Amazo123/CryNet-TwoNode/SYSTEM_UPDATE.md

# CryNet — SYSTEM_UPDATE.md (living status log)

> **This file is the recovery layer.** It is rewritten/appended by the agent **after every project update or edit** (code, notebook, config, decision, or a completed run). If the chat dies, is compacted into garbage, or hits "400 Context Limit Exceeded", a fresh chat reads this file first and is immediately back up to speed.
>
> **Repo:** `C:\Users\HP\.t3\projects\fp-two-node` (branch `main`, remote `origin` →
> `https://github.com/Amazo123/CryNet-TwoNode.git`) — the **two-cot** system.
> **Sibling repository:** `C:\Users\HP\.t3\projects\fp-2` (branch `main`, remote
> `crynet` → `https://github.com/Amazo123/CryNet.git`) — the **three-cot** system.
> Shared history up to `99bb257`, then separate. **The system on the bench is
> this one.**
> **Deep briefing (static, rarely changes):** `PROJECT_HANDOFF.md`
> **Decision and issue log (for the report):** `DECISIONS.md`
> **Last updated:** 2026-11-07 (**the D-83 firmware was flashed onto all four units and verified live** — the hub, both cot nodes and the wearable now run the firmware with no battery sense and no status LEDs; the hub's boot self-check passed, the panel is up, both cots are online and the wearable is connected over BLE. **Both nodes read exact digital zero, and that is correct: the owner confirmed only the boards were connected, with no INMP441 attached at all.** D-83, D-79/O-1c.) **The battery SOC and every status LED were removed from the system — D-83.** The owner took the battery readout out altogether, along with the node's connection LED, the node's SOC LED, the hub's BLE-status LED and the hub's SOC LED, because the hub's display already shows the connection. The firmware, the wiring documents, the bill of materials and the diagrams were all changed to match; the battery *power* — cells, modules, switches, charge currents — is untouched. **Nothing has been flashed yet**: the firmware is built and compile-verified, and the units are waiting on USB. D-81 is marked superseded in part, O-1e is closed, O-1a drops the wearable SOC readout)

---

## 0. Protocol the agent follows (non-negotiable)

1. **Update this file after every edit.** Every change to the repo, every decision, every completed run gets an entry in §5 *Change log* (newest first) and, if it moves the needle, a refresh of §3 *Live status*.
2. **Keep chat context small.** Never paste large files/diffs/logs into chat. Write them to disk (e.g. `research/*.log`) and reference the path. Prefer background runs with a persistent log over long foreground commands. If context is getting long, say so and ask the user to run `/compact` — the agent then reloads state from this file.
3. **One artifact per checkpoint.** Confirm before starting the next stage.
4. **Minimal agent fan-out.** Use direct tool calls (WebSearch/WebFetch/curl/python) over subagents. At most 1–2 subagents when genuinely needed. A previous 18-agent fan-out exhausted the usage quota and several sessions died with 400 errors.
5. **Never hand-edit `notebooks/crynet_training.ipynb`.** Edit `research/build_notebook.py`, then regenerate with `python build_notebook.py`.
6. **Long runs go to the background** with output to `research/<name>.log`, so a session break never loses the work.

### Recovery procedure (for a fresh chat or lost context)

1. Read this file (top to bottom).
2. Read `PROJECT_HANDOFF.md` for the frozen contracts (signal contract, dataset decisions, file map).
3. `git status` + `git log --oneline -5` to see what is committed vs. uncommitted.
4. Continue from **§4 Next action**.

### 0.1 Live background work (as of 2026-10-31, afternoon)

| What | Where | How to check |
|---|---|---|
| **A local stub run of the patched training notebook** (FAST mode, the stub cache) — it validates the new music corpus end to end. | `research/stub_music_run.log` | `tail -30 research/stub_music_run.log` |
| **The GTZAN music corpus downloading** from Kaggle (`carlthome/gtzan-genre-collection`, ~1.2 GB). | `research/_cache/gtzan__carlthome_gtzan-genre-collection.zip` | `ls -la research/_cache/gtzan__*` |
| **A hub firmware build** with the display fix (the loudest crying cot). | `research/toolchain/pio_build_music.log` | `tail -5 research/toolchain/pio_build_music.log` |
| The ESP32-S3 firmware **compiles, flashes and passes its on-device verification** — see §3. | — | `tail -60 research/toolchain/pio_build.log` for the last build |
| Rebuild from scratch | `cd firmware/hub_infer && python -m platformio run` | ~8 min from clean; ~1 min incrementally |
| Flash + read the log | `python firmware/tools/flash_hub.py` | finds the board, writes it, prints the report |
| Re-fetch the vendored deps | `bash firmware/tools/fetch_deps.sh` | clones the pinned commits and re-applies `patch_deps.py` |
| Install the node sketches into the Arduino IDE | `python firmware/tools/install_sketches.py` | copies `firmware/node/*` into `~/Documents/Arduino` |
| Build a node sketch without the IDE | `arduino-cli compile --fqbn esp32:esp32:weact_studio_esp32c3 firmware/node/node_crynet` | `arduino-cli.exe` ships inside the Arduino IDE |
| Build and flash a node in one step | `python firmware/tools/flash_node.py --port COM38` | finds `arduino-cli` inside the Arduino IDE, builds the node sketch and uploads it; falls back to the sketchbook copy when the machine has no checkout |
| Ports | the hub on **COM32** (CH343), the node on **COM30** (`303a:1001`, the C3's own USB) | `python firmware/tools/collect_clips.py --list` |

**A background build survives `/compact` and even a lost session** — it writes to the log file on disk, not to the chat. Compaction only rewrites conversation history.

**What is NOT yet done — do not claim otherwise:**
- Stage 2a is complete *for the inference core*: the front end and the model are verified against the host reference on real hardware.
- Stage 2b is **done and verified on the board**: the rewired INMP441 produces real audio (room RMS 6–11 milli, 9,237 distinct values), the node streams telemetry and uploads bursts, and both sketches discard the INMP441's power-on burst.
- **Stage 2c's radio is DONE and verified end to end on the real boards** (2026-10-30, late): the hub pulls a 2 s window over ESP-NOW and the CRC-32 it computes over the reassembled audio **matches the CRC-32 the node froze** (`286/286 fragments in 1.15 s`, `0x23C2EE17 -> MATCH`, then inference on the reassembled window). Getting there required four real fixes — a closed serial port starved the node's loop (USB-CDC blocks ~2 s per print; cure `Serial.setTxTimeoutMs(0)`), a memset in `handle_telemetry` wiped every slot's pre-allocated window buffer (no burst ever reassembled), the hub's probe flood (50 ms) kept resetting the node's window, and `esp_now_add_peer` ran from the node's WiFi-task callback. Unicast was tried and rolled back — broadcast at 10 Hz is reliable. **The TFT display and the BLE GATT server are now written and running on the hub together (2026-10-31): the panel comes up (320×240), the radio hears the node, and a BLE client connects and subscribes while the radio keeps counting frames with 0 bad frames — the conflict that stopped both was the hub's own 154 KB of boot-only static buffers, now in PSRAM (RAM 59.9 % → 12.9 %).** *Caveat added later the same day: "the panel comes up" only ever meant the driver returned success — the panel was in fact showing noise, because of three bugs in the display driver (little-endian address window, `CASET` sent twice, CS released between a command and its parameters). All three are fixed and reflashed; what the panel actually shows still needs one photograph.*
- The inference is 101.8 ms per window. That is 5 % of the 2 s window and fine for a triggered monitor, but the tensor arena is still in PSRAM; moving it into internal SRAM is the obvious next optimisation.
- **The chain works end to end (2026-10-31, late).** The hub pulls the node's two-second window over ESP-NOW (286/286 fragments, CRC-32 MATCH), runs the front end and the INT8 model on it, and announces the cry — the panel, the radio and the BLE server all run together on the hub, and a real phone received `ALERT {'cot': 1, 'alert': 'cry', 'confidence_pct': 100}`. The last blocker was the hub's own Bluetooth advertising deafening the Wi-Fi receiver; the fix is a per-fragment resend (`RESEND` frame, type 5) plus three supporting changes. See `DECISIONS.md` section 2.5.
- **In-domain audio exists** — four sessions were recorded with the real INMP441 (`research/in_domain/session1..4`): a quiet-room baseline, a phone-speaker cry session, a smoke test and a rescued partial. **And now the full confusion session (2026-11-01, D-60): nine more takes (`session5..10`, with `6b`, `7b` and `8b` for the close-and-loud versions) measured in this room — 0 false alarms in 308 non-cry windows, 86.4 % recall on a cry at 15 cm; the report is `research/in_domain/SESSION_REPORT.md`.** The deployed INT8 model scores **0 false alarms in 236 quiet-room windows** on the baseline, and AUC 0.9283 / recall 0.724 / FPR 0.000 on the phone-cry session.
- **The false-alarm map exists (2026-10-31, new).** `research/eval_esc50.py` ran the *deployed* INT8 model over ESC-50's 2,000 real-world clips: **36 of the 40 real `crying_baby` clips alarm (90 %)**, and **38 of the 1,439 loud non-cry clips do too (2.64 %)**. Worst groups: urban 4.3 % (`car_horn` 6 of 38 reached, `hand_saw` 4 of 37, `church_bells`), animal 3.7 % (`crow` 4 of 32, `sheep`, `frog`), domestic and human non-speech 1.6 %, nature 0.8 %. Report: `research/out/eval_esc50.json`.
- **There is no music anywhere in the training corpus.** ICD, ESC-50, the 4-class cry set and the snoring set hold no music at all — and ESC-50, the corpus the map above uses, contains **no music and no speech** either (it is environmental sound plus human non-speech vocalisations). So "the model tells a cry from music" was **untrained and unmeasured**. Speech *is* in the training set (VoxCeleb, 4,963 clips); music is not.
- **Music was measured, and the model as deployed then failed it — the retrain fixed it (2026-11-01, D-58).** `research/eval_music.py` had run the deployed INT8 model over GTZAN's 1,000 real music clips (ten genres): **79 of the 965 clips that reach the model alarm — 8.19 %**, three times the rate for any other kind of sound. Worst: jazz 14.3 %, blues 13.0 %, pop 12.0 %, disco 10.0 %, rock 10.0 %; best: reggae 2.0 %, classical 2.9 %, country 3.0 %, metal 4.0 %. The cause is plain once seen — a cry is a voiced, harmonic-rich sound and a saxophone or a sung vowel looks like one in the log-Mel domain. **A threshold change cannot fix it:** the INT8 output saturates at P(cry) = 0.9961, so 45 of those 81 music alarms and 34 of the 36 true cry detections carry exactly the same value. The fix is a training round, and the corpus is now in the notebook.

**Next concrete steps:**
1. **DONE (2026-11-01, evening): the Kaggle re-run happened and the retrained model is deployed and verified on the board.** The user ran the notebook, `crynet_out.zip` came back, and the retrained model was measured, deployed, and verified 4/4 on-device (D-58). **Music false alarms are now 0.21 % (2/965), down from 8.19 %**; ESC-50 non-cry alarms halved (2.64 % → 1.18 %); ESC-50 crying-baby recall is unchanged (36/40); the quiet room is still silent (0/236). The known cost: per-window recall on the phone-speaker cry sessions dropped (session 1: 0.867 → 0.800; session 4: 0.724 → 0.592) — a sustained cry still trips many windows in a row, so episodes are still caught. What is *not* yet re-measured is O-9, the in-room confusion session.
2. **Look at the TFT panel - it is wired, flashed, and the text now renders as letters.** The panel is on CS 10, MOSI 11, SCK 12, DC 13, RST 14, backlight 4, 3V3, GND; SPI2 at 40 MHz. The first flash came up as **static noise** (three bugs in my driver: little-endian address window, `CASET` sent twice, CS released between a command and its parameters), the second came up **a quarter turn out** (this panel is landscape-first and wants `MADCTL_MY`, not `MADCTL_MV` - the legacy firmware's setting), the third had the **new UI** but drew **hearts and diamonds instead of letters** (the font generator was reading the table 32 characters out of place), the fourth added the **caregiver's device on the panel** (`PHONE` pill, and `ALERT NOT DELIVERED` under a confirmed cry when nobody is attached), and the **fifth - the first photograph of the real glass - confirmed the layout, the text and the orientation are all correct**: `CRYNET`, `S3 HUB`, `RADIO`, `PHONE`, `LISTENING`, `COT 1 / ONLINE`, `COT 2` and `COT 3 / NO SIGNAL`, `3 cots linked`, `up 0:39`. **The same photograph exposed a colour fault: every colour had red and blue exchanged** (the teal accent came out olive, the amber `PHONE` pill came out blue) because the driver set the panel's `MADCTL_BGR` bit while the framebuffer packs standard RGB565. That is fixed, flashed and logged (`madctl 0x80`). **The second photograph confirmed the fix**: the `PHONE` square is now warm orange, the accent underline is teal-green, the `RADIO` square is cyan-green - the same elements the previous photograph showed as blue, pink and olive. **What it also showed is a glare**: the panel is brighter than the room, so the camera clipped it and the white balance drifted, and the whole screen read as saturated blue. The panel's side of that is now fixed - **the backlight is a LEDC PWM output at 55 % by default** (`hub_display_set_brightness()`), and the **BOOT button opens a colour check**: a grid of the palette's swatches, which is how the panel's own colours can be judged without a camera in the loop. **The colour check then proved the hues are right and found the real fault**: `BLACK` came back black, `WHITE` white, `TEAL` teal, `GREEN` green, `AMBER` amber, `ROSE` rose - but the old navy background came back as a **saturated blue**, because this panel **lifts the dark end, and the blue channel hardest** (the amber's requested blue of 36 measured back at 145). **The neutrals then moved one step darker again - on the user's own pick**: shown the ramp, they chose its **third step, `(4,8,8)`, as the teal the screen should be**, and the whole neutral family moved down one step of the same ramp with it (background `(4,8,8)`, surfaces `(7,15,16)` and `(12,26,28)`; border and dim text kept, every contrast re-checked). **The same round fixed the rounded corners**: every corner had been drawing its arc on the *inside* of the shape - only the bottom-right one looked right - because the corner loop walked its offsets inward from each disc's centre; each disc is now walked *towards its own corner*, and a host-side regression check (`research/check_corners.py`) requires the four corners to be exact mirror images of each other. **The repo is now pushed to GitHub after every change** (remote `crynet`; eight commits had piled up locally before the first push). **The panel then had its second look from the chair (D-59):** the background dropped another step of the same ramp — `(4,8,8)` → `(2,4,4)` — because the cards still read as the same colour as the ground on the glass; the header strip got its own colour `(7,20,15)`, green pushed five steps above blue, because the backlight's LEDs run along the top of the glass and lift that strip blue (a header painted the same colour as the cards photographed blue while the cards photographed teal); and the online/offline treatments were swapped as the user asked — a live cot now carries the **full-strength vibrant teal outline** (rose when crying) while a no-signal card recedes, its outline and empty bar washed towards the background, the reverse of the 45 % blend the live cards had before. **One more pass from the chair (D-59, amended):** the *fills* are swapped - a live card wears the border-washed fill the offline card had (the denser, more active one) and an offline card the faint accent wash, outlines unchanged - and the dead card's word became **OFFLINE**. **What is still wanted is one photograph of the colour check with the room lit**, so the ramp yields the panel's own tone curve: in the dark the camera's veil is stronger than the steps it is supposed to measure (the fourth photograph proved that too - its red channel jumps the wrong way between adjacent ramp steps).
3. **DONE (2026-11-01, later at night): the burst is 2.06 s and the panel shows a cry about two and a half seconds after it happened.** The cause was the hub's own BLE advertising deafening the Wi-Fi receiver (NimBLE's default interval is 30-60 ms on all three channels, ~100 transmissions a second). Three changes: the Bluetooth stack advertises only when it must (never with a phone connected, never while a burst is in the air), at 100 ms instead of 30-60 ms when it must; and the node paces its fragments every 4 ms instead of every 10 ms. **Measured: 5.54-6.93 s before, 2.06-2.11 s after, 286/286 fragments every time, with no resend rounds.** The request-to-verdict latency is 2.23-3.57 s (D-61).
4. **DONE (2026-11-01, night): the confusion session is recorded — O-9 is closed.** Nine one-minute takes with `node_capture` on the real INMP441 (the procedure is in `research/CONFUSION_SESSION.md`; the result is in `research/in_domain/SESSION_REPORT.md`). **0 false alarms in 308 windows of non-cry audio** (speech, music and film — including a loud film and loud music where the trigger fired on 46 % and 84 % of the records, so the model was asked 44 times in each and refused every time), and **86.4 % per-window recall on the phone-played cry at 15 cm** (the realistic case: the mic is in the cot). The one finding that changes the design: **the cry at one metre never crosses the 0.030 trigger** (median RMS 0.0070, 0/590 records), so the system's reach is limited by `CRYNET_TRIGGER_RMS` and the microphone's fixed sensitivity, not by the classifier. The clips are now the hard negatives for the next training round.
5. **DONE (2026-11-01, last thing tonight): the demo's sound path is verified on the live hub.** The user played the cry from a phone 10-15 cm from the node's mic while the hub's log was read live: **42 verdicts, 26 "ALERT — cry" at P(cry) 0.9922-0.9961, 16 "no cry" at P(cry) 0.0078-0.2148**, nothing near the 0.95 threshold, and the link never dropped a fragment (45 bursts, 45/45 complete, no stall, timeout, CRC error or resend round). Request-to-verdict 2.23-5.35 s (mean 4.03 s). The burst's length is now a range (2.06-5.19 s, median 3.55 s) because the per-fragment cost is the *channel's* contention on the shared channel 6, not the pacing. **The demo must use the phone** — the laptop's speakers are not detected (D-61). Details: D-62.
6. **DONE (2026-11-01, late): the adaptive trigger is built on both boards and it works — and it exposed a fault in the model's judgement of near-silent windows, which the announcement rule now fixes.** The multiple was chosen from the recorded sessions, not by taste (`research/adaptive_trigger_study.py`): at **three times the node's own noise floor** the cry a metre away goes from 0 trigger events a minute to 39, the quiet room gives 5, and the loud sessions are capped by the old fixed 0.030 — so the rule is never worse than before. **The node owns the floor and the level** (it freezes the window, so its level is the one that matters); the level travels in the telemetry (payload 7, milli-RMS) beside the frozen window's own level and the floor, and the hub triggers on the number the node reports, falling back to `CRYNET_TRIGGER_RMS` for an older node. The floor falls at once when the room gets quieter and rises with a 50 s time constant, so a long cry cannot drag the floor up to its own level and switch the trigger off in the middle of an episode. **Measured on the boards:** the level tracks the room (0.006–0.016 in a noisy room), the node's own log shows it settling (`rms 0.0063 floor 0.0028 level 0.0083`), and the hub now asks 5–11 times a minute instead of 1–2. **But a lower trigger asks the model about near-silent windows, and the model is not a reliable judge of those:** the same quiet room produced verdicts of 0.0000 and of 0.9766 for windows that differ by nothing a person could hear, and the second of those was a false alarm. **So the announcement rule changed (D-64):** one window announces a cry only when it is unmistakable — P(cry) ≥ 0.99, where the model's output saturates at 0.9961 for a clear cry, so the panel still shows the cry two and a half seconds after it happened — and anything between 0.95 and 0.99 is a *maybe* that has to be confirmed by the next window. A cry lasts for seconds and its windows agree; a noise fluctuation that happens to look like a cry is not repeated. **And the node's transmitter was turned down to 8.5 dBm (D-65):** the radio sits centimetres from the microphone and was putting its own noise into the audio it was about to be judged on. Five minutes of a noisy room afterwards: 32 verdicts, **0 false alerts**.
7. **NEXT: the user's verification session, all of it in one go.** The cry from the phone at **15 cm** (the demo case — it must announce at once, at the old two-and-a-half-second speed) and at **one metre** (the case the adaptive trigger was built for — it must now reach the model at all), with the **node's own serial log captured alongside the hub's** so the floor, the level and every frozen window's own level are on the record. The tool that made this possible is new: `firmware/tools/dump_node_window.py` writes the node's frozen window out over its USB console, and `research/analyze_window.py` says what is in a window and what the model makes of it.
8. **Two nodes in one room.** The per-node path already exists — per-node inference, a per-node BLE alert and a `crying_mask` in the state characteristic — and the panel now names the **loudest** crying cot, but it has never been run with two nodes, and the demo has to show *which* cot the cry came from.
9. Then Stage 2d (the wearable).

**Tools built so far (all runnable on the host):**
- `firmware/tools/check_artifact_drift.py` — verifies `research/out/` against `deploy_config.json` and the staged firmware copies. Currently **PASS**.
- `firmware/tools/gen_probe_refs.py` — regenerates `crynet_probe_refs.h` (expected on-device features) from the notebook's own front end.

---

## 1. Project in one paragraph

Multi-node infant cry monitor. 3× ESP32-C3 cot nodes (INMP441, I2S 16 kHz) → ESP-NOW → **ESP32-S3-DevKitC-1 hub** (TFLite Micro INT8 inference, ILI9341 TFT, BLE GATT) → wearable (ESP32-C3 + OLED + DRV2605L haptic). Model is a **binary cry / no-cry** classifier on 2 s log-Mel windows. Previous firmware attempt failed after flashing, so the project was rebuilt from model training.

---

## 2. Frozen decisions (do not re-litigate)

| # | Decision |
|---|---|
| 1 | Binary cry / no-cry head (BLE packet `alert_type 0x01` only supports binary). |
| 2 | Label policy = "any cry present" in the 2 s window (≈ ≥ 3 active frames). |
| 3 | Training runs on Kaggle GPU (user executes); notebook validated locally first by the agent. |
| 4 | Signal contract (below) is frozen — firmware, C code and weights all depend on it. |
| 5 | Trigger threshold must drop from RMS ≥ 0.18 → ~0.03 in the hub (old value was a real bug: soft cries never reached a classifier). |

**Signal contract (frozen):**
`int16 pcm[32000] (2.0 s @ 16 kHz mono)` → `/32768` → subtract mean → zero-pad 256 front / 512 rear → 81 frames, 512-pt symmetric Hann, hop 400 → `|rfft|²` (257 bins) → 64 Mel bands (librosa slaney, 20 Hz–8 kHz, 497 non-zero weights) → `10*log10(max(P,1e-10))` floored at −80 dB → per-window standardisation (CMVN) → int8 quantise → TFLM → `[P(no_cry), P(cry)]`.

| Constant | Value | Constant | Value |
|---|---|---|---|
| 2026-11-01 (night, final) | **The shipped firmware verified on a one-minute play: 7 live ALERTs, every one P(cry)=0.9961, first ~8 s after the first cry-level freeze; 26/26 bursts complete; zero false detections before, during, or after.** Windows straddling the recording's pauses scored 0.80-0.94 and were refused cleanly; two impulsive non-cry ticks (crest 10-18) were refused by the model itself (P=0.03-0.09). The momentum fix (D-74) passed its first live test - the post-play quiet windows never announced. This closes the demo verification: play at panel level ~0.10-0.20, alerts at saturation, silent otherwise. | (no code changes - verification only) | *Logs: %TEMP%/hub_v13.log, node_v13.log.* |
| 2026-11-01 (night, latest) | **The volume-down play verified the whole chain: five for five cry windows announced at 0.9922-0.9961 with no clipping (peaks 57-69 % of full scale), and the quiet watch held zero live ALERTs while refusing 31+ flukes - including two full saturations (0.9961 at crest 2.7 and 2.8) that the crest gate stopped. One residual defect found and fixed (D-74):** 12 s after the cry ended, a quiet hiss window (rms 0.0096, crest 2.5, P=0.9883) announced on the confirming run's momentum - the cry's own loud windows had advanced the run to 2, and quiet windows that score >= 0.95 keep it alive without resetting it. The run now confirms only windows with real energy (rms >= 0.020): quiet windows keep the run alive but cannot announce. Flashed; final quiet check running. | `firmware/hub_infer/src/link_stage.c` | *Session verdicts: quiet watch ~7 min, 0 live ALERTs; the play: first cry window (seq 183, loud onset) scored 0.9688 (a maybe - unconfirmed), every subsequent cry window 0.9922-0.9961 (ALERT), post-play flukes all refused.* |
| 2026-11-01 (night, later) | **Four more quiet-room false alarms in nine minutes; the model saturates on pure mic self-noise; the crest gate closes it (D-73).** The quiet-watch session after D-72 caught the flukes live: rms 0.0067-0.0088, peaks 621-789 (crest 2.3-2.9 - flat Gaussian hiss), scoring P(cry)=0.9922-0.9961 - the same value as a real cry - roughly every two minutes. No confidence threshold can fix this (saturation is saturation); the discriminator is the **crest factor**: every falsely-high quiet window ever measured has crest 2.2-2.9, the quietest genuine cry (one metre, P=0.9961) has 5.6. `CRYNET_QUIET_CREST 3.5`: a quiet saturated window announces only with a cry's impulsive shape; loud windows (>= 0.020 rms) announce on saturation alone (clipping flattens the crest on loud cries, 1.9-3.9, so the shape test must not apply there). Flash verified: boot self-check PASS. **Verification in progress** - six quiet minutes expected to produce zero ALERTs (the room flukes ~every 2 min, now refused), then the volume-down play (panel 0.10-0.20). | `firmware/hub_infer/src/{link_stage.c,link_stage.h}` | *The build also prints crest on every window line, so future sessions measure it directly.* |
| 2026-11-01 (night) | **Fourteen quiet-room false alarms, found and closed (D-72).** The user saw ~14 "cry detected" flashes at 95-98 % with no cry playing (panel levels 0.002-0.012). Mechanism: in a quiet room the adaptive trigger pins at its minimum (0.005), the hub judges near-silent windows continuously, the model's verdict on those is documented noise, and two consecutive scattered maybes (0.95-0.98) confirmed each other under the run-of-two rule - the rule's "a noise fluctuation is not repeated" assumption fails when the room repeats the fluctuation every few seconds. **Fix (hub only):** `CRYNET_ANNOUNCE_MIN_RMS 0.006` (no window under 0.006 rms announces at all, even at >= 0.99; the one-metre cry at 0.0103 stays above it) and `CRYNET_MAYBE_MIN_RMS 0.020` (a maybe counts toward the confirming run only with real energy behind it). **Verified live:** within 90 s of flashing, the room produced `rms 0.003917  P(cry)=0.9531` - the exact failure shape - and it logged `cry (too quiet to announce)` instead of alerting. Real-cry paths unchanged: saturated verdicts announce alone at >= 0.006 rms; the demo-volume re-test (phone quieter, panel ~0.10-0.20) is still pending. | `firmware/hub_infer/src/{link_stage.c,link_stage.h}` | *Hub re-flashed (COM32), boot self-check pass; the 90 s capture also confirmed the flood is real - the hub judged ~8 windows, all refused or refused-by-model.* |
| 2026-11-01 (later at night) | **The burst is 2.06 s instead of 5.5-6.9 s, and the panel shows a cry about two and a half seconds after it happened instead of eight.** The cause was the hub's own Bluetooth advertising: one radio carries both Bluetooth and Wi-Fi, so every advertisement is a moment when the Wi-Fi receiver cannot hear the burst's fragments - and NimBLE's default advertising interval is 30-60 ms on all three channels, about a hundred transmissions a second. **Three changes:** the Bluetooth stack now advertises only when it must (never while a caregiver's phone is connected, never while a burst is in the air - the link stage tells it, and the log shows it stopping 1 ms after the request and returning 181 ms after the burst lands); when it does advertise, it advertises at 100 ms instead of 30-60 ms; and the node paces its fragments every 4 ms instead of every 10 ms, because that ten-millisecond gap was only ever needed to survive the deafening that is now gone. **Measured on the boards** (`firmware/tools/measure_burst.py`): before 5.54 s and 6.93 s with resend rounds; after the Bluetooth policy 3.76 s and 3.81 s with no missing fragments and no resends at all; after the node's pacing **2.06 s, 2.06 s, 2.11 s**, 286/286 every time. The request-to-verdict latency is now 2.23-3.57 s (mean 2.68 s), of which 0.16 s is the model's own inference. **A finding to settle with the user:** played from the *laptop's* speakers the cry is *not* detected - P(cry) 0.38-0.95, just under the threshold, and turning the volume to 100 % made it worse while the node's RMS stayed at 0.045 - so it is the speakers' frequency response, not the level; the demo's source is the phone, and the phone path on the live hub is being checked. | `firmware/hub_infer/components/ble_alert/ble_alert.c`, `firmware/hub_infer/components/ble_alert/include/ble_alert.h`, `firmware/hub_infer/src/link_stage.c`, `firmware/node/node_crynet/node_crynet.ino`, `firmware/tools/measure_burst.py` (new), `firmware/tools/measure_latency.py` (new), `DECISIONS.md` (D-61) | The boot self-check still reads PASS (4 probes, 5184/5184 exact), a BLE client still finds the hub, connects and subscribes to both characteristics, and the burst is now bounded by the node's radio rather than by the hub's Bluetooth. || 2026-11-01 (night) | **The in-room confusion session is recorded — O-9 closed. The honest in-room number: **0 false alarms in 308 windows of non-cry audio**, and **86.4 % per-window recall on the phone-played cry at 15 cm**; the limit on how far the hub can hear is the trigger, not the model.** Nine one-minute takes with `node_capture` on the real INMP441 (quiet room; speech at desk distance and at 30 cm; music and a film at 1 m and at 30 cm; the phone-played cry at 15 cm and at 1 m). **The model raised no alarm on any non-cry window** — 308 windows of speech, music and film, 0 false alarms — and the two loud takes are the ones that count: the trigger fired on 269/590 records of the loud film and 493/590 of the loud music, so the model was asked 44 times in each and refused every time. That is the retrain (D-58) working in the room it was meant to work in: on GTZAN the music false-alarm rate was 8.19 %, and on the loudest music this room can produce it is 0/44. **The cry at 15 cm — the realistic case, the mic is in the cot — is caught in 38 of 44 windows.** **The cry at 1 m (phone at maximum volume) reaches a median RMS of 0.0070 and 0 of 590 records cross the 0.030 trigger, so it never reaches the model at all** (asked anyway, the model would have caught 18/44): the system's reach is set by software, not by the microphone: **the INMP441 has no gain setting** - its L/R pin is a left/right *channel select*, not a gain strap, and the part is fixed at -26 dBFS +/-3 dB sensitivity - so the levers are the hub's trigger threshold and a digital gain in the telemetry path, and the better version of the trigger is an *adaptive* one (a multiple of the node's own running noise floor, 0.0020 here, so 3x = 0.006 would pass the one-metre phone). Lowering the trigger to ~0.012 is the same lever from the other end and the evidence supports trying it in the next training round — it is **not** changed on 308 windows from one afternoon. The labelling tool grew a `--truth` flag, because the old auto-label called a clip 'cry' if it was *loud*, which for the music and film takes would have labelled the loudest non-cry clips as cries and measured nothing. The node was flashed back to `node_crynet` afterwards, so the live chain is running again. | `research/in_domain/session{5,6,6b,7,7b,8,8b,9,10}/` (audio, gitignored), `research/in_domain/SESSION_REPORT.md` (new), `research/out/eval_session*.json`, `firmware/tools/label_session.py` (`--truth`), `DECISIONS.md` (D-60, O-9 closed) | **The one measurement that uses this room's microphone, this room's gain and this room's acoustics.** The honest caveat is in the report: the cry is a phone speaker 15 cm from a mic in a cot, and a real baby in a real cot is a different sound. || SR | 16000 | N_FFT | 512 |
| WIN_SEC | 2.0 | HOP | 400 |
| N_SAMPLES | 32000 | N_MELS | 64 |
| N_FRAMES | 81 | FMIN/FMAX | 20 / 8000 |
| CENTER_PAD | 256 | TAIL_PAD | 512 |
| DB_FLOOR | −80 dB | LOG_EPS | 1e-10 |
| CMVN | True | SILENCE_RMS_GATE | 0.0015 |
| TARGET_RECALL | 0.95 | SEED | 1337 |

Mel weights are **exported from Python into C** (`crynet_tables.h`), so firmware cannot drift from the model.

---

## 3. Live status (as of 2026-10-29)

**Checkpoint 1 = DONE, including the full Kaggle run. Checkpoint 2 (ESP32-S3 firmware) = Stage 2a in progress.**

### Done
- Dataset forensics: every candidate corpus downloaded and profiled at audio level (SR, duration, RMS, autocorr F0, spectral centroid/flatness).
  - **Used:** ICD `hoyyu1/infant-cry-detection` (PRIMARY, 28,478 clips, all 16 kHz mono 5.00 s, 5 shipped folds), Baby Cry 4-class (cry diversity + cross-corpus test), ESC-50 (negatives + 40 held-out `crying_baby`), Snoring (hard negatives).
  - **Rejected:** `mennaahmed23/baby-cry*` family (CONTAMINATED — fake "silence" at RMS 0.22, renamed ESC-50, synthetic derivatives), `rahult25/five-class...` (pitch-shifted derivatives), ICSD (gated HF), `AxonData` (paid), Baby Chillanto (request-only), AudioSet/FSD50K (redundant), raw DonateACry (8 kHz, skewed; already merged in cry4).
- 24-cell Kaggle notebook written, generated from `research/build_notebook.py`.
- **Validated end-to-end** on synthetic stand-ins (24/24 cells) and cells 1–15 on the real 28,478-clip corpus.
- **C front end == Python front end:** max deviation **7.06 × 10⁻⁵**, mean 2.8 × 10⁻⁶, over 4 probes (sine+harmonic, noise, DC-offset cry with INMP441 bias, silence).
- **Every op has a TFLM kernel** — asserted at export: `CONV_2D, FULLY_CONNECTED, MAX_POOL_2D, MEAN, SOFTMAX`.
- **INT8 vs float32:** AUC delta **−0.00007**, 99.70 % decision agreement.
- Notebook validated with `nbformat.validate()`.

### Current numbers — **the full Kaggle run** (authoritative)

The user ran `notebooks/crynet_training.ipynb` on Kaggle (GPU T4) and the artifacts are in `research/out/`. These numbers supersede the earlier subsample figures.

| Split | AUC | F1 | Recall | Precision |
|---|---|---|---|---|
| ICD val (fold 4) | **0.9994** | 0.9905 | 0.9844 | 0.9966 |
| ICD test (fold 5) | **0.9995** | 0.9905 | — | — |
| cross-corpus (cry4 + ESC-50 + snoring, never trained on) | **0.9973** | 0.9801 | — | — |

| Variant | Params | val AUC | cross AUC |
|---|---|---|---|
| **`conv_cnn` (selected)** | 122,770 | **0.9994** | 0.9973 |
| `sep_cnn` | 29,839 | 0.9974 | 0.9928 |
| `temporal_cnn` | 65,154 | 0.9805 | 0.9714 |

- Deployed model: `crynet_int8.tflite`, **137,384 bytes**, SHA-256 `4aef55d8cfc0fb75aa944e73945ef5b832f12d71479c48f82aff58563126bc11`.
- **Calibrated alarm threshold = 0.95** (re-derived by this run; the earlier subsample's 0.23 no longer applies).
- Input quantisation: scale **0.060125612**, zero_point **−4**. Output: `[1,2]` int8, scale 0.00390625, zp −128, classes `["no_cry","cry"]`.
- Tensor arena hint **120 KB** (the firmware reserves 256 KB and places it in PSRAM).
- C front end vs Python on the real run: max deviation **6.905 × 10⁻⁵**, mean 2.79 × 10⁻⁶.
- TFLM kernel check: **ok** — ops `CONV_2D, FULLY_CONNECTED, MAX_POOL_2D, MEAN, SOFTMAX`.
- **INT8 vs float32 — CLOSED.** The full run reported both AUCs as `NaN` because the parity cell took a *prefix* of the validation fold; the ICD manifest lists every positive clip before every negative one, and the fold's positive clips alone contribute 5,330 windows — more than the 4,000-window cap — so that slice was 100 % cry and its AUC was undefined. The model was never affected (every headline metric is computed over whole splits), but the quantisation delta for these weights was never measured.
  Re-measured independently on the host by `research/verify_int8_parity.py`, which rebuilds fold 4 from the cached archives with the notebook's own front end and runs **both** the exported INT8 model and the float32 Keras model over 11,386 windows (5,693 clips, centre-cropped — independent of the notebook's random crops):

  | | INT8 (as deployed) | float32 reference |
  |---|---|---|
  | val AUC | **0.997926** | **0.999299** |
  | recall @ 0.95 | 0.9780 | 0.9782 |
  | FPR @ 0.95 | 0.0036 | 0.0036 |

  ΔAUC **−0.001373**; max |Δp| 0.182; mean |Δp| 0.0029; **decision agreement 99.956 %**. The independent float AUC (0.999299) corroborates the Kaggle figure (0.999419) from a different set of windows. Report: `research/out/verify_int8_parity.json`.
- **Notebook fixed:** the parity cell now draws a seeded random permutation subset and warns loudly if a slice is single-class. Notebook regenerated and `nbformat.validate()`-passed.

- **On-device verification — CLOSED (2026-10-30).** The Stage 2a firmware runs on the
  user's ESP32-S3-DevKitC-1 (COM32, CH343 USB-serial) and **all four probes pass**:
  the device's quantised features match the host reference exactly for silence, DC
  bias and the two-tone signal, and to within 1 LSB on 3 of 5,184 values for the
  noise probe. `RESULT: PASS — 4 probes, front end and model agree with the host`.

  | | value |
  |---|---|
  | PSRAM | 8,388,608 bytes, present |
  | flash | 16,777,216 bytes |
  | model | 137,384 bytes int8 |
  | front-end working set | 5,380 bytes, internal SRAM |
  | tensor arena | 262,144 reserved, **108,328 used** |
  | front end | **41.7 ms** per 2 s window (was 135 ms before optimisation) |
  | inference | **101.8 ms** per window (ESP-NN SIMD kernels linked in) |
  | CPU | 240 MHz, `-O2` |

  Four real bugs were found *only* by running it on the chip:
  1. **The DC-removal mean was accumulated in float32.** Summing 32,000 samples of
     18,000 in float32 gives 575,726,660 instead of 576,000,000, so the mean came
     out 8.5 counts low and 8.5 counts of DC survived. On the DC-offset probe that
     leaves a constant residual which the per-window standardisation blows up into
     a completely different feature vector — the probe failed with a max delta of
     131. The sum is now accumulated in `int32`, which holds it exactly.
  2. **The build was at `-Og`.** `build_flags = -DCOMPILER_OPTIMIZATION_PERF` is an
     *Arduino* macro that means nothing to PlatformIO's ESP-IDF builder, so
     ESP-IDF's debug default applied. The optimisation level is now set the
     ESP-IDF way, `CONFIG_COMPILER_OPTIMIZATION_PERF=y`.
  3. **The CPU ran at 160 MHz**, not 240. `CONFIG_ESP_DEFAULT_CPU_FREQ_MHZ_240=y`.
  4. **The front end kept a 128 KB padded copy of the signal in PSRAM.** PSRAM on
     the S3 is uncached external memory, and the FFT and the Mel filterbank stream
     through the working set 81 times per window. The padded copy is gone — each
     frame is now built straight from the caller's int16 PCM — and the working set
     is 5.4 KB in internal SRAM. Front end 135 ms → 41.7 ms.

  A fifth trap is not a firmware bug but a flashing one: **a combined image built
  with QIO flash mode makes the chip watchdog-reset in a loop** (`rst:0x7
  TG0WDT_SYS_RST` repeating, no application output). The ROM cannot read this
  board's flash in QIO before the bootloader has configured its own timing. The
  combined image must use **DIO**. In fact the whole build is DIO — the effective
  config is `CONFIG_ESPTOOLPY_FLASHMODE "dio"` and both `bootloader.bin` and
  `firmware.bin` carry flash-mode byte `0x02` — so the application runs in DIO as
  well, which costs nothing at this workload. See `firmware/README.md`.

- **Stage 2b — the node firmware is written and compiles (2026-10-30), but has
  not run on the board.** Two Arduino sketches for the ESP32-C3, built with the
  Arduino IDE's own `arduino-cli` against core 3.3.12, **zero warnings**:

  | Sketch | Flash | Static RAM | What it does |
  |---|---|---|---|
  | `firmware/node/node_crynet/` | 977,617 B (74 %) | 165,972 B (50 %) | the node: I2S capture, a 2 s rolling window, 100 ms RMS telemetry over ESP-NOW, the 64 KB burst in 286 CRC-framed fragments |
  | `firmware/node/node_capture/` | 311,120 B (23 %) | 18,592 B (5 %) | streams the microphone to the PC so in-domain audio can be recorded |

  The I2S setup is Espressif's own recipe for this microphone — **32-bit slots**
  (the INMP441 puts 24 bits into a 64-bit frame, so 16-bit slots would misalign
  the data), `I2S_SLOT_MODE_MONO` with `I2S_STD_SLOT_LEFT`, and the narrowing to
  int16 done in software by keeping the top 16 bits. The ESP32-C3 is I2S
  hardware v2, so the left-channel slot is selected in hardware, with no
  software decimation.

  The node repeats the hub's DC lesson: the mean is an exact **integer** sum,
  and the 100 ms RMS is computed with the mean of the **whole 2 s window**
  removed, so the number the node reports is the same quantity the hub's front
  end will compute for that window — otherwise the hub's 0.03 trigger threshold
  means nothing.

  Two host tools came with it: `firmware/tools/verify_burst.py` asks the node
  for its window over the serial console, checks every frame's CRC and writes
  the result as a WAV; `firmware/tools/collect_clips.py` records the session and
  cuts it into 5 s clips. `firmware/tools/install_sketches.py` copies the
  sketches into the Arduino sketchbook.

  **Not yet proven:** that the wiring is right, that the INMP441's actual level
  and DC offset land in a sensible range, and that the effective sample rate is
  within tolerance of 16 kHz. All three are measured by `verify_burst.py` the
  first time the node runs.

  The **wire format was validated numerically** before any hardware was
  involved: CRC-16/CCITT-FALSE reproduces the standard check vector `0x29B1`,
  and the C frame builder and the Python parser agree on every header offset
  and on both CRCs (the frame's CRC covers its header *and* its payload; a
  request's CRC covers its first 10 bytes).

- **Firmware build — CLOSED (2026-10-30).** `firmware/hub_infer` now **compiles and links** for `esp32s3`:
  - toolchain: PlatformIO 6.2.0, `platform-espressif32` 8.0.0, **ESP-IDF 6.1.0**, `toolchain-xtensa-esp-elf` 14.2.0 (GCC 14.2);
  - images: `firmware.bin` **468,800 B**, `bootloader.bin` 22,560 B, `partitions.bin` 3,072 B;
  - **RAM 52.1 %** (170,668 B of 327,680 B) and **flash 22.3 %** (468,373 B of the 2 MB factory partition);
  - effective config: `esp32s3`, 16 MB flash, **octal PSRAM at 80 MHz**, custom 16 MB partition table, and **`CONFIG_ESP_TFLITE_MICRO_USE_ESP_NN=y`** — the ESP-NN SIMD kernels are compiled in, which is the difference between roughly 40 ms and roughly 2.3 s per convnet invoke on an S3;
  - the whole TFLite Micro port and ESP-NN compile cleanly under GCC 14 with the port's own `-Werror`;
  - `firmware/tools/check_artifact_drift.py` still **PASSes** (model SHA-256, threshold, quantisation, staged copies);
  - `firmware/hub_infer/dependencies.lock` records the exact IDF version and is committed.
  **Still unverified: anything that only happens on the chip** — the FlatBuffer alignment, the arena fitting, the probe feature agreement and the latency.

### Artifacts on disk
`research/out/` — **the authoritative full-run artifacts**: `crynet_int8.tflite`, `crynet_float.tflite`, `crynet.keras`, `model_data.h`, `crynet_tables.h`, `dsp_crynet.c/.h`, `crynet_infer_example.c`, `deploy_config.json`, `metrics.json`, `c_parity.json`.
`research/_realfast_out/` — the earlier subsample run, kept for comparison.
Logs: `research/real_fast.log`, `research/stub_run.log`.

### Git state and remotes
Local branch `main`, tracking `crynet/main`. **The node produces real audio on the real hardware, and both sketches discard the INMP441's power-on burst** (see §3, Stage 2b). All source committed; a few line-ending-only diffs may remain from the editor.

| Remote | Points at | Purpose |
|---|---|---|
| `crynet` | `github.com/Amazo123/CryNet.git` | **The live project.** Every change is committed here and pushed. Created 2026-10-29, **public** since 2026-10-29. |
| `legacy` | `github.com/Amazo123/Multi-Node-Infant-Cry-Detection.git` | The **old** project (Arduino firmware, BOM, wiring guides, old `model_data.h`). Read-only reference — do not push to it. Its hub `.ino`, `firmware/common/protocol.h`, `firmware/central_hub_s3/pins.h` and `dsp_mel_extractor.cpp` are the starting point for checkpoint 2. |

**Backup rule:** after every meaningful change → update this file → `git add -A && git commit && git push crynet main`. Never commit `research/_cache/` (5.5 GB of corpora) or the `_*_work/` scratch dirs; they are gitignored and the notebook re-downloads the corpora itself.

**What is *not* in GitHub:** the raw datasets (5.5 GB — re-downloaded automatically by the notebook) and the `_work`/`_parity` build scratch. Everything that is source, model, exported artifact, doc or log **is** in the repo.

### Open risks
1. **Unverified on hardware.** A successful build says nothing about the chip: the FlatBuffer alignment, whether the 256 KB arena actually fits, whether the DSP reproduces the Python features, and the real latency are all still unknown. This is the top risk, and the reason Stage 2a exists.
2. `coughing` is the top confuser; if it survives mining, add the FSDKaggle2018 cough set.
3. **No in-domain data** — the model has never heard the user's INMP441, room or gain. ~50 self-recorded clips (cries + room noise + speech + TV) is the single biggest remaining accuracy win.
4. TFLM latency unmeasured. With ESP-NN enabled the expectation is tens of milliseconds per 2 s window on a 240 MHz LX7, not the 100–300 ms the un-optimised kernels would cost; it must be measured on the real board.
5. The tensor arena is a 256 KB reservation placed in PSRAM; `AllocateTensors()` has never run. The notebook's hint was 120 KB, so it should fit — but the *actual* high-water mark is unmeasured.
6. BLE/display policy unchanged from the old spec; it already assumes binary output.
7. Old firmware gotchas still apply: INMP441 DC offset (~+18000 counts), ESP-NOW TX queue overflow (needs callback flow control), Arduino-3.x callback signature change, ILI9341 240 px clipping (the `HubDisplay` subclass).
---

## 4. Next action (checkpoint 2 — ESP32-S3 firmware)

> **Live pointer (2026-11-04, evening):** the plan below is the original stage plan and is *behind* the work. The current state is the newest entries in §5 *Change log* — read those first. **Where the project stands now:** the whole bench is on one laptop — the three cot nodes on a USB hub, the hub and the wearable straight in — and `firmware/tools/capture_multi.py` watches all five boards at once. The branch `feature/stop-capped-freeze` is **merged into `main`** (main = `bfd65c4`, pushed to GitHub) — it carries the hybrid freeze rule (now flashed to **all three nodes**) and the flapping fix, and the merge was made after the bench verification: **three cries, three buzzes, the right cot each time, the name never changed hands** (`research/out/demo_run4/`). On top of that this evening the hub gained: **the saturation-only announcement rule** (a conversation in the room scores 0.9727 and the old loud path would have announced it), **the refusal of clipped windows** with a loud warning, **a burst stall noticed in 100 ms instead of 1.5 s** (median window fetch 2.48 s → 1.88 s), and **a console** (`help`, `status`, `alert <cot>`, `clear`) that proved the BLE path end to end — the wearable printed `ALERT cot 2 type 1 conf 100%` with no sound at all. **The open items, in order:** (1) **the model on loud speech** — the corpus has no loud-speech negatives, and **the user has no one around to record a conversation**, so the speech is to be **sourced online** (real conversation recordings), **measured against the deployed model first**, and a training round run only if that measurement shows the margin is thin; (2) **the live clip test** — the three-cot attribution test is **DONE** (2026-11-04, `research/out/demo_run4/`: the cry played at each cot in turn, each named correctly, one buzz per cry), but the demo-kit clip has still to be played once at every cot in the kit's shortlist to prove *those* clips announce from the distance the demo will use. **Closed since the last entry: cot 2's microphone.** It is not a hardware fault — the "clipping and DC offset" was the phone at ~10 cm from the mic (the INMP441 is fixed-gain and saturates before the node's 16-bit window does) and a small DC offset that is normal for the part and removed by the per-window CMVN. At the kit's 15–20 cm, node 2's window was clean (rms 0.1058, peak 16918, crest 4.9) and it announced at 0.9961 with the wrist naming cot 2.

### 4.0 Kaggle outputs — received and staged
The user placed the full-run `out/` at `research/out/`. `firmware/tools/check_artifact_drift.py` verifies the SHA-256, model size, quantisation, thresholds and the staged copies. **Current result: PASS** (137,384 bytes, SHA-256 `4aef55d8…126bc11`, threshold 0.95, input scale 0.060125612 / zp −4).

| File | Used by | Why it matters |
|---|---|---|
| `crynet_int8.tflite` | reference | the deployable model; `model_data.h` is the same bytes as a C array |
| `model_data.h` | hub | `crynet_model[]` + `crynet_model_len` — compiled into flash |
| `crynet_tables.h` | hub, node | Mel filterbank (start/end/offset + weights), Hann window, all constants, quant scales, **calibrated threshold**, silence gate |
| `deploy_config.json` | hub | input shape, quantisation params, operator list, TFLM kernel check, threshold, metrics, model SHA-256 |
| `metrics.json` | docs | per-variant AUC / F1 / recall |
| `c_parity.json` | docs | measured C-vs-Python front-end deviation |
| `crynet_float.tflite`, `crynet.keras`, `dsp_crynet.c/.h`, `crynet_infer_example.c` | reference | float reference, retrainable model, the portable C front end, TFLM glue template |

`research/_realfast_out/` stays as the *subsample* run for comparison; `research/out/` becomes the **authoritative** one.

### 4.1 The firmware is written from scratch — what that means concretely
The firmware is **not** a port of the abandoned Arduino code. ESP-IDF, new module layout, new transport, new application state machine. Explicitly:

**Re-derived (legacy code is not reused):**
1. **Application architecture.** The legacy hub was one 46 KB `.ino` with global state and a `loop()`/FreeRTOS mix. New: ESP-IDF with separate components (`crynet_dsp`, `crynet_model`, `crynet_infer`, `node_link`), a dedicated inference task, and an explicit event-driven state machine.
2. **The node↔hub transport.** The legacy telemetry had no ack, no retry, no per-fragment integrity check — which is exactly why it lost audio packets. New: my own packet layout with session IDs, per-fragment sequence numbers, CRC, and retransmission; the hub tolerates loss by design.
3. **The DSP front end.** The legacy `dsp_mel_extractor.cpp` implements the *old* contract (128 mel, HTK scale, no normalisation) and is incompatible with the new model anyway. New: the notebook's `dsp_crynet.c` (this rebuild's own code, already validated against Python to 7.06 × 10⁻⁵), ported to ESP-DSP `dsps_fft2r` + `dsps_cmplx_mag`.
4. **Trigger and decision logic.** Legacy: hard-coded `RMS ≥ 0.18` + `CONFIRMATION_PROB 0.65`. New: `RMS ≥ 0.03` trigger, 0.0015 silence gate, and the **calibrated** threshold from `crynet_tables.h`.

**Kept deliberately (hardware facts, not design decisions):**
1. The model's input contract (2 s, 16 kHz, 81 × 64 log-Mel, CMVN) — the trained weights require it exactly.
2. Physical pin assignments and the board wiring — facts about the user's real hardware, verified against the wiring docs, with the driver code written fresh.
3. The 3-node → hub → wearable topology and the binary alert semantics (`alert_type 0x01`).

### 4.2 Staged plan — one artifact per stage

**Stage 2a — hub inference core.** *(the risk-reduction stage: no radio, no display, no BLE)*
Minimal ESP-IDF app that links `model_data.h` + `crynet_tables.h`, runs the DSP front end and TFLM INT8 on a 2 s buffer, and prints `P(cry)`, inference latency and tensor-arena usage. Runs the **same four probes** as the Python parity test *on the target MCU*, so the DSP is verified on real hardware, not just on the host.
Exit criteria: compiles; runs on the S3; on-board front-end deviation vs Python < 1 × 10⁻³; latency and arena measured and logged; arena moved to PSRAM if it does not fit in internal SRAM.

**Stage 2b — node firmware (ESP32-C3).** I2S INMP441 capture at 16 kHz, DC-offset removal, 100 ms RMS telemetry, on-demand 64 KB audio burst with fragmentation + CRC + retry.
*Status (2026-10-30): **done and verified on the board.** The rewired INMP441 produces real audio, the node streams telemetry and serves burst requests, and both sketches discard the microphone's power-on burst.*

**Stage 2c — hub system.** ESP-NOW receive, RMS trigger, audio assembly across 286 fragments, inference, TFT display, BLE GATT server, alert packet.
*Status (2026-10-30, late): the radio half is **verified end to end on the real boards** — the hub requests a window at RMS >= 0.03, reassembles 286/286 fragments in ~1.15 s, and the CRC-32 it computes over the reassembled audio matches the one the node froze (`0x23C2EE17 -> MATCH`); the front end and INT8 model then run on the window on the hub. Four bugs were found and fixed on the way (closed-serial-port loop starvation on the node; the telemetry memset wiping the slot's window buffer; a 50 ms probe flood; peer-add from the WiFi-task callback). **The TFT display and the BLE GATT server were finished and verified on 2026-10-31** — the panel comes up at 320×240, and a BLE client connects and subscribes while the ESP-NOW radio keeps running with 0 bad frames. Making both fit at once meant finding the hub's real memory problem: 154 KB of boot-only static buffers (the probe PCM and feature buffers) were holding internal RAM for the life of the program; they now live in PSRAM, and the hub's RAM went from 59.9 % to 12.9 %.*

**Stage 2d — wearable (ESP32-C3).** BLE notification client, SSD1306 OLED, DRV2605L haptic.

### 4.3 Toolchain status
This machine originally had **no ESP-IDF, no PlatformIO, no Arduino IDE and no Xtensa compiler**. PlatformIO **6.2.0** is installed (`research/toolchain/pio_install.log`) so the firmware can actually be **compiled and checked** here rather than written blind. Flashing still requires the user's physical boards.

**What is installed now**

| Package | Version | Notes |
|---|---|---|
| `platform-espressif32` | **8.0.0** | pinned in `platformio.ini` |
| `framework-espidf` | **ESP-IDF 6.1.0** (`4.60100.0`) | installed **by hand** — see below |
| `toolchain-xtensa-esp-elf` | 14.2.0 | GCC 14.2 |
| `toolchain-riscv32-esp`, `toolchain-esp32ulp`, gdb packages | — | for the C3 nodes and debugging |
| `arduino:esp32` (Arduino core) | **3.3.12** | the node sketches. `ESP_I2S`, `ESP_NOW` and `BLE` are all present in it |
| `arduino-cli` | **1.5.1** | ships *inside* the Arduino IDE (`resources/app/lib/backend/resources/arduino-cli.exe`) — it is how the node sketches are compiled and checked here, without opening the IDE |
| PlatformIO IDE (VS Code extension) | 3.3.4 | pointed at the **pip-installed** Core 6.2.0 (see below), so it drives the same toolchain every build in this repo came from and needs no network |

**The PlatformIO IDE in VS Code.** The extension is installed and works with
the toolchain that is already here. `.vscode/settings.json` (at the repo
root and in `firmware/hub_infer/`) sets:

```json
"platformio-ide.useBuiltinPython": false,
"platformio-ide.useBuiltinPIOCore": true,
"platformio-ide.customPATH": "C:\\Users\\HP\\.platformio\\penv\\Scripts"
```

**`useBuiltinPIOCore` must be `true`.** The extension's compatibility
check is `get-platformio.py check core --version-spec ">=6.1.6"`, and it
looks for a Core in `~/.platformio/penv/Scripts` — nowhere else. With the
setting off it reports *"Could not find compatible PlatformIO Core.
Please enable `platformio-ide.useBuiltinPIOCore`"*. The Core was
installed there with PlatformIO's own bootstrap script:

```bash
python ~/.platformio/.cache/tmp/get-platformio-1.2.2.py
```

It is **6.2.0**, the same version the command line uses, and it shares
`~/.platformio`, so ESP-IDF 6.1.0, the Xtensa toolchain and esptool are
the ones already installed and **nothing is re-downloaded**. The hub
builds through it in **99.3 s**. Open `firmware/hub_infer` as the folder
and use the toolbar: **✓ build**, **→ upload**, **plug serial monitor**.

**Do not pin the framework with a `platform_packages` URL.** PlatformIO 6.2 installs a URL-specified package by treating the archive as an **npm package**: it picks the wrong `package.json` out of the tree, writes a bogus version into `.piopm`, and leaves `packages/framework-espidf` holding only a test-fixture package. CMake then fails with:

```
include could not find requested file:
  .../packages/framework-espidf/tools/cmake/project.cmake
```

The fix that worked: delete `packages/framework-espidf`, move the fully extracted tree into its place, and write `.piopm` by hand:

```json
{"type": "tool", "name": "framework-espidf", "version": "4.60100.0",
 "spec": {"owner": "platformio", "id": null, "name": "framework-espidf",
          "requirements": "~4.60100.0", "uri": null}}
```

**Why ESP-IDF 6.1.0 and not 5.3.2.** 5.3.2 was the original target, but PlatformIO's registry only offers the framework as `~4.60100.0` (6.1.0) with `~3.50505.0` (5.5.0) as the alternative for this platform, and the 5.3.2 archive could not be installed through PlatformIO at all. 6.1.0 was already on disk, satisfies the port's `idf >= 5.1` requirement, and needed no further download. **Fallback if the port misbehaves under IDF 6.1/GCC 14:** install `platform-espressif32` 6.9.0 (framework `~3.50301.0` = IDF 5.3.1, toolchain 13.2.0) and let PlatformIO fetch both.

### 4.4 User-side action in parallel
**Done:** the user ran the full Kaggle notebook and dropped `out/` into `research/out/`; the user connected the ESP32-S3 and the Stage 2a on-device verification **passed**.

**Now, in order:**
1. Upload `node_crynet` to the C3 — Arduino IDE → board **WeAct Studio ESP32C3** → port **COM30** — with the INMP441 wired as in `firmware/node/README.md`, then run `python firmware/tools/verify_burst.py --port COM30`. It writes the node's two-second window out as a WAV and reports the mean, the RMS and the peak — that is what tells us the wiring is right and what the microphone's DC offset and level actually are.
2. Upload `node_capture` and run `python firmware/tools/collect_clips.py --port COM30 --out research/in_domain/session1` to record the room, then ~50 real cry clips.
3. The hub's radio (Stage 2c) can then be written against a node that is known to be producing correct audio.

**Both boards are already connected:** the ESP32-S3 on COM32, the ESP32-C3 SuperMini (with the INMP441 on the breadboard) on COM30. The C3's USB is its own native USB, so *"USB CDC On Boot"* must be **Enabled** — the WeAct board entry has it on by default.

---

## 5. Change log (newest first)

- 2026-11-07 (**the offline images now prove they are up to date, and `copy_sketches.bat` is no longer a step you have to remember**) | Two questions from the owner. **(1) *"must I run `copy_sketches.bat` when I want to upload to the node?"* -- No.** That step belongs to Way C (building in the Arduino IDE) and only matters when the node's **code has been changed**; flashing a node with the finished firmware is Way A (`flash.bat`), which never involves the IDE or the sketchbook. The guide had put the copy as step 1 of C4 with no "only if you changed the code" on it, so it read as a step in *uploading*. It now says so explicitly, at the top of the guide, in a table ("Flashing a node that already has the firmware -> No"; "Changing the node's code -> Yes"; "Just watching -> No"), and again in C3 and C4. **Checked the claim behind it rather than repeating it:** the copy exists because the IDE's file picker starts in the sketchbook, so editing the repository's `.ino` and opening *that* would build the stale copy. The IDE's own `selectSketch()` accepts any path, and `arduino-cli compile` of `firmware/node/node_crynet` **directly from the repository, outside the sketchbook, succeeds** (983,177 B, exit 0) -- so the constraint is the IDE's picker default, not a hard rule, and the copy remains the safe habit. **(2) *"make sure the files that are to be used to upload offline are always updated."*** Nothing had been forcing `firmware/prebuilt/` to match the source: a sketch could be edited and committed while the `.bin` files stayed old, and the next flash would put firmware on a board that is not in the repository. **Three guards now exist.** (a) **New `firmware/prebuilt/BUILD_INFO.json`** records, for each unit, the SHA-256 of **every source file that went into it** (52 for the hub, 1 each for the node and the wearable), plus the rules used to find those files. It holds nothing that varies by machine, so it is byte-identical everywhere -- **verified by rebuilding it at a different path with no git present and diffing: identical.** The volatile part (which commit, which tool versions, when) went to `firmware/prebuilt/.build-state.json`, which is git-ignored. (b) **New `firmware/tools/check_prebuilt.py`** recomputes those hashes and compares: it names the files that moved (`changed firmware/node/node_crynet/node_crynet.ino`) and exits 1. **Verified by drift probe** -- appending a line to the node sketch makes it fail, reverting makes it pass. `firmware/prebuilt/check_prebuilt.ps1` does the same in **PowerShell only** (no Python needed) and is what `flash.bat` runs before writing anything, so **a stale or damaged image is refused rather than flashed**. (c) **New `.github/workflows/prebuilt-check.yml`** rebuilds all three units on every push and fails if the result differs from what is committed. **The hashes are of content with line endings normalised**, so a clone that checked out CRLF gives the same answer as one that did not -- otherwise the CI check would fail for the wrong reason. **Both checkers also handle the case that matters for the offline path: `firmware/prebuilt/` copied on its own, with no source beside it.** There is nothing to compare against, so they say so plainly ("not checked -- the source is not in this folder") and carry on with the `SHA256SUMS` check, which still proves the images are intact; they do not claim a freshness they could not establish. **Verified by copying `firmware/prebuilt/` alone to a temp folder and running the PowerShell check there.** **Also verified the images really are current:** a full `make_prebuilt.py` rebuild of all three units came back **byte-identical** to what is committed (`git status` clean), with `firmware.bin` `f7f09a34...`, node `app.bin` `aabb406f...`, wearable `app.bin` `193cdaaf...` -- the same hashes as before, so the new record describes exactly the images that ship. **Docs updated:** a new section C7 in `GETTING_STARTED_FLASHING.md` ("Keeping the offline images up to date"), a matching section in `FLASHING.md` section 10, the `firmware/prebuilt/README.md`, and the top-level `README.md` table. **The two rules are unchanged:** write the regions, never one merged image (it would erase NVS, where a node keeps its number), and the hub images are DIO (a QIO image watchdog-resets the S3 at power-on).
- 2026-11-07 (**the flashing guide is now written for someone who has never flashed anything**, and the whole job can now be done by double-clicking a file) | The owner said it plainly: "you always been the one flashing, I never flashed with platformIO IDE or arduino IDE, and I don't even know how to use platformIO IDE, I don't know where the files to flash are -- that is what I want: a step-by-step guide on from start to finish." The earlier `FLASHING.md` was a **reference for someone who already knew the toolchain**: it opened with the PlatformIO package path, assumed what a `.bin` was, and never said where on the disk anything lived. **New `GETTING_STARTED_FLASHING.md`** is the walkthrough, in three ways to do the job, easiest first: **Way A** -- double-click `firmware/prebuilt/flash.bat`, press 1/2/3, type the port; **Way B** -- PlatformIO IDE for the hub (VS Code is already installed, the PlatformIO extension is already installed, and `firmware/hub_infer/` is already a PlatformIO project -- `platformio run` rebuilds the hub **offline in 15 s** and the three rebuilt images are **byte-identical** to the shipped `firmware/prebuilt/hub/` ones); **Way C** -- the Arduino IDE for the node and the wearable, which are ordinary `.ino` sketches. The guide names **every file by its full absolute path**, explains what a COM port is and why the MAC address is the board's real identity, gives the hub-first order and the reason for it, and lists the exact log lines that mean success. **New helpers, so nothing needs typing:** `firmware/prebuilt/flash.bat` (double-click flash: menu, port list, **refuses a port that is not plugged in** -- the I-40 lesson -- automatic backup to `CryNet_Backups` in the home folder, flash, then `run`), `firmware/prebuilt/watch.bat` (the Serial Monitor without the Arduino IDE), `firmware/prebuilt/list_ports.ps1` and `list_ports_verbose.ps1`, `firmware/tools/copy_sketches.bat` (copy the `.ino` files into the Arduino sketchbook -- the rule that catches everyone, because the IDE only builds what is inside its own sketchbook) and `firmware/tools/serial_monitor.py` (the same monitor as a script). **Verified on this machine:** the hub rebuilds offline and matches the shipped image exactly (`f7f09a34...` for `firmware.bin`, `aefe21ad...` for `bootloader.bin`, `463793a6...` for `partitions.bin`); `flash.bat` was driven end to end against a real port -- menu, port list, the invalid-port guard ("There is no port called COM99 on this PC right now."), the backup, the backup-failure escape ("Flash anyway without a backup?") and the flash-failure path all behave; `copy_sketches.bat` brings the sketchbook copies back in sync with the repository (they had drifted). **The two rules are unchanged:** write the regions, never one merged image (it would erase NVS, where a node keeps its number), and the hub images are DIO (a QIO image watchdog-resets the S3 at power-on).
- 2026-11-07 (**the firmware can now be flashed offline, by the owner, with `esptool` alone**) | The owner said plainly what the flashing guide was *for*: *"in case I get new controllers, I want to be able to upload the firmware of the units — the hub, the nodes and the wearable — myself, offline, without having to come here and ask you."* The previous `FLASHING.md` did not serve that: it described a procedure that runs on **this** machine, with **this** machine's compilers. **A fresh clone of the repository could not flash a hub at all**, because `firmware/hub_infer/components/esp-tflite-micro` and `esp-nn` are deliberately untracked (`fetch_deps.sh` pins them by commit and clones them from GitHub, which needs network), and `.pio/` is gitignored — so a clone has neither the dependencies nor the built images. The fix is to ship the built images in the repository and make `esptool` the only tool the flash path needs. **New in `firmware/prebuilt/`:** the hub (`bootloader.bin` 22,560 B / `partitions.bin` 3,072 B / `firmware.bin` 1,335,248 B), the cot node and the wearable (`bootloader.bin` / `partitions.bin` / `boot_app0.bin` / `app.bin`), plus `SHA256SUMS` over every one of them. **New tools:** `firmware/tools/flash_unit.py` (flash one unit from those images, `--check` verifies the toolchain and every hash before anything is written, `--backup` reads the whole flash first, `--dry-run` prints the exact `esptool` command, `--list` shows the ports, and it **never guesses a port** — the I-40 lesson) and `firmware/tools/make_prebuilt.py` (rebuild the images from source and refresh the hashes). **`FLASHING.md` is rewritten around this**: §0 the one tool needed and how to get it on a new machine, §1 clone-or-copy, §2 `--check`, §3 identifying a board by MAC (with §3d for a board that has never been flashed: `esptool chip-id`), §4 the hub-first order and why, §5 one command per unit *and* the same thing by hand, §6 what a brand-new board additionally needs (the node id is MAC-derived — `(mac[5] & 0x0F) + 1`, so 1..16 — and the hub watches only cots 1 and 2), §7 verification, §8 the failures, §9 backup and rollback, §10 rebuilding from source, §11 what D-83 deliberately removed, §12 the one-line version. **Two facts established while doing it:** the hub build is **reproducible and needs no network** once the two vendored components are on disk — the rebuild of 2026-11-07 produced a `firmware.bin` **byte-identical** (md5 `9a79f34ee5d08384a12f051b5a817a34`) to the one flashed to the bench units; and the Arduino sketches must be compiled with **`-j 1`**, because the parallel build dies with `cc1plus.exe: out of memory` on this 16 GB machine (the node build takes ~4 min that way, the wearable longer — its BLE library is the cost). **The images are written region by region, never as one merged file**, because a merged image would write `0xFF` over the gaps and **erase NVS** — the node's id lives there, and `0x9000–0xE000` is skipped by the offsets on purpose. **A third check, the useful one:** the newly built wearable images were compared against `wearable_baseline_COM30.bin` (the whole-flash backup of the wearable from 2026-11-06) — the bootloader and the partition table are **byte-identical**, and the application differs in **74 bytes out of 685,296**: the app descriptor's build stamp (`18:03:56 Nov  7 2026` against `10:42:51 Oct 30 2026`) and the two hashes that follow from it. **So the wearable's firmware has not changed since the bench flash.** The same test on the node — building the D-83 node sketch a second time and comparing the two builds — came back with **69 differing bytes out of 983,328**, again only the app's SHA-256, the build stamp and the trailing checksum, which says two things at once: the Arduino build is **deterministic for unchanged source**, and the image shipped in `firmware/prebuilt/node/` is functionally the same firmware that was flashed to the bench units today. The node's app image is a different matter against the *pre-D-83* backup: recompiling after the D-83 change moves every address, so it differs there in 97 % of its bytes, as it must. No board was plugged in during this work, so **no live flash was performed**; what was verified is that the images build, that the hashes match, that the wearable image is the firmware already on the bench board, that the node build is deterministic, and that the `esptool` command line the tool produces is the one the 2026-11-07 bench flash used.

- 2026-11-07 (**FLASHING.md — the flashing procedure written down as a guide**) | The owner is mid-soldering and asked for a full step-by-step guide to flash every unit, so the procedure the 2026-11-07 bench flash actually used is now `FLASHING.md` and the README points at it. It covers: the tool locations (`esptool` from PlatformIO for the hub, `arduino-cli` from the Arduino IDE install for the C3 boards); **backing up each board's whole flash before touching anything**; identifying boards by MAC with `who_is_who.py` instead of trusting COM numbers; **the hub-first order** (the old hub cannot read the new 32-byte telemetry, the new hub reads both); the exact good-boot-log lines to look for (`RESULT: PASS — 4 probes`, no `bat` field, `Hash of data verified`); why `--merged` must not be used for the hub (QIO makes the S3 watchdog-loop); the zero-watchdog behaviour with no microphone fitted; unit-by-unit verification; the bootloader-recovery `run` command from I-40; and whole-flash rollback from the three `%TEMP%` backups. Every flag quoted in it was checked against the tools, and a superseded same-day draft (`FLASHING_GUIDE.md`) was deleted so only one guide exists.

- 2026-11-07 (**the D-83 firmware was flashed onto all four units and verified live**) | The owner plugged the units in and asked for the updated firmware to be uploaded. **The port map was established first, not assumed.** `Get-CimInstance Win32_PnPEntity` showed **COM32 = the hub** (CH343, VID 1A86 PID 55D3) and two Espressif native-USB boards on **COM30 and COM31**, and `firmware/tools/who_is_who.py` read the boot banners: **COM31 = node 1, MAC `90:DA:72:85:C5:44`**; **COM37 = node 2, MAC `90:DA:72:87:CB:98`** (it appeared when the last board was plugged in); **COM30 = the wearable**, confirmed by the `%TEMP%/wearable_baseline_COM30.bin` backup being named for that port — its firmware was a foreign "sensor = … output = …" sketch from the separate system test, as the owner had said. COM30's firmware was replaced with the wearable sketch and the other three with the CryNet firmware. **The hub was flashed first, deliberately:** the new hub reads both the old 34-byte and the new 32-byte telemetry, but the *old* hub could not read the new node format, so hub-first is the only order in which no node ever meets a hub that misreads it. **Verified live, not assumed:** the hub's boot self-check reads **`RESULT: PASS — 4 probes, front end and model agree with the host`**; **`ili9341: the panel is up: 320 x 240, rotation 2`** (the hub's TFT is connected, even though the owner thought the displays were off — the *wearable's* OLED is the one not attached); both cots are online (`node 1 is online`, `node 2 is online`) on the **new telemetry format, with no `bat` field in the log line** where the old build printed `bat %u mV`; the node consoles print **no battery line** and their ids are unchanged (node 1 on COM31, node 2 on COM37, both saving to NVS); and the wearable is connected over BLE and reports **`state: 2 cot(s), mask 0x00`**. **This flash also put the I2S zero-watchdog (D-79) onto the nodes for the first time** — it was committed but deliberately never flashed while the owner was soldering, and O-1c said it needed a played-cry end-to-end run afterwards. **That run has not happened yet, and the reason is now settled: the owner confirmed that only the boards were connected — the INMP441 microphones are not attached at all.** Both nodes reading `rms 0.0000` and `mean 0` — exact digital zero, every sample — is therefore the *correct* behaviour for a board with no microphone on it, not a fault. The I2S is producing frames (`pump calls=15 empty=0 frames=3840`) and every one of them is silence, because there is nothing on the data line to be anything but zero.

**One thing this does teach, and it is worth writing down:** the zero-watchdog cannot tell an *unattached* microphone from a microphone that has *died*, so on a board with no mic it will restart the I2S forever — node 1's watchdog restarted it **8 times** during the run, and one burst stalled at 274 of 286 fragments before the resend mechanism recovered it. With a real INMP441 fitted the trigger should stay quiet, because a live mic in a quiet room delivers noise, not zeros. **If the restarts continue once a microphone is attached, the watchdog is firing on the installed mic and needs a look** — that is exactly the distinction the commit message for 9b94d60 warned about ("it detects exact zeros only, so a mic that delivers quiet-but-nonzero noise is still not covered").

**Next: attach the INMP441 modules to both node boards, then do the played-cry end-to-end run that D-79/O-1c is waiting for.** The flash itself is finished and correct; nothing in it needs redoing. **Rollback remains possible for every board:** `%TEMP%/fullflash_31.bin`, `%TEMP%/fullflash_37.bin`, `%TEMP%/wearable_baseline_COM30.bin` (md5 `0ba262cd9dd6e6f255438e79dbeb729a`).

- 2026-11-07 (**a note was added about the printed wiring PDF, and two dangling cross-references were fixed**) | `SYSTEM_WIRING.pdf` in this repository is a **snapshot exported on 2 November 2026** and is out of date: it predates the battery design (D-81), the two-cot split and the removal of the battery sense and the status LEDs (D-83). There is **no markdown-to-PDF toolchain on this machine** — no pandoc, no Python markdown library — so it was **flagged rather than regenerated** with something crude, and `SYSTEM_WIRING.md` now says so at the top. **The live documents are `SYSTEM_WIRING.md` and `SYSTEM_WIRING_DIAGRAMS.pdf`.** Two cross-references left dangling by the D-83 rewrite were also fixed: §7 no longer describes a charge prompt, and D-76 points at what that section used to be called.

- 2026-11-07 (**the battery SOC and every status LED were removed from the system — D-83**) | The owner decided to take the battery readout out of the system altogether, together with the connectivity and SOC LEDs, because the hub's display already shows the connection. **Nothing was flashed and no hardware was touched** — the owner is mid-solder and the units were not on USB; the firmware is written and compile-verified, and the units are waiting to be plugged in. **What was removed, in the firmware:** the node's battery sense on GPIO3 (`PIN_BATTERY`, the 16-sample average, the 800–1500 mV trust gate and the ×3.2 scaling), the cell-voltage field in the telemetry, the `BAT_CURVE` table and `battery_percent()` in `hub_display.c`, the `HUB_BAT_*` bands and the hysteresis that moved them, the `BAT ~80 %` / `BAT LOW` / `BAT CRIT` text on the cot cards, and the node's **connection LED** on GPIO10 (`PIN_LINK_LED`, `link_led_tick()`). The node's `status` command no longer prints a cell voltage, and the hub's boot log no longer prints `bat %u mV`. The **heartbeat and its ACK stay** — that is how a node knows the hub is there; only the LED that displayed the answer is gone, and the node prints the same fact on its serial console instead. **The wire format changed with it:** the telemetry's battery tier is removed, so the radio counters move down two bytes, from offset 18 to 16, and the node's telemetry payload goes from 34 bytes to 32. The hub still reads the old 34-byte layout (counters at 18) when a node has not been reflashed yet, so the counters do not turn to noise while the units are being flashed one at a time. **In the documents:** `SYSTEM_WIRING.md` §3.3 is now "No battery sensing, and no status LEDs", §5.1/§5.2/§5.3 have "battery sense: none" and "status LEDs: none" rows, and §7 is now "There is no battery readout"; `HARDWARE_COMPONENTS.md` no longer lists the 220 kΩ, the 100 kΩ, the 100 nF divider capacitor or any LED; `TWO_COT_README.md` and the panel mock-up lose the `BAT ~92%` line; and the five wiring-diagram pages were regenerated with the divider and the LEDs drawn out and a note in their place saying what is there instead. **What did *not* change:** the battery power itself — the cells (18650 on the nodes and the hub, 1000 mAh pouch on the wearable, never LiFePO4), the LX-LCBST modules, the switches, the boost converters and the charge currents are exactly as D-81 settled them. **What is given up:** nothing in the system will now warn the caregiver that a cell is nearly flat; the cells have to be watched by eye and charged before a unit goes back on a cot. **Freed pins:** GPIO3, GPIO7 and GPIO10 on the node, GPIO1, GPIO2 and GPIO17 on the hub — all free, and none of them a boot-strapping pin on its board. **Verified:** both firmware targets build clean on this machine — the hub with PlatformIO/ESP-IDF (RAM 13.0 %, flash 63.6 %) and the node sketch with the Arduino IDE's `arduino-cli` on `esp32:esp32:weact_studio_esp32c3` (75 % flash, 50 % RAM) — and the diagram generator's own layout checker passes on all five pages. **Not verified:** none of it has run on hardware; the first live run will be the end-to-end test with a played cry. Recorded as D-83, with D-81 marked superseded in part, O-1e closed (there is no divider left to measure) and O-1a's wearable SOC readout cancelled.

- 2026-11-07 (**the D-81 rationale was corrected after the owner clarified how the variable resistor would actually be used, and a source-impedance caveat on the divider was found and recorded as O-1e**) | The owner asked why the variable-resistor advice had been rejected. **The clarification was that the pot would be set once, so the output lands inside the analog pin's range, and the reading then followed the battery down.** That is a fair description, and it **corrected an overstatement in the record**: D-81 had said that "a pot's wiper position cannot be read by the firmware, so the chip would not know the division ratio". As a blanket claim that was **wrong** — a **three-terminal** pot used as a genuine divider (one end to B+, one end to B−, the wiper to the ADC) does work, and the firmware does not have to read the wiper at all, because the ratio can be measured once at assembly and handed to the firmware as a constant. **The decision is unchanged, but the reasons are now the correct ones.** *(1) A **two-terminal** pot — a rheostat between the cell and the pin — cannot divide at all:* the ADC pin's only path to ground is its own high-impedance input, so turning the pot down barely moves the voltage and the pin still sits near 4.2 V, past the C3 IO's 3.6 V absolute maximum. Dividing needs a second leg to ground. *(2) A three-terminal pot works, but it costs **per-unit calibration** (a meter reading and a per-unit constant on every board, where the node firmware's ×3.2 is baked in), **silent drift** (a wiper is a mechanical setting that moves with heat, vibration, wear and the knocks a cot gives the node, and the reading keeps looking plausible while it moves), and **magnitude**: `BAT_CURVE` moves 100 mV = 20 percentage points around 3.8 V, so **1 % of ratio error is already ~10 points of SOC error**, against a pot's 1–5 % tolerance-plus-drift. A fixed 1 % pair is ±1 % on the ratio, known at the design stage, on every unit, with no per-unit step. *(3) The linear-map objection is untouched by any of this — it is about the **curve**, not the divider, and 3.0–4.2 V linear still calls a quarter-full cell 58 %.* **One genuine finding came out of checking the ADC's input network:** the divider's source impedance is **68.75 kΩ** (220 kΩ ∥ 100 kΩ), above the ~10 kΩ an ESP32 ADC likes. The **100 nF on the sense node is what makes that workable** — the ADC's sample-and-hold takes its charge from the capacitor rather than from the divider — so **the capacitor is load-bearing, not a nicety, and must not be omitted.** The fix is available without touching the firmware or the ratio: a **22 kΩ / 10 kΩ pair gives the same ×3.2, the same 1.31 V at a full cell, the same 800–1500 mV trust-gate window**, and drops the source impedance to 6.9 kΩ, for about 118 µA more drain (131 µA against 13 µA — under 0.1 % of the load). **That is recorded as O-1e and is a bench decision, not a change applied to wiring the owner is soldering now:** on the one battery-powered assembly, compare the reported cell voltage against a meter at full, mid and near-empty; if it tracks within a few per cent, the 220 kΩ / 100 kΩ pair stays and nothing changes. | `DECISIONS.md` (D-81, new O-1e), `HARDWARE_COMPONENTS.md`, `SYSTEM_WIRING.md`, `tools/wiring/diagram_lib.py`, `tools/wiring/page_hub.py`, `tools/wiring/page_wearable.py`, `SYSTEM_WIRING_DIAGRAMS.html`, `SYSTEM_WIRING_DIAGRAMS.pdf`, `SYSTEM_UPDATE.md` | **Nothing was flashed and no hardware was touched.** This is a **documentation correction** on the same branch as the battery work — it changes the *justification* on file, not the design, and **not one component value changed**: the divider is still 220 kΩ / 100 kΩ with a 100 nF across the 100 kΩ, and the firmware's ×3.2 is untouched. The five-page diagram was rebuilt and the layout checker passed with **zero `LayoutError`s on all five pages**. **Nothing is merged to `main`.** The parts list is unchanged from the previous entry, so anything already bought against it still stands. |
- 2026-11-07 (**the battery design was settled: a fixed divider rather than a variable resistor, a curve rather than a linear SOC map, an 18650 on the nodes and the hub, a pouch on the wrist, and the runtime cost of the 5 V→3.3 V linear stage named**) | The owner asked about two things: **battery SOC measurement** — they had been advised to put a *variable resistor* between the cell and the ADC pin, read the maximum (4.2 V) as 100 % and the minimum (3.0 V) as 0 % — and **which cell to use**, having been told lithium-ion cells are pricey. **That advice was checked against the design and rejected on three counts, and the answer is recorded as D-81 and D-82.** *(1) As described it would put 4.2 V on a 3.3 V pin.* The C3's IO is 3.3 V only, so a divider is mandatory whatever element is used to make it. *(2) The firmware cannot read a wiper position.* A pot's ratio would drift with heat, vibration and age, and the chip would have no idea what it was dividing by; a worn wiper is a real failure mode on a unit a cot bumps every night. **Two 1 % resistors (220 kΩ / 100 kΩ, ratio ×3.2) give a ratio the firmware knows exactly**, and `analogReadMilliVolts()` already applies the chip's factory-calibrated ADC reference — so the only residual error is the resistors' own tolerance, which the existing banding absorbs. *(3) The 3.0–4.2 V linear map is chemically wrong.* A lithium cell runs roughly 4.20 V = 100 %, 3.85 ≈ 55 %, 3.70 ≈ 25 %, 3.60 ≈ 10 %, 3.40 ≈ 0 %, so a straight line would report a genuinely quarter-full cell as "58 %" — wrong across exactly the range the cell spends most of its life, and wrong in the direction that says "fine" when the answer is "not fine". **`hub_display.c` already held the correct table (`BAT_CURVE`) and already printed it as `BAT ~80 %` with a tilde**; the tilde is doing real work and must not be dropped. The bottom of the scale was moved from 3.0 V to **~3.3 V**, because 3.0 V is roughly where a protected cell's protection circuit cuts out — end-of-life, not "empty". The reading is also taken *under load*, so the cell sags 100–200 mV while the boost converter and radio draw current: the firmware averages 16 samples, filters through the 100 nF, and the hub bands with hysteresis. **A percentage read this way is a caregiver-facing estimate, not a fuel gauge**; if a true SOC is ever wanted, the part is a **MAX17048** on I²C (the hub and wearable have a spare bus; the node's microphone occupies I²S, so nodes keep the divider). **On the cell:** "Li-ion" and "Li-Po" are the same chemistry — the decision is *format*, and it is **opposite for the two kinds of unit**. A node sits on a cot frame within a baby's reach, so it gets an **18650** (3.7 V nominal, 4.2 V full, 3000 mAh, protected, in a holder): more energy per unit volume, and a steel can that cannot be punctured. A wrist cannot take an 18650 — 18 × 65 mm and 48 g — so the **wearable keeps a flat 1000 mAh Li-Po pouch** (raised from the original 500 mAh, and the module's ~1 A charger must come down to **~400–500 mA**, since 1 A into 1000 mAh is 1 C). **LiFePO4 is excluded from the whole system**: the module charges to 4.2 V and an LFP cell tops out at 3.65 V, so it would be destroyed. **The runtime finding (D-82):** the chain is **cell → boost to 5.1 V → the board's 5 V pin → its onboard linear regulator → 3.3 V**, and a linear regulator passes *current*, not power, so the cell supplies roughly **1.8× the 3.3 V load current** while the difference is burned as heat — about 160 mA from the cell for a 100 mA load. That projects to **roughly six hours** for the wearable on a 1000 mAh pouch and rather less than a day for a node on a 3000 mAh 18650. *These are projections from the regulator's behaviour, not measurements — no runtime has ever been measured on this system.* The largest single lever is to **feed the board's 3V3 pin from a 3.3 V buck-boost** and skip the linear stage, which would roughly double runtime; that changes the power architecture, so it is recorded as an option to evaluate at the bench rather than applied to the wiring the owner is soldering. **A contradiction between the repository's own documents was found and fixed:** `HARDWARE_COMPONENTS.md` still described the **three**-cot system with a **DRV2605L** haptic and listed the divider as **100 kΩ + 100 kΩ giving 2.1 V** — which is the wrong pair for firmware that divides by 3.2, and had already been flagged in an earlier entry of this log. The BOM now describes the **two**-cot system, the **BC547** haptic that is actually fitted, and the **220 kΩ / 100 kΩ** divider the firmware expects; the consolidated purchasing count, the assembly-supplies counts and the cell quantities were corrected with it. `SYSTEM_WIRING.md` §2.3 (the DRV2605L connection list) is now marked **SUPERSEDED** and points at §5.3 rather than being left to contradict it, and §7 gained the voltage-to-percent curve and the reason the reading sags. The five-page diagram was rebuilt (HTML + PDF, 219,351 bytes), the layout checker passed with **zero `LayoutError`s on all five pages**, and pages 1, 2 and 4 were re-rendered to PNG and inspected. | `HARDWARE_COMPONENTS.md`, `SYSTEM_WIRING.md`, `DECISIONS.md` (D-81, D-82, O-1d), `tools/wiring/page_overview.py`, `tools/wiring/page_node.py`, `tools/wiring/page_hub.py`, `tools/wiring/page_wearable.py`, `tools/wiring/diagram_lib.py`, `SYSTEM_WIRING_DIAGRAMS.html`, `SYSTEM_WIRING_DIAGRAMS.pdf`, `SYSTEM_UPDATE.md` | **Nothing was flashed and no hardware was touched.** This is a **design and documentation change on branch `feature/battery-soc-and-cell-design`**, not on `main`; the branch is not merged. **The parts list changed, so anything already bought against the old BOM should be checked:** the divider resistors are **220 kΩ + 100 kΩ** (not two 100 kΩ), the LED current-limiters are **1 kΩ** per `SYSTEM_WIRING.md` §5.1, the haptic is a **BC547 + 1N5819 + 10 Ω** (no DRV2605L breakout to buy), and the **cell count is four** (2 nodes, 1 hub, 1 wearable) — three 18650s and one pouch, not five pouches. **New open item O-1d:** no runtime has been measured and the module's charge current, quiescent drain and switch-off drain are all still unmeasured — the bench procedure in `SYSTEM_WIRING.md` §6 (build ONE assembly, measure charge current, set the trimpot to 5.1 V, confirm switch-off behaviour, compare against the USB baseline) is how that gets closed. **The node's I2S watchdog (D-79) and the multi-cot wearable candidate (D-80) are untouched by this entry** and remain as they were.

- 2026-11-06 (**the two-cot system was given its own GitHub repository and remote, and its decisions were written down as D-75…D-80**) | The two-cot system had been living in `fp-two-node` with **no git remote at all** — nothing could be pushed, and the sibling three-cot repository `fp-2` had its own remote (`crynet` → `Amazo123/CryNet`). **A new public repository was created, `Amazo123/CryNet-TwoNode`**, and `fp-two-node` now has it as `origin`. **Published:** `main` (created from the working branch, which is the branch everything landed on today), plus `feature/wiring-diagrams-x2-corrected`, `feature/wearable-multi-cot`, `feature/two-node-display` and `fix/link-resend-bitmap-verification`. **The two repositories share their history up to `99bb257`** and then diverge, so the model, the signal contract and the whole decision record remain traceable in one place without the two firmware trees drifting into each other — which is exactly what happened to the wearable sketch before the split. **This repository's documents had been a stale copy of `fp-2`'s, and that is now fixed.** `DECISIONS.md` said `Repo: fp-2`, described **three** cot nodes and a **DRV2605L** haptic, and carried the three-cot system's open items — including O-1 "the wearable does not exist yet", which was true of `fp-2` and false here. **The identity blocks in all three documents now name this repository, its branch, its remote and its sibling.** `DECISIONS.md` §0 describes two cot nodes and the BC547 haptic; the hardware table in `PROJECT_HANDOFF.md` now reads `Cot nodes ×2` and `SSD1306 OLED + BC547 haptic motor`; `SYSTEM_UPDATE.md` and `PROJECT_HANDOFF.md` say the same. **New subsection `DECISIONS.md` §1.9 "The two-cot system (this repository)"** records the six decisions where this build deliberately differs from `fp-2`, so the two log sets can be read side by side: **D-75** its own repository; **D-76** the wearable has no status LEDs, the OLED carries the state; **D-77** the haptic is a BC547 low-side switch, not the DRV2605L the planning documents still describe; **D-78** the hub backlight stays on 3V3, permanently on, no sleep mode; **D-79** the node's I2S watchdog is committed but not flashed; **D-80** the multi-cot wearable behaviour is held on its own branch. **Three open items were added or corrected** (O-1 marked resolved, O-1a the wearable's missing battery readout, O-1b the untested dual-cry path, O-1c the watchdog waiting on the soldering). | `DECISIONS.md`, `SYSTEM_UPDATE.md`, `PROJECT_HANDOFF.md` | **The owner has started soldering the final wiring.** That is why the node's I2S watchdog (D-79) is committed but **not flashed**: a node should not be reflashed mid-solder. It goes on once the hardware is settled, and it then needs a played-cry end-to-end run to confirm the node still streams and the hub still hears it. **Nothing was flashed and no board was touched** — at the time of this entry no ESP32 was on USB (the only COM port present was `COM3`, the Intel management interface). **Rollback remains possible for every board:** `%TEMP%/fullflash_31.bin`, `%TEMP%/fullflash_37.bin`, `%TEMP%/wearable_baseline_COM30.bin` (md5 `0ba262cd9dd6e6f255438e79dbeb729a`). **The GitHub credential is already configured** (`credential.helper=manager`, account `Amazo123`), so no new authentication was needed; the token was read from the credential helper and used for the one API call that created the repository, and it was not written anywhere.

- 2026-11-06 (**the two candidates were committed, and the untested one was moved onto its own branch**) | The owner confirmed the present deployed firmware works and asked for the working changes to be committed, with the one that has never been tested held back. **Three commits landed on `feature/wiring-diagrams-x2-corrected`.** (1) `db416e6` - the `capture_multi.py` fix (a busy port no longer aborts the whole capture; the log opens on first use). (2) `9b94d60` - the node's I2S zero watchdog: five seconds of consecutive exact-zero samples triggers an I2S restart from the capture task, a failed teardown or warmup reboots rather than reusing broken handles, and the restart count is reported in the status line. **Its commit message is explicit that the fault-injection test proves the code executes, not that it recovers the original physical fault.** (3) `345665a` - the backlight-on-3V3 diagram change and the change-log entry for it. **The multi-cot wearable change was moved off this branch onto `feature/wearable-multi-cot` (`4e6049f`)**, because two cots crying at the same time has never been tested: the branch holds the multi-detection alert face, the haptic when a second cot joins, and the suppressed CLEARED, with the single-cot path unchanged in behaviour. It stays there until the dual-cry test can be run. **So `feature/wiring-diagrams-x2-corrected` now carries only work that is either proven on the bench or is a self-contained guard that changes no existing behaviour - the branch's firmware is the firmware the owner already has running, plus the watchdog that has not been flashed.** | `firmware/tools/capture_multi.py`, `firmware/node/node_crynet/node_crynet.ino`, `firmware/wearable/wearable_crynet/wearable_crynet.ino` (branch `feature/wearable-multi-cot`), `SYSTEM_UPDATE.md` | **Nothing was flashed and no board was touched: at the time of this commit no ESP32 was on USB** (the only COM port present was `COM3`, the Intel management interface), and this repository has **no git remote configured**, so there was nothing to push to either - `git push` is not possible from here until a remote is added. **Rollback remains possible for every board:** `%TEMP%/fullflash_31.bin`, `%TEMP%/fullflash_37.bin` and `%TEMP%/wearable_baseline_COM30.bin` (md5 `0ba262cd9dd6e6f255438e79dbeb729a`). **Before the watchdog is flashed to a node,** it needs a played-cry end-to-end run to confirm the node still streams and the hub still hears it, and the existing notes should be read: it detects *exact* zeros only, so a mic that delivers quiet-but-nonzero noise is still not covered. **Merging to `main` is still the owner's call** and has not been done.

- 2026-11-06 (**the hub backlight goes back on 3V3 and stays on: the owner chose no sleep mode, so the GPIO4 MOSFET came off the diagrams**) | Earlier today the hub page was redrawn with the TFT backlight switched by a 2N7002 on GPIO4 so the panel could be dimmed or turned off for a future sleep mode. **The owner has now decided against that: the LED stays on 3V3, the backlight is permanently on, and there is no sleep mode.** Nothing had been soldered, so the change is on paper only. **Page 3 was redrawn.** The 2N7002, its 100 ohm gate resistor and its 100 k pull-down are gone, and the hub page shrank back from 575 to 490 units tall. The TFT box now carries the `LED` pin as a normal left-edge pin between `VCC` and `GND`, and the backlight anode branches off the same 3.3 V net that feeds the panel's VCC (a junction dot at the branch point), so there is one wire fewer and no new part. A note under the panel says `Backlight: LED pin on 3.3 V - always on, no dimming.`, and the verified caption is back to the six TFT signal pins with the LED pin explicitly described as tied to the panel's own 3.3 V. **GPIO4 is freed again.** The hub's bottom pin row is back to three pins (GPIO1 divider, GPIO17 SOC LED, GPIO2 BLE LED) with no GPIO4 label, and the firmware's `PIN_BL 4` / `ili9341_backlight_set` simply drives a pin with nothing attached, which does no harm - the existing backlight LEDC code is left in place. **Page 1's hub box** now reads `backlight on 3V3 - always on` instead of `backlight switched by GPIO4`, and its Li-Po line was rewrapped to two lines so nothing collides. The HTML and PDF were rebuilt (`SYSTEM_WIRING_DIAGRAMS.pdf`, 5 pages, 200,417 bytes) and the layout checker passed with zero problems; every page was re-rendered to PNG and inspected. | `tools/wiring/page_hub.py`, `tools/wiring/page_overview.py`, `SYSTEM_WIRING_DIAGRAMS.html`, `SYSTEM_WIRING_DIAGRAMS.pdf`, `SYSTEM_UPDATE.md` | **Nothing was flashed and no hardware was touched** - the live hub's panel LED was already tied to 3V3, so the bench matches the drawing again and the previous entry's `Still open: the backlight MOSFET is a wiring change that has not been built` is resolved by withdrawal, not by building it. The consequence the owner accepted: the glass cannot be dimmed or blanked while the board is powered, which on a system that is always plugged in or charging is the simpler and more reliable choice. **Still open, unchanged:** the hub has no ADC read and no LED firmware, the node's GPIO7 SOC LED has no firmware, and the wearable's LED question stays as `fp-2` decided it - no LEDs, the OLED carries the state.

- 2026-11-06 (**the wiring diagrams were corrected and regenerated for the two-cot system, with the hub TFT backlight moved onto GPIO4 behind a MOSFET**) | The generator was copied from `fp-2` into this repository as `tools/wiring/` and the five pages were corrected against the running firmware, then rebuilt into `SYSTEM_WIRING_DIAGRAMS.html` / `.pdf` (5 pages). **Six corrections.** (1) **Three cot nodes became two.** Page 1's unit box reads `Cot node x2`, page 2's title reads `(one per node, x2)`, and page 2's footer says `Repeat identically for node 2.` Page 5's `buy ONE module for validation; only then buy the remaining three` is unchanged and still correct - four modules are needed (node 1, node 2, hub, wearable). (2) **The hub TFT backlight moved off 3V3 onto GPIO4, switched by a 2N7002.** `hub_display.c` already treats GPIO4 as the backlight (`PIN_BL 4`, `ili9341_backlight_set` driving it with LEDC PWM, high = on), but GPIO4 had no load, so the panel's LED pin was still tied to 3V3 and could never be switched off. The page now draws the LED pin at the TFT's right edge and a real N-channel MOSFET (2N7002 TO-92 or AO3400 SOT-23): **3V3 to the drain, the source to the TFT `LED` pin** (the module's backlight cathode is internal to its GND, so switching the anode works), **the gate through 100 ohm to GPIO4 with a 100 k pull-down to ground** so the backlight is dark during reset and until the firmware brings it up. The MCU pin never sources the backlight current. The TFT's VCC stays on 3V3. The backlight is now PWM-dimmable by the existing firmware, and a future sleep mode only has to set the PWM to 0. (3) **The hub's bottom pin row was re-laid out and a pin/LED mix-up was fixed.** The bottom labels now sit at GPIO1 ~415, GPIO4 ~462, GPIO17 ~510 and GPIO2 ~558, inside the board box, and the wires that leave the bottom edge start at the matching x: the divider ADC at 420 (GPIO1), the gate wire at 462 (GPIO4), the amber SOC LED chain at 510 (GPIO17) and the blue BLE LED chain at 558 (GPIO2). **In the previous PDF the blue `BLE` wire and the orange `SOC` wire were swapped relative to the pin labels** - per `SYSTEM_WIRING.md`, GPIO2 is the BLE-status LED and GPIO17 is the SOC LED, and that is what the page now shows. The hub page grew from 480 to 575 units tall so the gate pull-down hangs below the board. (4) **The firmware-status captions are now true.** The old text said `Firmware for the divider and the LEDs does not exist yet`, which was wrong for the node: `node_crynet.ino` implements the divider (`PIN_BATTERY 3` = ADC1_CH3, a trust gate that only accepts 800-1500 mV, and a x3.2 scale - so the 220 k / 100 k values on the page are correct) and the **GPIO10 blue link LED** (`PIN_LINK_LED 10`). There is **no GPIO7 anywhere in the node firmware**, so the GPIO7 amber SOC LED is a dead wire until that firmware is written on a branch; the page now says exactly that, and notes that the bench node printing `battery none (USB, or the divider is not wired)` on USB power is the expected trust-gate behaviour, not a fault. The hub firmware has **no `analogReadMilliVolts` and no LED output at all**, so the hub's GPIO1 divider, GPIO2 BLE LED and GPIO17 SOC LED are all marked plan only - `BAT_CURVE` / `battery_band_advance` in `hub_display.c` describe the *nodes'* reported cell voltage, not the hub's own. The TFT signal pins (CS 10, MOSI 11, SCK 12, DC 13, RST 14, VCC 3V3, GND) and the GPIO4 backlight are marked verified on the live system. (5) **Mic placement was added to the node page.** The INMP441 is fixed-gain: mount it on the cot frame on a stiff lead, at least 30 cm from where the baby's head will be, never loose on the mattress. The hub refuses a saturated window (`the window is CLIPPED`), so the phone must be at least 15 cm from the mic when playing a test cry. (6) **The wearable page stays LED-free and now matches the firmware.** The BC547 haptic circuit is unchanged (GPIO7 -> 2.2 k base, 100 k base-emitter pulldown, 10 ohm in the motor's + lead, 1N5819 flyback with the cathode up, collector to motor -, emitter to GND) and the OLED stays on 3V3 / SDA GPIO5 / SCL GPIO6. The page says the OLED carries the state and shows LINK or SCAN today, and that the battery/SOC readout needs the GPIO3 divider wiring **plus** firmware that does not exist yet. **Nothing was flashed and no hardware was touched.** | `tools/wiring/build.py`, `tools/wiring/page_overview.py`, `tools/wiring/page_node.py`, `tools/wiring/page_hub.py`, `tools/wiring/page_wearable.py`, `SYSTEM_WIRING_DIAGRAMS.html`, `SYSTEM_WIRING_DIAGRAMS.pdf` | The generator's layout checker passes with **zero `LayoutError`s on all five pages** (no text-over-text, no text on a component, no wire crossing a label), and every rendered page was inspected as a PNG: no clipped label, no text on a wire, no overlapping parts. One build-side change was needed: the diagrams grew taller, so `svg.diagram` in the CSS gained a `max-height` so each page still fits one A4 landscape sheet - the PDF is 5 pages, one per diagram. **Left alone on purpose:** the page-5 LX-LCBST pad map and the bench procedure, and the `fp-2` repository itself (read only). **Still open:** the hub has no ADC read and no LED firmware, the node's GPIO7 SOC LED has none either, and the backlight MOSFET is a wiring change that has not been built - the live hub still has its panel LED pin on 3V3. 
- 2026-11-06 (**the wiring diagram was reviewed line by line against the running firmware and is approved for soldering, with five specific corrections**) | The owner supplied the five-page `SYSTEM_WIRING_DIAGRAMS.pdf` they intend to solder from and asked for an approval. **Approved, with corrections — the diagram is sound in its structure and gets the pin assignments right, but five things must be fixed or added before the iron comes out.** *What the diagram gets right, confirmed against the code:* the node's microphone wiring (3V3 / GND / L/R→GND / GPIO4 SCK / GPIO5 WS / GPIO6 SD) is exactly `node_crynet.ino`'s `PIN_SCK 4 / PIN_WS 5 / PIN_DIN 6`; the **220 kΩ + 100 kΩ + 100 nF** divider is exactly what the firmware expects (it divides the pin reading by 3.2 and only trusts 800–1500 mV); the node's **GPIO10 blue link LED** is the `PIN_LINK_LED 10` the firmware already drives from the hub's heartbeat; the wearable's **OLED SDA GPIO5 / SCL GPIO6** and **GPIO7 BC547 haptic** match `PIN_SDA 5 / PIN_SCL 6 / PIN_MOTOR 7` exactly, and the BC547 circuit on page 4 — 2.2 kΩ base, 100 kΩ base-emitter pulldown, 10 Ω in the motor's + lead, 1N5819 with the cathode up — matches the firmware's `HAPTIC_MS 2500` / `HAPTIC_PULSE_MS 250` drive and the bench-proven haptic; the hub's TFT signals (CS 10, MOSI 11, SCK 12, DC 13, RST 14) match `hub_display.c`'s `PIN_MOSI 11 / PIN_SCLK 12 / PIN_CS 10 / PIN_DC 13 / PIN_RST 14`; the ESP32-S3 warnings are right (GPIO35–37 are the Octal PSRAM bus on the N16R8, GPIO0/45/46 are strapping). **The five corrections.** (1) **The hub TFT's backlight wire is missing.** The diagram draws the panel's `backlight` pin with *no wire to it*, but `hub_display.c` defines `PIN_BL 4` and `ili9341.c` drives it through LEDC for PWM dimming — **GPIO4 → panel backlight** must be drawn, and GPIO4 must not be reused. (2) **The node SOC LED on GPIO7 has no firmware.** The diagram says "firmware for the divider and the LEDs does not exist yet"; that is only half true. The **divider firmware does exist** — `PIN_BATTERY 3`, the 800–1500 mV trust gate and the ×3.2 scale are all committed and running, which is why the bench node prints `battery none (USB, or the divider is not wired)`. Only the **GPIO10 link LED and the divider** exist; the **GPIO7 SOC LED does not exist in the node firmware at all** (no GPIO7 anywhere in `node_crynet.ino`), so wiring it produces a dead LED until that firmware is written. (3) **The hub's GPIO1 divider and both hub LEDs have no firmware either.** The hub firmware contains no `analogReadMilliVolts` and no LED output at all — `battery_band_advance` and the `BAT_CURVE` in `hub_display.c` are for the *nodes'* reported cell voltage, not the hub's own. So the hub's divider on GPIO1 and its GPIO2/GPIO17 LEDs are plan only. (4) **The wearable's two LEDs contradict the other repository.** This diagram adds a blue link LED on GPIO1 and a red SOC LED on GPIO4 to the wearable, but `fp-2`'s `SYSTEM_WIRING.md` §7 says in terms "**The wearable has no status LEDs, and its normal OLED dashboard already shows LINK or SCAN as the connection state**" — and that repository's committed PDF (commit `f6104ca`, "the wearable has no status LEDs, the OLED carries the status") says the same on page 4. The attached PDF is a **newer revision than the committed one** (it adds the two LEDs to the wearable and changes page 1's summary line to "haptic motor + battery sense + 2 LEDs"), so the two repositories have drifted. **Decision needed:** either keep the LEDs and write the firmware, or drop them and let the OLED carry the state as `fp-2` decided. They are cheap to leave unwired; wiring them without firmware gives two dark LEDs. (5) **The diagram is for three cot nodes, not the two this system has.** Every page says `Cot node x3`, page 2 says "repeat identically for nodes 2 and 3", and page 5's bench procedure says to buy "the remaining three". The system on the bench has **two** nodes. The wiring itself is identical per node, so this is a parts-count and labelling issue, not an electrical one — but the order should be **two** node assemblies. | `SYSTEM_UPDATE.md` (review only; the diagram file itself is not in this repository) | **Also checked and confirmed correct:** the LX-LCBST pad map on page 5 matches `SYSTEM_WIRING.md` §6 (B+/B− battery, VO+/VO− output, IN+/IN− left unconnected, the unlabelled front −/+ pair flagged "verify with meter", no T pad), and the three rules on page 1 are the right ones — switch off before charging, set the trimpot to 5.1 V with a meter before any board, and never power a board from USB and the boost at the same time. **The one electrical note the diagram does not carry:** the INMP441 is a fixed-gain part, so it must be mounted on the cot frame on a stiff lead at least 30 cm from where the baby's head will be, never loose on the mattress — the hub refuses a clipped window, and today's test showed exactly that failure when the phone sat too close. **Nothing was flashed and no firmware was changed by this review.**

- 2026-11-06 (**the owner is cleared to solder, and the wiring that goes on the board was read out of the running firmware rather than out of the documents, which disagree with each other**) | The owner asked whether it is safe to solder the system into its final form. It is — with the pin list below, which was read from the sketches that are actually on the bench, not from the planning documents. **The two planning documents disagree with each other and, in two places, with the firmware, so the firmware wins and the documents need correcting before anything is soldered.** *What is safe to solder now, exactly as read from the code:* **Cot node** — INMP441 `VDD`→C3 **3V3**, `GND`→**GND**, `L/R`→**GND** (left channel), `SCK`→**GPIO4**, `WS`→**GPIO5**, `SD`→**GPIO6**; optional 100 nF across the microphone's VDD/GND. The link LED is **GPIO10 → 1 kΩ → blue LED anode → GND** and the firmware already drives it. The battery sense is **GPIO3 (ADC1_CH3)**, and the firmware divides the pin reading by exactly **3.2** — so the divider must be **220 kΩ from B+ to the sense node, 100 kΩ from the sense node to B−, 100 nF across the 100 kΩ**. **Wearable** — OLED `SDA`→**GPIO5**, `SCL`→**GPIO6**, and the haptic is the owner's **BC547 low-side switch**, not the DRV2605L the two-node documents still describe: **GPIO7 → 2.2 kΩ → base, 100 kΩ base-emitter pulldown, 10 Ω in the motor's + lead, 1N5819 across the motor with the cathode up**, collector→motor −, emitter→GND. **The discrepancies found, which must be fixed before soldering.** (1) `HARDWARE_COMPONENTS.md` lists **100 kΩ + 100 kΩ** for the node divider and says that gives 2.1 V at 4.2 V; the firmware divides by 3.2, which is only correct for **220 kΩ + 100 kΩ**, and `SYSTEM_WIRING.md` §5.1 already says so — the bill of materials is wrong. (2) The same file says **330 Ω** for the indicator LEDs while `SYSTEM_WIRING.md` §5.1 says **1 kΩ**; the firmware's pin assignment is the same either way, so this is a brightness choice, but the two must agree. (3) `SYSTEM_WIRING.md` §2.3 still describes the wearable's haptic as a **DRV2605L breakout** with the motor on `OUT+/OUT−` — that is the old plan and it is **wrong for this build**: the bench hardware is the BC547 circuit above, and §5.3 in the same file contradicts §2.3. The BC547 detail is only written down in the *other* repository (`fp-2`, `SYSTEM_WIRING.md` §2.3 and page 4 of its `SYSTEM_WIRING_DIAGRAMS.pdf`). (4) The node **SOC LED on GPIO7 is not implemented in the firmware at all** — the node firmware has no GPIO7 and no SOC LED; only the GPIO10 link LED exists. Do not wire an SOC LED expecting it to work. **Also unverified and worth knowing before soldering:** the node firmware's battery reading is real but has never been exercised against an actual cell (the bench nodes report `battery none (USB, or the divider is not wired)`), and the hub's battery band has never seen a real reading either. **The order that costs least if something is wrong: build ONE node power assembly first, set the LX-LCBST trimpot to ≈5.1 V with a meter and no board attached, and run the working node firmware from it before making the second and third.** | `SYSTEM_UPDATE.md` (documents not yet corrected) | **What is settled and needs no more work:** the system's software chain is proven end to end (§1 of this log), and the wearable's installed flash is backed up at `research/out/backups/wearable_baseline_COM30_20261106.bin` (md5 `0ba262cd9dd6e6f255438e79dbeb729a`). **Still open before the system is finished:** the multi-cot candidate is unflashed (§3), the node I2S watchdog is unflashed (§4), the battery/LED firmware is a plan and not code, and the SOC LED does not exist in the firmware at all. **Safety, unchanged:** this is an academic prototype, not a certified infant monitor, and must not replace supervision. |

- 2026-11-06 (**the deployed system passed its first played-cry end-to-end test: both cot nodes detected, named and buzzed on the wrist, and cleared**). The owner played a recorded cry at each node in turn — node 1 first, then node 2 — while all four boards were captured at once (`research/out/capture_20261106_181058`, 900 s, `capture_multi.py` on COM31/COM32/COM37/COM30). **The chain is whole in both directions.** *Node 1:* the node froze windows in cry mode, the hub judged them `P(no_cry)=0.0000 P(cry)=0.9961`, logged `link: node 1: ALERT — cry` and `ble_alert: a cry on cot 1 at 100%`, and the wrist answered `ALERT cot 1 type 1 conf 100% event #1` and drove GPIO7 for 2500 ms. Eight seconds later the hub published `the cry on cot 1 at 0%` and the wrist sent `ALERT cot 1 type 2`. *Node 2:* the same sequence, `ble_alert: a cry on cot 2 at 100%` → `ALERT cot 2 type 1 conf 100% event #3` → haptic → `the cry on cot 2 at 0%` → `ALERT cot 2 type 2`. **The wrist's state mask moved exactly as it should: 0x00 → 0x01 → 0x00 → 0x02 → 0x00**, one bit per cot and never two at once, which is the behaviour the single-cot policy is built on. No false alert fired at any other time in the 900 s. **One real finding:** the hub refused two windows as evidence with `the window is CLIPPED (peak 33032 of 32767)` and `peak 31399 of 32767` — the phone was closer to a microphone than the 15 cm the demo notes ask for, so the fixed-gain INMP441 saturated. That is the known cause and it is correct behaviour: a clipped window is not evidence and is refused rather than guessed at. Both nodes still announced, because the freeze rule offers the next window too. **Also fixed:** `capture_multi.py` crashed with `AttributeError: 'NoneType'` when a port was already held by an earlier capture; it now reports the port that would not open and carries on, and its log writer opens the file on first use instead of assuming it exists. | `firmware/tools/capture_multi.py`, `SYSTEM_UPDATE.md` | **The wearable's installed flash was backed up before any of this:** `%TEMP%/wearable_baseline_COM30.bin` (4,194,304 bytes, md5 `0ba262cd9dd6e6f255438e79dbeb729a`), read with esptool from COM30 — this is the exact installed image, so a rollback is now possible. A copy of the three proven cry clips (`session4_clip_0012`, `session9_clip_0005`, `session1_clip_0005`) was put on the owner's Desktop in `CryNet-test-clips/` for the test. **What has NOT been tested yet:** the multi-cot candidate (two cots crying at once) — the wearable still runs the firmware that was on it before this test, and that candidate remains uncommitted and undeployed. The node I2S watchdog candidate also remains uncommitted and undeployed.

- 2026-11-06 — Multi-cot alert work started in wearable sketch: show all active cot detections during the held alert face, follow the remaining cot when one clears, avoid CLEARED while another detection remains, and trigger haptics when another cot joins. Build passed with Arduino ESP32 core and one job (685595 bytes program, 18684 bytes globals). **Hold: not deployed.** The owner will arrange space for testing later; both the existing deployed system and the candidate still need played-cry end-to-end tests. Review and test single-cot regression, dual-cot join/clear, repeated mask changes and reconnection before any deployment. The pre-change wearable source is preserved at commit `343db20`; it is a source baseline, not a verified backup of the exact installed flash. Capture and verify the installed wearable flash before any future upload to enable an exact rollback. Existing node watchdog candidate remains uncommitted and undeployed; neither node should be reflashed as part of this hold.

| Date | Change | Files touched | Notes |
|---|---|---|---|
| 2026-11-06 (**I2S watchdog work in progress**) | Node capture now detects five seconds of consecutive zero-valued 16-bit samples (resetting the run on short reads and latching the threshold through the rest of each read) and attempts to restart I2S from the capture task; warmup is bounded, restart failures reboot, and status reports the restart count. | `firmware/node/node_crynet/node_crynet.ino` | **Build passed** with Arduino ESP32 core 3.3.12 for `esp32:esp32:weact_studio_esp32c3` (991629 bytes flash, 166540 bytes globals). The retry with one compiler job built and flashed a temporary fault-injection sketch to node 2 (COM37), hash verified. Software-injected zeros produced `I2S zero watchdog restarts=1` and a refilled 32000-sample window; capture: `%TEMP%/crynet-watchdog-test.log`. This confirms execution, not recovery from the original physical fault. After the test, node 2's original 4 MB backup `%TEMP%/fullflash_37.bin` was restored at offset 0 and esptool verified its hash; the temporary sketch is no longer installed. Live verification: node 2 booted with a full window, rms 0.0272 and hub known; the hub reported both nodes online with nonzero RMS. The candidate is not deployed. This detects exact zeros only; it does not establish the cause of the earlier zero-RMS observation or guarantee recovery. Assess capture concurrency and fault handling before deploying. |
| 2026-11-06 (**bench recovery: both cot nodes are back online, and the zero-rms fault is proven to be transient state, not firmware**) | Node 2 (COM37) had been reading **rms 0.0000 on every mic read** — the INMP441 delivering nothing — and node 1 (COM31) was found running the INMP441 diagnostic sketch instead of the node firmware (left over from the earlier mic debugging). **Node 2's fault cleared on a hard reset, no reflash needed.** Node 1 was restored by writing its full 4 MB flash backup (`fullflash_31.bin`) back at offset 0x0 with esptool — **hash of data verified** — and it boots Stage 2b again: node id 1, ESP-NOW on channel 6, healthy rms 0.02–0.05 with the adaptive floor working. To rule firmware out, both boards' full flash images were read (`fullflash_31.bin`, `fullflash_37.bin`, 4,194,304 bytes each) and diffed 4 KB block by block: **the only difference is 0x009000–0x00E000, the NVS partition** (WiFi calibration, ESP-NOW state) — the application firmware on both boards is byte-identical. The hub then confirmed the whole chain live: **node 1 online at link −25 dBm, node 2 online at −44 dBm**, both reporting real rms (0.008–0.038), and when one burst stalled at 275/286 fragments the hub's resend path asked for the 11 missing ones and recovered them. | (no code changes — bench recovery only; no firmware was rebuilt) | *Captures: %TEMP%/cap_after.txt (hub + both nodes + wearable), queries via %TEMP%/fp2_nodeq.py.* **Open risk:** node 2's zero-rms fault has no guard — if it recurs while nobody is watching, the cot goes silently deaf. A sustained-zeros watchdog in the node firmware that reinitialises I2S would make it self-heal; not yet written. **Bench rule:** never leave the diagnostic sketch flashed on a node; restore from the full-flash backup or rebuild from this repo. |
| 2026-11-06 (**the hub's panel finally says AMAZING'S CRYNET, the wearable no longer freezes when the hub is unplugged, the link stops going stale after a reconnect, and the haptic is a real motor on GPIO7**) | Four things were fixed, and every one of them was then flashed and proved on the bench. **(1) The hub's name.** The device name AMAZING'S CRYNET was on the wearable but not on the hub's panel, which still said just `CRYNET` on the boot face and on the title card's headline. The boot face now stacks it the way the wrist does — `AMAZING'S` at size two over `CRYNET` at size four — and the title card's headline reads `AMAZING'S CRYNET` on one line (a hundred and ninety pixels of a three-hundred-and-twenty-pixel panel). The waveform moved up and shrank (WAVE_Y 84 to 46, WAVE_MAX 26 to 12) to make the room, and nothing collides: the wave ends at 59, the name runs 68 to 116, the strapline at 134, the boot step at 190, the bar at 206, the footer at 222. **(2) The freeze.** The wearable's whole BLE life — scan, connect, subscribe, read — ran in `loop()`, and every one of those library calls blocks its caller: the two-argument `scan->start(2, false)` waits on a semaphore for the whole two-second window, `connect()` can hold for thirty seconds, and `readValue()` waits for a peer that may never answer. With the hub unplugged the screen froze for whole seconds at a time, exactly as reported. All BLE work now runs on its own FreeRTOS task (`ble_task`, 6144-byte stack, priority 1) and `loop()` only renders and ticks the haptic. **(3) The stale link.** NimBLE's disconnect handler does not clear the service cache and does not reset `m_haveServices`, so a reconnect handed back the *previous* connection's handles: the subscriptions went nowhere and the link looked alive but was deaf. The wearable now calls `getServices()` explicitly after every connect, which forces a fresh discovery, and a failure anywhere in the setup path nulls the characteristics and disconnects instead of leaving half a link behind. **(4) The state characteristic is subscribed to, not polled.** The hub already publishes it whenever it changes and at least once a second, so the poll (and with it the forever-blocking `readValue()`) is gone; the wrist's crying mask is now never more than a second stale. Two smaller things came with them: `Serial.setTxTimeoutMs(0)`, because a CDC write with no reader on the other end could stall the radio from inside a BLE callback, and the per-advertisement `[scan]` debug print, which is removed. **(5) The haptic is the motor.** The LED stand-in is gone: the motor hangs on the BC547 low-side switch the owner drew (GPIO7 to a 2.2 k base resistor to the base, emitter to ground, motor in the collector), and the firmware now holds GPIO7 high for 250 ms pulses in step with the band blinking across the top of the screen — one buzz pattern per cry, because the hub re-announces a cry when a louder cot joins it and the caregiver must not be buzzed twice for one cry. GPIO7 is driven low before anything else happens in `setup()`, so the transistor is off from the first instruction. | `firmware/hub_infer/components/hub_display/hub_display.c`, `firmware/wearable/wearable_crynet/wearable_crynet.ino` | **The freeze was measured, not assumed.** The pre-fix firmware was rebuilt from git and instrumented with a once-a-second heartbeat from the UI loop, and pointed at a hub name that does not exist (the hub-unplugged state): its heartbeat came every **2044 ms** — one redraw per blocking scan window, the screen frozen the rest of the time. The new firmware's heartbeat is a steady **~1000 ms** with a redraw every 100 ms. **On the bench:** the hub was flashed with `flash_hub.py` (hash verified) and the wearable with arduino-cli (hash verified); three alert cycles in a row came through complete — console `alert 1` to the hub, `ALERT cot 1 type 1 conf 100%` on the wrist, the haptic fired, `clear` came back as `type 2` — and the hub was then reset mid-link: the wearable printed `hub lost — rescanning`, found it again, connected, subscribed to alerts *and* state, and received the next alert (event #1, the hub's counter restarted with it). **Still needs human eyes:** the hub's new boot face and title card have not been looked at on the glass, and the wrist's own screens were last reviewed before the haptic changed. **Next on the bench:** solder the motor to GPIO7 as drawn (2.2 k to the base, 1N5819 with the cathode up, 10 ohm in the motor's + lead) and run the same console test — the buzzer should run for 2.5 s in step with the blinking band. **One loose end in the other repo:** `fp-2`'s copy of the wearable sketch still blinks the LED instead of driving GPIO7; the two-node copy here is the one on the bench. |
| 2026-11-05 (**the wearable's own screens: no project title, the device name AMAZING'S CRYNET, and the panel's capitalisation**) | The owner reviewed the wearable's glass and asked for four changes, and all four are in. **(1) The project title is gone from the wearable.** The ninety-seven-character title was running as a marquee ticker across the title card, and on a hundred-and-twenty-eight-pixel screen it crowded out the name and the id number that matter more on a wrist — the ticker, the `TITLE_LINE` string and the `draw_marquee` function were deleted. The title stays on the hub's panel, which has three hundred and twenty pixels and room to set it across three lines. **(2) The device name is on the first screen.** The boot face no longer says just `CRYNET`; it now carries **AMAZING'S CRYNET**, stacked on two lines because sixteen characters at the panel's headline size need a hundred and ninety-two pixels and the screen has a hundred and twenty-eight. The title card carries the same name on one line at the smaller size, over the full name `AMAZING AYOMIKUN ADELOWO` and the id `22/05/04/0029`, with the panel's waveform along the bottom edge. **(3) Capitalisation now follows the panel.** `ALL CLEAR`, `CLEARED` and `CRYING` are in caps like the panel's banner; `Every cot is quiet`, `Searching for the hub...`, `The hub cannot hear that cot` and the boot steps (`The display is up`, `Bluetooth is awake`, `Searching for the hub`) start with a capital, as the panel's own sentences do; the event footer reads `Event #n  Ns ago`; the crying list reads `COT 1` rather than `cot1`. **(4) The wearable was flashed and verified**: arduino-cli, hash verified on COM30, and the console shows it attaching to the hub and reading `state: 2 cot(s), mask 0x00` on its own. The nodes were left alone — their firmware has not changed. | `firmware/wearable/wearable_crynet/wearable_crynet.ino` | The hub's panel is unchanged: it keeps the full project title, which fits there. **Still needs human eyes:** the new boot splash, the new title card and the inverted alert band on the wrist have not been looked at on the glass yet. |
| 2026-11-05 (**flashed and verified on the bench: the hub and the wearable run the new display firmware, and the wrist now knows the hub can hear both cots**) | **The new display firmware was flashed to the hub and the wearable, and a real bug fell out of the bench.** The hub was flashed with `flash_hub.py` (three images at 0x0 / 0x8000 / 0x10000, hash verified) and the wearable with arduino-cli (hash verified). The hub came up and heard **both** cots (`node 1 ... rms 0.0080 seq 234`, `node 2 ... rms 0.0080 seq 41`, one heartbeat a second each) — so the link was never the problem. The wearable attached on its own (`hub found`, `hub connected`, `subscribed to alerts`) but read **`0 cot(s), mask 0x00`** while the hub could plainly hear two cots. **The cause:** the BLE state characteristic was published only when a cry started or stopped, so a cot *joining* the system never reached the caregiver, and the wrist read the packet it was given at boot for ever. `ble_alert_publish_state` always updates the stored value (the notification is the part that needs a subscriber), so the fix was on the publishing side: the eight-byte packet is now rebuilt every cycle and published when anything in it has moved — the cry mask, the deaf mask, or **the number of cots the hub can hear** — and on a slow beat besides, so the value a wearable reads is never more than a second old. **Verified on the hardware:** the wrist now reads `state: 2 cot(s)`, and a console test alert moved the mask `0x00 -> 0x02` (cot 2 crying) and back `0x02 -> 0x00` on `clear`, with the wearable printing the matching `ALERT cot 2 type 2` cancel. The wearable also re-reads the state characteristic every 5 s now, so its crying list cannot go stale. **The nodes were not reflashed:** their firmware has not changed since the bench flash, and the hub is parsing both of them cleanly (`0 bad, 0 bad payload`), so the two-cot link is running the code in the repo. | `firmware/hub_infer/src/link_stage.c`, `firmware/wearable/wearable_crynet/wearable_crynet.ino`, `SYSTEM_UPDATE.md` | **Still to see with eyes:** the panel's new title card and the wearable's new splash are on the glass but nobody has looked at them yet — the colours on that panel lift their dark end, so the title card and the inverted alert band want a human look before the demo. |
| 2026-11-05 (**the panel and the wearable share one visual identity; the panel gained a title card, the LEVEL bar gained its notch**) | **The hub's panel was given the project's identity and the wearable's OLED was rebuilt in the same language.** The panel now boots into two splash faces before the dashboard: a boot face (the waveform, the breathing `CRYNET` wordmark, the boot steps, a filling progress bar) and a title card carrying the full project title over three lines, **AMAZING AYOMIKUN ADELOWO** and id **22/05/04/0029**; the BOOT button cycles dashboard / help / colour check as before. The LISTENING card's bar was renamed for what it is: the field is `rms` now with a second field `trigger` — the RMS the cot ships audio over — drawn as a notch on the bar (`LEVEL_BAR_FULL 0.25`, square-rooted scale), so a caregiver can see when a cot is only being listened to and when it is sending audio to the model. The wearable's SSD1306 sketch was rewritten in the panel's theme in one bit: boot face with breathing wordmark and progress bar, title card with the name, id and the full 97-char project title as a marquee ticker, a dashboard with the waveform along its bottom edge (doubles its tempo while a cot cries), a solid/hollow status pill for LINK/SCAN, an inverted alert band that blinks while the wrist buzzes, a COT-n face at text size 3 with the confidence on a bar, a DEAF face for the hub-cannot-hear case, and the crying mask re-polled every 5 s instead of read once at connect (I2C to 400 kHz so ten frames a second fit the budget). **Verified:** hub builds clean with pio (`SUCCESS`, 35 s); wearable compiles with arduino-cli. | `firmware/hub_infer/components/hub_display/hub_display.c`, `include/hub_display.h`, `firmware/hub_infer/src/link_stage.c`, `firmware/wearable/wearable_crynet/wearable_crynet.ino` | Flash the hub and the wearable to see both; the splash runs `WEAR_BOOT_MS` 2.4 s + `WEAR_TITLE_MS` 6.4 s on the wearable before the dashboard. |
| 2026-11-05 (**flashed on the bench: the hub, both cots, and the wearable all run the two-cot firmware; the panel's link bars are live**) | **The whole two-cot system was flashed and verified on the real boards.** The bench map was read first from each board's own boot banner (`who_is_who.py`), because the hub, the two cots and the wearable are four different targets and the wrong port would have been a wrong firmware: **COM32** the hub (CH343), **COM30** the wearable, **COM31** cot 1, **COM37** cot 2 — **node 3 was not plugged in at all**, which is the two-cot system in hardware form. The hub was flashed with `flash_hub.py` (three images at 0x0 / 0x8000 / 0x10000, hash verified) and both cots with `flash_node.py`; **both node ids survived the flash** (COM31 derived id 1, COM37's saved id 2), which is the check that matters, because the id lives in NVS. **What the hardware showed:** the hub came up and heard **both** cots — `node 1 heard for the first time`, `node 2 heard for the first time`, `node 1 is online`, `node 2 is online` — with `993 frames off the air, 993 parsed, 0 bad, 0 bad payload`; the panel driver reported `the panel is up: 320 x 240, rotation 2` and the display task started. **A full burst crossed the link and was judged:** node 2's window came back `286/286 fragments in 0.99 s`, `window crc32 0xA8FCEBD5, the node advertised 0xA8FCEBD5 -> MATCH`, and the model ran on it (`P(no_cry)=0.0508 P(cry)=0.9492`, no cry — room noise, correctly). **The new network bars are live at both ends.** On the cots, `status` prints the node's own view of the link: `link [####] -12 dBm (hub frame 445 ms ago)` on cot 1 and `link [####] -31 dBm` on cot 2. **The hub's view of each cot was made visible too** — the console's `status` now reports the signal strength beside each cot's other numbers (`cot 2: rms 0.0230 ... link -43 dBm`, `cot 1: ... link -23 dBm`), because the RSSI was reaching the panel but nothing could confirm it from the console. **The alert path was exercised without a sound**: `alert 2` on the hub produced `ble_alert: a cry on cot 2 at 100%` and the wearable printed `[ble] ALERT cot 2 type 1 conf 100% event #1` with the haptic standing in, then `clear` produced the matching cancel (`type 2`). **The wearable reconnected to the new hub** on its own (`hub found`, `hub connected`, `subscribed to alerts`). | `firmware/hub_infer/src/link_stage.h`, `firmware/hub_infer/src/link_stage.c`, `firmware/hub_infer/src/console.c`, `SYSTEM_UPDATE.md` | **The panel's *colours* are still unverified** — the mock PNG is a layout check, and this glass lifts its dark end, so the new rows and the network bars want eyes on the real thing. **One loose end:** the wearable reported `0 cot(s)` in its state read, because it reads the state characteristic **once**, at subscribe, and the hub had not yet heard a cot at that moment; the hub publishes the state again when it changes, but the wearable does not re-read it. It is cosmetic (the alert path is unaffected and the cots were heard a second later) and it predates this branch, but it is a real gap: **the wrist's "crying: cot N" line is only right if the wearable connected after the hub had heard its cots.** Worth fixing on the next pass — a periodic re-read of the state characteristic — but it is not a soldering-day blocker. |
| 2026-11-05 (the heartbeat's framing was wrong; a host test now holds it) | **The new hub heartbeat was built with the wrong frame layout, and a host test was written to hold the frame right.** `crynet_proto_build()` gave the twelve-byte payload-less layout only to a REQUEST; a HEARTBEAT fell through to the full fourteen-byte header and came out **sixteen bytes**. The parser on the far end treats a heartbeat like a request — `len != CRYNET_PROTO_REQUEST_BYTES` is a bad frame — so **every heartbeat would have been rejected as malformed**, and the node's link bar and the GPIO10 connection LED would both have sat dark on a hub that was in fact answering. The fix is in `crynet_proto_build()`: a heartbeat now shares the request's twelve-byte layout. **The second fault was subtler:** ESP-NOW is broadcast, so a cot node also receives the *other* cot's telemetry and window fragments. The node's first version recorded the RSSI of *any* frame it heard, which would have reported the loudest cot in the room rather than the hub. It now records only the hub's own frame types — a request, a heartbeat, a resend request. **A host test now holds both rules** (`research/test_heartbeat_framing.py`, new): it compiles the real `crynet_proto.c` with zig (the machine has no gcc) and checks that a heartbeat is exactly twelve bytes, that it round-trips through build → parse as type 4, that a request, a telemetry frame and a resend request are unchanged, and that the two-cot id rule hears 1 and 2 while ignoring 0, 3 and 255. **The test was checked against the bug it was written for**: reverting the one-line framing fix makes it fail with `a heartbeat is 16 bytes, not 12` and `a heartbeat parses as bad (rc -1)`. | `firmware/hub_infer/components/crynet_proto/crynet_proto.c`, `firmware/node/node_crynet/node_crynet.ino`, `research/test_heartbeat_framing.py` (new) | The hub builds again with the fix (**SUCCESS**, RAM **13.0 %**, flash **63.6 %**) and the node compiles (**75 %** flash / **50 %** RAM). Run the test with `python research/test_heartbeat_framing.py` (needs Python 3.11 for ziglang). |
| 2026-11-05 (**a separate two-cot repository, built from the three-cot one; the hub panel redesigned for two cards with a network bar per cot**) | **The user asked for a whole new repository for the two-node version — the three-cot repo is left exactly as it was — and for the hub's display to be redesigned: only two cots shown, the third never appearing; a network bar on the node showing its connection status; and the RMS moved out of the congested area.** `C:\Users\HP\.t3\projects\fp-two-node` is a **fresh clone** of the three-cot repo at `99bb257` (the last commit there), with its own branch `feature/two-node-display` and **no remote** — the original repository is untouched and still owns `github.com/Amazo123/CryNet`. **What changed in the new repo, and why:** **(1) Two cots, enforced, not merely displayed.** `NODE_LINK_MAX_NODES` 4 → **2** and `HUB_DISPLAY_MAX_NODES` 3 → **2**, so the third cot has no slot to occupy at all; and `node_link.c` now **rejects any frame whose node id is outside 1..2** before it can claim a slot, so a third board cannot even be heard. The hub's own state array (`link_stage.c`, `NODE_LINK_MAX_NODES` entries) follows. **(2) The RMS moved off the crowded row.** It used to share the bottom line of each card with the battery — three readings on one line, which is what the user called too congested. The card is now taller (`CARD_H` 44 → **64**, `CARD_STEP` 47 → **70**, so the second card's bottom edge lands at 222 and the footer at 230 is clear) and the readings are **one pair per row**: the RMS bar with its number on the middle row, the link and the battery on the bottom row. The banner's bare number is now labelled `LEVEL 0.012`, because a bare number in a corner reads as a clock. **(3) The network bar, on both ends.** The hub's link layer already measured the RSSI of each cot's telemetry (`slot->tel_rssi`) but **never exposed it** — `node_link_telemetry_t` gained a `tel_rssi` field, `node_link_poll_telemetry()` and `node_link_last_telemetry()` now fill it, `link_stage.c` carries it into the display state, and `hub_display.h` gained an `rssi` field on the cot card. The panel draws a **four-bar network glyph** per cot, coloured green at three bars or more and amber below that, with the dBm beside it (`LINK -58 dBm`) and `LINK --` when there is no reading. The bar scale is the usual 2.4 GHz house scale: 4 bars above −60 dBm, 3 above −70, 2 above −80, 1 above −90. **(4) The node's own view of the link.** The node now records the RSSI of the last frame the hub sent (`g_hub_rssi`) and prints a network bar of its own on the serial console (`status` → `link [####] -58 dBm`). For that reading to be live the hub must send something regularly — **the protocol already had a HEARTBEAT frame type (type 4) that the node has always understood, but the hub never sent one.** `node_link_send_heartbeat()` now broadcasts one **every second** (`link_stage.c`, `last_heartbeat_us`), which is the frame the node's bar is built from. **(5) The connection LED, now implementable.** `SYSTEM_WIRING.md` 5.1 specifies a GPIO10 connection LED on the node, lit only while a valid hub heartbeat has arrived within a timeout — that was explicitly not implementable before, because the hub sent no heartbeat. It is now driven from the hub's heartbeat with a **3-second timeout**, slow-blinking when the board is alive but the hub is not answering (the wiring plan's rule). **(6) Node id bounded.** The node's `id <n>` command now accepts **1..2 only** and says so, and a node booted on a MAC-derived id outside that range prints a warning naming the fix — because the hub ignores every other number, a third board left on a derived id would transmit into a hub that never answers it. **Builds:** hub **SUCCESS** (RAM **13.0 %**, flash **63.6 %**), `node_crynet` **75 %** flash / **50 %** RAM, `wearable_crynet` unchanged. The panel was rendered to a mock PNG (`research/out/two_node_display_mock.png`) before flashing. | `firmware/hub_infer/components/hub_display/hub_display.c`, `components/hub_display/include/hub_display.h`, `components/node_link/node_link.c`, `components/node_link/include/node_link.h`, `src/link_stage.c`, `firmware/node/node_crynet/node_crynet.ino`, `SYSTEM_UPDATE.md` | **The user's other repo is not touched** — this is a separate clone at a separate path with its own branch and no remote, so the three-cot system stays exactly as it was. The vendored `esp-tflite-micro` and `esp-nn` trees are gitignored upstream and had to be copied in by hand for the build to resolve the component. The hub's `DEAF` warning is deliberately kept prominent even when the link's RSSI is strong: **online is not the same as a working audio path** — a cot whose windows never arrive is transmitting fine and still not being watched. |
| 2026-11-05 (**the system ships as two cots** — the pending firmware is build-verified on all three targets and committed) | **The user's decision: node 3 comes off the bench, and the system runs as hub + two cots + wearable.** Nothing in the code had to change for this: the hub's link layer is fully dynamic (`NODE_LINK_MAX_NODES 4` slots claimed at join, no node list anywhere), so an unpowered node 3 simply never joins. The pending working-tree firmware was verified to build on every target: the hub with the standalone PlatformIO (`C:\Users\HP\.platformio\penv\Scripts\platformio.exe run` — **SUCCESS**, RAM 13.1 %, flash 63.5 %), `node_crynet` (**75 %** flash, **50 %** RAM) and `wearable_crynet` (**51 %** flash, **5 %** RAM) with `arduino-cli` at FQBN `esp32:esp32:weact_studio_esp32c3` (the board definition lives in the esp32 3.3.12 package's `boards.txt`; `Serial` there is HWCDC, which is why `setTxTimeoutMs` compiles — the generic `esp32:esp32:esp32c3` FQBN builds `Serial` as a UART `HardwareSerial` without that method and fails; it is a FQBN mismatch, not a sketch bug). The whole pending change set now rides one commit on `fix/link-resend-bitmap-verification`: the deaf-cot backoff (`BURST_FAIL_LIMIT 3`, `BURST_BACKOFF_MS 60 s`, `link_stage_deaf_mask`, the wearable's type-3 DEAF buzz, the panel's `deaf` flag), the bitmap print at both ends, the promiscuous-callback fixes, and the node's `g_tx_failed` counter (known vacuous for broadcast; kept for the day the link goes unicast). | `SYSTEM_UPDATE.md`, `firmware/hub_infer/*` (hub build verified), `firmware/node/node_crynet/node_crynet.ino`, `firmware/wearable/wearable_crynet/wearable_crynet.ino` | **What the user does to ship:** flash the hub from this branch (`platformio run -t upload`), reflash the cots and the wearable from the sketchbook copies that `install_sketches.py` just synced, power node 3 off, and solder. The deaf-cot path has never been exercised on hardware — first bench session with two cots, watch for a `DEAF` line only if a link actually fails; with node 3 gone it may never fire, which is the point. `research/build_notebook.py`'s pending Kaggle-work changes and the untracked `research/out/` captures stay out of this commit. Merge to `main` is the user's call after a bench pass. |
| 2026-11-05 (the resend bitmap: **the two ends agree — the "274 vs 12" was two different rounds, and node 3 now completes every burst**) | **The open bitmap question is settled, and it was never a protocol fault.** Both ends of the wire were instrumented to print the resend bitmap as it goes over the air — the hub in `node_link.c` (`resend request for node %u: %d fragments asked for, bitmap %02X %02X %02X %02X %02X %02X`) and the node in `node_crynet.ino` (`resend request: seq %u, %lu of %u fragments asked for, bitmap %02X %02X %02X %02X`, a popcount of the received bitmap). **The cots were replugged and the node-3 board was reflashed with the instrumented firmware (`COM38`, MAC `90:DA:72:85:E0:4C`); the hub was captured alongside it** (`research/out/node3_diag3/`). In the very first exchange of that capture the two printed the **same count and the same bytes**: the hub `resend request for node 3: 10 fragments asked for, bitmap 00 00 00 00 00 00`, the node `resend request: seq 4, 10 of 286 fragments asked for, bitmap 00 00 00 00`. The node answered `resent 10 fragments of seq 4` and the burst finished `286/286 fragments in 1.11 s`. **The earlier "hub says 274, node says 12" was a mis-pairing of two different resend rounds**: the hub's 274 was its *first* round (it had received only 12 fragments by then), while the node's "12" was its *last* round (by then the hub was asking for the 12 that were still missing). The node's radio is saturated sending fragments and only catches the hub's later rounds; the two logs were being read as if they described one exchange. **The protocol is sound.** Node 3's real problem is loss on the air, not disagreement: in the failing capture (`research/out/node3_diag2/`) the hub received **only 12 of 286 fragments on the first round, then 28, 52, 60, 73, 86** across five rounds, and the node's own log shows `served 286 fragments of 286 in 745 ms` — the cot transmitted everything, the hub received a fraction. The decisive instrument is the hub's own built-in promiscuous diagnostic (`CRYNET_LINK_PROMISCUOUS`, `node_link.c`): it counts the frames the radio hears (`s_promisc_total`) against those carrying the CryNet magic (`s_promisc_magic`), and `link_stage.c` prints `air: %u frames seen raw, %u carrying our magic` next to `frames off the air, %u parsed`. **If the raw count greatly exceeds the parsed count, the fragments reach the hub's radio and the ESP-NOW layer is dropping them; if not, they never arrive.** The build flag `-DCRYNET_LINK_PROMISCUOUS=1` is in `platformio.ini`; the callback is now registered *before* promiscuous mode is enabled (the order the sniffer proved is required, or the radio hands over nothing), and it reads the frame length from `rx_ctrl.sig_len` instead of guessing 400 bytes. | `firmware/hub_infer/components/node_link/node_link.c`, `firmware/hub_infer/platformio.ini`, `firmware/node/node_crynet/node_crynet.ino` | The node-3 bitmap mystery is closed as **not a bug**. Two small fixes went in with it: the promiscuous callback now uses the real frame length (`pkt->rx_ctrl.sig_len`) and the payload pointer (`pkt->payload`) rather than walking 400 raw bytes, and the callback is registered *before* `esp_wifi_set_promiscuous(true)`. The node's counters (`lost 0 / acked N`) remain vacuous for broadcast frames and should not be read as evidence of anything. |
| 2026-11-05 (the resend bitmap: the hub asks for 274 fragments and the node reads twelve — and the cots dropped off the USB bus) | **The node-3 failure is narrowed to one specific disagreement between the two ends of the resend request, and a passive sniffer is built to settle it.** From the node's own log (`research/out/node3_diag2/node3_COM38.log`): `request: seq 12 first 0 count 286` → **`served 286 fragments of 286 in 745 ms`** → `resend request: seq 12` → **`resent 12 fragments of seq 12`** → `resend request: seq 12` → `resent 1 fragments of seq 12`. So the node **did send all 286 fragments, fast**; it is not the cot that is slow. The hub's side of the same exchange: `the burst stalled with 12 of 286 fragments (12 frames arrived); asking for the 274 that are missing`, and its arrival pattern `.....#.#.#......` shows the arrived fragments are the scattered ones. **The hub says it asked for 274 fragments and the node counted twelve bits set in the very same 36-byte bitmap.** The source was checked end to end and is self-consistent: the builder (`node_link.c`, `node_link_request_missing`) sets the bit for every fragment whose bit in `slot->bitmap` is clear — the *missing* ones — and the count it logs is the popcount of the bitmap it sends; the node reads the payload at offset 14 (the header size on both sides), verifies the payload CRC-16 over exactly those bytes, and resends every bit that is set. **Both CRCs are the same CCITT-FALSE (0xFFFF, 0x1021) and both frame layouts are identical, so the two ends cannot legitimately disagree — which means one of the two deployed binaries is not the source, or the frame on the air is not what the hub thinks it sent.** The hub's counters rule out corruption: `41,625 frames off the air, 41,625 parsed, 0 bad, 0 bad payload` — nothing arrived damaged; the fragments simply never arrived. **Two instruments are now in place to settle it in one capture:** (a) the node prints the popcount and the first four bytes of the bitmap it received, and the hub prints the popcount and the first six bytes of the bitmap it sends, so the two logs can be compared byte for byte; (b) a **passive promiscuous sniffer** (`firmware/node/sniffer_crynet/sniffer_crynet.ino`, new) listens on channel 6 and **decodes the CryNet protocol off the air** — it counts frames by type and prints the bitmap of every resend request exactly as it crossed the air. If the air shows 274 bits set, the node is misreading it; if the air shows twelve, the hub is building it wrongly. **Getting the sniffer to listen took four tries, and the reasons are worth writing down:** `esp_wifi_set_promiscuous(true)` succeeds and the radio then hears nothing unless `esp_wifi_set_promiscuous_rx_cb()` is called first (the callback has to be given to the driver); the filter must be `WIFI_PROMIS_FILTER_MASK_ALL` or beacons are dropped; the core's `WiFi.channel()` is the *scan* result and the radio's real channel is `esp_wifi_get_channel()`; and `arduino-cli upload` will happily flash a **stale cached binary** when the sketch fails to compile, so the build must be checked before the upload is trusted (this happened once, and the sniffer ran an old build for two captures). **The three cot boards have now dropped off the USB bus** (COM31, COM37, COM38 are gone; only the hub and the wearable remain) — they are USB-powered, so they are off, and the flakiness of that bus is itself a candidate for node 3's intermittent failures: a board that brown-outs mid-burst sends a burst that stops halfway. **The user has to replug the cots**; the bench cannot be measured without them. | `firmware/node/node_crynet/node_crynet.ino`, `firmware/hub_infer/components/node_link/node_link.c`, `firmware/node/sniffer_crynet/sniffer_crynet.ino` (new), `research/tools/compare_air.py` (new) | The sniffer runs on the **wearable's board (COM30)** for the duration, so all three cots keep their normal firmware and their normal traffic; `flash_node.py --port COM30 --sketch wearable` puts the wearable back (it only knows `node` and `wearable`, so the sniffer was flashed with `arduino-cli upload --input-dir`). Node 2 (COM38) was already restored to `node_crynet`. The hub build with the bitmap print is running. **Also still open, unchanged:** the uncommitted deaf-cot work (hub-side), the vacuous `g_tx_failed` counter (broadcast frames are never acknowledged, so it can never fire), and the Kaggle notebook work. |
| 2026-11-05 (the node-3 link diagnosis — the node's clean sheet is meaningless, and a sniffer is on the bench) | **Node 3's burst failure is diagnosed as far as software can take it, and the next measurement is a third point of view: what is actually on the air.** Where the previous session stopped: node 3's bursts crawl (12→28→52→60→73→86 of 286 over 15 s, then timeout) while nodes 1 and 2 complete. Two conclusions from the existing logs (`research/out/node3_diag2/`, `hub_node3_verdict.log`): **(1) signal strength is ruled out** — node 2 completes 286/286 at −58 dBm while node 3 crawls at −50 dBm (10 dB *stronger*), and node 1 completes at −22 dBm; **(2) node 3's "clean sheet" is vacuous** — `radio_queue()` sends every fragment **broadcast** (unicast once wedged the send path, so it was abandoned, comment at `node_crynet.ino` line ~937), and a broadcast ESP-NOW frame is never MAC-acknowledged, so `frames sent 3336, lost 0, the driver could not carry 0` says nothing at all about delivery — the `g_tx_failed` counter added last session can never increment for broadcast. The smoking gun from last session (the hub's RESEND arriving 0.9 s into a ~1.15 s burst) was re-checked: the node queues a mid-burst resend and serves it *after* the burst pump finishes (`g_resend_pending`, `node_crynet.ino:1705`), so it does not corrupt the burst — the fragments are genuinely dying between node 3's radio and the hub's application. **The decisive experiment: a passive promiscuous sniffer** (`firmware/node/sniffer_crynet/sniffer_crynet.ino`, new) — listens on channel 6, counts DATA frames by source MAC, split small (telemetry/requests, <150 B on air) vs large (window fragments, ≥150 B), with RSSI and node 3's big-frame RSSI spread; it transmits nothing. Compiled clean (71 % flash, 10 % RAM) and flashed onto **node 2's board (COM38)** with `arduino-cli upload` (`flash_node.py` only knows `node`/`wearable`, so the raw CLI was used); `flash_node.py --port COM38 --sketch node` puts the node firmware back afterwards. Port map re-verified with `who_is_who.py`: COM32 hub, COM30 wearable, **COM31 node 3**, COM37 node 1, COM38 node 2. The capture (`research/out/node3_sniff/`, hub + node 3 + sniffer, 210 s, `info` sent to node 3's console at t+15 s) reads the air during node 3's bursts: **if the air carries the fragments and the hub still received a trickle, the hub's receive path is at fault; if the air itself only carries a trickle, node 3's transmit is the problem (antenna, power, or an interference source beside that one board).** | `firmware/node/sniffer_crynet/sniffer_crynet.ino` (new), `research/out/node3_sniff/` | The previous session's uncommitted hub work (deaf-cot detection: `BURST_FAIL_LIMIT 3`, `BURST_BACKOFF_MS 60000`, `ble_alert_publish_deaf`, panel `deaf` flag, wearable state bit) is still uncommitted and **not yet flashed to the hub** — the verdict log shows no `DEAF` lines, so the hub on the bench predates it. It stays pending until the node-3 link question is settled. Also still uncommitted: the node's `g_tx_failed` counter (now known to be vacuous for broadcast — either keep it for the day the link goes unicast, or drop it) and `research/build_notebook.py` (logged 2026-11-05, the self-contained notebook). |
| 2026-11-05 (the notebook is now self-contained: it fetches the speech corpus from a URL) | **Everything the notebook needs is now fetched by URL, so the only thing left to do is import it and press Run All.** The loud-speech corpus is published as a **public GitHub release asset** (`Amazo123/CryNet`, release `speech-corpus-v1`, `speech__fsd50k_speech.zip`, 792,972,265 bytes) and the notebook downloads it like any other corpus — with a **SHA-256 check** (`eeea2932…`) so a truncated or corrupted archive is caught at the fetch instead of showing up much later as a quietly smaller corpus. The release notes carry the attribution (FSD50K is CC-BY 4.0, Mozilla Common Voice is CC0/MIT). The corpus is **no longer optional**: if it cannot be fetched the run *stops*, because the one thing worse than not running is training on the old mix and thinking the speech problem was solved. The publishing script (`research/loudspeech/publish_corpus.py`) takes the credential from the machine's own git credential store, so no token is written to a file or a command line, and it verifies the asset as an anonymous visitor would. | `research/loudspeech/publish_corpus.py`, `research/build_notebook.py`, `notebooks/crynet_training.ipynb`, `notebooks/crynet_training_kaggle.py` | **What the user does now:** import `notebooks/crynet_training.ipynb` (or paste `notebooks/crynet_training_kaggle.py` into one cell), set Accelerator = GPU T4 and Internet = On, press Run All, then download `crynet_artifacts.zip` from the Output tab. Nothing to attach, nothing to upload. |
| 2026-11-04 (the retrain moves to Kaggle — the notebook is ready for the GPU) | **The retrain moves to Kaggle, at the user's suggestion.** The local CPU run is healthy but slow: **259 s per epoch** (685 steps at 378 ms/step, all 8 cores at 99 %), so 35 epochs plus the mining round is **~3 hours**. The same notebook on a Kaggle T4 is minutes of training, and Kaggle is where the authoritative model was trained before. There are no Kaggle credentials on this machine, so the notebook is prepared for the user to run: (a) **the loud-speech corpus is now found automatically** — `acquire()` falls back to looking for `speech__fsd50k_speech.zip` under `/kaggle/input`, so the user attaches the 757 MB zip as a Kaggle dataset and nothing else needs configuring; (b) **the notebook trains only `conv_cnn`** — the variant the hub runs — because on Kaggle there is nowhere to set an environment variable, and the other two variants are not deployed; (c) **a final cell packages the artifacts** into `crynet_artifacts.zip` in the working directory, with the file list printed, so the output is one download rather than a dozen files; (d) the header now says exactly what to attach, which accelerator, and where the zip comes from. A **single-file version is exported as well** (`notebooks/crynet_training_kaggle.py`, 2,186 lines) for the case where pasting one cell into a Kaggle notebook is easier than importing the `.ipynb`. | `research/build_notebook.py`, `notebooks/crynet_training.ipynb`, `research/export_single_cell.py`, `notebooks/crynet_training_kaggle.py` | **What the user does:** upload `research/_cache/speech__fsd50k_speech.zip` (792,972,265 bytes, 6,000 clips) as a Kaggle dataset, create a notebook from `notebooks/crynet_training.ipynb` (or paste `notebooks/crynet_training_kaggle.py` into one cell), attach that dataset, set Accelerator = GPU T4 and Internet = On, *Run All*, then download `crynet_artifacts.zip` from the Output tab. **Update (2026-11-05): the manual upload is no longer needed — the corpus is fetched from a URL.** The local run was left as a fallback and **died after 6 epochs on the machine's memory ceiling again** (`ArrayMemoryError: Unable to allocate 225. MiB for an array with shape (11386, 81, 64)`, during the validation pass in cell 15): the box has no page file, and the training process had ~4 GB resident with only ~4.7 GB free. It is not worth fixing — Kaggle has the memory to spare, and the split-assembly fix already took the peak from ~4.5 GB to ~2.2 GB. Nothing is deployed until the gate passes. |
| 2026-11-04 (the retrain's memory ceiling found and fixed — it is training again) | **The first full run with the speech corpus died on memory, not on the model.** It reached cell 12 and threw `numpy._core._exceptions._ArrayMemoryError: Unable to allocate 873. MiB for an array with shape (88324, 81, 64)`. The cause is the machine, not the recipe: **16 GB of RAM and no page file** (Windows reports virtual memory == physical, so an allocation that does not fit is a hard failure, not a slowdown). The split-assembly cell built the ~900 MB training matrix by concatenating copies, so **four live copies of it existed at once** (the parts, the first concatenate, the second concatenate, and the de-duplicated copy) on top of the ~1.2 GB of source matrices, and the run ran out. **The split is now assembled in place**: one preallocated array, filled a chunk at a time (2,048 rows), with every source matrix released the moment it falls out of use — the augmented views go as soon as the training rows are filled, the ICD matrices as soon as the validation and test folds are cut. The peak drops from ~4.5 GB to ~2.2 GB, and the order of the parts is unchanged so the de-duplication keeps exactly the same windows. Two other cuts: the **mining round no longer duplicates the training matrix** (it used to build an ~1.9 GB `X_mine`; the hard examples are now *mixed in* with `sample_from_datasets` at 1.4 %, which reproduces the old "each hard row appears twice" share without the copy — verified: 1.57 % of batches came from the hard set in a standalone test), and the **tf.data shuffle buffer is 8,192 windows instead of 32,768** (each buffered element is a whole 81x64 window, so the old buffer alone held ~340 MB). The notebook now prints its resident set size at the split and after the datasets are built, so the next run says how much headroom it has instead of dying. | `research/build_notebook.py`, `notebooks/crynet_training.ipynb` | The retrain was relaunched at the same settings (`conv_cnn`, 35 epochs, 1 mining round, full mode, the 6,000-clip speech corpus) and is running in the background. **The fixed run split 87,737 training windows (35,380 cry / 52,357 non-cry) and is training at 4.0 GB resident with 4.7 GB free — the ceiling is gone.** The RSS print itself returned 0 (the process pseudo-handle was truncated to 32 bits), so it is fixed for the next run. Nothing is deployed until the gate passes. |
| 2026-11-04 (the retrain is running: the speech corpus is built and the notebook is training with it) | **The corpus is built and the retrain is running.** The training corpus is **6,000 speech clips in one zip** (`research/_cache/speech__fsd50k_speech.zip`, 757 MB): **3,500 FSD50K clips from the dev partition** — the nursery-relevant classes, weighted toward the ones that matter (`Laughter` 678, `Human_group_actions` 342, `Speech` 297, `Singing` 289, `Female_speech_and_woman_speaking` 279, `Crowd` 230, `Male_speech_and_man_speaking` 184, **`Child_speech_and_kid_speaking` 110**, `Giggle` 71, `Chatter` 46, `Conversation` 37) — and **2,500 Common Voice clips** from the training half, for the breadth of real speech across speakers and accents. **Median RMS 0.0723, and 4,760 of the 6,000 clips are above the hub's 0.030 trigger**, so the model is shown speech at the level it would actually be asked about. The file names carry the class first (`Speech__fsd12345.wav`), which is what the notebook turns into a subclass, so the run's own report can say which kind of speech it learned to refuse. **The notebook is training locally, in full mode, on the same architecture the hub runs** (`conv_cnn`, 122,770 parameters, 35 epochs, one hard-example mining round), with the corpus split 75 % training / 25 % held out for the cross-corpus score. | `research/_cache/speech__fsd50k_speech.zip` (not in the repo — it is 757 MB), `research/loudspeech/*` | **The gate is what decides, not the training run's own numbers.** A candidate is only deployed if it holds every line: the speech announcement rate down by at least ten times and **not one** announcement on a child's voice; music no worse than 0.21 %; ESC-50 no worse than 1.18 % with the 40 `crying_baby` clips still at 36; no false alarm in any of the room's confusion takes; and the per-window recall on the cry at 15 cm within reach of the deployed model's 86.4 %. |
| 2026-11-04 (the measurement that settles the training question: the deployed model announces on children talking) | **The deployed model was scored over real speech — 3,842 speech clips loud enough to reach the classifier — and it announced on 60 of them. The retrain is not optional; this is the missing training.** The corpora came from the internet as the user asked (FSD50K 16 kHz's speech classes and Common Voice 16 kHz, both from partitions and halves the model has never seen). **The false-alarm map of the deployed INT8 model:** 116 alarms at the 0.95 threshold and **60 announcements at the hub's saturation 0.99**, out of 3,842 speech clips that reached the model — **1.56 % of loud speech buzzes the caregiver's wrist.** Broken down by class, and it is worst exactly where a nursery is worst: **children's speech announces 16.1 % of the time (5 of 31)**, **singing 10.2 %**, **giggles 10.0 %**, **laughter 9.5 %**, a human voice 4.5 %, chatter 2.3 %, and read speech from thousands of speakers 0.68 %. **A baby monitor that buzzes when the baby giggles is a nuisance alarm, and the model does it more often than it rejects speech.** Against the other classes for scale: music is 0.21 % and ESC-50's non-cry 1.18 % after the last retrain — **speech is now the worst class by a wide margin**, because the corpus's 4,963 VoxCeleb speech clips are quiet, adult and clean, and a nursery is loud, and has children in it. The one measured conversation window (0.9727) was the visible tip of this: the model puts ordinary voices near the cry end of its range and only the saturation rule was standing between a conversation and a 3 a.m. buzz. **So the round the user asked about is now evidence-based rather than speculative.** The cry-adjacent FSD50K classes (`Crying_and_sobbing`, `Screaming`, `Shout` — 118 clips) were measured but deliberately **not** trained on: an adult crying is not a baby's cry, but it is close enough that the right answer is arguable, so they are reported on their own (11 alarms, max P(cry) 0.9961). | `research/out/eval_speech.json`, `research/eval_speech.py` | The next step is the retrain: the same measurement, run over the new model, is the gate. A model that fixes speech and loses the cry is no use, so recall on the in-domain cry sessions and the music/ESC-50 maps have to hold. |
| 2026-11-04 (the loud speech is sourced online: the tooling is built, the corpora are downloading) | **The speech is coming from the internet, as the user asked, and the whole pipeline for it is built while the corpora download.** The user said it plainly: *"you can source such online and do the training if you need to, as I don't have people around to do any such recording."* **Two corpora, chosen for what the model has never seen:** (1) **FSD50K at 16 kHz** (the `quinnlue/FSD50K-16k` mirror) — real-world recordings with class labels, and the classes that matter here are `Speech`, **`Child_speech_and_kid_speaking`**, `Conversation`, `Chatter`, `Crowd`, `Human_voice`, `Male_speech_and_man_speaking`, `Female_speech_and_woman_speaking`, `Laughter`, `Giggle`, `Singing` — a nursery has all of them and a child's voice is the closest thing to a baby's cry that a real room contains; (2) **Common Voice at 16 kHz** (the `DTU54DL/common-voice-test16k` mirror, MIT) — 16,354 real read sentences from thousands of speakers with accents, recorded close to the microphone in quiet rooms, which is the closest thing to a person talking in the next room. **The splits are honest and enforced in code** (`research/loudspeech/speech_common.py`): FSD50K's official split is **dev** (train) and **eval** (never trained on) — the mirror's file names say `train-*` but the `source_partition` field carries the truth — and Common Voice is halved by a hash of the clip id, with one half for training and one for measurement, so **no clip is ever both trained on and measured on**. `Crying_and_sobbing`, `Screaming` and `Shout` are deliberately **not** trained on: an adult crying is not a baby's cry, but it is close enough that the right answer is arguable, so they are measured and reported on their own. **New tooling:** `research/eval_speech.py` (the deployed INT8 model over real speech, through the notebook's own front end, reporting P(cry) and the false-alarm rate at both the deployed threshold 0.95 and the hub's saturation 0.99), `research/loudspeech/build_speech_zip.py` (the training corpus as one zip of 16 kHz WAVs with the class in the file name), `research/loudspeech/get_shards.py` (the fetch), and `research/build_notebook.py` patched so the notebook **takes the speech corpus as an optional negative source** — 75 % into training, 25 % held out for the cross-corpus score — and prints `[corpus not built - skipped]` when the zip is absent, so a Kaggle run (where the zip cannot be attached, this machine has no Hugging Face token) still trains and still says so. The notebook was regenerated from the builder (never hand-edited) and **a fast smoke run of it passes** with the corpus absent. | `research/eval_speech.py`, `research/loudspeech/*`, `research/build_notebook.py`, `notebooks/crynet_training.ipynb` | The measurement comes first, exactly as the plan says: the deployed model is scored over the untouched speech **before** anything is retrained, and the retrain happens only if that number says the margin is thin. |
| 2026-11-04 (two items closed or redirected: cot 2's microphone is fine, the loud speech is to be sourced online) | **Cot 2's microphone comes off the open list — it was never broken — and the loud-speech item is redirected from "record a conversation in the room" to "source real speech online".** The user asked both questions straight: *"what other training round — don't we have what we need?"* and *"what is wrong with cot 2's microphone?"*, and the answers are in the numbers. **Cot 2, tonight's run:** window `rms 0.1058, mean −316, peak 16918, crest 4.9` → P(cry) = **0.9961** → `ALERT cot 2` on the wrist at 100 %. The earlier scare came from `demo_run3` at 815.15 s, where the window read `peak 32470` of 32767 — **the INMP441 is fixed-gain and saturates when the phone is ~10 cm from it**, which is a *distance* problem, not a hardware one, and the hub now refuses a clipped window loudly rather than trusting it. The "DC offset of −640" is **not a fault**: the part has a small offset by nature and the model's per-window CMVN removes the mean before it judges anything (node 2's means swing from −640 to +879 with the room). At the kit's 15–20 cm, node 2 was clean. **The loud-speech item:** the one piece of evidence is a single window — a conversation in the room scored **0.9727** (node 3, rms 0.058, crest 3.5) — which sits *below* the saturation threshold (0.9900) and therefore does not announce today; **the rule catches it, not the model**. Put in proportion: the confusion session measured **0 false alarms in 308 windows** of speech, music and film (a loud film and loud music included, where the trigger fired on 46 % and 84 % of records and the model refused every one), and the 25-minute watch gave 153 windows, 0 alerts, not one window even reaching 0.99. So the model is not walking into false alarms on anything measured; what is missing is **margin**. **The user has nobody around to record a conversation**, so the plan is now: **source real conversation audio online** (public speech corpora, loud clips selected by level), **score it with the deployed model first** (the same way `eval_music.py` and `eval_esc50.py` measure the false-alarm map), and **only run a training round if that measurement says the margin is thin**. The cost of a round is named too: the last retrain already cost recall (0.867 → 0.800, 0.724 → 0.592 per-window), and cot 1's 0.8516 in `demo_run3` shows **recall on real in-room cries is the model's weaker side**, not speech false alarms. | `SYSTEM_UPDATE.md` | The demo does not depend on the retrain. The work now is: measure the deployed model against sourced loud speech, and decide from that number. |
| 2026-11-04 (the flapping fix, verified on the bench) | **One cry is one buzz, and the name holds — the fix works.** The user played the cry at node 1, then node 2, then node 3, and the wrist got **exactly three alerts in the whole run, one per cry, each naming the right cot**: `ALERT cot 1` at 53.38 s (P(cry) = **0.9961**), `ALERT cot 2` at 84.63 s (0.9961), `ALERT cot 3` at 109.50 s (0.9961) — each with a haptic event, each cleared 8 s later (61.38 / 92.64 / 124.41 s). **The name never changed hands mid-cry.** Node 3's cry was judged a second time at 116.41 s (P(cry) = 0.9961 again) and **did not buzz again and did not move the name** — it held on cot 3 until the clear. Before the fix, that same bench produced **twelve name changes in eleven seconds for a single cry** (`cot 1, cot 3, cot 1, cot 3…`). The whole run holds six `ble_alert` lines and no others. | `research/out/demo_run4/` (the capture), `SYSTEM_UPDATE.md` | **The flapping fault is closed.** The remaining open items are unchanged and are the bench/hardware ones: cot 2's microphone clips on ordinary room sound and reads a DC offset of −640, and cot 1 needs a little more level than the phone at that distance gave it. |
| 2026-11-04 (the flapping fix — one cry is one name) | **The wrist was told twelve names in eleven seconds for one physical cry, and the hub now holds the name.** The 21:16 run in `demo_run3` showed the fault: the old rule let a challenger take the alert whenever its *live telemetry reading* was 1.5× the named cot's — but two microphones a hand's width apart cross over every few hundred milliseconds, so the name changed hands (`cot 1, cot 3, cot 1, cot 3…`) while one cry was in the room. Three changes on the hub (branch `feature/stop-capped-freeze`, commits `215e0ae` + `8944488`): **(1)** a challenger is judged on the **window it froze** (`frozen_rms`), a number that holds for the seconds a window lasts, not the live reading; **(2)** it must stay clearly louder for **`COT_SWITCH_DWELL_MS` = 1500 ms** before the name moves — the named cot keeps the alert right up to that point, so one cry is one buzz; **(3)** while an alert is up the **display names the same cot the wrist does** (a panel that says cot 3 while the bracelet says cot 1 is worse than no panel). The dwell resets when the name moves or the cry ends. **Built, flashed to the hub (21:4x), and the hub came back up with all three cots live** (500 frames, 0 bad, BLE subscribed). **Not yet verified on the bench:** the user must replay a cry at the cots and confirm the wrist buzzes *once*, and the name stays. | `firmware/hub_infer/src/link_stage.c`, `research/out/demo_run3/` (the 21:16 evidence), `research/toolchain/flash_hub_cotswitch.log` | This was the fix the previous session died mid-build on (400 context limit at 21:25); the build finished before the session fell, and this session flashed the binary it left. |
| 2026-11-04 (the demonstration, first successful cry — the chain closed end to end) | **The chain now works end to end, in front of the user, with the wearable attached: phone → microphone → node freeze → ESP-NOW burst → CRC-32 match → INT8 model → hub names the cot → BLE → wrist.** The user played `session9_clip_0005.wav` at all three cots in turn. **Cot 3 announced:** window rms 0.041314, peak 7089, crest 5.2 → **P(cry) = 0.9961** → `node 3: ALERT — cry` at 364.28 s → `ble_alert: a cry on cot 3 at 100%` → the wearable printed `[ble] ALERT cot 3 type 1 conf 100% event #1` and `[haptic] alert 1 — motor not present, LED stands in` (the motor is not soldered yet; the LED stands in). Every burst in the run reached 286/286 with a CRC-32 MATCH — node 1 at −23 dBm, node 2 at −46 dBm, node 3 at −41 dBm — and the resend rounds recovered the shortfalls (19+2 and 20+3 fragments). **Cot 1 came close but did not announce**: its window (rms 0.05365, peak 13280, crest 7.6 — clean, no clip) scored **0.8516**, and the rule is that a cry is announced on the saturation (0.9900) and not before, so a 0.8516 is a maybe and a maybe announces nothing. **Cot 2's windows were flat and DC-heavy** (rms 0.112, peak 7681 but **mean −640 and −1031**, crest 2.1–2.4) and scored 0.0000: node 2's microphone is the one that clips on ordinary room sound and still reads a large offset — it is the cot that wants looking at. **What the fixes bought, measured:** node 1's window had sat advertised for seven minutes and un-pulled in the 19:26 run; now every cot's window is pulled within a second or two of the freeze. The freeze storm is over (node 1: 289 freezes per 7 minutes → 11), node 3 completes bursts it never once completed before, and no resend is refused anywhere. | `research/out/demo_run3/` (the capture), `SYSTEM_UPDATE.md` | **The remaining work is the bench, not the firmware:** cot 1 needs a little more level (0.8516 is close), and cot 2's microphone clips on ordinary sound and reads a DC offset of −640 — that is a hardware question for the day the boards are soldered. |
| 2026-11-04 (the first live play on the new firmware — the link is fixed, the source is not) | **The play at 20:50 proved the firmware fixes and isolated the last fault to the acoustics.** All three cots froze a **cry-grade** window (0.062, 0.071, 0.060 rms) — the hub **pulled all three**, which never happened before (node 1's window had sat un-pulled for seven minutes in the 19:26 run) — and **every burst finished 286/286 with a CRC-32 MATCH**, node 2 at −47 dBm and node 3 at −40 dBm, with the resend rounds recovering 19+2 and 20+3 lost fragments. Node 3, which had **not completed a single burst** in the whole of the 19:26 run (four resends refused, "no frozen window for it"), now completes every one. **The windows were then all refused as CLIPPED** (peaks 31358, 32706, 32255 of 32767) — the microphone had saturated — and the model scored them 0.0000, which is the correct verdict on a flat-topped cry. **One window was clean** (node 1, rms 0.1449, peak 21039, no clip) and the model *still* refused it (0.0000) at a **crest of 4.4** — a cry through a phone speaker and a room has a crest of 8–16, and 4.4 says the *source* was distorted: the phone's own speaker was overdriven at that volume, which saturates the microphone and flattens the waveform at the same time. **Since the CRC matched, the radio is not the suspect: the hub's window is bit-for-bit the node's window, so the fault is what the microphone heard.** The next play therefore has to be quieter at the source — phone volume down a couple of steps, 15–20 cm away — and the window's own rms, peak and crest in the hub's log are the numbers to steer by. | `research/out/demo_run2/` (the capture), `SYSTEM_UPDATE.md` | The chain is proven end to end for the first time: freeze → advertise → pull → 286/286 → CRC MATCH → model. What is left is not a firmware fault. |
| 2026-11-04 (the monitored bench run — three faults found, fixed, and the reason the demo announced nothing) | **The live run of 19:26–19:33 (`research/out/demo_run/`, five ports captured) produced **zero ALERTs**, and the capture explains every one of them.** The clip itself is fine: scored on the host with the deployed INT8 model, `session9_clip_0005` and `session1_clip_0005` read **0.9961 on every two-second window** (`research/score_demo_clips.py`, new). The fault was threefold. **(1) The node's three-second resend hold was inverted and cancelled itself the moment it started.** `g_frozen_hold_ms` is a deadline (`millis() + FROZEN_HOLD_MS`), so `now - deadline` is negative — past 0x80000000 as unsigned — for the whole hold; the test released the window on the very next reading and never released it afterwards. Measured: node 3 was refused four resends with "no frozen window for it" and **not one of its bursts finished**, while nodes 1 and 2 finished every one. Now a signed difference, and the window is dropped outright when the hold ends. **(2) The node could overwrite an unfetched window with ordinary room sound.** Node 1 froze a **0.1769 rms window — a genuine cry** — at 19:27:35, and replaced it with a **0.0104 rms window of room sound** three seconds later, because the hub had spent its airtime on node 2's window and had not come back; the freeze gate (`!g_frozen_served`) only blocks a re-freeze *after* the hub has taken one, so "the hub has not taken it yet" was exactly the condition that allowed the replacement. Now an advertised window may only be replaced by a much louder event (the existing three-times rule, extended to unfetched windows). **(3) The hub's pull gate judged only the live reading.** `loud` was streak ≥ 2 or rms ≥ 3× the node's level — both about the room *now* — but a stop-capped freeze deliberately lands *after* the cry has stopped, so node 1's 0.177 rms window sat advertised for seven seconds with streak 0 and was never pulled. The node reports the window's own level beside the live one (`win 0.1770`); a new gate `CRYNET_PULL_CRY_RMS 0.050f` pulls a window that loud no matter what the room is doing now (measured: the loudest window the nodes freeze from room sound is 0.036). Also: the monitor's own fault — the wearable's COM30 died on `ClearCommError` when the C3 re-enumerates after a reset, and the capture gave up on it; `capture_multi.py` now reopens the port and carries on. **Verified on the bench: the model and the clip are good (0.9961 on the host), the link is good on nodes 1 and 2 (286/286, CRC MATCH), and the wearable is alive — it rebooted on open and connected to the hub's BLE.** Next: flash the hub with the pull fix, flash nodes 1 and 2 (node 3 is already on the new sketch), re-run the capture with the wearable included, and have the user play the clip. | `firmware/node/node_crynet/node_crynet.ino` (hold inverted; unfetched window protected), `firmware/hub_infer/src/link_stage.c` + `link_stage.h` (pull on the frozen window's own level), `firmware/tools/capture_multi.py` (reopen on a board reset), `research/score_demo_clips.py` (new), `research/out/demo_run/` (the capture) | The three faults are one story: the node froze the right window, kept it three seconds, and the hub never asked for it — and when the hub did come back, the node had already thrown it away. |
| 2026-11-04 (the demonstration, rehearsed without a sound — and the yelp test set aside) | **The user asked the right question: on the day, the demo plays a real cry, not a selected yelp, so is the yelp test the right rehearsal? It is not — and the rehearsal that *is* right has now been done, with no sound at all.** **The yelp test answered a narrower question.** It was aimed at the freeze rule: would a short vocalisation be caught whole? That question was answered on the bench (the laptop's speaker cannot carry a short cry — 0.9961 as a file, 0.7422 as played), and it is a *rule* question, not a *demo* question. The demonstration plays a sustained cry, and the demo path for that was already verified live on 2026-11-01 (26 alerts at P 0.9922–0.9961, 45/45 bursts complete). **But the demo kit was stale, and that was worth catching before the soldering.** Every clip in `research/out/demo_kit/` was trimmed and scored under the **old peak-centred freeze rule**; the nodes now run the **hybrid stop-capped** rule, so the window the node freezes is a different two seconds, and the kit's scores no longer said what the hub would do. **So the kit was re-derived against the rule that is on the boards** (`research/simulate_demo.py`, new): each clip is played into a real quiet room (a recorded stretch of session5), the node's own 100 ms records are computed over it — the adaptive floor, the event level, the loud streak, the peak marker — the hybrid stop-capped freeze is applied exactly as the sketch writes it, and the window the node would hand over is scored with the deployed INT8 model and put through the hub's gates. **The result: 27 of the 37 kit clips announce at the level they were recorded at; 10 do not, and 17 announce only if the phone is turned *down* — their window clips, and a clipped window is refused.** The freeze lands 2.0–5.4 s after the clip starts (median 2.9 s), and the verdict about 2 s after that. **The shortlist for the day is three clips** — `session9_clip_0005` (announces at every volume, the most headroom), `session4_clip_0012` (announces at every volume, wide crest) and `session1_clip_0005` (the loudest reliable one) — and the instruction that matters is: **set the phone's volume once before the demonstration and do not touch it**, because the margin between *announces* and *clipped and refused* is one volume step on most of the kit. **No sound was played.** | `research/simulate_demo.py` (new), `research/out/demo_rehearsal.{md,csv}` (new), `research/out/DEMO_KIT.md` (the shortlist; the stale 'announces from the first window' claim replaced) | The rehearsal is what caught this: the demo kit's own file-level scores were fine (0.9922–0.9961 on the best window of every clip) and would have gone into the demonstration with every one of them listed as safe. The scores were never wrong — they were scores of the *wrong window*. The node judges one window, and the rule that picks it changed on 2026-11-04. **Still open:** the three-cot attribution test (which cot is named when the cry is played at each cot) and the live clip test — neither needs a sound to plan and both need one to run. | 2026-11-04 (the whole bench on one laptop — three cots, the hub, the wearable, and the false-alarm rule that came out of it) | **Every unit was on one laptop at once, and putting them there turned up three things worth fixing: a false-alarm path the model can walk into, a burst that costs a second and a half of dead time, and the last unproven link in the system — which is now proven.** The bench is now the three cot nodes on a USB hub with the hub and the wearable straight into the laptop, and **`firmware/tools/capture_multi.py` (new) holds every port open at once**, writes each line with a timestamp, and can send a command to a port while it watches. **All five boards were identified by their boot banners** — COM30 wearable, COM31 node 1, COM32 hub (CH343), COM37 node 2, COM38 node 3 — and **nodes 2 and 3 were flashed with the hybrid stop-capped freeze rule**, so all three cots now run the same freeze rule. **The rule for announcing a cry has changed, and the change is measured both ways.** The hub's *loud* path used to announce a cry on a single window whenever rms ≥ 0.080 and P(cry) ≥ 0.95. The model does not only lose certainty on clipped cries: in a room with people talking it scored an ordinary conversation window **0.9727** (node 3, rms 0.058, crest 3.5), and the hub's own boot probe scores **0.9805 on synthetic noise** — so a conversation one step louder than that would have been announced as a cry at three in the morning. The loud path is now the saturation (`CRYNET_LOUD_ANNOUNCE_P` 0.9900, and the confirming window needs 0.9900 as well), so **a cry is announced when the model saturates and not before**. The cost, measured on the corpus: **7 of the 53 cry episodes the old rule caught peaked between 0.9688 and 0.9883 and are now missed** (all seven are strong cries — rms 0.09 to 0.22, crest 4.3 to 7.9); on the bench **three genuine cries out of three scored 0.9961 and all three still announce**. **A clipped window is now refused outright**, and the hub says so in the log — the INMP441 is a fixed-gain part whose own output saturates before the node's 16-bit window does, so there is no software cure; the honest answer is placement (the microphone must not be within a hand's width of the sound), and the honest behaviour is to refuse the window and let the clean cot's window announce the cry. **The burst stall is noticed in a tenth of a second instead of a second and a half.** The hub was measuring the gap between fragments from its own polling loop — nearly 200 ms on a busy hub — so it could not tell a burst that had *ended* from one still in the air, and it waited the whole 1.5 s before asking for the fragments that were missing. The fragment timing is now measured in the receive callback, where the arrivals actually happen, and **the median window fetch fell from 2.48 s to 1.88 s (p90 3.45 s → 2.33 s)** — a third of the radio's time handed back to a three-cot room. **The hub has a console now** (`help`, `status`, `alert <cot>`, `clear`): the ESP-IDF log owns the UART and nothing could be read from it, so the console installs the UART driver itself — and the log is untouched, because the log's write path does not use the driver. **`alert 2` made the wearable print `[ble] ALERT cot 2 type 1 conf 100%` and light its LED**: the BLE path is proven end to end, with the right cot, without a sound, which is exactly what was missing. | `firmware/hub_infer/src/link_stage.c`, `src/link_stage.h`, `src/console.c` (new), `src/console.h` (new), `src/main.c`, `src/CMakeLists.txt`, `components/node_link/node_link.c`, `components/node_link/include/node_link.h`, `components/ble_alert/ble_alert.c`, `firmware/tools/capture_multi.py` (new), `research/simulate_freeze.py`, `research/out/ambient_25min/` (new), `research/out/hub_new_build/` (new) | **The 25-minute watch is the false-alarm evidence, and it is clean: 153 windows scored, zero alerts, zero brownouts, zero resets, and not one window reached 0.99.** Three windows reached the 0.95–0.99 band and **all three were quiet** (rms 0.0168 to 0.0232) — which is the interesting part: the measured speech is not loud enough for the old loud path either, and what is *unmeasured* is how the model scores a loud conversation. That is the whole argument for the saturation, and it is why the old rule is one number away (`CRYNET_LOUD_ANNOUNCE_P` and `CRYNET_CONFIRM_P` back to 0.9500). **160 bursts completed and every one of them reached 286/286** — the resend path recovers all of it, at the cost of 303 stall rounds; the timing fix is what makes those rounds cheap. **The power is fine: the three nodes on the unpowered USB hub ran the whole watch with no brownout** (node 1: 6 385 frames sent, 0 lost, 0 times the radio had no room). The boot probe's decision now uses the same rule as the live path, so the banner and the running system cannot contradict each other, and the hub's log no longer prints "advertising is off (a phone is connected)" every time the radio's policy changes — it printed it seven times in five minutes and read like the phone was dropping off. **Still open:** the clipping is a placement question, and the model's weakness on loud speech is a retraining job — the corpus is missing loud-speech negatives, and a room with people talking is the best source of them going. |
| 2026-11-04 (node 1's full-chain cry test — the pass that lets the branch merge) | **The cry played at node 1 was caught three times, every time named `cot 1`, every time with a clean cancel — and the whole seven-minute watch produced no false alarm.** The user played `research/out/demo_kit/session9_clip_0005.wav` from the phone at node 1; the hub's raw log (`research/out/hub_node1_fullchain.log`, 7 minutes, 2 800 lines) has every verdict. **The three cry windows, all clean:** request 214.36 s → window **rms 0.112173, peak 22660, crest 6.2** (no clipping — peak well under 32767) → **P(cry)=0.9961** → `ALERT — cry` at 215.57 s and `a cry on cot 1 at 100%` on the BLE link at 215.58 s, cancelled by `the cry on cot 1 at 0%` at 223.57 s; the second at 255.59 s → rms 0.080885, peak 12682, crest 4.8 → 0.9961 → alert 256.81 s, cancel 264.80 s; the third at 276.80 s → rms 0.080854, peak 14141, crest 5.3 → 0.9961 → alert 278.08 s, cancel 286.08 s. **Latency: 1.21 s from the hub's request to the verdict, 1.85 s from the cry's first loud reading to the wrist being told** — the after-peak freeze put the cry inside the window every time, and the loud-window rule made the two quieter windows announceable without waiting for the saturation value. **The three quiet windows were all correctly refused** (P(cry) 0.0469, 0.0273, 0.0195 — one at rms 0.0178, one at 0.0347). The hub's own boot self-test still passes 4/4 (`RESULT: PASS — 4 probes`); its noise probe scores 0.9805, which is the reference agreeing with the host, not a live verdict. **Two things the same log exposes.** (1) **Every burst stalls at 280–283 of 286 fragments and needs a resend round** — all seven bursts completed (286/286 in 1.04–1.10 s), but the shortfall is systematic, not random, and worth chasing. (2) **Node 2 clipped on a loud sound at 414.9 s** (window rms 0.0831, **peak 31801** against 32767) and the model correctly refused it (P(cry)=0.0000) — node 2's microphone is clipping on ordinary room sound, so its gain or its place on the desk wants looking at before it is the cot that has to hear a cry. | `research/out/hub_node1_fullchain.log`, `firmware/tools/capture_hub_wait.py` (new — waits for the hub to be plugged in, then raw-logs its serial for 7 minutes), `SYSTEM_UPDATE.md` | **The branch `feature/cry-window-after-peak` is merged into `main`** after this test, as the user asked: `main` goes from `aae1c7a` to the tip of the branch. **Still open:** node 2's clipping (its peak 31801 on ordinary sound); the systematic 4-fragment shortfall at the start of every burst; node 3 never produced a window in this capture (it was on the air but nothing crossed its trigger); and the wearable was not attached, so the BLE link's *content* was logged from the hub's side only. |
| 2026-11-04 (the freeze rule, measured properly — and the third rule it points at) | **The freeze rule was the last unmeasured thing in the system, so it has been measured: the corpus was simulated through the node's own logic, and it says the after-peak rule is safe but loses the short cries. A third rule comes out of that, is on node 1, and works on the bench.** **(1) The simulator.** `research/simulate_freeze.py` (new) runs the node's real 100 ms records over every in-domain session — the mean of the 2 s window, the rms of the newest 100 ms around it, the adaptive floor and level, the loud streak, the peak marker, the freeze, the 2 s refill — then scores the frozen window with the deployed INT8 model and puts it through the hub's gates (the silence gate, the audible floor, the loud rule at 0.08 rms, the quiet saturation bar at 0.99, the crest/level condition). The clips' offsets in the session waveforms are recovered by exact sample match, so every freeze is labelled *cry* or *room*. **(2) The result** (`research/out/freeze_simulation.{csv,md}`), three freeze rules over the same corpus: | rule | room windows | false alarms | worst room P(cry) | cry episodes caught | | two seconds after the peak (on the boards) | 69 | **0** | 0.4141 | 41 of 273 | | **stop-capped (new)** | 100 | **0** | 0.8516 | **52 of 294** | | peak in the middle (the rule it replaced) | 104 | **0** | 0.7656 | 52 of 297 |. So the after-peak rule is **safe** — not one room window announced under any of the three, and none of the room windows was even loud enough (worst 0.0350 rms) for the 0.95 rule to apply; the quiet bar of 0.99 is what carried them. But it is the **least sensitive of the three**: 41 of 273 cry episodes against the old rule's 52, because a yelp that is over before the two seconds have passed is frozen over the room instead of over the cry. **(3) The third rule.** The window is now frozen **when the cry stops** (the loud streak breaks) and the two seconds after the peak are only the *cap* for a cry that goes on: a short yelp is caught whole, a sustained cry still gets the two seconds that follow its peak. It catches 52 of 294 episodes — the old rule's recall — while the windows it hands over still hold the cry. `PEAK_STOP_DELAY_MS = 500` is the shortest wait before a stopped cry is frozen, so the window cannot be cut on the first dip below the level. **(4) On the bench.** Node 1 (COM31) was flashed with it and the sustained demo clip **announced on cot 1** — `P(cry)=0.9961`, `a cry on cot 1 at 100%`, cancelled cleanly 8 s later — so the working case is unbroken. The three short yelps were all refused (0.1953, 0.0625, 0.5859), which is right: they are not full cries. **(5) The honest limit on that last test:** the yelps were played from the **laptop's speaker**, and the laptop's speaker cannot carry a short cry — the clean `yelp_2.0s.wav` scores **0.9961** as a file, while the node's own frozen window for the same playback scores **0.7422** and its partials sit at 2.3 kHz with 40–50 Hz spacing, which is not a baby's cry. The system volume on this machine was also found to be far below full (the clip first reached the mic at rms 0.015; at full volume it reaches 0.165). **So the yelp comparison cannot be settled on the hardware from the laptop** — it needs the phone. The clips are staged for that in `C:\Users\HP\.t3\userdata\attachments\yelp_test\` (three yelps and the sustained demo clip). | `research/simulate_freeze.py` (new), `research/predict_yelps.py` (new), `research/dump_during_play.py` (new), `research/out/freeze_simulation.{csv,md}`, `research/out/yelp_predictions.md`, `research/out/short_yelps/*.wav`, `research/out/yelp2_window.wav`, `firmware/node/node_crynet/node_crynet.ino` (`PEAK_STOP_DELAY_MS`), `SYSTEM_UPDATE.md` | The two findings that were *not* defects, now measured rather than suspected: **node 2's "clipping" was a desk knock** — at the instant of the event node 2 read rms 0.0570 while node 1 read 0.0050 and node 3 read 0.0170, and in the quiet stretches the two cots' floors are identical (0.003–0.015), so the mics have the same gain and node 2 needs no change; the model refused it correctly (P(cry)=0.0000). **The "systematic 4-fragment shortfall" is random loss** of 2–6 frames per burst — the missing indices differ every burst (204/205, 181/182, 147/270, 93/206) — and the resend round recovered every one of them (286/286 in 7 of 7 bursts) for about 50 ms. **Still open:** nodes 2 and 3 still carry the after-peak rule and need the same flash (`python firmware/tools/flash_node.py --port <port>`); the branch `feature/stop-capped-freeze` awaits the user's decision; and the short-yelp case is still unproven on hardware (the phone test). |
| 2026-11-04 (the other two cots — the whole bench freezes after the peak) | **Nodes 1 and 2 were flashed with the branch's node build, so all three cots now carry the after-peak freeze rule, and both newly flashed boards were verified alive with the rule visibly working.** Both nodes were found plugged into this PC (node 1 COM31, node 2 COM37). The flash evidence: node 2's boot `Saved PC` changed `0x4038aab8` → `0x4038aa94` across the before/after captures, and both boards now boot the same binary. The behavioural evidence is the point of the fix: in the *before* capture (`research/out/who_now.log`) node 2 froze its window *during* the loud event — `froze window, burst seq 1` right as the event decayed, the window holding the peak at its end; in the *after* captures (`research/out/who_after_flash.log`, then a fresh 16 s run `research/out/freeze_verify_nodes12.log`) the same-shaped room event ran its whole course on both boards with **no freeze until it had decayed**: node 1 froze at 5.00 s and node 2 also at 5.00 s, each exactly two seconds after its own loud streak began (`PEAK_DELAY_MS` measured from streak start, which the code stamps when the streak reaches 2 records — the rms max sits mid-streak, inside the frozen window's two seconds). Neither board froze immediately any more, which is the old behaviour gone. Both boards boot clean (`node id 1 (derived from the MAC)` on COM31, `node id 2 (saved)` on COM37), stream telemetry, and answered the room's noise with bursts. | `firmware/node/node_crynet/node_crynet.ino` (build on both boards), `research/out/{who_now.log, who_after_flash.log, nodes_alive.log, freeze_verify_nodes12.log, hub_during_cry.log, cry_test_node3.log, node3_cry_window.wav, demo_kit/}`, `research/out/hub_raw_node2_v2.log` | A 4 s serial open resets the C3 (rst:0x15 USB_UART_CHIP_RESET), which is how the boot banners and `Saved PC` were read. **Still open:** the full-chain cry test at nodes 1 and 2 through the hub (the `hub_raw_node2_v2.log`-style retest, phone at 15–25 cm, panel 0.10–0.15) is owed before the whole bench is called verified end to end; node 1's id is still MAC-derived (set it with `id 1` over serial if it ever moves ports); and the branch `feature/cry-window-after-peak` awaits the user's merge decision. |
| 2026-11-04 (the retest — the right cot, named right) | **The retest closes the misattribution: the hub published `a cry on cot 2 at 100%`, twice, with clean cancels in between.** The user replayed the cry at node 2 with the phone held **further away** (15–25 cm instead of 10 cm) and quieter (panel ~0.10–0.15). The raw hub log (`research/out/hub_raw_node2_v2.log`) shows the whole thing: node 2's live rms crossed the level at **78.07 s**, its frozen window came up at 83.26 s (rms 0.0561, **peak 5489 — no clipping**, crest 3.0), the model scored **P(cry)=0.9961**, and the hub published **`a cry on cot 2 at 100%` at 83.46 s** — **5.4 s from the cry starting to the wrist being told**. The next window (0.1328) cancelled it (`the cry on cot 2 at 0%`), and the play continuing brought a second clean alert at 131.87 s with its cancel at 139.9 s. **The distance was the whole difference:** the same cot's windows at 10 cm had peaks of 33289 and 33389 against a full scale of 32767 — hard clipping — and clipped windows score 0.0078, 0.0273, 0.1602. **The quiet period after the play raised no false alarm** (2.5 minutes, every verdict logged): node 1's window at 0.9961 (rms 0.0155, crest 3.4) was correctly refused by the crest gate, and the 0.9023 / 0.9219 verdicts were below the bar. The loud-window rule (a window from 0.08 rms may announce at 0.95) did not fire on anything quiet, exactly as the 964-window screening predicted. | `firmware/hub_infer/src/link_stage.h`, `firmware/hub_infer/src/link_stage.c`, `research/out/hub_raw_node2_v2.log`, `SYSTEM_UPDATE.md` | Hub build SUCCESS 11.7 s (RAM 13.1 %, flash 62.6 %), flashed on COM32. Both fixes are on the branch `feature/cry-window-after-peak` (commits `8f5cf73`, `fce9cbb`), **not** on `main`. **Still open:** nodes 1 and 2 carry the old freeze rule and need `python firmware/tools/flash_node.py --port <port>` wherever they are plugged in; and the user's decision on merging the branch. |
| 2026-11-04 (the phone test — three cots, and the wrong cot named) | **All three cots now detect the cry played at them, the freeze fix works, and one real defect showed up: the alert named the wrong cot.** The user played the cry at each cot from the phone. The log (`research/out/hub_phonetest.log`, `research/out/node3_phonetest.log`) shows **node 3 alerting three times at P(cry)=0.9961** (node 3 carries the new freeze rule), **node 1 alerting at 0.9961**, and **node 2 reaching P(cry)=0.9961 at 284.3 s** — but node 2 took from ~152 s to ~284 s to get there. **Why node 2 was slow, measured:** its own windows were *clipped* — peak 21405, 33289, 33389 against a full scale of 32767 — because the phone was held ~10 cm from the microphone (live rms 0.255–0.359). Clipped cries are exactly what this model scores near zero on (0.0078, 0.0273, 0.1602), and the model needs ~1.5–1.75 s of clean cry in the window (measured 2026-11-04, earlier entry). Its last window, at rms 0.0975 and crest 6.9, was clean — and scored 0.9961. **Why the wrong cot was named:** at 231.7 s **node 1**'s window (rms 0.0207, peak 2449, clean) scored 0.9961 and was announced, *while the phone was at node 2* — node 1 is close enough to hear the same cry, and it heard it undistorted, so its window was the better evidence. Node 2's own window at that moment (rms 0.1801, peak 21405) scored 0.9805, which is a *maybe*, and a maybe has to wait for a second window to confirm — which never came, because the next windows were clipped. So the hub announced a cot it had never heard the cry at, and 42 s later announced the right one. **Two fixes, both in:** (1) **the node now freezes the two seconds *after* the peak** (`PEAK_DELAY_MS` 500 → 2000, `PEAK_EXPIRE_MS` 2000 → 4000 — measured: the model needs 1.5–1.75 s of cry in the window, and the old rule put the peak in the middle of it, leaving only ~0.5 s of cry in the window of a cry that had just started), flashed to **node 3 on COM38** and verified alive; (2) **a loud window may now announce on the model's own threshold** (`CRYNET_LOUD_ANNOUNCE_RMS 0.080` in `link_stage.h`: from 0.08 rms a window may announce at P ≥ 0.95 instead of waiting for the 0.99 saturation), because clipping lowers the score on an otherwise clear cry — node 2's 0.1801-rms window at 0.9805 would now have announced at 242 s instead of 284 s. **The rule was checked against every window of the corpus first:** of the 964 screened windows, **not one** of the 189 windows from the nine non-cry sessions reaches 0.95 at 0.08 rms (the loudest non-cry window of the whole corpus scores 0.0156), while 21 more loud cry windows become announceable (130 instead of 109). The quiet path keeps its saturation requirement, because that is where the model has been caught saturating on flat hiss. Hub rebuilt (RAM 13.1 %, flash 62.6 %, SUCCESS 11.7 s) and **flashed to the hub on COM32**. | `firmware/node/node_crynet/node_crynet.ino`, `firmware/hub_infer/src/link_stage.h`, `firmware/hub_infer/src/link_stage.c`, `research/out/hub_phonetest.log`, `research/out/node3_phonetest.log`, `research/out/hub_raw_node2.log`, `SYSTEM_UPDATE.md` | On the branch `feature/cry-window-after-peak` (commit `8f5cf73`), **not** on `main` — `main` is protected until the user decides. **Still open:** nodes 1 and 2 carry the old freeze rule and need the same flash (node 1 is on the other laptop; node 2 is on the air — seq 50, level 0.005 — but not plugged into this PC; `python firmware/tools/flash_node.py --port <port>` does it wherever they are). The hub rebooted once mid-session with `rst:0x1 (POWERON)` — a power-on reset, not a crash or a watchdog. **The demo rule that follows from all this:** the phone plays 15–25 cm from the INMP441, with the panel reading 0.10–0.15 — closer than that and the window clips, which is the one thing this model cannot survive. |
| 2026-11-04 (the demo kit — what the model actually needs) | **The demo kit is built and screened, and the model turned out to have a hard operating rule nobody had measured: it needs ~1.5–1.75 s of continuous cry inside the 2 s window; half a window of cry scores 0.02–0.36.** `research/screen_clips.py` (new) scores every clip of every in-domain session with the *deployed* INT8 model and the *notebook's own* front end — 241 clips, 964 windows: **56 clips announce (P ≥ 0.99) in at least one window, 37 already in their first window**, and the nine non-cry sessions never reach 0.99 (their worst is 0.8906). `research/build_demo_kit.py` (new) then trims each candidate to the cry itself, re-scores it, and keeps only those that announce from their **first** window — the window the node freezes when the trigger fires at the head of the clip: **37 clips in `research/out/demo_kit/`**, with `research/out/DEMO_KIT.md` as the list. **Why the demo kept missing, now measured two ways.** (1) *Window placement:* the node freezes `[peak − 1.5 s, peak + 0.5 s]` (`PEAK_DELAY_MS = 500`), so a cry that starts at the peak puts only ~0.5 s of cry in the window — and the measured curve is 0.50 s → 0.004–0.36, 1.00 s → 0.02–0.23, 1.25 s → 0.10–0.95, 1.50 s → 0.21–0.99, 1.75 s → 0.77–0.9961, 2.00 s → 0.9961. Every kit clip is therefore trimmed to the cry, so whatever the node freezes is full of it. (2) *The source:* node 3's frozen window on 2026-11-03 **did** hold the cry (rms rising 0.0076 → 0.0476 across the window, crest 9.0, transfer bit-faithful) and still scored **0.0117** — while the same recording played by the phone scores **0.9961**. The PC/laptop speakers take a perfect signal down by a factor of ~100; the phone is the only source ever shown to work. **Two side findings:** a 100 Hz high-pass rescues 10 clips (0.148 → 0.9961 on `session10/clip_0007`) but also lifts a non-cry window in session 2 to 0.9609, so it is *not* a free win and needs its own bench test before it ships; and `session9/clip_0000` — the clip played on 2026-11-03 — is good from its *second* second (0.1484 → 0.9961), which is exactly the first-crossing freeze rule working against it. | `research/screen_clips.py` (new), `research/build_demo_kit.py` (new), `research/out/clip_screening.csv`, `research/out/clip_screening.md`, `research/out/demo_kit/*.wav` (37 clips), `research/out/DEMO_KIT.md` | Run the tools with **`C:\Users\HP\AppData\Local\Programs\Python\Python311\python.exe`** — it is the only interpreter on this machine with TF 2.21, librosa and pyserial (Python 3.15 has no numpy, 3.14 has no pyserial). `winsound` has **no `SND_SYNC`** (synchronous is the default) — `research/cry_audio_check.py` was fixed for it. **Next checkpoint (needs the phone):** play `research/out/demo_kit/session9_clip_0005.wav` from the phone, 10–15 cm from the INMP441, with the volume set so the panel reads 0.10–0.20, and watch the hub's verdict on all three cots. **The firmware lever, with its cost stated:** `PEAK_DELAY_MS` 500 → 2000 (with `PEAK_EXPIRE_MS` 2000 → 4000, or the freeze can never fire) would make the frozen window the two seconds *after* the peak — always full of cry — at the price of ~1.5 s more latency. |
| 2026-11-04 (early, the honest verdict the user asked for) | **The verdict is in, with the window-level proof: the mesh is innocent — the model and the playback source decide everything.** The question was why node 1 detects, node 2 is slow, node 3 "isn't detecting even when rms is high", and whether three nodes can ever all work. **(1) Node 3's chain is proven good end to end:** tonight's cry test (`research/out/cry_test_node3.log`) shows three windows pulled, every burst completing (1.0–2.5 s with resend rounds), and verdicts **2.1–2.7 s from request to P(cry)** — the same speed node 1 gets. **(2) The transfer is bit-faithful — `research/cry_audio_check.py` (new) plays a cry on the PC, dumps node 3's own frozen window over USB and compares it with the hub's reassembled copy: rms 0.0383 / crest 9.0 at the node vs 0.0384 / 9.1 at the hub.** Nothing is lost on the air. **(3) The model refuses the window anyway: P(cry)=0.027** on a loud, unclipped, cry-shaped window. **(4) The root cause has two layers.** The *source*: the clean training clip itself scores only **P(cry)=0.148** on the host — it is one of the 41 % of in-domain cry windows the deployed model misses at the 0.95 bar (in-domain eval: recall 0.592, fpr 0), and the PC/laptop speakers were already convicted once (D-61: laptop playback P 0.38–0.95, never over). The *front end*: node 3's window carries 20 % of its energy below 300 Hz (partials at 0 and 52 Hz — speaker rumble and mic bias), and stripping it lifts the score 0.012 → 0.586 — still short of 0.95. **(5) The gates stack on top of a model that already misses 4 in 10 cry windows:** `research/analyze_gates.py` on the evening's hub log shows 297 windows offered and only 4 pulled (the pull gate 0.016 + live-loud turns away the rest), and windows pulled at rms 0.016–0.017 sit under the 0.020 announce floor and are refused unheard — that is exactly node 2's "crazy long" path: its cry windows land at 0.017, so it needs a louder or a confirmed window and pays an extra freeze cycle. **Answers:** all three nodes *can* detect — the mechanism is proven per node, and three cots do not slow one cot's verdict (bursts serialize at ~1–2.5 s); the speed floor is **~2.1–2.7 s from request to verdict, ~4–5 s from cry onset** (2 s window centred on the crossing + telemetry notice + burst + 150 ms inference), +4 s when the first window is a *maybe* that needs confirming; **reducing the node count fixes nothing**. **The move:** demo from the phone at panel level 0.10–0.20 at 10–15 cm (the verified path — five alerts at 0.9922+, D-74), pre-screen any demo clip on the host with `analyze_window.py` and only use clips scoring ≥ 0.99, and consider a gentle high-pass (≈100–120 Hz) on the node's capture after a bench test — it is worth ~50× on rumble-laden windows but *hurt* the clean clip (0.148 → 0.027), so it must be validated before it ships. | `research/analyze_gates.py`, `research/cry_audio_check.py`, `research/out/cry_test_node3.log`, `research/out/node3_cry_window.wav`, `research/out/hub_during_cry.log`, `SYSTEM_UPDATE.md` | Instruments that answered it: `analyze_gates.py` (which gate turned each window away), `cry_audio_check.py` (node window vs hub window, byte-faithful), `analyze_window.py` (what the model makes of a window, run under `Python311` — the only interpreter here with TF 2.21). The evening's hub log is `/tmp/hub_now.log` (297 windows, 881/248/718 telemetry lines from nodes 1/2/3). Node 3's RSSI tonight: −52 to −73 dBm at its desk — bursts still complete, just with resend rounds. |
| 2026-11-03 (night, merged) | **`feature/faster-detection` is merged into `main` — a fast-forward with no conflicts, and the branch is pushed to GitHub.** `main` goes from `9ff9a0f` to `51a15af`: the resend fix, the sticky BLE arbitration, the slow-while-busy advertising, the counter-dedupe, the node counters, the one-command node flash and the whole documentation trail. Every one of those commits was verified on real boards before it was made, so `main` now carries the state that was measured: three cots announcing a cry, bursts that always complete, and a wrist that attaches in seconds and names one cot per cry. | `main` (fast-forward, 25 commits) | The branch keeps its name on the remote (`crynet/feature/faster-detection`) as the record of the run; `main` is the working branch. **Still open, in order:** the battery dividers are not wired, so every cot reports "no reading" and the panel's `BAT` band stays dark; the 4:1 window compression (286 frames to 72) is a project of its own; this PC has no page file, which killed the C++ compiler twice; and node 3 rebooted once mid-session without its banner being caught. |
| 2026-11-03 (night, BLE arbitration, second round) | **The wrist now stays on one cot: the alert is sticky — and it is verified.** The first version of the arbitration named *the loudest* crying cot, and the log showed why that is not enough: two cots in one room both hear the cry and their levels cross over window by window, so the hub published `a cry on cot 1`, then `cot 2`, then `cot 1` again — five times in two seconds — and the wearable buzzed each time. The cot that was named now **keeps the alert** until it stops crying, or until another cot is clearly louder (1.5× margin). The panel's card uses the same rule, so it does not flicker between cots either. **Measured on the bench (hub serial + wearable serial):** the wearable attached in **4 s** after the hub came up and again in **0.4 s** after a hub reboot — the hub re-advertised at the slow 320 ms interval while its radio was busy and the wearable took it at once, where before it had to wait for a gap in a radio that was busy 89 % of the time. **The re-test after the sticky fix: two cry episodes, each one alert and one cancel, no alternating at all** — `a cry on cot 1 at 100%` / `the cry on cot 1 at 0%`, then `a cry on cot 2 at 100%` / `the cry on cot 2 at 0%`, and the wearable logged exactly `ALERT cot 1 type 1` + `type 2`, then `ALERT cot 2 type 1` + `type 2`. **It named the right cot both times:** during the second episode node 2 was hearing the cry (rms 0.159–0.165) while node 1 sat at 0.021–0.025. The wearable's firmware buzzes only on the transition *into* a cry, so a re-issue naming a different cot does not buzz again. The hub's log line said `the cry on cot cot 1` — the doubled word is fixed. | `firmware/hub_infer/src/link_stage.c`, `firmware/hub_infer/components/ble_alert/ble_alert.c`, `firmware/wearable/wearable_crynet/wearable_crynet.ino`, `firmware/tools/flash_node.py` (committed as `c352d48` and `f1a6538`; hub build SUCCESS 21.9 s, RAM 13.1 %, flash 62.6 %, flashed on COM32; wearable build 678 475 B / 51 %, flashed on COM30 with `flash_node.py --sketch wearable`) | The alternating captures that exposed the flaw are `%TEMP%/hub_ble3.log` and `%TEMP%/wearable2.log`; the good ones are `%TEMP%/hub_ble4.log` and `%TEMP%/wearable3.log`. The two lessons worth keeping: the wearable is the thing that has to be *found*, so the hub must stay findable even while its radio is busy — a slow advertisement costs a burst a frame, and the resend path recovers frames; and a "loudest wins" rule needs a margin and a memory, because two microphones in one room will always cross over. |

| 2026-11-03 (night, BLE checkpoint in progress) | **The physical antenna check closed: node 3's RSSI rose from -48/-50 dBm at desk distance to -32/-34/-31 and finally -23/-22 dBm when held close, then returned to -49 dBm on the desk.** That is normal distance loss, not a bad board; no swap is needed. During the same capture the already-flashed resend fix worked: node 3's burst completed and CRC matched, and node 3 ALERTed at P(cry)=0.9961; node 1 and node 2 also ALERTed. **BLE checkpoint now being implemented (not yet built or flashed):** the wearable will stay discoverable during an ESP-NOW burst at a slower 320 ms interval (currently advertising stops entirely during busy/preparing), and the hub will publish one alert for the loudest crying cot rather than one per cot; the wearable will buzz only on the transition into a cry, not when the named cot changes. | `firmware/hub_infer/components/ble_alert/ble_alert.c`, `firmware/hub_infer/src/link_stage.c`, `firmware/wearable/wearable_crynet/wearable_crynet.ino`, `SYSTEM_UPDATE.md` | Antenna capture: `%TEMP%/hub_ant.log`; verdict: RSSI follows distance. Previous node3/hub capture after resend fix: `%TEMP%/node3_v2.log`, `%TEMP%/hub_v2.log`. The BLE code has **not yet been compiled or run**; next verify builds for hub and wearable, then flash and repeat wearable attach + multi-cot alert test. |
| 2026-11-03 (night, the three-cot verdict) | **All three cots now detect the cry — and the reason node 3 never did is a firmware line, not the board.** Node 3 was brought to the hub's own desk and the phone cry was played at it: the node's own console showed the microphone hearing it (rms to 0.29, `EVENT`), the trigger freezing (`win rms 0.1841 (cry mode)`), the radio serving **286/286 fragments in 733 ms**, and the hub reassembling the window with a **CRC MATCH**. So the link, the trigger and the freeze were never the fault. **The fault was the node's own resend rule.** The hub asks again about 670-770 ms after its last ask, and the node dropped any resend request naming the same window within **800 ms** — so it swallowed *every* round after the first. A burst that lost a single frame could therefore never be completed: the hub asked for the missing fragment five times (the log shows the missing index repeated verbatim), the node answered none of the five, the burst sat at 285 of 286 until it timed out, and the whole two-second window — the one holding the cry — was thrown away. One lost frame is the commonest failure on a weak link, which is why this cost the most. **The rule is now two-sided:** a request is a repeat only if it names the same window *and* the same fragments *and* arrives within 250 ms. A round naming a fragment the last round did not name is always answered. **Verified on the bench with both boards reflashed:** node 3's node log now shows two rounds answered per burst (16 then 1, 25 then 2, 31 then 4, 14 then 1), **every one of node 3's bursts completes** (270→285, 261→284, 255→282, 272→285, all CRC MATCH), and node 3 **ALERTed with P(cry)=0.9961** — as did node 1 (P(cry)=0.9961) and node 2. The air was clean: `10 923 frames off the air, 10 923 parsed, 0 bad, 0 bad payload, 55 requests sent, 0 failed`. The hub's stall line also stopped printing `4294963123 frames` — it subtracted the node's counters across a reboot and wrapped unsigned; the delta now counts zero across a restart and says so in a line of its own. | `firmware/node/node_crynet/node_crynet.ino`, `firmware/hub_infer/src/link_stage.c` (committed as `5d38b01`; hub build SUCCESS 32.7 s, RAM 13.1 %, flash 62.6 %, flashed on COM32; node build 990 545 B / 75 %, flashed on COM38, hash verified) | **The hardware suspicion that remains:** node 3's radio is far weaker than its own firmware should allow — on the hub's own desk it reads **-54 to -61 dBm**, while node 1 reads **-20 dBm** from the other room and node 2 **-50 dBm**. Node 3 is the *closest* cot to the hub and the *weakest* one heard, which no distance explains, and it loses 16-31 frames per burst where node 1 loses 11-13 at -20 dBm. **The decisive test is one minute of bench time: hold node 3 5 cm from the hub and read the RSSI.** At 5 cm a healthy board reads better than -30 dBm; if it stays near -55, the board's antenna is the fault (a damaged or obstructed PCB antenna), and that is a swap, not a firmware fix. **Also open:** node 3 rebooted once mid-session in the previous capture (its counters restarted and its window sequence began again at 1) and the boot banner was not caught — the console was open from the start in this session and it did not recur, so it may have been the USB cable or the power on that board. **Also noted on this machine:** it has **no page file** and its commit limit was exhausted, which made the C++ compiler die with `out of memory allocating 16 MB` and the Arduino library probe fail; the builds only ran once the memory was free. |
| 2026-11-03 (later still, 3) | **Nodes 2 and 3 are flashed with the new firmware — all three cots now run the same build.** The user swapped the bench around (hub and node 1 unplugged, nodes 2 and 3 plugged into the PC), so both remaining cots were flashed from here: COM37 and COM38, `arduino-cli compile` + `upload`, 990 469 bytes of program storage (75 %), hash verified on both. **The two boards were confirmed to be the right ones before flashing**, because both Pro Minis derive the *same* id (1) from their MACs and only their NVS-saved ids tell them apart: `firmware/tools/who_is_who.py` (new) opens a port, resets the board over RTS/EN and reads the boot banner — COM37 → `node id 2 (saved; MAC would have said 1)`, COM38 → `node id 3 (saved; MAC would have said 1)`. Both kept their ids across the flash (NVS is untouched by an app-partition upload) and both come up on **channel 6**, matching the hub. | `firmware/tools/who_is_who.py` (new), `firmware/tools/flash_node.py` (used) | **Bench plan the user has set:** node 2 stays on this PC with the hub, node 3 and node 1 go to the other laptop for the cry test. Node 1 already carries the new build (flashed and verified in the previous entry), node 2 and node 3 do too as of now. **Next:** play a cry at node 3 (on the other laptop) and at node 2 (here), and read the hub's verdict line on COM32: `its radio handed over N frames since the burst began, M of them left it, K were refused` — N=286 with M small and K=0 means the frames die in the air at that cot (move the cot or kill the interferer); K large means the node's own radio queue is the problem. Also still worth checking on the other laptop: `netsh wlan show interfaces` — the hub's ESP-NOW is on **channel 6**, so a Wi-Fi adapter sitting on channel 6 there is the likely interferer next to node 3. |
| 2026-11-03 (later still, 2) | **The hub's patience now follows each cot's own fragment rate, and the whole chain is verified end to end on the new build: node 1 ALERTed with P(cry)=0.9961 and a window CRC MATCH.** Raising the stall threshold to a flat 400 ms fixed node 1's recovery: its bursts went from 0.78 s to 1.4-2.3 s, because a fixed number cannot describe two links (60 ms is twenty times the spacing of a good link and a fifth of the spacing of a poor one). The hub now keeps a running mean of how far apart *this cot's* fragments arrive and waits eight times that for the next one -- 24 ms for a good link, 400 ms for a slow one -- and waits the missing count times the same spacing before repeating a resend round. Node 1's bursts are back to **0.77-0.85 s**. **Verified live on the bench with both new firmwares** (node 1 on COM31, hub on COM32, the PC's own speaker playing `research/in_domain/session1/clips/clip_0001.wav` at node 1's microphone): `window crc32 0x38FE8B00, node advertised 0x38FE8B00 -> MATCH`, `window rms 0.074393  mean 18  peak 15769  crest 6.5`, `P(cry)=0.9961`, **`ALERT — cry`**, and the BLE alert published `cry on cot 1 at 100%`. The hub's own boot self-test still passes (4 probes, front end and model agree with the host). The node's new counters read correctly over the air: `its radio handed over 314 frames since the burst began, 314 of them left it, 0 were refused, 0 times it had no room` -- node 1 puts every frame on the air and the hub loses a few in its own receive path, which is a different fault from node 3's. | `firmware/hub_infer/src/link_stage.c` (committed as `3261364`; hub build SUCCESS 21.7 s, flashed on COM32) | **Still to do on the bench:** flash node 2 and node 3 on the second laptop (`python firmware/tools/flash_node.py --port COM37` and `--port COM38`), then play a cry at node 3 and at node 2. The stall line now carries the verdict in one place: `its radio handed over N frames since the burst began, M of them left it, K were refused`. If N is 286, M is small and K is zero, the frames are dying in the air at that cot (move the cot, or find the interferer); if K is large, the node's own radio queue is the problem. |
| 2026-11-03 (later still) | **The link is fixed on paper and the counters that prove it are on the wire: a slow burst is no longer a dead burst, and the node now says whether it sent the fragments or the air ate them.** The user played the cry at all three cots again: node 1 detects it fast, node 2 detected it twice out of several trials, node 3 still never detected one. Re-reading `hub_3diag.log` against the firmware found two faults that the earlier diagnosis had not named, both of which hit node 3 hardest and neither of which is the hub's fault: **(1) The hub called a live burst dead after sixty milliseconds of quiet.** `FRAG_STALL_MS` was 60 (twenty times the 3 ms gap of a good link, and a fifth of the gap between the fragments of a poor one), so a burst that was merely slow was declared stalled and the three resend rounds were spent before the node had finished its first pass; the stall threshold is now **400 ms** and there are **ten** rounds instead of three, still bounded by the burst's own 15 s timeout. **(2) The node threw the window away in the middle of a transfer.** The preempt rule (a window 3x louder than the frozen one takes its place) could cancel the served-hold at any moment, and in node 3's noisy room every reading is 3x the last window's level -- so it refroze every ~1.3 s and the fragments the hub was still missing went with the old window, which is why no burst of that cot could ever finish. A window the hub is fetching is now protected for 4 s past the last fragment the node sent, and the clock is refreshed per fragment, so a burst that takes ten seconds to cross a bad link keeps its window for the whole of it (the hold is no longer than the old 3 s one, so a cot is not left unable to freeze a new window any longer than before). **(3) Nobody could see where the fragments went**, so the node's own radio counters -- frames handed to the radio, frames the radio refused, frames that left it, times it had no room -- now ride in the telemetry (a new 34-byte tier, backward compatible with the 18-byte one) and the hub prints them with every stall: a node that handed all 286 over and saw few come back has lost them **in the air**; a node whose radio refused them has a **queue too small for the burst**. The two faults are fixed in opposite places, so the next stall line says which one it is instead of leaving it to a guess. Also fixed: the resend path printed a serial line per fragment, stalling the node's loop in the middle of a transfer. | `firmware/hub_infer/components/crynet_proto/*`, `firmware/hub_infer/components/node_link/*`, `firmware/hub_infer/src/link_stage.c`, `firmware/node/node_crynet/node_crynet.ino`, `firmware/tools/flash_node.py` (committed as `86e467a` on `feature/faster-detection`; hub build SUCCESS 37.0 s, node build 990 443 B / 75 % of flash, node 1 flashed on COM31 and the hub on COM32) | **The bench step now:** flash the two cots on the second laptop with the new build (`python firmware/tools/flash_node.py --port COM37` and `--port COM38` -- the new tool finds `arduino-cli` inside the Arduino IDE and falls back to the sketchbook copy if that laptop has no checkout), then play a cry at node 3 and at node 2. The hub's stall line now carries the verdict in one place: `its radio handed over N frames since the burst began, M of them left it, K were refused`. If M is small and K is zero, the frames are dying in the air at that cot and the answer is to move the cot (or find the interferer); if K is large, the node's own radio queue is the problem and the fix is in the node's pacing. **Still open:** the four-fold window compression (which would shorten every burst and shrink the airtime a cry costs), the BLE advertisement surviving a busy radio (D-61), the BLE alert path not arbitrating to the loudest cot, and the battery dividers not yet wired. |
| 2026-11-03 (this session, latest) | **The "node 2 and 3 don't detect" fault is diagnosed, and it is not the hub being overloaded — it is node 3's radio path eating the burst.** The user played a cry at all three cots (hub capture `%TEMP%/hub_3diag.log`, 243 KB, the new diagnostic build): node 1 ALERTed twice, node 2 ALERTed once (P=0.9961, 8 s after its window froze, burst 286/286 in 1.09 s), node 3 never announced. **Three findings, each from the diagnostics now in the firmware:** (1) **The hub polls all three fairly and is not saturated** — 55 pulls in the session, split 10/22/23 across nodes 1/2/3, bursts strictly one at a time, and node 2 *completed* every burst at a weaker signal (-62 to -66 dBm) than node 3 ever managed. (2) **Node 3's bursts die in the air.** The hub asked node 3 for a window 23 times and **not one of the 23 bursts ever completed**: each froze a loud, real cry window (rms 0.10–0.25, CRC advertised), the burst stalled with only 24–72 of 286 fragments arrived, and the arrival pattern is dots scattered uniformly across the whole burst — not a solid run cut short, which would mean the node stopped pumping. The RSSI diagnostic makes it conclusive: node 3's burst frames arrive at **-56 to -61 dBm, the same strength as its own telemetry frames (-56 to -59 dBm)**, which pass continuously; and node 2 completes full 286-frame bursts at -62 to -66 dBm. So the node *is* sending everything at full signal, and ~90 % of its 240-byte frames are lost while 32-byte frames sail through — length-discriminating loss, the signature of a local pulsed interferer near node 3 (USB3 port, laptop Wi-Fi/BT, phone hotspot) or a marginal antenna on that board, not distance and not congestion at the hub. (3) **A consequence-amplifier: node 3 churns its frozen windows** — its noisy room straddles its own trigger, so it refroze every ~1.3–3 s (seq 492→493→…→501 within 25 s), the hub rightly abandoned each in-flight burst for the newest ("the node moved to window X while Y was in flight"), and even a modest loss rate could then never be out-run; one request frame was itself lost, so the node's served-hold never engaged and the 3 s `FROZEN_HOLD_MS` expired early. Fixing the air loss alone should end the churn: with requests arriving, holds engage. Node 2's second-trial miss was the model refusing quieter windows (rms 0.047 crest 8.2 and rms 0.039 crest 2.7 both scored `no cry`) — a placement/loudness issue, not a link one. Node 1 at -28 dBm is on the bench next to the hub; that is why it wins every time. | `firmware/hub_infer/components/node_link/*`, `firmware/hub_infer/src/link_stage.c` (committed as `43ed8ab` on `feature/faster-detection`, hub build SUCCESS 38.6 s) | **Next bench test (decides hardware vs placement): physically swap node 2 and node 3's positions and play a cry at both.** If the loss follows the *position*, find the interferer (unplug the laptop's USB3 devices, move phones); if it follows the *board*, it is node 3's antenna/radio. During the same play, capture node 3's serial (`node_console.py --port COM38 --send stats`) — `served 286 fragments in ~1000 ms` proves the pump and `queue full 0` proves its TX, closing the node-side question for good. No reflash is needed: the diagnostic build is already running on the hub. |
| 2026-11-03 (this session, later) | **The system now answers a cry in about two seconds instead of five to seven — branch `feature/faster-detection`, measured on the bench.** The analysis came from the hub's own log (`research/live_phone_cry_2026-11-01.log`): a burst took **3.40–3.70 s** of the 5–7 s, the rest being 1.2 s of node-side waiting, up to 2.5 s of hub cooldown and 0.15 s of front end plus inference. **Three faults, found by reading the logs rather than by guessing, and each one measured:** (1) **The node handed the radio one fragment at a time and waited for that fragment's own acknowledgement** — the node's counters said `tx wait: avg 2339 us` per frame, 286 frames, plus a fixed 4 ms gap: about twelve milliseconds a fragment, of which the air time is a small part. The node now keeps four frames in the radio at once, waits for a *group*, and the fixed gap is gone. (2) **The first attempt made it worse — the burst went to 7.2 s — and the node's counters said why: `time req=7230 ms` beside `pump max_us=29954`. Reading the microphone while the radio was busy was meant to stop the node going deaf during a burst, but a microphone read blocks until the samples arrive, so the burst was paced by the rate the microphone produces audio and not by the radio. **The microphone now has a FreeRTOS task of its own** (`capture_task`), it owns the I2S peripheral, and the main loop never waits for audio: the radio is fed as fast as the radio can carry it and the node keeps listening while it is talking. (3) **One fragment in every burst was being lost, always among the first thirty, always exactly one.** The hub now counts frames that *arrived* separately from frames it *stored*, and the count said the frame never arrived at all. The cause is the hub's own Bluetooth: the ESP32-S3 has one radio for both, and while the Bluetooth stack sends an advertisement the Wi-Fi receiver is deaf; the advertising interval is 100 ms and the hub stopped advertising only *after* it had sent the request for the window, so the advertisement already in flight always slipped through and deafened the receiver for exactly the moment the first fragments were arriving. **The advertising now stops the moment the hub hears a cot getting loud** — half a second before the window arrives, so the radio is quiet by the time the burst starts, and nothing is added to the reaction time. Two more from the same logs: the node froze a new window every half second while a cry was going on (its "preempt the hold" rule compared against the *trigger level*, and a sustained cry is far above that, so the hold was cancelled every time), which made the hub abandon the burst it was assembling and ask for the newest window instead — it now compares against the window already frozen, which asks the question that was meant: is this a new event, or the same one going on?; and the hub's stall margin was 1200 ms, longer than a whole burst, so a genuinely stalled burst was never believed. **Measured: the burst 3.4 s → 0.90–1.00 s, eight bursts with no stall, no resend and every window's CRC-32 matching.** | `firmware/node/node_crynet/node_crynet.ino`, `firmware/hub_infer/src/link_stage.c`, `firmware/hub_infer/components/node_link/*`, `firmware/hub_infer/components/ble_alert/*`, `firmware/tools/measure_latency.py`, `SYSTEM_UPDATE.md` | Node build: 75 % flash, 50 % RAM. Hub build: RAM 13.0 %, flash 62.6 %. **The next lever is sending fewer bytes, not sending them faster**: 286 frames × 240 bytes is 64 KB for two seconds of audio, and the radio now carries them as fast as it can (≈3.5 ms a frame). 4:1 compression of the window would take 286 frames to 72 and the burst to ≈0.3 s — a new wire format, a decoder on the hub, and the model's behaviour re-validated on decoded audio, so it is a project of its own. **Also measured:** the node's `battery none` trust gate still holds on every USB-powered cot, and the panel's card layout (the RMS number crowded against the COT label) is still the user's deferred UI item. |
| 2026-11-03 (this session) | **The chain that answers a cry is being cut from five to seven seconds down to about two — branch `feature/faster-detection` (off `feature/node-battery-soc`), compile-verified on both sides, NOT yet flashed.** The measurement came from the hub's own log (`research/live_phone_cry_2026-11-01.log`): a burst took **3.40–3.70 s** of the 5–7 s the system took to answer, and the rest was 1.2 s of node-side waiting, up to 2.5 s of hub cooldown, and 0.15 s of front end plus inference. The burst was slow because the node handed the radio **one fragment at a time and waited for that fragment's own acknowledgement** (the node's own counters: `tx wait: avg 2339 us` per frame, 286 frames, plus a fixed 4 ms gap) — about twelve milliseconds a fragment, of which the air time is a small part. Four changes, all on the path: **(1) the node now keeps a few frames in the radio at once** (`TX_INFLIGHT_MAX 4`, counters for frames queued / acknowledged / in flight) and waits for a *group*, which is what ESP-NOW's ten-deep queue is for; **(2) the fixed gap between fragments is gone**; **(3) the microphone is read while the radio is busy** (`drain_mic`, ten times a second, taking only the audio that has arrived), because the node used to read nothing during a burst — the driver's DMA overflowed, the live window was thrown away, and the cot went deaf for the two seconds the window took to refill, which is also why the hub's cooldown had to be 2.5 s; the window is now only dropped if a read actually comes back short (`g_window_damaged`); **(4) the node's peak delay is 500 ms instead of 1000** — the one-second wait existed to centre the two-second window on the cry, and the model does not need the cry in the middle, only inside it. On the hub: the cooldown 2500 → 1500 ms, the stall margin `FRAG_PER_FRAGMENT_MS` 15 → 4, `RESEND_MIN_FLIGHT_MS` 2500 → 1000 (it was longer than a whole burst, so a genuinely stalled burst was never believed and the hub sat out the full 15 s timeout), and the main loop 50 → 20 ms. | `firmware/node/node_crynet/node_crynet.ino`, `firmware/hub_infer/src/link_stage.c`, `firmware/tools/measure_latency.py`, `SYSTEM_UPDATE.md` | Node build: 75 % flash, 50 % RAM. Hub build: SUCCESS, RAM 13.0 %, flash 62.5 % (the dead `s_swept` warning went with it). `measure_latency.py` now also reports **sound → verdict** and **sound → request**, which is the number the user actually feels, instead of only request → verdict. **Not yet on hardware — the boards are off the USB bus, so nothing here is measured.** The burst time is the number to watch: if it does not fall well under a second, the cost is the radio's own per-frame overhead and the next lever is sending fewer bytes (4:1 compression of the window), not more batching. |
| 2026-11-03 (later still) | **All three cots now run the battery firmware.** Node 2 (`90:DA:72:87:CB:98`, COM37) and node 3 (`90:DA:72:85:E0:4C`, COM38) were reflashed with the branch's node image — both keep their saved NVS ids (node 2 answers `node id 2 (saved; the MAC would have said 1)`, node 3 answers `node 3`), and both report `battery none (USB, or the divider is not wired)`, so the trust gate holds on every USB-powered cot. With node 1 (flashed earlier this session) all three now send the 18-byte telemetry, and the hub reads all three. Node 1 and the hub were off the USB bus for this session (device manager: present but disconnected) — the hub was already running the branch build, so nothing was left to write. | (no code changes - bench session) | The first node-1 upload of the session wrote the app at **0xe000** and the board refused to boot; `arduino-cli upload` puts it at **0x10000**, which is what this board's partition scheme uses. Always upload the node through `arduino-cli upload`, not a hand-written esptool command. |
| 2026-11-03 (later) | **The branch firmware is on the bench now: the hub shows the new cards, and node 1 runs the battery firmware — the "no RMS number" report was simply the old build still on the board.** The hub was plugged in and reporting LISTENING with no numbers under the bars; its log showed an app built **Oct 31**, i.e. the panel-fix build, because `feature/node-battery-soc` had only been compiled, never written. Flashed the branch build: **boot self-test PASS (4 probes)**, `ili9341: the panel is up: 320 x 240`, and all three cots heard at once — node 1 (`90:DA:72:85:C5:44`), node 2 (`90:DA:72:87:CB:98`), node 3 (`90:DA:72:85:E0:4C`) — with sensible levels (0.004–0.019) and no zeros from any of them. The radio-deaf offline rule and the "worth pulling" gate are therefore running on the board for the first time. Node 1 was then reflashed with the new node firmware: the first attempt wrote the app at **0xe000** and the board answered *"No bootable app partitions in the partition table"* (this board's Arduino partition scheme puts the app at **0x10000**) — re-uploaded with `arduino-cli upload`, which uses the board's own offsets, and it came up clean: `node id 1`, `hub is 30:30:F9:17:2F:80`, and the hub now sees its frames as **34 bytes** (the 18-byte payload) where nodes 2 and 3 still send 32. Its console says **`battery none (USB, or the divider is not wired)`** — the trust gate holding its ground on a floating pin, exactly as designed. Nodes 2 and 3 still run the old node firmware; they need no reflash until the dividers are wired (the hub reads by length), but they also send no battery field yet. | (no code changes - bench session) | A leftover `crynet_hub_watch.py` process was holding COM32 and had to be killed before anything could read the hub. The panel's **LISTENING** banner is the normal dashboard state, not a fault — the third page (the colour check) is behind the BOOT button. |
| 2026-11-03 (latest) | **The panel now shows each cot's own sound level and its battery band, and the cots measure their battery — branch `feature/node-battery-soc` (stacked on `feature/link-radio-deaf`), compile-verified on both sides, not yet flashed.** The cards carried a level bar but no number and no battery; under each bar there is now a detail line — the cot's own RMS on the left, and on the right `BAT ~78 %` (green), `BAT LOW - CHARGE SOON` (amber) or `BAT CRITICAL - SWITCH OFF AND CHARGE` (red), the strings §7 of `SYSTEM_WIRING.md` proposed. The node samples GPIO3/ADC1_CH3 through the designed 220 k/100 k divider (one averaged calibrated reading every 4 s, ×32/10 to the cell), gated by a trust rule — three consecutive in-range readings (0.80–1.50 V at the pin) before it believes the divider is wired, two out-of-range to stop believing — so every cot on today's USB bench reports **no reading** and the panel shows nothing rather than a floating-pin invention. The band moves on ±30 mV hysteresis so one radio dip cannot flash LOW; the percentage comes off a generic resting-voltage Li-Po curve, shown with a tilde, and `BAT_CURVE` in `hub_display.c` is where the real cell's profiled curve goes. The telemetry payload grew 16 → 18 bytes (cell mV after the CRC); the decoder reads by length, so old hubs decode new nodes and new hubs show nothing for old nodes — **the hub can be flashed first, the three cots only need reflash when the dividers are wired**. Cards grew 40 → 44 px (step 47); `research/ui_mock.py` renders the same and its three dashboard PNGs are regenerated. | `firmware/node/node_crynet/node_crynet.ino`, `firmware/hub_infer/components/crynet_proto/*`, `firmware/hub_infer/components/node_link/*`, `firmware/hub_infer/components/hub_display/*`, `firmware/hub_infer/src/link_stage.c`, `research/ui_mock.py` | Hub build: SUCCESS (RAM 13.0 %, flash 62.5 %). Node build: 75 % flash, 50 % RAM. The uncommitted radio-deaf offline fix from the previous session was compile-verified (SUCCESS, 13.7 s) and committed as `0186a54` on `feature/link-radio-deaf` — it has never run on the board. **Node 2 health check, from the captures:** in `hub_v22.log` (today 09:56) node 2 sent 540 telemetry lines with **zero** `rms 0.0000` readings and no reboots, against 94/470 (20 %) zeros in `hub_v21.log` (today 09:10) — but node 1 on the *same laptop* in v21 had 0/818 zeros and the node sketch is unchanged (`298d5c0`) between the sessions, so the zeros were board/port-specific, not firmware; they should be expected to return if node 2 goes back on that laptop's port. |

| 2026-11-03 (latest) | **Node 3 is flashed, named and on the air.** The third Pro Mini (`90:DA:72:85:E0:4C`, COM38) was flashed with `main`'s node firmware (clean compile, 74 % flash) and — exactly like node 2 before it — **derived the id 1 from its MAC**, which would have put two cots on one card; `id 3` was set and **verified across a hard reset** (esptool `run`): after the reset it still answers `node 3  mac 90:DA:72:85:E0:4C`, so the NVS id really does survive. The hub agrees — its log reads `node 3: rms 0.0210 ...` and it asked the new cot for windows (3 requests sent, 0 failed). **Node 2 needed no reflash**: the node sketch's last change is still `298d5c0`, the id-persist build node 2 was flashed with, and a reflash does not erase NVS anyway — so its id 2 is intact and only a read-only `status` check is worth doing. | `SYSTEM_UPDATE.md` | The node's capture path is unchanged from nodes 1 and 2, so no code changed for this. **Next:** all three cots plugged, to see three cards and confirm the hub still attributes a cry to the cot that hears it. |
| 2026-11-03 (later) | **The panel fix verified on the real panel, and the two-second rule confirmed from the hub's own log.** The hub was plugged in and flashed from `main` (RAM 13.0 %, flash 62.5 %); it booted clean, the model self-test PASSed (4 probes, front end and model agree with the host), and the panel then behaved as intended — COT 1 ONLINE while the node was plugged, OFFLINE within about two seconds of the unplug, the NODE pill green→amber, the banner LISTENING→SEARCHING FOR THE COTS, and ONLINE again on the replug. **The log proves the liveness window rather than leaving it to the eye:** while the node was plugged the hub sent **no** probes at all; two seconds after the last telemetry it began probing **every 2 s**; and the instant telemetry returned the probes stopped again. One rule — two seconds of silence — therefore governs the cards, the banner, the pill and the radio. (An apparent four-minute delay in the probe restart was a misreading of a capture file that was still being written, while the node was being plugged and unplugged.) | `SYSTEM_UPDATE.md` | No code changed since the merge; the hub ran `main`'s firmware for this session. Node 3 is wired but not yet enumerating on USB. |
| 2026-11-03 (earlier) | **The panel now notices an unplugged cot within about two seconds, and the header pills read NODE and WEARABLE with one shared colour rule (branch `feature/hub-display-status`, merged to `main`).** The user unplugged a node and the card stayed ONLINE — because `link_stage.c` latched `heard = true` forever: nothing ever cleared it, so the card, the banner and the RADIO pill froze on the last state a node was in. The fix: telemetry arrival now stamps `last_heard_us`, and a `node_live()` helper (silence < **2 s** — telemetry arrives every ~100 ms, so the timeout is twenty missed frames and cannot trip on one lost burst) replaces the raw flag in every caregiver-facing spot. A quiet cot keeps its card (the caregiver needs somewhere to look) but it reads **OFFLINE** with the level bar empty, stops driving the banner and the pill, and — a small recovery bonus — the hub **resumes probing** once every cot has gone quiet instead of waiting forever beside a dead link. The nomenclature: **RADIO → NODE** (it is the cots' link, not a radio as such) and **PHONE → WEARABLE** (the thing on the wrist; eight characters still fit the 320 px header with a 4 px margin). The NODE pill's offline colour is **amber**, not the old dim grey, so both pills follow one rule the caregiver learns once: green working, amber waiting. `research/ui_mock.py` was kept in sync. Node 1 (Pro Mini, COM31) was reflashed with main's node firmware — untouched by this branch — and answers `node 1  mac 90:DA:72:85:C5:44`, pumping telemetry. | `firmware/hub_infer/src/link_stage.c`, `firmware/hub_infer/components/hub_display/hub_display.c`, `research/ui_mock.py`, `SYSTEM_UPDATE.md` | **The hub was unplugged for all of this, so the hub firmware is compile-verified only** (`pio run`: RAM 13.0 %, flash 62.5 %) — flash it from `main` at the next bench session and watch an unplug flip a card to OFFLINE within ~2 s. |
| 2026-11-03 (later) | **The distinguishing test PASSED properly this time — the nodes were on separate machines, the cry was played at node 1 first and then at node 2, and the hub attributed each cry to the cot that heard it.** Arrangement: hub + node 1 on the development PC (COM32 / COM31, node 1 = MAC `90:DA:72:85:C5:44`), node 2 + the wearable on the second laptop. Raw capture of both (`hub_v22.log`, `node1_v2.log`, 260 s). **The result, in the hub's own words:** at t=117.0 s node 1's window scored `P(cry)=0.9961` → **ALERT — cry** (rms 0.1434, peak 23463, crest 5.0); at t=147.5 s node 2's window scored `P(cry)=0.9961` → **ALERT — cry** (rms 0.2582, peak 32859, crest 3.9). **The attribution flipped exactly as it should**, and it was decided on level, not luck: during node 1's play node 2 was at rms 0.0219 (refused, `no cry`), and during node 2's play node 1 was at rms 0.0192 — refused by the **too-quiet gate** (`cry (too quiet to announce)`, P(cry)=0.9688 at rms 0.0192 < 0.020) rather than by the model. Node 2's own first cry window (rms 0.0999, P=0.9805) was correctly held as `cry (unconfirmed)` and confirmed by the next window. **The link was clean throughout: 56 bursts, all 286/286, 0 CRC mismatches, 0 timeouts, 22 660 frames off the air with 0 bad and 0 failed requests.** **Two follow-on facts, both real:** (a) **the wearable connected late, and the cause is now known** — the hub advertises only when `!s_connected && !s_radio_busy` (`ble_alert.c`), and this session's radio duty cycle was **89 %** (230 s of burst airtime in 260 s), so the hub was silent to BLE for most of the session and the wearable's scan had to wait for a gap. That is the D-61 advertising policy colliding with a busy radio, and it is worth fixing: the wearable is the thing that has to be found. (b) **The polling fairness improved a lot with the nodes apart** — node 1 took 38 requests and node 2 took 35 (round 2, same room, was 31 vs 19), and the 66 stall warnings remain the resend path working, not a failure. | (no code changes - verification only) | Logs: `%TEMP%/hub_v22.log`, `%TEMP%/node1_v2.log`. **Now proven:** the hub attributes a cry to the cot that actually hears it, with the two cots in different places. **Still open:** the BLE advertisement must survive a busy radio (the wearable's late connect), and the BLE alert path still publishes per-node without arbitrating to the loudest cot the way the panel does. |
| 2026-11-03 | **The two-node distinguishing test ran for real, but the arrangement has to be described honestly, because it changes what the result means.** Round 2 (fresh capture, hub COM32 + wearable COM30 raw-logged together, both nodes on the second laptop): the cry was played at the nodes' location, and the hub logged **5 ALERT lines — 3 for cot 1 and 2 for cot 2** (the fifth, at t=277.5 s, is a re-announce while cot 1 was already active, so the state-change publish rule sent no BLE event for it) — while the wearable's own log independently recorded **7 BLE events: `ALERT cot 2`, `ALERT cot 1`, `cancel cot 2`, `cancel cot 1`, `ALERT cot 1`, `cancel cot 1`, `ALERT cot 2`** — 4 cry alerts and 3 cancels, the counts matching the hub's announcements one for one. So both cots are visible on the wire and on the wrist unit, the ids travel correctly through the hub, and the cancel events arrive. **Two real findings came out of it, and one of them corrects an earlier claim.** (a) **The nodes were on the SAME laptop this time**, so they sat centimetres apart: the round-1 result (4 ALERTs, all cot 1) was measured with the nodes on different machines and is not comparable to this one — this round proves *both* cots are heard and correctly labelled, not that one node is preferred. (b) **The 75 `the burst stalled` lines are not a link failure**: every one of the 48 bursts still finished at **286/286 fragments with 0 CRC mismatches and 0 timeouts**, and the stalls are the hub asking for the fragments it did not have yet — the recovery path working, not the link breaking. The round-1 log showed *zero* stalls only because `listen_hub.py`'s regex matches `I (...)` lines and silently **drops every `W (...)` line**, so the stall warnings were never captured; the raw capture in round 2 shows them. (c) **A real defect the test exposed:** with both nodes in the same room, the hub asks both for windows at once and their bursts **overlap in the air (28 of 48 bursts, 36 of 50 requests)** — the radio is at **86 % duty cycle**, and node 1 got 31 requests against node 2's 19, so the two cots are **not polled fairly**. The panel already arbitrates to the loudest crying cot (`link_stage.c`, the `show` loop), but the **BLE alert path publishes per-node and does not arbitrate** — hence the wearable saw cot 2 and cot 1 alternating for what is one physical cry. | (no code changes - verification only) | Logs: `%TEMP%/hub_v21.log`, `%TEMP%/wearable_v4.log`. **Not yet proven:** that the hub attributes a cry to the *nearest* cot when two cots hear it (needs the nodes physically apart), and that the fair-polling and BLE-arbitration gaps above are worth fixing. |
| 2026-11-02 | **Node ids now persist in flash (branch `feature/node-id-persist`), because the second Pro Mini derived node 1's id.** The user's wearable confirmations landed first: the onboard LED blinked on every alert (the haptic stand-in fires) and the screen returned to idle via `cleared` — stage 2d's remaining checks closed. Then the node-2 board (`90:DA:72:87:CB:98`, COM37) was flashed with main's firmware and answered `node 1` — the MAC-derived rule `(mac[5] & 0x0F) + 1` collided across identical boards, and the old `id <n>` command was RAM-only, so a power cycle silently reverted it. The fix, small and backward-compatible: `id <n>` writes the id to NVS (`Preferences`, namespace `crynet`), boot loads the saved value and keeps the MAC-derived number as fallback for never-named boards, and the boot line says which source won (`saved; the MAC would have said 1`). **Verified on the real board: `id 2` → saved → hard reset via esptool → status still answers `node 2`.** Node 1 keeps running main's firmware (its derived id is 1 and correct). The distinguishing test — cry near cot 1 vs near cot 2, hub must attribute to the loudest — is next. | `firmware/node/node_crynet/node_crynet.ino`, `SYSTEM_UPDATE.md` | Branch `feature/node-id-persist` off `main@7758717`; compile 74 % flash; NVS survives normal reflashes (not a full `--erase-all`). |
| 2026-11-02 | **Wearable verified live: hub ALERT → wearable OLED, first time.** Bench: hub on COM32 + node 1 (Pro Mini, COM31) on the laptop, wearable SuperMini (COM30) on a second laptop for power — its serial lives there, so the OLED was read by eye. The wearable attached and subscribed on its own (read the state characteristic: `0 cot(s), mask 0x00`), then one cry play: **hub fired 8 × `ALERT — cry`; the wearable displayed `COT 1 / CRY 100%`** — microphone → node → ESP-NOW → model → BLE notify → OLED, witnessed end to end. The play's windows sat at win rms 0.0621 `(cry mode)` — right in the volume recipe. The user-observed LED blink (haptic stand-in) and the `cleared` transition are still to be confirmed by eye. Two bench findings: (1) **the power bank cycles even the wearable's light load** — screen dies after a while; every board needs stable USB power (second laptop works; powered hub planned); (2) the node on the bank showed the failure signature clearly — telemetry alive, bursts never completing, hub re-asking seq 1 — and on USB served 8/8 bursts with zero reboots, so the firmware is innocent. The scan-debug line in the sketch stays until the multi-node test; the alert test is **closed**. | `SYSTEM_UPDATE.md` | Logs in `%TEMP%/hub_v18, node_v16, hub_v19, node_v17, wearable_v1–v3.log`. Branch `feature/wearable-alert`; `main` untouched. |
| 2026-11-02 | **Wearable firmware written — the BLE client side of the alert contract, compiled but not yet flashed.** New sketch `firmware/wearable/wearable_crynet/wearable_crynet.ino` on branch `feature/wearable-alert`: scans for the hub (`INFANT_MONITOR_HUB`, service `19b10000-…`), subscribes to the six-byte alert characteristic, renders cot / confidence / event on the SSD1306 (SDA GPIO5, SCL GPIO6, 0x3C), reads the state characteristic once on connect so a mid-cry attach still shows the cry, reconnects by rescanning. The motor does not exist yet: `haptic_trigger()` is the DRV2605L hook and the onboard LED (GPIO8) blinks as the stand-in, so the notify→physical-reaction path is testable now. Compiles clean for `weact_studio_esp32c3` (51 % flash, 5 % RAM) against esp32 core 3.3.12 (by-value `onResult`, reused `BLEClient` — the core resets `m_haveServices` per connect, so one client object survives reconnects). `install_sketches.py` now installs the wearable too. The alert test (wearable + hub, play a cry) is next; nothing is merged to `main`. | `firmware/wearable/wearable_crynet/wearable_crynet.ino` (new), `firmware/tools/install_sketches.py`, `SYSTEM_UPDATE.md` | Not verified on hardware: OLED wiring untested, BLE interop with the NimBLE server unproven, LED pin 8 active-low assumed. Branch `feature/wearable-alert` off `main@7758717`. |
| 2026-11-02 | **ESP32-C3 Pro Mini verified as the node board (live, on the desk).** The user swapped the SuperMini for a Pro Mini and the same firmware was flashed unchanged via arduino-cli (`weact_studio_esp32c3`, native USB VID 303A:1001, COM31). Correlated captures (`$TEMP/hub_v14.log`, `node_v14.log`, then the play capture `hub_v15.log`, `node_v15.log`): link up at once (hub heard it as **node 1**), bursts 286/286 served, quiet room ~20 windows all refused, then **two cry plays → two ALERTs**: seq 51 frozen at 69.7 s (win rms 0.0504, cry mode) → ALERT 73.3 s (~3.6 s later), seq 52 frozen 75.3 s (0.0420) → ALERT 77.8 s (~2.5 s later). Two tail `resend refused` lines were the known hub-side timing wart, present in earlier sessions too, not a board regression. **Board plan settled: nodes = Pro Mini (×3), the existing SuperMini moves to the wearable.** No firmware changes; `main` untouched. | `SYSTEM_UPDATE.md` | Verification session; logs in `%TEMP%/node_v14, hub_v14, node_v15, hub_v15.log`. |
| 2026-11-02 | Completed the battery-powered wiring design from the photographed LX-LCBST-TC-001 pad map (B+/B− battery, VO+/VO− output ×2, IN+/IN− input unused, USB-C charging, trimpot → 5.1 V). Fixed the wearable pins (SDA 5 / SCL 6, LEDs GPIO1/GPIO4 — GPIO0 is a C3 boot strap and the earlier assignment was wrong), assigned the hub BLE LED to GPIO2 (normal pin on the S3; S3 strapping is 0/3/45/46) and the SOC LED to GPIO17, and rebuilt the five-page diagram PDF with complete per-unit wiring (node ×3, hub, wearable, module pad map + bench procedure). The user's board swap is planned in: Pro Minis → nodes, the existing SuperMini → wearable. | `SYSTEM_WIRING.md`, `SYSTEM_WIRING_DIAGRAMS.html`, `SYSTEM_WIRING_DIAGRAMS.pdf`, `HARDWARE_COMPONENTS.md`, `SYSTEM_UPDATE.md` | All battery-chain wiring is proposed, not built: charge current, boost quiescent drain and the unlabelled front −/+ pad remain unmeasured; one module must pass bench validation before the rest are bought; firmware (divider, LEDs, heartbeat ACK, SOC display) does not exist yet and goes to a branch. |
| 2026-11-02 | Added a preliminary GPIO, ADC divider, LED and application-ACK design to the wiring document after user requested estimated SOC and real hub acknowledgement. | `SYSTEM_WIRING.md`, `SYSTEM_UPDATE.md` | Design only: exact board/protection topology, unpowered ADC isolation, GPIO exposure and firmware remain unverified; do not assemble from assumptions. |
| 2026-11-02 | Created a separate four-page illustrated wiring guide: verified node and hub pin-to-pin wiring, proposed wearable bus and a clearly labelled battery power architecture. | `SYSTEM_WIRING_DIAGRAMS.html`, `SYSTEM_WIRING_DIAGRAMS.pdf`, `SYSTEM_UPDATE.md` | PDF text and page boundaries checked; wearable and battery details remain unverified, not a build-ready battery schematic. |
| 2026-11-02 | Exported the wiring guide to a three-page PDF and checked its text is present through the final section. | `SYSTEM_WIRING.pdf`, `SYSTEM_UPDATE.md` | PDF is a printable text guide; proposed battery wiring remains unvalidated. |
| 2026-11-02 | Added a point-to-point USB test wiring guide and proposed battery-system architecture; explicitly marked wearable pins, battery charger power paths, LED/ADC pin choices and portable circuits as unverified pending component selection. | `SYSTEM_WIRING.md`, `SYSTEM_UPDATE.md` | Documentation only; no new circuit or firmware has been tested. |
| 2026-11-02 | Expanded the hardware BOM at the user's request to include proposed battery power, chargers, boost converters, switches, battery monitoring and indicator components down to individual resistor and capacitor counts for the full system. | `HARDWARE_COMPONENTS.md`, `SYSTEM_UPDATE.md` | Planning assumptions only: circuit design, component compatibility, node indicator/ADC firmware and battery testing remain open. |
| 2026-11-02 | Replaced the old hardware specification with a current, quantity-based purchasing document. The user confirmed the hub TFT is 2.8 inches and declined further colour checking; additional-node testing awaits the other nodes. The recommended wearable uses a DRV2605L rather than the discrete MOSFET circuit; wearable power and motor selection remain open. | `HARDWARE_COMPONENTS.md`, `SYSTEM_UPDATE.md` | Documentation only; wearable, battery power and multi-node operation remain unverified. |
| 2026-11-01 (later) | **The correlated three-minute session detected the cry three times and measured the last two problems precisely.** The mic heard the phone cry at RMS 0.26-0.53 (the panel 0.265 was real - an earlier "live" listener had stopped before the user played and had measured silence; lesson: a listener must span the whole playing window or it lies). The node froze one window per cry segment, all cry-level, marked `(cry mode)`; the link ran 286/286 with CRC MATCH every burst; **three windows scored P(cry)=0.9961 and alerted; zero false alarms** before and after. **Two findings:** (1) **the hold cost 6.5-7.0 s between every burst** - with cry mode capping freezes, the 8 s hold (D-67) lost its queue duty, so `FROZEN_HOLD_MS` returned to 4000 (D-71); (2) **the phone now clips the microphone** (peaks pegged at 32694-33100 of 32767) and clipped cries are a lottery for the model (3 of 13 loud windows recognized, vs every window in session 1 unclipped 45-75 % range) - the demo must play the phone quieter, targeting the panel level of ~0.10-0.20. | `firmware/node/node_crynet/node_crynet.ino` | *The node did not reboot in this session; the v8 reboot remains unexplained but has not recurred.* |
| 2026-11-01 (later) | **The second verification session found the real latency bug: the node froze faster than the hub could empty the queue.** D-66 removed the re-request loop (verified: no seq was asked for twice), but the first cry alert still took ~27 s. The node was freezing a new window every ~4 s (the hold was 4 s and during a continuous cry the loud streak never drops, so the node freezes the moment the hold expires) while the hub processes one window every ~4 s - the two rates matched exactly and the queue never drained: the first cry window (seq 17, frozen at 87.7 s) waited behind seqs 13, 14, 15 and 16 and was not judged until 115.4 s. **Fix (D-67): `FROZEN_HOLD_MS` goes from 4000 to 8000.** The node now freezes at most one window every 8 s while the hub empties one every 4 s, so the hub stays ahead. Eight seconds still covers the hub's three resend rounds. Expected first alert at 15 cm: ~5 s (1 s peak delay + ~4 s burst) instead of 27 s. **Not yet verified on the live boards** - built, flashed, node boots and runs. The second session also confirmed: **the 1 m cry is genuinely detected** - seq 21 (frozen at 109.85 s, win rms 0.0103) was judged at 141.98 s at P(cry)=0.9961, and by then the phone was at 1 m (rms dropped from 0.28 to 0.015 at 105 s). 14 verdicts, 3 cry alerts, 0 false alarms on the quiet windows (0.0000-0.9883, none announced). | `firmware/node/node_crynet/node_crynet.ino` (FROZEN_HOLD_MS) | *The second session also confirmed the burst still completes 286/286 with CRC MATCH every time, and the burst length is still a range (3.40-6.93 s) from WiFi contention. The "resend refused" fragility did not recur (D-66 side effect).* |
| 2026-11-01 (later) | **The re-request loop that hid the one-metre cry is fixed.** The first verification session (phone at 15 cm, then at 1 m) worked — the cry at 15 cm announced 7 times at P(cry)=0.9961, the cry at 1 m reached the model and was called a cry at P(cry)=0.9961 (win rms 0.0103, where the trigger had been 0.030 before), and **no false alarms** in the quiet windows (0.0000-0.0195) — the 0.9219 near-silent window was correctly not announced. **But the first alert at 15 cm took ~21 s, not 2.5 s.** Root cause: the hub re-requested the *same* frozen window up to four times in a row (seq 100 was asked for four times), and each serve reset the node's 4 s hold timer, so the node could not freeze the new loud window until the hub stopped asking — the new cry sat unfrozen for ~15 s. The re-request never helped anything: re-judging the same window gives the same answer, and the run rule counts distinct sequences, which a repeat never advances. **Fix: the hub now records the seq of every window it actually receives and judges (`last_completed_seq`) and will not request a frozen window whose seq it has already judged; it waits for the node to advertise a new one.** Side effect: the "resend refused: no frozen window for it" fragility (four times in the session) disappears, because the node is no longer asked to re-serve a window whose hold has expired. First alert at 15 cm should now land ~3 s after the cry starts. **Not yet verified on the live boards** — the fix is built and flashed, boot self-check passes, but the latency number is from analysis, not measurement. | `firmware/hub_infer/src/link_stage.c` (struct field + burst-complete assignment + request condition) | *The session also confirmed the burst still completes 286/286 with a CRC MATCH every time, and that the burst length is still a range (3.45-7.48 s) from WiFi contention on channel 6. The 1 m result is real but the transition window (seq 103) could be the tail of the 15 cm cry rather than the 1 m cry — the user's move timing is unknown; a second short session would settle it.* |
| 2026-11-01 (late) | **The adaptive trigger is built on both boards — the node owns the noise floor and the hub obeys it — and it exposed a real fault: the model is not a reliable judge of a near-silent window.** The multiple was chosen from the recorded sessions (`research/adaptive_trigger_study.py`): at **three times the node's own noise floor** the cry a metre away goes from 0 trigger events a minute to 39, the quiet room gives 5, and the loud sessions are capped by the old fixed 0.030, so the rule is never worse than before. The **node** owns the floor (it falls at once when the room gets quieter, rises with a 50 s time constant so a long cry cannot drag the floor up to its own level) and the level that follows from it; the level travels in the telemetry's payload 7 in milli-RMS, beside the frozen window's own level and the floor, and the **hub triggers on the number the node reports**, falling back to `CRYNET_TRIGGER_RMS` for an older node. The node now arms its freeze on **two** consecutive readings at or above the level — the rule the hub and the study both use — and the telemetry is 16 bytes. **Measured live:** the level tracks the room (0.006-0.016 in a noisy room; the node's own log reads `rms 0.0063 floor 0.0028 level 0.0083`), and the hub asks 5-11 times a minute instead of 1-2. **But the lower trigger asks the model about near-silent windows, and there the model is uncertain:** the same quiet room produced verdicts of 0.0000 and of 0.9766 for windows that differ by nothing a person could hear — the second of those a false alarm. **So the announcement rule changed:** one window announces a cry only when it is unmistakable (P(cry) >= 0.99, where the model's output saturates at 0.9961 for a clear cry, so the panel still shows the cry two and a half seconds after it happened); between 0.95 and 0.99 it is a *maybe* that the next window has to confirm. A cry lasts for seconds and its windows agree; a noise fluctuation that looks like a cry is not repeated. **And the node's transmitter was turned down to 8.5 dBm** — the radio sits centimetres from the INMP441 and was putting its own noise into the audio it was about to be judged on. Five minutes of a noisy room afterwards: **32 verdicts, 0 false alerts.** Two new instruments came out of the diagnosis: `firmware/tools/dump_node_window.py` (writes the node's frozen window out over its USB console) and `research/analyze_window.py` (says what is in a window — where its energy sits, how much of it is slow wander — and what the model makes of it). | `firmware/node/node_crynet/node_crynet.ino`, `firmware/hub_infer/components/crynet_proto/{include/crynet_proto.h,crynet_proto.c}`, `firmware/hub_infer/components/node_link/{include/node_link.h,node_link.c}`, `firmware/hub_infer/src/{link_stage.c,link_stage.h}`, `firmware/tools/{dump_node_window.py,listen_hub.py}`, `research/analyze_window.py` (new), `research/out/{node_window_quiet.wav,radio_test/*,dump_*.wav}` | *The diagnosis behind it, in short: the quiet-room windows the node freezes with the adaptive trigger carry broadband noise the recorded quiet room does not have, and the model reads that shape as a cry now and then (0.84-0.98). The same room recorded with the radio off (`node_capture`, which has no radio at all) is refused decisively (0.0000-0.1953), so the microphone's DC drift and the room's own noise are both innocent. The false alarms are what the node's own transmitter put into the window; turning the power down halved them and the announcement rule covers the rest.* |
| 2026-11-01 (last thing tonight) | **The demo's sound path is verified on the live boards: the cry from the phone at the node's mic is called a cry, and the whole chain runs in 2.2-5.4 s.** The user played the cry from a phone 10-15 cm from the INMP441 while the hub's log was read live (`firmware/tools/listen_hub.py`, new - it plays nothing itself, it only watches). **42 verdicts over a four-minute listen: 26 "ALERT - cry" at P(cry) 0.9922-0.9961 and 16 "no cry" at P(cry) 0.0078-0.2148** - the model's INT8 output falls into two clean clusters with nothing near the 0.95 threshold, so no verdict was a coin toss. **The link was perfect: 45 bursts, 45/45 with all 286 fragments, and not one stall, timeout, CRC error or resend round.** Request-to-verdict: min 2.23 s, median 3.72 s, max 5.35 s (mean 4.03 s), of which 0.15 s is the front end plus the inference. **The burst's length is a range now, not a constant: min 2.06 s, median 3.55 s, max 5.19 s** - the node paces at 4 ms, but the hub and the node share WiFi channel 6 and the per-fragment transmit cost is the *channel's* contention, so with the phone's WiFi on the same band each frame waits longer. That is the same contention term that made the burst 5.5-6.9 s before D-61, now visible as a range. **The 16 "no cry" verdicts are the architecture showing itself, not a classifier failure:** the node freezes the *loudest* two seconds it has heard and the hub judges that one window, so a window containing the cry that is not the loudest is never offered to the model at all; the no-cry verdicts fall in blocks (sequences 6, 8, 9, 16, 17, 22) and the cry verdicts in blocks (7, 10-15, 18-20). **The demo must use the phone** - D-61's laptop-speaker finding stands - and the demo's own claim is what now holds: a cry at the cot is called a cry. | `firmware/tools/listen_hub.py` (new), `research/live_phone_cry_2026-11-01.log` (new), `DECISIONS.md` (D-62, D-61 amended) | *The one number the user asked for: **the phone path works on the live hub** - 26 confirmed cries out of 42 judged windows, with the link never dropping a fragment.* |
| 2026-11-01 (later still) | **The card fills swapped, and the word shortened.** The user looked again and read the fills against the intent: the accent-washed fill on a live card read **faint**, the border-washed fill on a dead card read **denser and more active** — so they are swapped exactly as asked (a live card wears the border wash, an offline card the faint accent wash; the outlines, which the previous round fixed, stay). And at the user's suggestion the dead card's word became **OFFLINE** — shorter, and the network term for the state. Contrast re-passed (every threshold cleared), `research/ui_mock.py` mirrors both changes, flashed to the hub: boot self-check **PASS (4 probes, 5184/5184 exact)**, node heard on channel 6 immediately. | `firmware/hub_infer/components/hub_display/hub_display.c`, `research/ui_mock.py`, `research/out/*` (previews), `DECISIONS.md` (D-59 amended) | *The user is ready to record the confusion session (O-9) once this is confirmed on the glass.* |
| 2026-11-01 (later) | **The panel's second look from the chair: darker ground, a teal header, and the online/offline treatments swapped.** The background dropped another step of the dark ramp (`(4,8,8)` → `(2,4,4)`) because the cards at one step up still read as the same colour on the glass (the panel lifts the dark end until a two-step gap reads as one). The header got its own colour `(7,20,15)` — five steps of green above blue — because the backlight's LEDs run along the top edge of the glass and lift that strip blue: a header painted the same colour as the cards photographed blue while the cards photographed teal. A live cot's outline is now the **full-strength vibrant teal** (rose when crying) and a no-signal card recedes — outline and empty bar washed towards the background — the reverse of the 45 % blend the live cards carried before, which had the dead cards reading as the livelier ones. Contrast re-checked (every threshold cleared), `research/ui_mock.py` mirrors the new treatments, and the board was reflashed: boot self-check **PASS, 4 probes, 5184/5184 exact**, radio clean (450 frames parsed, 0 bad), one full window 286/286 CRC MATCH at inference 103 ms. | `firmware/hub_infer/components/hub_display/hub_display.c`, `research/ui_mock.py`, `research/out/*` (previews), `DECISIONS.md` (D-59) | *The Kaggle zip in `research/kaggle_out/` is the same artefact already unpacked and deployed (D-58) — no further action.* |
| 2026-11-01 (evening) | **The Kaggle re-run came back, the retrained model was measured, deployed, and verified 4/4 on the board — and the music false-alarm rate fell from 8.19 % to 0.21 %.** The user ran the training notebook and dropped `crynet_out.zip` (the improved download cell worked first try). The retrained model is the same architecture (122,770 params, conv_cnn, cross-AUC 0.9987) with new weights and a **recalibrated input** (`IN_SCALE` 0.060125612 → 0.116329655, `IN_ZP` −4 → −70; threshold 0.95, silence gate, output calibration and geometry all unchanged). Measured on the repo's own evals (`eval_music.py`, `eval_esc50.py`, `eval_indomain.py`): **music 2/965 = 0.21 % (was 79/965 = 8.19 %)**, ESC-50 non-cry 17/1439 = 1.18 % (was 2.64 %), ESC-50 `crying_baby` **36/40 — identical**, quiet room 0/236 — identical, phone-cry sessions INT8 recall 0.867 → 0.800 (session 1) and 0.724 → 0.592 (session 4, AUC 0.928 → 0.941). The trade was accepted on purpose: a cry is sustained, so an episode still trips many windows in a row, and music was the requirement the old model structurally failed. Deployment: `model_data.h`, `crynet_tables.h`, the staged copies in `research/out/`, the mirrored macros in `crynet_model.h`, and **regenerated probe references** (`firmware/tools/gen_probe_refs.py`) — the boot self-check then reads **RESULT: PASS — 4 probes, 5184/5184 features exact on every probe**, inference 102 ms, the noise probe alerts at P(cry) 0.9805, and the radio is clean (339 frames, 0 bad). | `firmware/hub_infer/components/crynet_model/include/{model_data.h,crynet_tables.h,crynet_model.h,deploy_config.json}`, `firmware/hub_infer/components/crynet_dsp/include/crynet_probe_refs.h`, `research/out/*` (new staged artifacts + eval JSONs), `research/kaggle_out/` (the zip unpacked), `DECISIONS.md` (D-58, I-41, O-8) | *The drift guards earned their keep: the build stopped on the `CRYNET_INPUT_ZERO_POINT` static assert, and the first boot failed its feature check 0/5184 exact until the probe references were regenerated for the new quantisation (I-41). The old model is backed up at `research/out/deployed_model_backup/`.* |
| 2026-11-01 | **The teal was picked off the panel itself, and the rounded corners were un-flipped.** The user photographed the colour check again and named the colour they want: **the dark ramp's third step, `(4,8,8)`, one step darker than the background it replaces** - and because a ramp step is a colour the firmware *asked for*, the choice is exact regardless of the camera (I-38). The neutral family moved down one step of the same ramp with it: background `(4,8,8)`, surface `(7,15,16)`, surface-hi `(12,26,28)`; the border `(78,116,112)` and dim text `(122,150,146)` kept, since contrast only improves as the background darkens (re-checked: text 16.5:1, dim 6.3:1, accent 8.5:1, alert 5.8:1, card border 3.72:1). **The corners**: the user saw every rounded corner 'sort of flipped' but the bottom-right one - and they were right. The corner loop walked its offsets only *inward* from each disc's centre, painting all four arcs inside the shape; bottom-right only looked correct because its inward quadrant happens to end at the shape's own edge. Each disc is now walked **towards its own corner** (per-corner signs), and a new regression check (`research/check_corners.py`) requires the four corners to be exact mirror images of each other and the fill's arc to hug a circle within 1 px - the old loop fails it, the new one passes. A new `research/measure_ramp.py` samples the ramp out of a photograph. **All nine local commits are now pushed to GitHub** (`crynet/main`), and pushes follow every commit from now on. | `firmware/hub_infer/components/hub_display/hub_display.c`, `research/check_corners.py` (new), `research/measure_ramp.py` (new), `research/out/*` (previews regenerated), `DECISIONS.md` (D-57, I-39, I-40, O-3) | *Built (RAM 13.0 %, flash 62.4 %) and flashed; the radio is clean (410 frames parsed, 0 bad, 0 bad payload, node answering at rms 0.004-0.014). One scare in the middle: the first upload attempts ran esptool against **the node's** port by mistake, which parked the C3 in its download mode and silenced the radio (0 frames for two minutes); `esptool run` on COM30 released it (I-40). The user has begun the Kaggle re-run; the retrained model is still outstanding.* |
| 2026-10-31 | **The colour-check page proved the hues are right and that this panel lifts the dark end - so the neutrals are now darker and teal-tinted, and the screen reads teal instead of blue.** The user pressed BOOT and photographed the swatches, and the page did exactly its job: **BLACK came back black, WHITE came back white, TEAL came back teal, GREEN green, AMBER amber and ROSE rose.** Every hue is right. But the fourth swatch - the old `(12,20,32)` navy - came back as a **saturated blue**, and the page's own background, the *same colour*, came back as a bright blue too, while the black swatch beside it stayed black. That is the panel lifting the dark end, and it lifts the **blue** channel hardest: the measured blue of the amber swatch (requested 36) came back at 145, about four times what was asked for. **The less blue the screen asks for, the less blue it gets**, so the neutrals were changed: the background is now `(7,15,16)` instead of `(12,20,32)`, the surfaces `(12,26,28)` and `(17,36,39)`, the border `(78,116,112)`, the dim text `(122,150,146)` - all darker and teal-tinted. The accent, green, amber and rose are untouched: what the screen *says* has not changed, only how much blue it asks for. Every contrast was re-checked: text on background 16.6:1, dim 6.1:1, accent 10.4:1, the card border 3.4:1 against the card it sits on. The colour check also grew a **dark ramp** - six steps of the same hue from black up - so the next photograph says in one row exactly how far up the dark end the glass lifts. | `firmware/hub_infer/components/hub_display/hub_display.c`, `research/ui_mock.py`, `DECISIONS.md` (D-56, I-38) | *Built (RAM 13.0 %, flash 62.4 %) and flashed; the radio is clean (110 frames off the air, 0 bad, 0 bad payload) with a node answering at rms ~0.005. The host-side previews are `research/out/ui_dashboard.png` and `research/out/ui_colour_check.png`. **What is needed now is one photograph of the colour check with the room lit** - in a dark room the phone opens up for the glowing panel, clips the highlights and drifts the white balance, which is why the swatches cannot be measured from the last photograph.* |
| 2026-10-31 | **The panel's colours were finally right, and the picture was still glaring: the backlight is now a brightness, and the BOOT button opens a colour check.** The second photograph of the panel settled the R/B swap: the `PHONE` square is now **warm orange** (it was blue), the accent underline under the header is **teal-green** (it was pink), and the `RADIO` square is cyan-green (it was olive) - all three confirmed against the *previous* photograph, which shows the same elements olive, pink and blue. **But the screen came out saturated blue overall, because the dark navy background was rendering as a bright blue.** The measurements say the panel is not doing that on its own: the old photograph, which was taken in a dark room and properly exposed, shows a near-black background rendering as a light pink-grey, and the new one is a close-up in a lit room whose highlights are clipped (the `RADIO` square measures (144,255,255) - fully blown out). A photograph of a glowing panel in a dark room is not a colour measurement: the camera opens up, the highlights clip and the white balance drifts with what it sees. So the fix is on the panel's side, not the palette's: **the backlight was a plain on/off pin at 100 %, and a TFT at full brightness in a dark room glares.** The pin is now a **LEDC PWM output** at 5 kHz with a default of **55 %** (`hub_display_set_brightness()`), and a **colour check page** - a grid of the palette's swatches, black and white at the ends of the first row, the alert colour last - opens on a press of the **BOOT button** (GPIO0). The swatches are the instrument: with them the panel's own colours can be read off a photograph without guessing, and the palette can be compensated if the panel's own black level really is lifted. | `firmware/hub_infer/components/hub_display/ili9341.c`, `ili9341.h`, `hub_display.c`, `include/hub_display.h`, `firmware/hub_infer/components/hub_display/CMakeLists.txt`, `research/ui_mock.py`, `research/measure_photo.py`, `research/compare_photo.py`, `DECISIONS.md` (D-55, I-37) | *Built (RAM 13.0 %, flash 62.4 %) and flashed: the panel comes up at 320x240 rotation 2 with `madctl 0x80`, and the radio is clean (109 frames off the air, 0 bad, 0 bad payload) with a node answering at rms ~0.01. `esp_driver_ledc` had to be added to the component's `REQUIRES`, and the CMake cache deleted for it to take. The host-side preview of the new page is `research/out/ui_colour_check.png`.* |
| 2026-10-31 | **The Kaggle download cell no longer assumes where the artifacts are.** The cell the user pasted failed with `FileNotFoundError: '/kaggle/working/out'`. The cause is in the notebook: its output directory is `OUT = Path(os.environ.get("CRYNET_OUT", "./out")).resolve()` - **relative to whatever the working directory was when the cell ran** - and the session that ran the notebook was not the session that looked for the result. The cell now (1) asks the notebook first, using the `OUT` variable that survives in the kernel if the export cell ran in this session, (2) otherwise searches `/kaggle/working`, the working directory, the home directory and `/tmp` for the artifacts **by name**, and (3) if it finds nothing, prints what *is* under `/kaggle/working` so the next session starts from facts instead of another guess. It still writes `/kaggle/working/crynet_out.zip` and offers it with `FileLink`, and the zip keeps the `out/` folder at the top of the archive. | `research/kaggle_download_cell.py` | *The same script is saved in the repo so it is not retyped. The retrained model is still outstanding: until the zip is unpacked, the deployed model false-alarms on 8.19 % of loud music.* |
| 2026-10-31 | **The footer's 'cots linked' count was counting the cards on the screen, not the cots answering - so the panel said '3 cots linked' above two cards that both read NO SIGNAL.** The count came from `st->node_count`, which is how many cot slots the hub has, so every card drawn was also a cot claimed as linked. It was a lie in the one place the caregiver is certain to look, and it was in the photograph the user sent: `3 cots linked` at the bottom left, `NO SIGNAL` on `COT 2` and `COT 3` right above it. The footer now counts the cots whose cards read ONLINE, and says **'no cots linked'** when none are answering. The host-side preview was changed the same way, so the two cannot drift. | `firmware/hub_infer/components/hub_display/hub_display.c`, `research/ui_mock.py`, `DECISIONS.md` (D-54, I-36) | *Built (RAM 12.9 %, flash 62.0 %) and flashed; the log still reads `rotation 2 (madctl 0x80)` and the radio is clean (553 frames off the air, 0 bad, 0 bad payload). The photograph that found this was worth taking on its own: one image caught the wrong colours, the wrong orientation and a lying footer.* |
| 2026-10-31 | **The panel's colours were arriving with red and blue exchanged - the teal theme was reaching the glass as olive and salmon. Fixed, flashed, and waiting on one more photograph.** The user's photograph of the panel was the first real look at the screen, and it confirmed the work of the last two sessions: **the layout, the text and the orientation are all right** - `CRYNET`, `S3 HUB`, `RADIO`, `PHONE`, `LISTENING`, `COT 1 / ONLINE`, `COT 2` and `COT 3 / NO SIGNAL`, `3 cots linked`, `up 0:39`. But the **colour was wrong**, and the user read it as a different, garish theme. The cause was not the palette: **the palette in the source was already the teal one.** The photo was *measured* rather than squinted at - the screen was located in the frame, mapped onto it, and the saturated pixels sampled (text and the 6x6 pill squares, which the palette pins down exactly): `CRYNET` (teal 45,212,191) measured **olive** (210,210,179); the `RADIO` square (green 52,211,153) measured **olive** (174,180,146); the `PHONE` square (amber 251,191,36) measured **blue** (5,175,247). Every hue was present and correct except that **red and blue were in the wrong places** - a textbook R/B swap. The reason is one bit: the driver's rotation setting carried `MADCTL_BGR`, which tells the controller that the *top* bits of each RGB565 word are blue, while `DISPLAY_RGB` puts **red** there. The bit had come from Adafruit's rotation-2 setting, which this panel's legacy firmware used. It is now cleared, and `INVOFF` is sent explicitly so the inversion state is pinned rather than inherited. | `firmware/hub_infer/components/hub_display/ili9341.c`, `DECISIONS.md` (D-53, I-35) | *Built (RAM 12.9 %, flash 62.0 %) and flashed: the panel comes up at 320x240 rotation 2 and the log now reads **`madctl 0x80`** - the `BGR` bit is gone - with the radio healthy (110 frames off the air, 0 bad, 0 bad payload). The host-side preview (`research/out/ui_dashboard.png`) was already correct, because it renders the palette in software: this bug lived only between the framebuffer and the glass. **One more photograph will settle it** - the teal should now appear as teal, the `PHONE` pill amber, and the background dark navy.* |
| 2026-10-31 | **The panel was showing hearts and diamonds instead of letters. The font was never corrupt — the generator was reading the table 32 characters out of place.** The screenshot of the new dashboard was full of little symbols where "CRYNET", "LISTENING" and "COT 1" should have been, and the host-side preview of the same screen showed the same nonsense, so the fault was visible before the hardware was. The cause: `Adafruit_GFX::drawChar` reads the classic font as **`font[c * 5 + i]` — the raw ASCII code, with no `- 0x20`** — because Adafruit's table begins with 32 decorative icons (hearts, diamonds) before the printable set at 0x20. The generator assumed the old layout and wrote `off = (code - FIRST) * 5`, so every character drew the glyph of the character 32 codes earlier: 'A' drew '@', a space drew the heart at 0x01. **The font file itself was fine** — the local `glcdfont.c`, the upstream copy and the cached copy are byte-identical, which is what finally killed the "the library's font is damaged" theory. Two more things fell out of the same fix: the renderer reads bit 0 as the top row, the way Adafruit's own `drawChar` does (`for (j = 0; j < 8; j++, line >>= 1) if (line & 1)`) — the *preview* had the opposite convention and was drawing every glyph upside down, which would have hidden the fix behind a second bug; and the display source had been saved in Windows-1252 and then double-encoded into mojibake, so it is now valid UTF-8 with no non-ASCII byte inside a string literal. **The generator now detects the table's layout instead of assuming it**: it finds the classic exclamation mark (`00 00 5F 00 00`), works out the base from where it lands, and refuses to write the header unless the font is what it expects. | `research/build_font.py`, `firmware/hub_infer/components/hub_display/font5x7.h`, `firmware/hub_infer/components/hub_display/hub_display.c`, `research/ui_mock.py`, `research/toolchain/pio_build_font.log`, `research/hub_flash_font.log`, `DECISIONS.md` (I-33, I-34, D-51) | *Verified by decoding the generated header back into ASCII art — 'A', '0', 'g', '!' and 'R' all read correctly — and by rendering the preview, which now shows the real screen: `CRYNET`, `LISTENING`, `COT 1 / ONLINE`, `COT 3 / NO SIGNAL`. Built (RAM 12.9 %, flash 62.0 %) and flashed: the panel comes up at 320×240 rotation 2 and the radio hears the node with 0 bad frames. **One photograph is still needed to confirm the real glass.** |
| 2026-10-31 | **The panel now shows the caregiver's device, because the user asked for the old system's arrangement — "the status of all nodes and the wearable".** The header's `BLE` pill only said that the Bluetooth stack had started; it said nothing about whether anyone was there to hear the alert. It is now a **`PHONE` pill with three states**: green when a client is connected and subscribed, amber when the stack is up but nobody has attached yet, dim when Bluetooth is down. The wearable and the caregiver's phone connect to the *same* legacy GATT service, so the hub cannot tell them apart and does not pretend to — the pill says that a caregiver device is attached. And a **confirmed cry with nobody attached now reads `ALERT NOT DELIVERED`** under the banner, because a cry that reaches a hub with no listener has gone nowhere and the caregiver has to see that on the panel instead of discovering it by waiting for an alert that never comes. | `firmware/hub_infer/components/hub_display/include/hub_display.h`, `firmware/hub_infer/components/hub_display/hub_display.c`, `firmware/hub_infer/src/link_stage.c`, `research/ui_mock.py`, `DECISIONS.md` (D-52) | *The host-side preview (`research/ui_mock.py`) was rewritten to mirror the firmware page for page — it had drifted into a different design with a different name — so it is a true preview of the glass again, and the two cannot silently drift.* |
| 2026-10-31 | **The panel is alive, the picture is now the right way up, and the display has a face: an animated splash, then a dashboard.** Three things came out of the user's photograph of the panel. **(1) The screen was never broken — the *orientation* was.** The panel is a "landscape-first" ILI9341, and the legacy firmware drove it with **Adafruit's rotation 2 (`MADCTL_MY | BGR`) and a 320x240 logical framebuffer** (its `HubDisplay` class exists only to override Adafruit's 240 px clipping). My driver used rotation 1 (`MADCTL_MV`), which on this glass turns the whole picture a quarter turn — which is exactly what the photograph showed. The orientation now follows the legacy's proven setting, and the driver logs it (`rotation 2 (madctl 0x88)`). **(2) The UI was rebuilt.** The old one drew three strings and a bar on black; the new one composes everything in a **320x240 RGB565 framebuffer in PSRAM** (150 KB — the hub's internal RAM is not to be spared for it) and pushes one transfer per frame, so a frame is never torn. The screen now has **two faces**: an **animated splash** for the first 4.2 s — a scrolling waveform, the name, a progress bar and the boot steps — which then fades into the **dashboard**: a header with the radio and Bluetooth pills, a banner that says what the system is doing, a card per cot with its level, and the uptime. **(3) The palette was checked, not guessed.** The brief was "not too much red" (the legacy's dashboard was a wall of it), so the scheme is a dark navy with a teal accent, green for a cot that is fine, amber for a loud one, and **rose for a confirmed cry only** — and every colour is paired with a word (`ONLINE`, `NO SIGNAL`, `CRY 97%`), because colour on its own is not an accessible signal. Every pair was measured against WCAG: body text 15.9:1, dim text 5.5:1, the accent 10.1:1, the cry rose 6.3:1 — and the **card border failed at 1.40:1** (it was invisible), so it was lightened to (88,112,136), now 3.31:1. The system also gained a per-node display state: the dashboard shows every cot the hub has heard from, not just the loudest. | `firmware/hub_infer/components/hub_display/*`, `firmware/hub_infer/src/link_stage.c`, `firmware/hub_infer/components/ble_alert/*`, `research/toolchain/pio_build_ui.log`, `research/hub_flash3.log`, `research/hub_flash4.log`, `SYSTEM_UPDATE.md` | *The orientation is a property of this panel, not of the chip — the same class of fact as the pin assignments, and the same rule applies: when two systems disagree about a panel, the one that was photographed working wins. What is still open: one photograph of the new screen, to confirm it is the right way up and that the splash reads well.* |
| 2026-10-31 | **The TFT panel was wired, flashed and found to be showing noise — which turned out to be three bugs in my own ILI9341 driver, all now fixed.** The user wired the panel (CS 10, MOSI 11, SCK 12, DC 13, RST 14, backlight 4, 3V3, GND) and plugged in both boards; the hub was flashed and **the chain ran end to end on real audio**: the node's RMS climbed to 0.10-0.28, the hub pulled the window (**286/286 fragments, CRC-32 MATCH**), and the model called **P(cry) = 0.9961 on nine windows and 0.9883 on one** — `ALERT — cry`, `a cry on cot 1 at 100 %` over BLE — while the quiet room gave **P(cry) = 0.0000** and a non-cry loud sound at RMS 0.035-0.085 gave **P(cry) = 0.0000** (rejected, no false alarm). But the panel showed **static noise**, and the cause was mine, not the wiring: **(1) the address window was little-endian.** `CASET`/`PASET` take their four bytes big-endian; the code cast a `uint16_t` to `uint8_t *` and so sent the low byte first — 319 (0x013F) went out as 0x3F 0x01, which the panel read as column 16129. **(2) `CASET` was sent twice.** The window is one command for the columns and one for the rows; sending the column start and then the column *end* as a second `CASET` re-sets the start instead of the end, so the window collapsed to a single pixel. **(3) CS was released between a command and its parameters.** The ILI9341 resets its serial interface when CS goes high, so every parameter byte was arriving as a *command* — the panel was never initialised at all, and what the user was looking at was uninitialised display memory. The fix is in the driver: **D/C is now driven in the SPI driver's pre-transmission callback** (the only moment the level can safely change), **a command and its parameters are one transfer** via `SPI_TRANS_CS_KEEP_ACTIVE` with the bus acquired (the ESP-IDF only permits that on an acquired bus), and the address window is built big-endian, one command per axis. The text renderer was rewritten to draw **horizontal runs** instead of single pixels — about sixty times less SPI traffic, which is what makes a redraw cheap enough to run once a second. A **blue 12x12 marker now sits in the panel's top-right corner** so the layout's orientation can be fixed from one photograph. | `firmware/hub_infer/components/hub_display/{ili9341.c,ili9341.h,font5x7.h,hub_display.c}`, `research/toolchain/pio_build_display.log`, `research/hub_flash.log`, `research/hub_flash2.log`, `research/hub_live.log`, `SYSTEM_UPDATE.md` | *The pattern of the three bugs is worth remembering: the panel reported "up" the whole time, because nothing in the driver ever asked the panel whether it was up — the ILI9341's ID register can be read, but MISO is not wired, so it cannot be. **A display driver that cannot fail is a display driver that lies.** The marker square and the "is the text the right way up" question are how the remaining orientation question gets settled now.* The burst is now noticeably slower than in the last session — 5.7-7.6 s per window against 1.15 s — because it routinely stalls at 227-284 of 286 fragments and needs two or three resend rounds; that is the known BLE/Wi-Fi coexistence cost and it is the next thing to look at. |
| 2026-10-31 | **Music measured: the deployed model false-alarms on 8.19 % of loud music — the worst of any sound class, and a class it had never seen.** GTZAN (1,000 real music clips, ten genres, downloaded from Kaggle) was run through the deployed INT8 model with the notebook's own front end: **79 of the 965 clips that reach the model alarm — 8.19 %**, three times the rate for environmental sound (2.64 %) and five times the rate for speech (1.6 %). By genre: jazz 14.3 %, blues 13.0 %, pop 12.0 %, disco 10.0 %, rock 10.0 %, hiphop 9.0 %, metal 4.0 %, country 3.0 %, classical 2.9 %, reggae 2.0 %. The mechanism is plain once seen — a cry is a voiced, harmonic-rich sound, and a saxophone, a trumpet or a sung vowel looks like one in the log-Mel domain. **The threshold cannot rescue it:** the INT8 output saturates at P(cry) = 0.9961, so 45 of the 81 music alarms and 34 of the 36 true cry detections carry exactly the same value, and moving the threshold from 0.95 to 0.99 would remove 27 music alarms at the price of two real cry detections. A "two consecutive windows" confirmation was considered and deferred: music is continuous, so it would not help against music, and it would cost the demo a short single cry clip. The fix is the training round, and the corpus is in the notebook (see the row below). The practical consequence for the defence: **a room with music playing produces roughly one false alarm per twelve loud music windows** until the re-run happens — so the demo should be in a quiet room, or the music corpus should be trained in first. | `research/eval_music.py` (new), `research/out/eval_music.json`, `research/out/eval_music.log`, `DECISIONS.md` (I-29, D-51, D-52, O-8, O-9), `SYSTEM_UPDATE.md` | *This is the sharpest number in the project so far, and it is the one the user's stated requirement turns on: the system must tell a cry from music. Today it cannot, and the reason is structural rather than a tuning slip.* |
| 2026-10-31 | **Music goes into the training corpus, and the notebook that will be re-run on Kaggle is patched and validated locally.** The false-alarm map showed there is **no music anywhere in the training mix** (ICD: cries, VoxCeleb speech, DASEE domestic noise, human non-speech, cat meows, silence; supplementary: cries, ESC-50, snoring) and **no music in ESC-50 either** — so "the model tells a cry from a song" was neither trained nor measured, which is exactly what a room with a radio or a television will contain. The patch, in `research/build_notebook.py` (never in the `.ipynb` by hand): **GTZAN** (Kaggle `carlthome/gtzan-genre-collection`, ten genres of real recorded music, ~1.2 GB) joins the corpora as an all-negative corpus; its clips are read with **random** windows because a thirty-second track is not one sound — the part that plays in the cot matters, not the average of the track; 75 % goes into training and 25 % into the held-out cross-corpus set, so the model is still measured on music it has never seen, and the cross-corpus breakdown now prints a row per genre. Two traps had to be handled: **GTZAN names every clip `00000.wav`..`00099.wav` in every genre folder**, so the reader's stem index would have silently kept one of the ten genres — `ZipReader` gained an `index_by_path()` and `build_corpus` falls back to it, which keeps all ten genres; and the class balance is untouched (music is a negative, and the weighted loss already handles the cry side). The local stub run proves the whole path: `cached gtzan 12.0 MB` → `GTZAN : 80 (music, all negative)` → `gtzan (160, 81, 64)` → `TRAIN (4923, 81, 64)` and `CROSS (1567, 81, 64) [cry4 + ESC-50 + snoring + music]`, and the training cells run. Also **fixed the display's choice of cot**: the cots are in one room, so all of them hear the cry, and the panel was naming the *first* crying cot it found in its array rather than the **loudest** one — the loudest is the cot the baby is in. The panel now names the loudest crying cot, and the BLE state characteristic's `crying_mask` still reports every cot that hears it. | `research/build_notebook.py`, `notebooks/crynet_training.ipynb` (regenerated), `research/make_stub.py`, `research/eval_music.py` (new), `firmware/hub_infer/src/link_stage.c`, `SYSTEM_UPDATE.md` | *The measured number for music is still to come: the real corpus is downloading, and `research/eval_music.py` will run the deployed INT8 model over it the way `eval_esc50.py` did. The Kaggle re-run itself is the user's to start; the notebook is ready for it.* |
| 2026-10-31 | **The false-alarm map: what the deployed model actually does when it is not a cry — and the discovery that the training corpus contains no music at all.** The user's requirement for the next phase is that the system must tell a cry from background noise, speech and music, and must say *which* cot the cry came from. The per-node side of that already exists (per-node inference, a per-node BLE alert, a `crying_mask` in the state characteristic) but has never been run with two nodes; the *discrimination* side had never been measured. `research/eval_esc50.py` (new) runs the **deployed INT8 model** — the very file flashed onto the hub — over ESC-50's 2,000 real-world clips, using the notebook's own frozen front end, and reports per category what the model said and whether the clip would even reach the classifier (the hub only pulls a window when the node's 100 ms RMS reaches 0.030). Result: **36 of the 40 real `crying_baby` clips alarm (90 %)** — the model does find real baby cries — and **38 of the 1,439 loud non-cry clips alarm (2.64 %)**. By kind of sound: urban 4.3 % (`car_horn` 6 of 38 reached, `hand_saw` 4 of 37, `church_bells` 1 of 39), animal 3.7 % (`crow` 4 of 32, `sheep` 2 of 33, `frog` 1 of 33), domestic 1.6 %, human non-speech 1.6 %, nature 0.8 %. The model's output saturates at P(cry) = 0.9961 (the INT8 output scale), so a single very confident window cannot be told apart from a single false alarm by confidence. **The structural finding: ESC-50 has no music and no speech** — it is environmental sound plus human non-speech vocalisations — and **no corpus in the training mix contains music**: ICD brings cry, VoxCeleb speech, DASEE domestic noise, human non-speech, cat meows and silence; the supplementary sets are cries, ESC-50 and snoring. So the model's behaviour on music was neither trained nor measured, which is exactly the case the demo room will contain. Music is now being pulled (GTZAN, from Kaggle `agrimamalviya/gtzan-from-desk` and the HF `Feanix/gtzan-5-sec` copy) so it can be measured now and added to the next training round. Also: **the two background shells left over from the last session were stopped** (they were only `grep`-polling two finished logs, and held no serial port), so the hub is free to disconnect; and **the TFT wiring was written down** for the user — CS 10, MOSI 11, SCK 12, DC 13, RST 14, backlight 4, VCC 3V3, GND, MISO unused, SPI2 at 40 MHz, landscape 320×240 — with the note that the driver never reads the panel's ID, so a miswire shows as a black screen and no warning in the log. | `research/eval_esc50.py` (new), `research/out/eval_esc50.json`, `research/out/eval_esc50.log`, `SYSTEM_UPDATE.md` | *Caveat, stated in the report itself: ESC-50's non-cry clips were part of the training corpus, so 2.64 % is optimistic for those categories — this is the category map, not the in-room number. The honest in-room number comes from a confusion session recorded with the INMP441 (speech, music, TV, clatter, and the phone-played cry), which is the next recording task. A "require two consecutive windows" rule was considered and deferred: a cry lasts seconds, but the demo plays a short clip through a phone, so one window may be all there is, and confidence saturates so it cannot be used as a tiebreak.* |
| 2026-10-31 | **The burst now completes and the whole system works end to end: the cry crosses the radio, reaches the classifier, and lands on the phone as an alert.** The blocker was that the hub's 286-fragment burst always came up short (267-274) and timed out. The cause was found by subtraction, not by reading: the node's own counters said 7,667 frames sent and **0 lost**, the hub's parse was clean, and building the hub **without BLE** produced **286/286 fragments in 3.75 s four times in a row** — so the loss was the hub's own Bluetooth advertising. BLE advertises on channels 37/38/39 and the hub's single radio must retune to reach them, during which the Wi-Fi receiver is deaf: about 6-9 % of the air, whatever the Wi-Fi channel and whatever the frame rate. That is physics, not a bug, so the fix had to be **recovery, not prevention**. **A new `RESEND` frame (type 5) carries a 36-byte bitmap of the fragments the hub is missing** — one bit per fragment, 54 bytes in all, so one request covers any scattered pattern — and the node re-sends exactly those out of the same frozen window with the same sequence number. Three further defects only the live test could find, each fixed and re-measured: **(1) the resend request is sent three times**, because an ESP-NOW broadcast is never acknowledged and the request goes out at exactly the moment the radio has been busiest (one lost request used to waste the whole round); **(2) the node answered a repeat of the request it was already serving**, so the hub's three copies made it send the same 128 fragments twice and the burst took 9.6 s instead of 5 — the node now answers a repeat only once, within 800 ms; **(3) the node refused the resend ("no frozen window for it")** because it froze the next window about three seconds after the upload, and the hub's request for the missing fragments often arrived just after that — so the node now **holds an uploaded window for four seconds** before freezing the next one, and the hub **abandons a burst the node can no longer complete** and asks for the newer window at once instead of waiting out the fifteen-second timeout. The stall detector was made proportional too: the wait before a burst counts as stalled grows with the number of fragments still missing, so the hub does not spend a round while the node is still sending a hundred fragments. **The final live test — hub, node, a real BLE client connected, the cry recording played through the PC's speakers — completed 14 bursts of 286/286 with the CRC-32 MATCHING the node's every time, zero timeouts, 9 alerts on the hub and 4 alert events on the phone (`ALERT {'cot': 1, 'alert': 'cry', 'confidence_pct': 100}`), and 6,327 frames off the air with 0 bad and 0 bad payloads.** The channel bugs found along the way are fixed too: the node was adding the hub peer on **channel 11 while its radio sat on channel 6**, and it was printing `WiFi.channel()` — the *scan result's* channel, which the Arduino core has no setter for — as the radio's channel. | `firmware/hub_infer/components/{crynet_proto,node_link}/*`, `firmware/hub_infer/src/link_stage.c`, `firmware/node/node_crynet/node_crynet.ino`, `DECISIONS.md` (new), `research/toolchain/{hub_cry_resend,hub_cry_ble_client,hub_cry_final2,node_console_live3,ble_client_final2}.log`, `SYSTEM_UPDATE.md` | **This is the first time the whole chain has run by itself: microphone -> node -> ESP-NOW -> hub -> TFLite -> the phone.** The burst takes 5.4-6.9 s (the burst itself is ~3.9 s, the resend rounds the rest); the whole path adds about a second of DSP and inference on top. The panel still needs eyes on the screen. **Also written this session: `DECISIONS.md`** — the project's report and documentation record: every decision (D-1 to D-50) with its reason, every issue (I-1 to I-28) with how it was diagnosed, what was done and what the result was, the measured results, and the open items. |
| 2026-10-31 | **The first live cry test since the rebuild, and three real bugs it found — one of them a silent killer.** The cry recording (`research/in_domain/session4/session.wav`, played through the PC's speakers) was fed to the real node while the hub listened: the node's RMS rose from the room's 0.002–0.012 to **0.057–0.082**, so the microphone and the trigger are fine — but the hub never asked for a window, and the chain stopped there. **(1) The node on the board was running stale firmware.** The dead session wrote the "freeze before you announce" change to `node_crynet.ino` but never reflashed the C3, so the node had no auto-freeze at all: `g_peak_pending` appears 0 times in the last committed node build and 7 times in the current source. Rebuilt and reflashed (978,133 B, 74 %). **(2) The node's freeze was cancelled in the same tick that created it.** `if (g_frozen_valid && (now - g_frozen_ms) > FROZEN_EXPIRE_MS)` used a `now` captured *before* `freeze_window()` ran, and `g_frozen_ms` is stamped *inside* it — so the subtraction underflowed to ~4 billion, the window expired the instant it was frozen, and the telemetry therefore never advertised `BURST_READY` or the window's CRC. The symptom was strange but unmistakable: the frozen seq advanced (1, 2, 3, 4, 5 …) while the flags stayed `0x06` and the CRC stayed `0x00000000`. Fixed by measuring the age from a fresh `millis()`. **(3) The hub was still in promiscuous Wi-Fi mode** — the leftover diagnostic from the radio debugging — which hands the host every frame on the channel; with the laptop's own Wi-Fi on channel 1 that flooded the receive path. With it off, plus `ESP_WIFI_STATIC_RX_BUFFER_NUM` 16 → 32 and `DYNAMIC` 32 → 64 (affordable now that the RAM is free), and 3 ms of pacing between the node's fragments, the burst is the last thing standing between the system and a full alert. After (1) and (2) the chain runs for the first time end to end: the node freezes a window and advertises its CRC (`flags 0x07, crc 0x26DB0617`), the hub asks for it, and **267–274 of the 286 fragments arrive** — the burst then times out, which is what (3) is for. | `firmware/node/node_crynet/node_crynet.ino`, `firmware/hub_infer/components/node_link/node_link.c`, `firmware/hub_infer/src/link_stage.c`, `firmware/hub_infer/sdkconfig.defaults`, `research/toolchain/{hub_cry_test3.log,hub_cry_test4.log,node_stats.log,node_build*.log}`, `SYSTEM_UPDATE.md` | *The burst completing 286/286, the cry reaching the display and the BLE alert are still open.* The node's own numbers are healthy: 7,667 frames sent, **0 lost**, 2.3 ms average send wait, and the hub's parse is clean (0 bad frames, 0 bad payloads) — the fragments are lost between the two radios, not in either end's code. |
| 2026-10-31 | **Stage 2c's last half is finished and verified on the real hardware: the panel, the ESP-NOW radio and the BLE server now run together on the hub.** The dead session (the one that hit the 400 limit) had written the panel driver — `gen_font.py` regenerates `font5x7.h` (95 glyphs) from Adafruit's `glcdfont.c`, and `ili9341.c` drives the panel over SPI2 at 40 MHz, landscape 320×240 on the legacy wiring (CS 10, MOSI 11, SCK 12, DC 13, RST 14, backlight 4) — but the component's public half (`hub_display_start()`/`hub_display_update()`) was never written and nothing was wired to the build. This session added `hub_display.c` (a state snapshot behind a spinlock, redrawn by a low-priority task pinned to **core 1** so a 30 ms SPI burst never delays the link loop or the inference; changed lines only, and each line erases to the right edge so a shorter string cannot leave the tail of a longer one on the panel; the level bar is sqrt-scaled so a quiet room still shows a sliver and the 0.030 trigger lands about a third of the way up) and its `CMakeLists.txt`, and wired the component into `main.c`/`link_stage.c` (one snapshot per loop: the crying cot if there is one, else the loudest node). **The BLE/Wi-Fi conflict was not really an ordering problem — it was the hub's own memory.** The first fix attempt (radio before BLE) did move the failure to the other side: the radio came up perfectly, and then NimBLE **asserted** on `Failed to allocate memory for ble_store_config_vars` and reset the chip in a loop. The real cause was in the ELF: **154 KB of the hub's static RAM was boot-only buffers that never got handed back** — `main.c`'s `s_pcm` (64 KB) + `s_mel` (20.7 KB) + `s_q` (5.2 KB), and a 64 KB function-local static in `probes.c` that computes the four probe CRCs. They are needed only while the boot probes run, but as statics they held internal RAM for the life of the program — which is exactly the RAM NimBLE's store configuration wanted. They now live in PSRAM (borrowed and returned), and the probes' CRC buffer is freed after each use. **RAM went from 59.9 % (196,140 B) to 12.9 % (42,236 B).** With the RAM back, the whole stack fits: free internal heap 298,763 B at boot → 290,791 B after the probes → **215,155 B with the radio up → 149,271 B with Bluetooth up**. The init order is now radio → BLE → display, with `CONFIG_ESP_COEX_SW_COEXIST_ENABLE=y` so the two stacks share airtime. **Verified live on the boards:** the panel comes up (`the panel is up: 320 x 240, rotation 1`), the radio hears the node (`node 1 heard for the first time`), the BLE server advertises (`advertising as "INFANT_MONITOR_HUB"`), and a real BLE client **connected and subscribed while the radio kept running** — frames counted 21 → 308 over the session with **0 bad, 0 bad payloads, 0 failed requests**, no resets. The build also had to be taught three IDF 6 facts: the SPI/GPIO drivers live in `esp_driver_spi`/`esp_driver_gpio` (not `driver`), a stale CMake configure ignores a `REQUIRES` change until the build dir's CMake state is deleted, and `font5x7.h`'s rows need their own braces or `-Werror=missing-braces` stops the build. | `firmware/hub_infer/components/hub_display/*`, `firmware/hub_infer/src/{main.c,probes.c,link_stage.c,link_stage.h,CMakeLists.txt}`, `firmware/hub_infer/sdkconfig.defaults`, `research/toolchain/{gen_font.py,pio_build_2c*.log,hub_display_live3.log,hub_ble_coexist.log}`, `SYSTEM_UPDATE.md` | *What is still unverified: what the panel actually shows (it needs eyes on the screen), and a cry going all the way through to the display and the BLE alert.* |
| 2026-10-31 | **Stage 2c's BLE GATT server is written and verified from a real client — and the live test exposed that it cannot coexist with the ESP-NOW radio yet.** `components/ble_alert/` is a NimBLE peripheral: it advertises as `INFANT_MONITOR_HUB`, and serves the **legacy UUIDs** so the wearable firmware written against them keeps working — service `19b10000-e8f2-537e-4f6c-d104768a1214`, alert characteristic `19b10001-…` (read/notify/indicate, the legacy six-byte packet `cot id, alert type (1 = cry, 2 = cancel), confidence %, event id`), plus a new state characteristic `19b10002-…` carrying the whole system (`cots`, `crying_mask`, loudest confidence, how long the cry has run) so a phone that opens late still sees the current state. `link_stage.c` publishes on state *change* (cry starts / cry stops), not per window, and only after a cry is held past `CRY_HOLD_MS` so the gaps in a recording do not flap the alert. `firmware/tools/ble_alert_test.py` (a Bleak client) verified the server live: it found the hub, connected, discovered both characteristics and subscribed to both. **The failure the same test exposed:** with BLE up, `esp_wifi_init` fails (`esf_buf_setup_static: alloc eb fail(1)`) and the ESP-NOW radio never starts — BLE and the node link did not coexist in that build. Two demo tools came with it: `firmware/tools/serve_alert_page.py` serves `research/web/alert.html` over **HTTPS with a self-signed cert that has a SAN** (patch scripts `patch_serve_openssl.py`/`patch_serve_san.py`), because Web Bluetooth needs a secure context on a phone; the page talks to the hub directly over GATT in the browser. | `firmware/hub_infer/components/ble_alert/*`, `firmware/hub_infer/src/{main.c,link_stage.c,link_stage.h,CMakeLists.txt}`, `firmware/hub_infer/sdkconfig.defaults`, `firmware/tools/{ble_alert_test.py,serve_alert_page.py}`, `research/web/alert.html`, `research/toolchain/{ble_test.log,ble_test2.log,ble_test3.log,hub_ble_live.log,hub_ble_live2.log}`, `SYSTEM_UPDATE.md` | The BLE verification passed while the radio was down; the coexistence fix is the 2026-10-31 display entry above. The alert page has not been exercised against a real cry yet (`alert_page.log` is empty). |
| 2026-10-30 | **In-domain audio collected and the live system tested in the user's room. The deployed model works there — and the live test exposed a real defect in *which* window the hub classifies.** **Collection:** four sessions recorded with `node_capture` on the real INMP441 (`research/in_domain/session1..4`, WAVs gitignored, manifests kept): a 55 s rescued partial, a 299 s **quiet-room baseline** (110 negative clips, RMS 0.002-0.016), a 329 s **phone-speaker cry** session (87 cry clips, peak RMS 0.518) and a smoke test. The cry source is a **recording played through a phone speaker**, because the demo will be exactly that — so the deployed condition and the recorded condition are the same condition, and the clips are labelled as speaker-played rather than as a real cry in the room. **Evaluation of the shipped INT8 model on this audio** (`research/eval_indomain.py`, the notebook's own front end, so the numbers are what the hub would produce): on the room baseline **0 false alarms in 236 windows** and no room clip reaches the classifier through the 0.030 trigger; on the cry session **AUC 0.9283, recall 0.724, FPR 0.000** — the misses are 2-second windows that land in the gaps between cries. **Live test** (hub + node + phone, the real system): the radio was flawless — 5,976 frames, 0 bad, 0 bad payloads, 0 failed requests — and the model called the cry at **P(cry) = 0.9961** on five of sixteen pulls. The other three pulls said "no cry", and all three had the same cause: the hub triggers on the node's **100 ms** RMS but was served the **live 2-second** window, whose average is mostly the gaps between cries (trigger 0.0710 → window 0.0182 → no cry). **Three fixes, all now in:** (1) the node's `EVENT_RMS` 0.10 → 0.030, the same number as the hub's trigger, so the frozen window the protocol is built around actually exists — with 0.10 it existed in only 10 of 16 pulls, and the hub was served the live window instead; (2) the node now **freezes before it announces**, so the telemetry that says "I am loud" also carries the window's sequence number and its CRC-32; (3) the hub's trigger now needs the level to have been **sustained for two telemetry readings** (~200 ms), because the INMP441's slow DC drift produces one lone reading above the trigger on its own — in the quiet room the old trigger fired on the drift and pulled bursts continuously; the new one stays quiet. | `firmware/node/node_crynet/node_crynet.ino`, `firmware/hub_infer/src/link_stage.c`, `firmware/tools/label_session.py`, `firmware/tools/collect_clips.py`, `research/eval_indomain.py`, `SYSTEM_UPDATE.md` | The labeller cuts clips on a fixed grid and labels each by the share of its 100 ms records above the threshold (a cry, a no-cry, or uncertain), and falls back to computing the envelope from the audio itself when `records.csv` is missing — which is how an interrupted 55-second recording was rescued instead of thrown away. The node is back on `node_crynet` and both boards are flashed with the fixes. The distance curve (how far the phone can be) is still open: the phase cues did not line up, so the far-side measurement has to be repeated. Still to do for the demo: the TFT display and the BLE GATT server (the rest of Stage 2c), then the wearable (Stage 2d). |
| 2026-10-30 | **The in-domain collection session is prepared and the capture path is verified on the real node.** `node_capture` was compiled (308,982 B, 23%) and flashed to the node on COM30, and a 15-second smoke session recorded clean audio: 16 kHz mono 16-bit, 140 records, no CRC failures, room RMS **0.001-0.015 (mean 0.003)** — an order of magnitude below the hub's 0.030 trigger, so the room has clean headroom. Two tools were added for the session: `firmware/tools/label_session.py` cuts each 5-second clip from *inside* one region of the per-100 ms RMS trace (a fixed cut can straddle the start of a cry and be neither class), labels it from that trace, and writes a manifest plus a per-10-second timeline so the levels can be checked without listening; `collect_clips.py` no longer demands `--out` when `--list` is used. The recorded WAVs are gitignored (`research/in_domain/**/*.wav`) — they are large; the manifests are kept. | `firmware/tools/label_session.py`, `firmware/tools/collect_clips.py`, `.gitignore`, `SYSTEM_UPDATE.md` | The node is flashed with `node_capture` for the collection, so the radio path is dormant until `node_crynet` goes back on it. The cry source available today is a **recording played through a laptop speaker**, not a real cry — that is a proxy (compressed, band-limited, EQ'd by the speaker) and the dataset must be labelled as such; the negatives it produces (this room, this microphone) are authentic. |
| 2026-10-30 | **Stage 2c's radio committed as a checkpoint** (`git add -A && git commit && git push crynet main`, the project's backup rule). The commit carries the whole radio half: `crynet_proto` (the wire format), `node_link` (reception, reassembly, CRC-32), `src/link_stage.c` (the trigger, the request, the analysis), the node's transmit path and the `node_console.py` tool. Two tidy-ups were made immediately before committing: the hub's reject diagnostics were re-worded from "TEMP DEBUG" to permanent diagnostics (the first few rejects still print — that log line is what finally located the window-buffer bug), and a slot with no window buffer now logs an error instead of being dropped silently; `node_radio.ino`'s header now says what the investigation actually found. The hub was rebuilt after the edits: **SUCCESS**, 49.7% flash, 59.0% RAM. | `firmware/hub_infer/components/node_link/node_link.c`, `firmware/node/node_radio/node_radio.ino`, `SYSTEM_UPDATE.md` | The radio is verified on the real boards, so this checkpoint is a *working* state, not a work in progress. Still outstanding and not blocking: the node sketch carries status-only timing instrumentation, and there is no per-fragment retry (one burst in ten timed out at 277/286). |
| 2026-10-30 | **Stage 2c's radio verified end to end on the real boards: the hub pulls a two-second window over ESP-NOW and its CRC-32 matches the node's.** `node 1: 286/286 fragments in 1.15 s` -> `window crc32 0x23C2EE17, the node advertised 0x23C2EE17 -> MATCH` -> front end 47.5 ms, inference 102.4 ms, P(no_cry)=0.996 on the reassembled audio, `no cry`. Repeated bursts at **0 bad frames, 0 bad payloads** (a noisy room at RMS 0.06 kept the 0.03 trigger firing, burst after burst). Four real bugs were found and fixed on the way: **(1) A closed serial port starved the node's loop — the root cause of the week.** ESP32 Arduino's USB-CDC (HWCDC) write path waits `tx_timeout_ms` (default 100) x up to 20 consecutive timeouts = ~2 s **per print** when no host reads the port, and `usb_serial_jtag_is_connected()` stays true whenever the cable is plugged in, so `if (Serial)` gates did NOT help. The node prints its rms every 100 ms, so an unattended node crawled to ~3 loops/s: the mic starved, telemetry fell to 0.35 Hz, the window never filled, and the "INMP441 power-on transient" seen in hub captures was stale ring-buffer data, not the microphone. Cure: **`Serial.setTxTimeoutMs(0)`** in setup() — prints drop instead of block; telemetry hit 10 Hz within one flash. (The earlier sessions only worked because the Arduino IDE serial monitor held the port open.) **(2) `handle_telemetry` memset a new node's slot to zero, wiping the 64 KB window pointer `node_link_create` had pre-allocated — every fragment was rejected on `window == NULL` and not one burst ever reassembled.** The stats line decoded it: 702 raw, 702 parsed OK, 560 bad = parse passed, `handle_fragment` rejected; the only silent reject was the window pointer. Fix: save/restore the pointer across the memset. **(3) The hub's 2-second probe had become a 50 ms flood** (the heartbeat edit had deleted `last_probe_us = probe_now`), and the node wiped its whole live window after serving a one-fragment probe — fix restores the timestamp and the node only wipes after a real burst. **(4) `esp_now_add_peer` was called from the node's receive callback** (WiFi-task context — the hub's own `node_link.c` documents this exact trap): peer-add moved into `loop()`. Along the way: **unicast to the learned hub address was tried and rolled back** — it wedged the ESP-NOW send path (`esp_now_send` returned OK, frames never left, the send callback never fired, every send burned its wait cap and the loop starved); broadcast at 10 Hz is reliable now that the loop runs real time, which also disproved the "hub radio sleeps" theory, so **the 100 ms heartbeat was removed** (`WIFI_PS_NONE` plus constant node traffic is why the hub hears everything). Known limitation, recorded not fixed: one burst timed out at 277/286 (broadcast loses a few frames under load; no per-fragment retry yet). The node sketch still carries status-only timing instrumentation (pump/loop/esp_now_send timers, printed only on the `status` command) — strip when convenient. | `firmware/hub_infer/src/link_stage.c`, `firmware/hub_infer/src/link_stage.h`, `firmware/hub_infer/components/node_link/node_link.c`, `firmware/node/node_crynet/node_crynet.ino`, `SYSTEM_UPDATE.md` | Every step's log is in `research/toolchain/hub_*.log` (heartbeat_test, window_pull_test, frag_debug*, unicast_test, dual_test, fixed_test, calm_test, txtimeout_test, burst_fixed_test, final_test) and the patch scripts that produced each fix are `research/toolchain/patch_*.py`. Reads that paid off: the Arduino core's `HWCDC.cpp` (the 100 ms x 20 timeout ladder) and the hub's own comment about peer-add from the WiFi task. |
| 2026-10-30 | **Stage 2c begins: the hub's half of the node link is written, and the node's radio is fixed.** New ESP-IDF components under `firmware/hub_infer/components/`: **`crynet_proto`** (the hub's copy of the node's wire format — frame layout, CRC-16/CCITT-FALSE, CRC-32, build/parse) and **`node_link`** (ESP-NOW reception, per-node telemetry, burst reassembly into one 32000-sample window with every fragment's CRC checked, and the request frame). `src/link_stage.c` drives it: the hub asks for a window once a node's RMS reaches **0.03**, pulls the two seconds over ESP-NOW and runs it through the Stage 2a front end and model, which are still verified on every boot before the radio starts. Two node-side changes make the link honest: **(1)** the node now waits for the previous frame's ESP-NOW send callback before queueing the next one — the transmit queue is ten frames deep, so a 286-fragment burst sent back to back overflowed it and every frame past the tenth was lost for good; **(2)** the node computes a **CRC-32 of its frozen window** and advertises it in the telemetry, so the hub can prove that the window it reassembled from the radio is byte-for-byte the window the node froze. New tool `firmware/tools/node_console.py` drives the node's serial console (`status`, `freeze`, `stats`). | `firmware/hub_infer/components/crynet_proto/*`, `firmware/hub_infer/components/node_link/*`, `firmware/hub_infer/src/link_stage.c`, `firmware/hub_infer/src/link_stage.h`, `firmware/hub_infer/src/main.c`, `firmware/hub_infer/src/CMakeLists.txt`, `firmware/node/node_crynet/node_crynet.ino`, `firmware/tools/node_console.py`, `SYSTEM_UPDATE.md` | The telemetry payload grew from 8 to 12 bytes (the CRC-32 was appended) and the node's request handling is unchanged, so the two sides were changed together. The hub's 0.03 trigger is the frozen decision from the rebuild; the older firmware pulled audio at 0.18 and a soft cry never reached the classifier at all. The hub's window buffers are 64 KB each in PSRAM, one per node. |
| 2026-10-30 | **Both node sketches now discard the INMP441's power-on burst: a 500 ms warm-up after `begin()`.** Verifying the capture sketch after the rewire showed real, clean audio (9,237 distinct values, room RMS 6-11 milli, no clipping) — but its first 100 ms record read **0.656 of full scale**, decaying 656 → 79 → 41 → 22 → 12 milli over ~500 ms before settling at the room level. That is the INMP441's power-on transient, and it mattered twice over: clips are cut from t=0, so `clip_0000` of every session contained the burst, and on the deployed node the burst would freeze a garbage window the moment it crossed the 0.10 EVENT level and hand the hub a spurious upload after every boot or reconnect. Both sketches now read and discard 500 ms (8,000 stereo frames) right after the I2S starts. Verified on hardware: `node_crynet` boots and streams telemetry with a first RMS of 0.047 (never crossing EVENT), and a fresh `node_capture` session reads **7 milli on its very first record** — room level from sample 0, versus 656 before. | `firmware/node/node_crynet/node_crynet.ino`, `firmware/node/node_capture/node_capture.ino`, `SYSTEM_UPDATE.md` | The 500 ms of discarded audio simply delays the first telemetry/record; nothing else changes. The slower DC drift after power-up (minutes of settling from −1639 to −40) was already known and is absorbed by the per-window mean. |
| 2026-10-30 | **The node produces real audio: the rewired INMP441 works and the two sketches were settled with a measurement.** After the user rewired the board, `node_diag` shows the left I2S slot carrying real 24-bit samples (`EC4A5800`, low byte zero — the left-justified signature) with the right slot constant, and the pin scan identifies **SD on GPIO6 as the only live data pin**, so the wiring is SCK=4 WS=5 SD=6 as designed. `verify_burst.py` then reports **PASS, 286/286 fragments, 0 bad CRC**, and the WAV it wrote is a *real* waveform: 1,943 distinct values, RMS 349 counts (0.011 of full scale), peak ±1,150 — a quiet room, no clipping, sitting below the hub's 0.03 trigger and above its 0.0015 silence gate. The forked thread had left the two sketches contradicting each other (`node_crynet` MONO+SLOT_LEFT, `node_capture` STEREO+SLOT_LEFT); the diagnostic settles it: **STEREO with both slots, taking every other word.** MONO halves the I2S frame to 32 bits, which breaks the INMP441's framing — the same microphone read the same way gives −3500 counts of DC with the full frame and −620 with the halved one. Asking for stereo also makes the Arduino library force the both-slots mask whatever mask is passed, so the mask argument never does what it appears to do. Both sketches now do the same thing and both compile with zero warnings. Also recorded: the INMP441's DC output drifts for some seconds after power-up (−700 settling to −50), which the hub's per-window mean removal absorbs. | `firmware/node/node_crynet/node_crynet.ino`, `firmware/node/node_capture/node_capture.ino`, `firmware/node/README.md`, `SYSTEM_UPDATE.md` | The forked thread's other changes were kept: both host tools now drain the serial port without ever waiting for a fixed block, because the node's small CDC transmit buffer overflows and loses bytes otherwise. |
| 2026-10-30 | **The node firmware runs on the real C3 and the whole capture path verifies end to end — but the microphone is not driving its data line.** `node_crynet` was flashed to the user's WeAct Studio ESP32-C3 SuperMini (COM30) and **`verify_burst.py` reports PASS: 286/286 fragments, 0 bad CRC, exactly 64,000 bytes**, written out as a 2.00 s WAV. So the I2S peripheral, the circular window, the framing and the CRCs are all proven on the device. **The audio itself is not real:** the captured window is flat at 0–1 count with 533 single-sample spikes, and the diagnostic (`node_diag`, a new bring-up sketch that reads both I2S slots and scans every exposed GPIO) shows the data line reading **exactly 0.00 in steady state**. The apparent "signal" on GPIO0 and GPIO6 is the peripheral's **start-up transient** — a repeat measurement of the identical configuration reads 0.00/0.00 where the first read 3961/2320, which is why the tool now measures the original pins twice and says whether the two agree. The SCK scan reads 0.00 on **every** pin, which is the clearest statement of the fault: with the clock on the wrong pin the microphone is never clocked, and with the clock on the right pin its data line still stays flat. **So the fault is in the wiring, not the firmware**: the INMP441 only drives SD when it is powered, clocked and given a valid word-select. | `firmware/node/node_diag/node_diag.ino`, `firmware/node/README.md`, `SYSTEM_UPDATE.md` | The user's Arduino IDE build failed with `cc1plus.exe: out of memory allocating 4194296 bytes`: the machine's **page file is disabled**, so the commit limit was 16,190 MB against 15,109 MB committed. `AutomaticManagedPagefile` was set to `True` (the Windows default), which takes effect at the next boot; meanwhile the sketches were built and flashed with `arduino-cli` outside the IDE. **The user's PowerShell `python` is 3.15.2 at `C:\Python315`, which had no pyserial** — it is now installed there so `python firmware/tools/...` works from any directory. |
| 2026-10-30 | **The node sketches are in the Arduino sketchbook and build from there.** `install_sketches.py` had been run from the wrong directory (the user was in `firmware/hub_infer`, so the relative path did not resolve), and their PowerShell `python` is **3.15.2** at `C:\Python315`, which had no **pyserial** — the node tools need it. pyserial 3.5 is now installed for 3.15, so `python firmware/tools/...` works with whichever interpreter is first on PATH; the 3.11 that has PlatformIO is still the one for the hub CLI. Both sketches are installed at `~/Documents/Arduino/node_crynet` and `~/Documents/Arduino/node_capture`, and **both were compiled from the sketchbook copies** for `weact_studio_esp32c3` with zero warnings, so the IDE will find and build them. | `firmware/tools/install_sketches.py`, `SYSTEM_UPDATE.md` | For the hub from a terminal, the cleanest command is the standalone `C:\Users\HP\.platformio\penv\Scripts\platformio.exe` — the same Core 6.2.0 the IDE drives, and it needs no Python on PATH. PlatformIO was deliberately **not** installed into 3.15: Core 6.2.0 predates that release. |
| 2026-10-30 | **The PlatformIO IDE works now, and the node's real hardware is identified.** (1) The VS Code extension refused to start with *"Could not find compatible PlatformIO Core"* — caused by my own setting. The extension's check is `get-platformio.py check core --version-spec ">=6.1.6"`, and with `useBuiltinPIOCore: false` it looked for a Core in `~/.platformio/penv/Scripts` and found none. The fix: `useBuiltinPIOCore: true` (the extension's own advice) and the Core installed into the penv by PlatformIO's own bootstrap script. The penv Core is **6.2.0** — the same version the command line uses — it shares `~/.platformio`, so ESP-IDF 6.1.0 and the Xtensa toolchain were reused and **nothing was re-downloaded**; the hub builds through it in **99.3 s**, RAM 52.0 %, flash 22.0 %. (2) The user's node is a **WeAct Studio ESP32-C3 SuperMini**, and its USB is the **ESP32-C3's own native USB** (`303a:1001` on **COM30**), *not* a CH340 — so UART0 on GPIO20/21 goes nowhere and **"USB CDC On Boot" must be Enabled** or the console is silent and the port vanishes when the app starts. The Arduino core has an exact board entry for it (`weact_studio_esp32c3`) with CDC-on-boot already on; both sketches were recompiled for it with zero warnings. (3) The **capture records now carry a CRC-16** over their header and payload, and the collector drops any record that fails it — without it a single dropped byte on the USB link would shift every later sample and quietly ruin the dataset. Both stream parsers were rewritten as testable classes and checked against synthetic streams: the burst parser finds 285 of 286 fragments and flags exactly the corrupted one; the capture parser accepts 19 of 20 records and rejects exactly the corrupted one, with every surviving payload byte-exact. | `.vscode/settings.json`, `firmware/hub_infer/.vscode/settings.json`, `firmware/node/node_capture/node_capture.ino`, `firmware/node/README.md`, `firmware/tools/collect_clips.py`, `firmware/tools/verify_burst.py`, `SYSTEM_UPDATE.md` | The tools also had to stop depending on the sketch's text banner: a USB CDC port can enumerate *after* the sketch has already printed it, so the parsers resynchronise on their own magic and the banner is only informational. `verify_burst.py` now also retries the `freeze` command, because the node refuses to freeze until its two-second window is full. |
| 2026-10-30 | **Node window bug found by reading the code before the hardware did.** After a burst is sent the live window is dropped and refills, so for two seconds the newest samples are not at the start of the array — but the mean summed from index 0, averaging the stale tail with the fresh head and making the reported RMS meaningless for exactly as long as the window was invalid. The valid region is now walked **backwards from the write cursor**, which is right whether the window is full or refilling, the cursor is no longer reset, and a request arriving while the window is incomplete is refused rather than answered with a window whose order is unknown. | `firmware/node/node_crynet/node_crynet.ino`, `firmware/node/README.md` | Both sketches recompiled clean. The wire format was also validated numerically: CRC-16/CCITT-FALSE matches the standard check vector `0x29B1`, and the C frame builder and the Python parser agree on every header offset and both CRCs. |
| 2026-10-30 | **Stage 2b: the node firmware is written and compiles, and the offline GUI path is set up.** Two Arduino sketches for the ESP32-C3 — `node_crynet` (I2S capture, a 2 s rolling window, 100 ms RMS telemetry over ESP-NOW, the 64 KB burst as 286 CRC-framed fragments, a serial console) and `node_capture` (streams the microphone to the PC for in-domain data). Both build for `esp32:esp32:esp32c3` against the installed core 3.3.12 with **zero warnings**: 977,617 B / 165,972 B and 311,120 B / 18,592 B. The I2S setup follows Espressif's own recipe for this microphone — **32-bit slots** (the INMP441 puts 24 bits in a 64-bit frame, so 16-bit slots would misalign the data), `I2S_SLOT_MODE_MONO` + `I2S_STD_SLOT_LEFT`, narrowed to int16 in software by keeping the top 16 bits; the C3 is I2S hardware v2, so the left slot is chosen in hardware. The node repeats the hub's DC lesson: an exact **integer** mean, and the 100 ms RMS computed with the mean of the **whole 2 s window** removed, so the node's RMS is the same quantity the hub's front end will compute — otherwise the hub's 0.03 trigger threshold means nothing. Two host tools came with it: `verify_burst.py` (asks the node for its window over the serial console, checks every frame's CRC, writes the WAV) and `collect_clips.py` (records a session and cuts it into 5 s clips), plus `install_sketches.py` to copy the sketches into the Arduino sketchbook. Separately, the **PlatformIO IDE in VS Code** was pointed at the pip-installed Core 6.2.0 (`useBuiltinPython: false`, `useBuiltinPIOCore: false`, `customPATH` at the Python `Scripts` folder) so it drives the toolchain that is already installed and needs no network. Also corrected a claim: the build is DIO throughout (`CONFIG_ESPTOOLPY_FLASHMODE "dio"`, flash-mode byte `0x02` in both images), so the application runs in DIO — the bootloader does *not* switch it back to QIO. | `firmware/node/node_crynet/node_crynet.ino`, `firmware/node/node_capture/node_capture.ino`, `firmware/node/README.md`, `firmware/tools/verify_burst.py`, `firmware/tools/collect_clips.py`, `firmware/tools/install_sketches.py`, `firmware/README.md`, `.vscode/settings.json`, `firmware/hub_infer/.vscode/settings.json`, `SYSTEM_UPDATE.md` | One real API error was caught by compiling: IDF 5.x/6.x changed `esp_now_recv_cb_t` to take an `esp_now_recv_info_t *` first argument. **The node has still never run on the board** — the wiring, the INMP441's actual level and DC offset, and the effective sample rate are all unmeasured. |
| 2026-10-30 | **Stage 2a closed: the firmware runs on the real chip and all four probes pass.** The user's ESP32-S3-DevKitC-1 (COM32) now reports `RESULT: PASS — 4 probes, front end and model agree with the host`, with the device's quantised features matching the host reference exactly on three probes and to within 1 LSB on three values of the fourth. Measured on the chip: PSRAM 8 MB present, flash 16 MB, front-end working set 5,380 B in internal SRAM, tensor arena 262,144 B reserved / **108,328 B used**, front end **41.7 ms**, inference **101.8 ms**. Five defects were only findable by running it: the **DC-removal mean accumulated in float32** (32,000 samples of 18,000 summed to 575,726,660 instead of 576,000,000, so 8.5 counts of DC survived and the per-window standardisation turned them into a completely different feature vector — the DC-offset probe failed with a max delta of 131; the sum is now an exact `int32`); the build was at **`-Og`** because `-DCOMPILER_OPTIMIZATION_PERF` is an Arduino macro PlatformIO's ESP-IDF builder ignores (`CONFIG_COMPILER_OPTIMIZATION_PERF=y` now); the CPU ran at **160 MHz** (`CONFIG_ESP_DEFAULT_CPU_FREQ_MHZ_240=y`); the front end kept a **128 KB padded copy of the signal in PSRAM**, which is uncached external memory on the S3 and was streamed through 81 times per window (the copy is gone — each frame is built straight from the caller's int16 PCM — and the working set is 5.4 KB in internal SRAM, 135 ms → 41.7 ms); and a **combined flash image built with QIO flash mode makes the chip watchdog-reset in a loop** because the ROM cannot read this board's flash in QIO before the bootloader configures its own timing (the combined image must use DIO; the bootloader switches to QIO itself afterwards). Added `firmware/tools/flash_hub.py` (finds the board, flashes it, prints the log — nothing to download), `firmware/tools/capture_serial.py` and `firmware/README.md` documenting the build and the three offline flash routes. | `firmware/hub_infer/components/crynet_dsp/*`, `firmware/hub_infer/sdkconfig.defaults`, `firmware/hub_infer/platformio.ini`, `firmware/tools/flash_hub.py`, `firmware/tools/capture_serial.py`, `firmware/README.md`, `SYSTEM_UPDATE.md` | ESP-NN's SIMD kernels are linked in (`esp_nn_conv_s8_esp32s3`, `esp_nn_conv_s8_1x1`, `esp_nn_conv_s8_3x3_opt`). The FPU **is** used (`madd.s` in the disassembly) — an earlier check that appeared to show software float was run against the wrong compiler binary. The inference at 101.8 ms is 5 % of the 2 s window and acceptable for a triggered monitor, but the arena is still in PSRAM. |
| 2026-10-30 | **The Stage 2a firmware builds.** `firmware/hub_infer` compiles and links for the ESP32-S3: `firmware.bin` 468,800 B, RAM 52.1 %, flash 22.3 %, ESP-NN enabled, octal PSRAM at 80 MHz. Getting there meant fixing six separate things: (1) PlatformIO 6.2 installs a URL-pinned `framework-espidf` as if it were an **npm package**, so it read the wrong `package.json` and left `packages/framework-espidf` holding only a test fixture — CMake then failed with *"include could not find requested file: tools/cmake/project.cmake"*; fixed by installing the platform's own framework (**ESP-IDF 6.1.0**) by hand and dropping the `platform_packages` pin; (2) the top-level `CMakeLists.txt` **assigned** `EXTRA_COMPONENT_DIRS`, shadowing the `-DEXTRA_COMPONENT_DIRS:PATH=<src>` that PlatformIO passes for the application component, and pointed at a component instead of a directory that contains components; (3) the vendored components sat **outside** the project directory, and PlatformIO re-compiles IDF components with SCons using the *source basename* for object names — the TFLite Micro port has twelve basename collisions, so the build died with *"Multiple ways to build the same target were specified for …/circular_buffer.cc.o"*; moving the vendored components into `firmware/hub_infer/components/` makes the paths relative and distinct; (4) the port was wired to the registry copy of `esp-nn` while `esp-nn` was also vendored locally — a duplicate-component error — so `firmware/tools/patch_deps.py` now drops the registry dependency and adds `esp-nn` to the port's own requirements, keeping the build offline and pinned; (5) IDF 6.x moved `esp_flash.h` into the `spi_flash` component, changed `esp_flash_get_size()` to take a chip handle and an out-parameter, and requires an explicit capability argument on `heap_caps_calloc`; (6) the model copy is now aligned to 16 bytes by hand, because `heap_caps_malloc` only guarantees 4-byte alignment and the FlatBuffer verifier wants 16. | `firmware/hub_infer/*`, `firmware/tools/patch_deps.py`, `firmware/tools/fetch_deps.sh`, `.gitignore` | **`CONFIG_DDSP` no longer exists in IDF 6.x** and was dropped from `sdkconfig.defaults`. **The firmware has still never run on hardware** — there is no serial log yet, so the FlatBuffer alignment, the arena fit, the probe feature agreement and the latency are all still unverified. |
| 2026-10-30 | **The build finally configures — four real bugs found and fixed.** Diagnosis: PlatformIO 6.2 installs a URL-pinned `framework-espidf` by treating the archive as an npm package, so it read the wrong `package.json` out of the tree and left `packages/framework-espidf` holding only a test-fixture package — hence CMake's *"include could not find requested file: tools/cmake/project.cmake"*. Fixed by installing the platform's own framework by hand (**ESP-IDF 6.1.0**, `platform-espressif32` 8.0.0) and dropping the `platform_packages` URL pin. Also fixed: (1) the top-level `CMakeLists.txt` **assigned** `EXTRA_COMPONENT_DIRS`, shadowing the `-DEXTRA_COMPONENT_DIRS:PATH=<src>` that PlatformIO passes for the application component — it now *appends*, and points at `third_party/` (a directory that **contains** components) rather than at the component itself; (2) the vendored TFLM port was wired to the registry copy of `esp-nn` while `esp-nn` was also vendored locally — a duplicate-component error; `firmware/tools/patch_deps.py` now removes the registry dependency and adds `esp-nn` to the port's own requirements, keeping the build **offline and pinned**; (3) IDF 6.x moved `esp_flash.h` into the `spi_flash` component and changed `esp_flash_get_size()` to take a chip handle and an out-parameter; (4) `CONFIG_DDSP` no longer exists in IDF 6.x and was dropped from `sdkconfig.defaults`. | `firmware/hub_infer/CMakeLists.txt`, `firmware/hub_infer/platformio.ini`, `firmware/hub_infer/sdkconfig.defaults`, `firmware/hub_infer/src/main.c`, `firmware/hub_infer/src/CMakeLists.txt`, `firmware/tools/patch_deps.py`, `firmware/tools/fetch_deps.sh` | IDF 6.1 gives every component `freertos esp_hw_support heap log soc hal esp_rom esp_common esp_system` automatically, so the earlier `esp_heap_caps.h` ownership worry is moot. ESP-NN is worth keeping: on an S3 it is the difference between ~40 ms and ~2.3 s per convnet invoke. **The firmware has still never been compiled or run.** |---|
| 2026-10-29 | **Toolchain recovery documented.** The first ESP-IDF 5.3.2 install was killed mid-unpack by the background task's 30-minute limit, leaving a partial `framework-espidf` tree (no `tools/`, `main/`, `examples/`, `version.txt`). The partial tree was deleted and the build restarted; the 933 MB archive was already cached in `~/.platformio/.cache/downloads/`, so **no re-download was needed**. §4.3 now records the pin and a 3-step idempotent recovery. | `SYSTEM_UPDATE.md` | Restarted as background process `blewy4qwx` with a 2-hour limit. Still **NOT yet compiled**. |
| 2026-10-29 | **INT8-vs-float parity gap closed.** `research/verify_int8_parity.py` rebuilt the ICD validation fold (fold 4, 5,693 clips → 11,386 centre-cropped windows) from the cached archives with the notebook's own front end and ran the exported INT8 model and the float32 Keras model over it. **INT8 AUC 0.997926 vs float32 0.999299, ΔAUC −0.001373, decision agreement 99.956 %**; recall 0.9780 vs 0.9782 and FPR 0.0036 vs 0.0036 at the 0.95 threshold. The independently computed float AUC corroborates the Kaggle figure. Report: `research/out/verify_int8_parity.json`. | `research/verify_int8_parity.py`, `research/out/verify_int8_parity.json`, `SYSTEM_UPDATE.md` | Root cause of the NaN documented: the parity cell took a *prefix* of a label-sorted array, so the slice was 100 % cry and its AUC was undefined. The model was never affected. |
| 2026-10-29 | **Full Kaggle outputs received and staged.** `research/out/` contains the full run. Model `conv_cnn`, 137,384 bytes, SHA-256 `4aef55d8…126bc11`, threshold 0.95, input scale 0.060125612 / zp −4. `firmware/tools/check_artifact_drift.py` verifies the outputs and the staged copies against `deploy_config.json` — **PASS**. On-device probe references generated by `firmware/tools/gen_probe_refs.py` from the notebook's own front end. | `research/out/*`, `firmware/hub_infer/components/*`, `firmware/tools/*` | Val AUC 0.9994, test AUC 0.9995, cross AUC 0.9973. C/Python parity 6.905 × 10⁻⁵. **Gap:** `int8_val_auc` and `float_val_auc` are NaN in the full-run config; parity needs to be re-measured. |
| 2026-10-29 | **Stage 2a (hub inference core) scaffolded.** New ESP-IDF project with `crynet_model`, `crynet_dsp` (PSRAM-aware, reference FFT), `crynet_infer` (TFLM INT8), and the four on-device verification probes. PlatformIO espressif32 toolchain download/build in progress (`research/toolchain/pio_build.log`). | `firmware/hub_infer/*`, `firmware/tools/*` | **NOT yet compiled or run on hardware.** The user has not connected the board. TFLM port is checked out under `firmware/third_party/esp-tflite-micro` for testing but is not yet vendored/pinned; dependency wiring still needs completion. |
| 2026-10-29 | **Checkpoint-2 plan written into §4** — where to place the Kaggle `out/` (`research/out/`, now un-gitignored so the trained weights are versioned), the "firmware written from scratch" contract (§4.1: re-derived vs deliberately kept), the 4-stage plan 2a→2d (§4.2), and the toolchain status (§4.3). | `SYSTEM_UPDATE.md`, `.gitignore` | PlatformIO 6.2.0 installed via pip so the firmware can be compiled and checked here — this machine had no ESP-IDF, PlatformIO, Arduino IDE or Xtensa compiler. |
| 2026-10-29 | **CryNet repo made public** (was private) at the user's request. | GitHub repo settings | `github.com/Amazo123/CryNet` → private: false. |
| 2026-10-29 | **Added §6 "Legacy system vs. this rebuild"** — a line-by-line comparison of the abandoned system (read directly from the `legacy` remote) against the rebuild: architecture, model size (6.15 MB FP32 vs 135 KB INT8), mel bands, CMVN, dataset strategy, trigger/threshold, verification discipline. Documents what was inherited on purpose (hardware, topology, wire protocol) vs. re-decided (everything model/feature/threshold related), and states plainly that checkpoint 2 firmware is still pending. | `SYSTEM_UPDATE.md` | Answers the user's question about whether the rebuild is genuinely new or a re-skin of the failed system. Evidence: legacy `TinyCryNet` (attention + GRU, 6.15 MB), `RMS_TRIGGER_THRESHOLD 0.18`, 128 mel, no CMVN, ICD as a git submodule. |
| 2026-10-29 | **Checkpoint 1 committed and pushed to GitHub.** Created `github.com/Amazo123/CryNet` (private), committed the full checkpoint-1 deliverable as `e7be48a`, renamed the branch `master` → `main`, pushed with upstream tracking. The old repo was renamed remote `origin` → `legacy` and left as a read-only reference. | all checkpoint-1 files; `.gitignore` | `.gitignore` extended to exclude `research/_real_work/`, `research/_realfast_work/`, `*.exe`, `*.pdb`, `*.o`, `*.obj` (build scratch). Push verified: remote `main` = `e7be48a`, 34 files. |
| 2026-10-29 | **Created `SYSTEM_UPDATE.md`** — standing living status/recovery log. Imported the full checkpoint-1 state from `PROJECT_HANDOFF.md` and verified it against disk (`research/_realfast_out/*`, `metrics.json`, `deploy_config.json`, `real_fast.log`). | `SYSTEM_UPDATE.md` (new) | First entry. Establishes the update-after-every-edit protocol and the context-management rules (§0). |
| 2026-10-29 | `PROJECT_HANDOFF.md` §5 file map now points at `SYSTEM_UPDATE.md` as the living log / recovery layer. | `PROJECT_HANDOFF.md` | One-line map addition. |
| 2026-10-29 | Checkpoint 1 completed and validated (before this file existed). | `notebooks/crynet_training.ipynb`, `research/*` | Details in `PROJECT_HANDOFF.md` §4. |
| 2026-10-29 | Initial commit. | — | `997cc9b` |

---

## 6. Legacy system vs. this rebuild (what was inherited, what was re-decided)

Verified on 2026-10-29 by reading the legacy repo directly (`legacy` remote): `firmware/central_hub_s3/central_hub_s3.ino`, `dsp_mel_extractor.h`, `firmware/common/protocol.h`, `model_training/tiny_crynet_esp32.py`, `model_training/reference_pipeline.py`, `model_artifacts/README.md`, and the git tree.

### Inherited on purpose (hardware + topology — the user's real boards)
Same 3× ESP32-C3 cot nodes → ESP32-S3 hub → ESP32-C3 wearable; same ESP-NOW telemetry/audio-fragment protocol; same 2 s @ 16 kHz window with 512-pt FFT and hop 400; same `wearable_alert_packet_t` BLE format; same TFT/GATT UI. Nothing here was re-litigated, because the hardware is fixed and the wire format already exists.

### Re-decided from scratch (this is where the new work is)

| Aspect | Legacy system | This rebuild |
|---|---|---|
| Architecture | `TinyCryNet` — 5 × BSConvU blocks + **CCA channel attention** + **GRU** temporal aggregator (PyTorch → ONNX) | 3 plain CNN variants, **no attention, no RNN**, chosen so every op has a TFLite Micro kernel (asserted at export) |
| Model size | `model_data.h` = **6,157,199 bytes (6.15 MB)**, FP32 in flash; needed a bespoke **6.0 MB `app0` partition** | **135 KB INT8** — 45× smaller, fits comfortably in stock partitions |
| Input | `[1,1,81,128]` — 128 mel bands | `[1,81,64,1]` — 64 mel bands |
| Mel filter | `htk=True`, `fmin=0` | librosa **slaney**, `fmin=20 Hz` |
| Level handling | `power_to_db(top_db=80)` — **absolute dB, no normalisation** ⇒ the model was level-dependent | **per-window CMVN** ⇒ level-invariant (ICD cries sit at RMS 0.006 vs negatives at 0.3–0.46) |
| Dataset | ICD pulled in as a **git submodule** of an academic baseline repo (`ICD_MMSP`, tree mode 160000); one corpus, no audio-level verification, no external negatives | every corpus **profiled at audio level**; ICD as primary **combined with** cry4 + ESC-50 + Snoring; contaminated corpora rejected; negatives deliberately include cat meows, speech, snoring |
| Trigger | hard-coded `RMS_TRIGGER_THRESHOLD 0.18` + `CONFIRMATION_PROB 0.65` | trigger ~0.03 + silence gate 0.0015 + **threshold calibrated on data** (0.23 at ≥ 95 % recall) with the whole recall/FPR curve reported |
| Training | 35-epoch SpeechBrain/PyTorch run, artifacts in a 105 MB LFS tarball; no recorded per-class false-alarm analysis | Keras/TFLite notebook, **hard-example mining**, **per-category FPR breakdown**, cross-corpus evaluation on corpora never trained on |
| Verification | `verify_dsp_parity.py` existed as a simulation script | **automated** C↔Python parity (max deviation 7.06 × 10⁻⁵), INT8↔float parity (AUC delta −0.00007), TFLM kernel assertion at export, manifest↔archive 1:1 corpus check |
| Claimed latency | "≈ 40 ms" (never measured on the board) | **measured on the chip**: front end **41.7 ms**, inference **101.8 ms** per 2 s window, CPU 240 MHz |

### Why the legacy system failed — and what that means
The legacy repo's **last commit** is `fix(firmware): resolve false cry detection, packet loss, and full-screen landscape display` — i.e. the system was still being debugged on the hardware when it was abandoned, and the failures it was chasing were *system-level* (ESP-NOW packet loss, TFT layout, false triggers), not dataset-level. With `RMS_TRIGGER_THRESHOLD 0.18`, a soft cry (ICD cries sit at RMS ≈ 0.006) **never reached the classifier at all**, so the old model was never fairly tested on the real hardware. The rebuild therefore changed the model, the features, the trigger and the threshold — but the *dataset* was kept, because the evidence points at the firmware and the trigger logic, not at ICD.

### What is still not new / not proven yet
- **Checkpoint 2 (firmware) is more than half written.** The hub's inference core (Stage 2a) is new, verified on the real chip, and committed. The node firmware (Stage 2b) runs on the real board and produces verified audio. The hub's radio (Stage 2c) is verified end to end — audio crosses the ESP-NOW link with a matching CRC-32 and the model runs on it. The TFT display and the BLE GATT server (the rest of Stage 2c) are written and running together on the real hub (2026-10-31); the wearable (Stage 2d) does not exist yet.
- **No in-domain data.** The model has never heard the user's INMP441, room or gain. ~50 self-recorded clips remain the single biggest accuracy win, and they are also the honest test of whether the new system actually works in the real room.

---

## 7. Quick reference

**Run locally**
```bash
pip install numpy librosa soundfile soxr scipy scikit-learn tensorflow huggingface_hub
cd research && python make_stub.py && bash run_stub.sh     # synthetic smoke test
bash run_real_fast.sh                                       # real corpus, subsampled, CPU
pip install ziglang && python test_c_parity.py              # C <-> Python parity
```

**Notebook env switches**
`CRYNET_FAST=1` (subsample + 3 epochs) · `CRYNET_OFFLINE=1` · `CRYNET_KINDS=conv_cnn,sep_cnn,temporal_cnn` · `CRYNET_EPOCHS=35` · `CRYNET_MINING_ROUNDS=1` · `CRYNET_CACHE` / `CRYNET_WORK` / `CRYNET_OUT`.

**Caches**
HF archives at `research/_cache/audio/positive.zip`, `.../audio/negative.zip`, `research/_cache/metadata/all28479.csv`. Kaggle archives at `research/_cache/<key>__<owner>__<slug>.zip`.

**Verified local versions**
Python 3.11.9 · TensorFlow 2.21.0 (CPU) · librosa 0.11.0 · soundfile 0.14.0 · numpy 2.4.6 · scipy 1.17.1 · ziglang 21.1.0 (C compiler for the parity test; no gcc installed).
