Amazo123/CryNet-TwoNode/DECISIONS.md

# CryNet — decision and issue log

> **What this file is.** The project's report and documentation record: every
> decision that was made, why it was made, every issue that was hit, how it
> was diagnosed, what was done about it, and what the result was.
>
> **Repo:** `C:\Users\HP\.t3\projects\fp-two-node` (branch `main`, remote
> `origin` → `https://github.com/Amazo123/CryNet-TwoNode.git`)
> **Companion files:** `SYSTEM_UPDATE.md` (the living status log and recovery
> layer — rewritten after every change) and `PROJECT_HANDOFF.md` (the deep
> briefing: the frozen contracts and the file map).
> **Sibling repository:** `C:\Users\HP\.t3\projects\fp-2` (branch `main`,
> remote `crynet` → `https://github.com/Amazo123/CryNet.git`) — the **three-cot**
> system. The two repositories share their history up to commit `99bb257` and
> then diverge; the two-node system is the one on the bench.
> **Last updated:** 2026-11-06
>
> **Conventions.** Each decision is written as **D-n** and each issue as
> **I-n**. A decision that was later changed carries a "revised by" note
> rather than being deleted, so the reasoning history survives. Every claim
> here was measured on the real hardware or in a real run; nothing is
> asserted from theory alone.

---

## 0. The system in one paragraph

**Two** ESP32-C3 cot nodes (INMP441 microphone, I2S at 16 kHz) → ESP-NOW
radio → an **ESP32-S3-DevKitC-1 hub** that reassembles each node's two-second
window, runs a TFLite Micro INT8 binary cry/no-cry classifier on it, and
shows the result on an ILI9341 TFT and publishes it over BLE GATT → a wearable
(ESP32-C3 + SSD1306 OLED + **BC547 haptic motor**) on the caregiver's wrist.
The classifier, the model and the signal contract are shared with the
three-cot sibling repository `fp-2`; what differs here is the node count, the
haptic circuit, and the wearable's role. The previous firmware attempt failed
after flashing, so the project was rebuilt from model training upwards.

---

## 1. The decisions

### 1.1 Scope and architecture

| # | Decision | Why |
|---|---|---|
| **D-1** | **Binary cry / no-cry**, not a multi-class head. | The BLE packet the wearable firmware was written against carries `alert_type 0x01` for a cry. There is no wire format for "cough" or "tired" without changing the wearable. Binary keeps the protocol honest and the alert unambiguous. |
| **D-2** | **Rebuild the firmware from scratch in ESP-IDF** rather than port the abandoned Arduino code. | The legacy hub was one 46 KB `.ino` with global state and a `loop()`/FreeRTOS mix. Its DSP implemented the *old* feature contract (128 mel bands, HTK scale, no normalisation), which is incompatible with the new model, so a "port" would have meant rewriting the signal path anyway. Rewriting gave a component tree, a single explicit state machine, and a wire format with per-fragment integrity. |
| **D-3** | **Keep the hardware facts, re-derive the software.** Physical pin assignments, the 3-node → hub → wearable topology and the legacy BLE UUIDs were inherited unchanged; the model, features, trigger, threshold, transport and application architecture were re-derived. | The boards and the wiring are facts about the user's real hardware. The parts that failed were the ones that had been guessed. Section 6 of `SYSTEM_UPDATE.md` carries the line-by-line comparison against the legacy repo. |
| **D-4** | **Model training first, firmware second.** The model is retrained and exported before any firmware is written. | The legacy system's trigger (`RMS ≥ 0.18`) meant a soft cry (the ICD corpus sits at RMS ≈ 0.006) never reached its classifier at all, so the old model was never fairly tested. Training first means the firmware is built against a contract that is known to work on real audio. |
| **D-5** | **One artifact per checkpoint; the agent updates `SYSTEM_UPDATE.md` after every edit and never pastes large logs into chat.** | Sessions were repeatedly lost to "400 Context Limit Exceeded". The status log is the recovery layer, and the checkpoints mean a crash costs one stage rather than the project. |

### 1.2 Data

| # | Decision | Why |
|---|---|---|
| **D-6** | **Every candidate corpus was profiled at audio level** (sample rate, duration, RMS, autocorrelation F0, spectral centroid and flatness) before any of it was used. | Sample rate and level decide whether a corpus can train a model that will run behind a fixed signal contract. A corpus that is 8 kHz or whose "silence" is loud cannot be mixed into a dataset that has none. |
| **D-7** | **Primary corpus: ICD (`hoyyu1/infant-cry-detection`)**, 28,478 clips, all 16 kHz mono 5.00 s, five shipped folds. Added: **Baby Cry 4-class** (cry diversity and a cross-corpus test), **ESC-50** (negatives and 40 held-out `crying_baby`), **Snoring** (hard negatives). | ICD is the only large, clean, 16 kHz cry corpus available without gating. The others widen the negative class and prove the model is not tuned to one recorder. |
| **D-8** | **Rejected corpora and the reason for each:** `mennaahmed23/baby-cry*` family — **contaminated** (fake "silence" at RMS 0.22, renamed ESC-50, synthetic derivatives); `rahult25/five-class…` — pitch-shifted derivatives of the same material; ICSD — gated on Hugging Face; AxonData — paid; Baby Chillanto — request-only; AudioSet / FSD50K — redundant; raw DonateACry — 8 kHz and skewed, and already merged into cry4. | Contaminated or derivative data does not add information and can teach the model the contamination. Gated or paid corpora cannot be re-fetched by the notebook, so the run would not be reproducible. |
| **D-9** | **Negatives deliberately include cat meows, speech and snoring.** | The deployed negative is a room, a baby and a television, not silence. A model that has only ever seen silence as a negative will fire on a fan. |
| **D-10** | **Label policy: "any cry present" in the 2 s window** (approximately three or more active frames). | The window is the unit the firmware classifies. A soft label (the loudest frame) would disagree with the label the hub's trigger effectively uses. |
| **D-51** | **Music joins the training corpus: GTZAN (Kaggle `carlthome/gtzan-genre-collection`, ten genres, 1,000 real recordings) as an all-negative corpus, with random windows per clip and the same 75 / 25 train / cross-corpus split as the other supplementary corpora.** | The false-alarm map of 2026-10-31 found that **no corpus in the training mix contained any music** — not ICD, not ESC-50, not the cry set, not the snoring set — so the model had never been taught to reject a song, and ESC-50 could not be used to measure it either, because ESC-50 has no music in it. A nursery has a radio, a television and a mobile playing something, so music is a first-class confusion class, not an afterthought. Random windows rather than a single centred one, because a thirty-second track is not one sound: the part that plays in the cot matters, not the average of the track. The 25 % held out keeps the model measurable on music it has never seen. |
| **D-52** | **`ZipReader` gained `index_by_path()` and `build_corpus` falls back to it.** | GTZAN names every clip `blues.00000.au` … `blues.00099.au`, once per genre — the same file name in ten folders. A stem index keeps only the first of them, so four fifths of the corpus would have vanished silently and the run would have looked normal. |

### 1.3 The signal contract (frozen — D-11)

Nothing in the firmware, the exported tables or the weights may change without changing all of them at once.

```
int16 pcm[32000] (2.0 s @ 16 kHz mono)
  → /32768 → subtract mean → zero-pad 256 front / 512 rear
  → 81 frames, 512-pt symmetric Hann, hop 400
  → |rfft|² (257 bins)
  → 64 Mel bands (librosa slaney, 20 Hz–8 kHz, 497 non-zero weights)
  → 10·log10(max(P, 1e-10)) floored at −80 dB
  → per-window standardisation (CMVN)
  → int8 quantise → TFLM → [P(no_cry), P(cry)]
```

| Constant | Value | Constant | Value |
|---|---|---|---|
| SR | 16000 | N_FFT | 512 |
| WIN_SEC | 2.0 | HOP | 400 |
| N_SAMPLES | 32000 | N_MELS | 64 |
| N_FRAMES | 81 | FMIN/FMAX | 20 / 8000 |
| CENTER_PAD | 256 | TAIL_PAD | 512 |
| DB_FLOOR | −80 dB | LOG_EPS | 1e-10 |
| CMVN | True | SILENCE_RMS_GATE | 0.0015 |
| TARGET_RECALL | 0.95 | SEED | 1337 |

| # | Decision | Why |
|---|---|---|
| **D-11** | **Freeze the signal contract, and export the Mel filterbank from Python into C** (`crynet_tables.h`). | The firmware cannot drift from the model if the filterbank *is* the model's filterbank: the weights are copied, not reimplemented. A hand-written Mel in C would drift silently and only show up as a small accuracy loss on the board. |
| **D-12** | **Per-window CMVN, not absolute dB.** | The legacy system used `power_to_db(top_db=80)` — absolute dB with no normalisation — which made the model level-dependent, and the deployed levels are wildly different from the training levels (ICD cries sit at RMS 0.006, the user's INMP441 room sits at 0.002–0.016 and a cry at 0.057–0.082). CMVN makes the model level-invariant, which is what lets one threshold work in both places. |
| **D-13** | **64 Mel bands, librosa slaney scale, fmin 20 Hz** (not the legacy 128 HTK bands). | A consequence of D-11: the features are defined by the notebook that trained the model. Changing them changes the meaning of the weights. |
| **D-14** | **The DC-removal mean is an exact `int32` sum, and the 100 ms RMS reported by the node is computed with the mean of the whole two-second window removed.** | Two reasons. First, a float accumulator loses counts on 32,000 samples and the residual DC is what the per-window standardisation then amplifies (see I-1). Second, the number the node reports must be *the same quantity* the hub's front end computes for that window — otherwise the hub's 0.03 trigger means nothing. |

### 1.4 The model and its verification

| # | Decision | Why |
|---|---|---|
| **D-15** | **Three plain CNN variants, no attention and no RNN** (`conv_cnn`, `sep_cnn`, `temporal_cnn`), and **every op is asserted to have a TFLite Micro kernel at export time**. | The legacy `TinyCryNet` (channel attention + GRU) needed ONNX and a bespoke 6.0 MB `app0` partition. Constraining the architecture to ops TFLM implements means the model is deployable on the target at all, and the assertion makes that a build-time fact rather than a hope. |
| **D-16** | **`conv_cnn` selected**: 122,770 parameters, val AUC **0.9994**, cross-corpus AUC **0.9973**; INT8 artefact **137,384 bytes**, SHA-256 `4aef55d8…126bc11`. | Best validation and cross-corpus AUC of the three, and 45× smaller than the legacy 6.15 MB FP32 model, so it fits a stock partition with room to spare. |
| **D-17** | **Calibrated alarm threshold = 0.95**, re-derived from the full run (an earlier subsample's 0.23 no longer applies). | The threshold is a *calibration result*, not a guess: it is the point on the recall curve that holds ≥ 0.95 recall, and the whole recall/FPR curve is reported with it. |
| **D-18** | **Verification is automated and numerical at every layer**: C front end vs Python, INT8 vs float32, TFLM kernel check, and the same four probes run *on the chip*. | The legacy repo had a parity script but it was a simulation. Four of the five Stage 2a defects were only findable by running the code on the silicon (I-1 through I-5). |
| **D-19** | **The tensor arena is reserved in PSRAM** (262,144 B reserved, 108,328 B used). | The 256 KB arena does not fit in the S3's internal SRAM alongside everything else. PSRAM is slower but the arena is touched linearly. Moving it into internal SRAM is the obvious next optimisation and was not needed for a triggered monitor. |

**Measured results (authoritative, from the full Kaggle run):**

| Split | AUC | F1 | Recall | Precision |
|---|---|---|---|---|
| ICD val (fold 4) | **0.9994** | 0.9905 | 0.9844 | 0.9966 |
| ICD test (fold 5) | **0.9995** | 0.9905 | — | — |
| cross-corpus (cry4 + ESC-50 + snoring, never trained on) | **0.9973** | 0.9801 | — | — |

| Check | Result |
|---|---|
| C front end vs Python (real run) | max deviation **6.905 × 10⁻⁵**, mean 2.79 × 10⁻⁶ |
| INT8 vs float32 (11,386 windows, host-measured) | ΔAUC **−0.001373**, decision agreement **99.956 %**, recall @ 0.95 0.9780 vs 0.9782, FPR 0.0036 vs 0.0036 |
| TFLM kernel check | `CONV_2D, FULLY_CONNECTED, MAX_POOL_2D, MEAN, SOFTMAX` — all present |
| On-device probes (ESP32-S3) | **4/4 PASS** — features match the host exactly on three probes, within 1 LSB on 3 of 5,184 values on the fourth |

### 1.5 Decision logic

| # | Decision | Why |
|---|---|---|
| **D-20** | **The trigger is RMS ≥ 0.030, not the legacy 0.18.** | The legacy value was a real bug: soft cries never reached a classifier. 0.030 sits an order of magnitude above the measured quiet room (0.002–0.016) and below a real cry (0.057–0.082), and it is the *same* number on the node and the hub. |
| **D-21** | **The trigger requires the level to have been sustained for two telemetry readings** (~200 ms), and the node's own event level is 0.030 as well. | The INMP441's slow DC drift produces one lone reading above the trigger on its own. In the quiet room the old trigger fired on the drift and pulled bursts continuously; the sustained rule stays quiet. |
| **D-22** | **The node freezes the window *before* it announces it**, and advertises the window's sequence number and CRC-32 in the telemetry. | The hub triggers on the node's 100 ms RMS but is served a *two-second* window. Before this change the hub was handed the live window, whose average is mostly the gaps between cries (trigger 0.0710 → window 0.0182 → "no cry"). Freezing first also gives the hub something it can *check*: the CRC-32 of the window it reassembles must equal the one the node froze, which is the proof that the audio crossed the link unchanged. |
| **D-23** | **A burst is analysed only when every one of its 286 fragments is present.** | A hole in the window is a hole in the audio. The alternative — analysing a partial window — would feed the classifier a signal the model never saw. The link tolerates loss by *recovering* it (D-26), not by pretending it away. |
| **D-24** | **The alert is published on state *change*, not per window, and only after the cry has been held for `CRY_HOLD_MS` = 8000 ms.** | A recording of cries has gaps; a per-window alert would flap on and off. One notification when a cot starts crying and one when it stops is what a caregiver needs. |
| **D-25** | **A silence gate of 0.0015 sits below the trigger.** | Below the gate the window is silence and no classification is meaningful. Above it, the calibrated 0.95 threshold decides. |

### 1.6 The radio link (node ↔ hub)

| # | Decision | Why |
|---|---|---|
| **D-26** | **The hub may ask the node to re-send the exact fragments that went missing** — a new `RESEND` frame carrying a 36-byte bitmap, one bit per fragment. This is the mechanism that makes the burst complete despite airtime loss. | The hub's radio is deaf whenever it is retuned to a Bluetooth channel, so a burst of 286 frames sent flat out always loses a few of them, scattered through the middle. The link must tolerate that by *recovery*, and a bitmap of the missing fragments is the cheapest way to ask: one 54-byte request covers any scattered pattern, and the node re-sends only what is missing. See I-24 to I-28. |
| **D-27** | **The stall detector asks for the missing fragments as soon as the burst stops growing**, and the wait before it declares a stall grows with the number of fragments still missing. | Asking early keeps the latency down; asking proportionally avoids spending a round while the node is still sending a hundred fragments that take a second and a half to arrive. |
| **D-28** | **The resend request is sent three times, and the node answers a repeat of the request it is already serving only once.** | ESP-NOW broadcast is never acknowledged: the sender is told the frame left the queue, not that it arrived. A resend request sent at exactly the moment the burst has just gone quiet is at the moment the radio has been busiest. Repeating the request covers a lost one; the node's dedupe stops the repeats turning into two or three redundant sends of a hundred fragments. |
| **D-29** | **The node holds an uploaded window for four seconds before freezing the next one.** | The upload is not the end of the conversation about that window: the hub asks for the fragments it missed, and only the node can send them again. The node used to freeze the next window about three seconds after the upload, and the hub's first request for the missing fragments often arrived just after that — by which time the node had thrown the old window away and refused the request. |
| **D-30** | **The hub abandons a burst the node can no longer complete** — if the node's telemetry reports a newer window sequence while a burst is in flight, the burst is dropped and the newer window is asked for at once. | The node no longer holds the fragments of the old window, so the burst cannot be completed and waiting out the 15-second timeout only delays the next attempt. |
| **D-31** | **ESP-NOW channel 6, set explicitly on both sides with `esp_wifi_set_channel()`** — not `WiFi.channel()`. | The Arduino core has no channel *setter*: `WiFi.channel(x)` is the scan result's channel (`WiFiScanClass::channel(uint8_t i)`), so the call compiled, returned an int, and changed nothing. The node sat on channel 1 while the hub sat on 6 and the sends failed with "peer channel is not equal to the home channel". ESP-NOW does not roam. The channel is also set *after* `esp_now_init()`, because starting the driver puts the interface back on channel 1. |
| **D-32** | **Broadcast at 10 Hz; unicast was tried and rolled back.** | Unicast to the learned hub address wedged the ESP-NOW send path: the frame was accepted, never transmitted, the send callback never fired, and every send burned its wait cap until the loop starved. Broadcast is reliable now that the node's loop runs in real time, and it disproved the earlier "the hub radio sleeps" theory — which is why the 100 ms heartbeat was removed (`WIFI_PS_NONE` plus constant node traffic is why the hub hears everything). |
| **D-33** | **The node waits for the previous frame's send callback before queueing the next one**, and paces the fragments about 13 ms apart. | ESP-NOW's transmit queue is ten frames deep; a 286-fragment burst sent back to back overflows it and every frame past the tenth is lost for good. The pacing spreads the burst over about four seconds, which the hub's timeout has plenty of room for. |
| **D-34** | **Promiscuous Wi-Fi mode is off by default** (build with `-DCRYNET_LINK_PROMISCUOUS=1` to bring it back). | It hands the host *every* frame on the channel. With the laptop's own Wi-Fi on channel 1 that flooded the receive path and cost the hub about fifteen fragments out of every burst. |
| **D-35** | **Every frame carries a CRC-16/CCITT-FALSE; the frozen window additionally carries a CRC-32 (the IEEE 802.3 one, the same function `zlib.crc32` computes).** | The CRC-16 covers each frame's header and payload; the CRC-32 covers the whole two-second window and is what proves the reassembled audio is byte-for-byte what the node froze. The wire format was validated numerically *before* any hardware was involved: CRC-16 reproduces the standard check vector `0x29B1`, and the C frame builder and the Python parser agree on every header offset and both CRCs. |
| **D-36** | **A fragment belonging to a window the hub did not ask for is dropped, not counted.** | The radio delivers frames in the order it wants to; one straggler from the last burst must not wipe the burst being assembled now. |
| **D-37** | **The node's serial console can never cost the node loop time** (`Serial.setTxTimeoutMs(0)`). | See I-12 — this was the root cause of a whole week of "the microphone is dead" symptoms. |
| **D-38** | **The node's radio is set up on channel 6 and the peer is added from `loop()`, never from a receive callback.** | `esp_now_add_peer()` waits for the Wi-Fi task to service it. Called from inside that task's own callback it blocks the very task it is waiting for, and the radio stops delivering frames until something else nudges it loose — the hub was receiving one frame in sixty. The hub's own `node_link.c` documents this trap. |

### 1.7 The hub system: memory, Bluetooth, display

| # | Decision | Why |
|---|---|---|
| **D-39** | **Boot-only buffers live in PSRAM and are freed after the probes run.** | 154 KB of the hub's static RAM (the probe PCM, the Mel and quantise buffers, and a 64 KB CRC buffer) was needed only while the boot probes ran, but as statics it held internal RAM for the life of the program — which is exactly the RAM NimBLE's store configuration wanted. Moving them to PSRAM took the hub's RAM from **59.9 % to 12.9 %** (196,140 B → 42,236 B) and made the whole stack fit: free internal heap 298,763 B at boot → 290,791 B after the probes → **215,155 B with the radio up → 149,271 B with Bluetooth up**. |
| **D-40** | **Init order: radio → Bluetooth → display.** | NimBLE's pools and the Wi-Fi driver's buffers come out of the same internal RAM, and when Bluetooth claimed its memory first the Wi-Fi driver ran out mid-init (`esf_buf_setup_static: alloc eb fail(1)`) and the ESP-NOW link never started. The radio takes what it needs while the heap is whole; Bluetooth lives on what is left. The panel is optional — a dead display must not stop the monitoring. |
| **D-41** | **`CONFIG_ESP_COEX_SW_COEXIST_ENABLE=y`** so the two stacks share airtime. | The one radio has to carry both. Coexistence is the software arbitrator; without it the two stacks fight. |
| **D-42** | **The BLE server serves the legacy UUIDs**, so the wearable firmware written against them keeps working: service `19b10000-e8f2-537e-4f6c-d104768a1214`, alert characteristic `19b10001-…` (read/notify/indicate; the legacy six-byte packet — cot id, alert type 1 = cry / 2 = cancel, confidence %, event id), plus a **new** state characteristic `19b10002-…` carrying the whole system (`cots`, `crying_mask`, loudest confidence, how long the cry has run). | Reusing the UUIDs means the wearable is a drop-in. The extra state characteristic is for a phone that opens late: it still sees the current state without waiting for the next change. |
| **D-43** | **The display is a state snapshot behind a spinlock, redrawn by a low-priority task pinned to core 1**, and each line is erased to the right edge so a shorter string cannot leave the tail of a longer one on the panel. | A 30 ms SPI burst must never delay the link loop or the inference. The level bar is sqrt-scaled so a quiet room still shows a sliver and the 0.030 trigger lands about a third of the way up. |
| **D-44** | **The Wi-Fi receive buffers were raised to 32 static / 64 dynamic** once the RAM was free. | The node sends a 286-fragment burst as fast as the radio allows; the hub needs receive buffers that can hold one. |
| **D-51** | **The 5x7 font table is indexed by the raw ASCII code — `font[c * 5 + i]`, the way `Adafruit_GFX::drawChar` reads it — and `research/build_font.py` now *detects* that base instead of assuming it.** | Adafruit's table is 1,280 bytes, and the first 32 entries are decorative icons (hearts and diamonds): the printable set starts at ASCII 0x20, so a character lives at byte `code * 5`, **not** `(code - 0x20) * 5`. The generator now finds the classic exclamation mark (`00 00 5F 00 00`) in the table, derives the base from where it lands, and refuses to write the header unless it finds it in exactly one place — so a font with a different layout fails loudly instead of producing a screen of nonsense (I-33). |
| **D-52** | **The panel shows the caregiver's device: a `PHONE` pill — green when a client is connected and subscribed, amber when the Bluetooth stack is up but nobody has attached, dim when Bluetooth is down — and a confirmed cry with nobody attached reads `ALERT NOT DELIVERED`.** | The user asked for the old system's arrangement, "the status of all nodes and the wearable". The wearable and the caregiver's phone connect to the *same* legacy GATT service, so the hub cannot tell them apart and does not pretend to: the pill says that a caregiver device is attached. A cry that reaches a hub with no listener has gone nowhere, and the caregiver has to be able to see that on the panel instead of discovering it by waiting for an alert that never comes. |
| **D-53** | **The framebuffer is RGB565 and the panel is told so: `MADCTL_BGR` is not set, and the inversion state is pinned explicitly with `INVOFF`.** | The ILI9341's `BGR` bit in `MADCTL` tells the controller that the *top* bits of each 16-bit pixel are blue. The framebuffer puts **red** there (`DISPLAY_RGB(r,g,b)` is `(r & 0xF8) << 8 \| (g & 0xFC) << 3 \| (b >> 3)` — standard RGB565), so leaving `BGR` set made every colour arrive with red and blue exchanged (I-35). The bit was inherited from Adafruit's rotation-2 setting, which this panel's legacy firmware used; whatever pairing that library keeps internally, **this** driver writes plain RGB565, and the measurement in I-35 says the panel was being told the other order. `INVOFF` (0x20) is now sent explicitly even though the chip's reset default is already "inversion off": the picture should not depend on what the last user of this glass left in the controller, and one explicit command removes the variable from every future photograph. |
| **D-54** | **The footer counts the cots that are answering, not the cards on the screen.** The count came from `st->node_count` - the number of cot slots the hub has - so a card for a cot that had gone quiet was still counted as a linked cot, and the panel read '3 cots linked' above two cards that both said NO SIGNAL. | The panel is the one surface the caregiver is certain to look, and a number on it that contradicts the cards directly above it teaches the caregiver not to trust the screen. A cot that has gone quiet is a cot that is not linked, whatever slot it occupies. The footer now counts ONLINE cards and says 'no cots linked' when none are answering. |
| **D-55** | **The backlight is a brightness, not an on/off switch: the pin is a LEDC PWM output at 5 kHz, on at 55 % by default (`hub_display_set_brightness()`), and the BOOT button opens a *colour check* - a grid of the palette's swatches.** | The second photograph of the panel showed the R/B swap fixed (the `PHONE` square is warm orange where it had been blue, the accent underline teal-green where it had been pink) but the whole screen came out saturated blue. The panel was not doing that on its own: the earlier photograph, taken in a dark room and properly exposed, shows a near-black background rendering as a light pink-grey, and the new one is a close-up whose highlights are **clipped** (the `RADIO` square measures (144,255,255) - fully blown out). A photograph of a glowing panel in a dark room is not a colour measurement: the camera opens up for the screen, the highlights clip and the white balance drifts with what it sees. So the fault was on the panel's side of the wire, and the lever there is the backlight - a TFT at 100 % in a dark room glares, and a glare is what makes a colour look like the wrong colour. 55 % keeps the dark navy background dark and lets the teal read as teal. The **colour check** is the instrument: with a photograph of the swatches, the panel's own colours can be read off directly - black and white at the ends of the first row, the accent in the middle, the alert colour last, where a red that is really a swapped blue cannot hide - so the palette can be *compensated* if the panel's own black level really is lifted. |
| **D-56** | **The neutrals are darker and teal-tinted: the background is `(7,15,16)`, not `(12,20,32)`, and the surfaces, border and dim text follow.** | The colour-check page (D-55) measured this panel's own behaviour for the first time. Its hues are all correct - black is black, white is white, teal is teal, amber is amber, rose is rose - so the R/B swap is behind us (I-35). But the **dark end is lifted**: the old navy `(12,20,32)` came back as a saturated blue while the `(0,0,0)` black beside it stayed black, and the lift is worst in the blue channel (the amber swatch's requested blue of 36 measured back at 145). So the rule this panel obeys is **the less blue the screen asks for, the less blue it gets**. The neutrals were changed accordingly, and they were changed to *teal*-tinted rather than merely dark, because the user asked for the screen to read as teal: the theme now says teal in its darks as well as in its accent. What the screen *says* is unchanged - teal for the system, green for a cot that is fine, amber for a loud one, rose for a confirmed cry - and every contrast was re-checked afterwards (text 16.6:1 on the background, dim 6.1:1, accent 10.4:1, card border 3.4:1). |
| **D-57** | **The level of the teal was picked off the panel itself: shown the dark ramp, the user chose its third step, `(4,8,8)`, as the teal the screen should be - one step darker than the background it replaced - and the whole neutral family moved down one step of the same ramp with it.** | The fourth step `(7,15,16)` was the background this replaces, and it still read as bright blue on the glass. A photograph cannot measure absolute colour (I-38), but a ramp step is a colour the firmware *asked for* - so a choice made on the ramp is exact no matter what the camera does, which is what makes the ramp the right instrument for this decision. The surfaces follow the background one step apart so the cards stay a shade above it: background `(4,8,8)`, surface `(7,15,16)`, surface-hi `(12,26,28)`. The border and the dim text keep their levels: contrast only improves as the background darkens, and the re-check confirms it (text 16.5:1 on a card, dim 6.3:1, accent 8.5:1, alert 5.8:1, card border 3.72:1 - every threshold it has to clear it clears with room to spare). |
| **D-58** | **The retrained model — the second full Kaggle run, with the GTZAN music corpus trained in — is deployed to the hub and verified 4/4 on the board.** Same architecture (122,770 params, cross-AUC 0.9987), new weights, and a recalibrated input: `IN_SCALE` 0.060125612 → 0.116329655, `IN_ZP` −4 → −70. Threshold 0.95, the silence gate, the output calibration and the geometry are unchanged. | The 8.19 % music false-alarm rate (O-8) was the project's sharpest measured failure and it was structural — music had never been in the training corpus — so the training round was the only fix, and it was measured before deployment on the repo's own evals: **music alarms 79/965 = 8.19 % → 2/965 = 0.21 %**; ESC-50 non-cry alarms 38/1439 = 2.64 % → 17/1439 = 1.18 %; ESC-50 `crying_baby` recall **36/40 → 36/40, identical**; quiet room 0/236 → 0/236, identical. The cost is honest and accepted: per-window INT8 recall on the phone-speaker cry sessions dropped (session 1: 0.867 → 0.800; session 4: 0.724 → 0.592, while that session's AUC *rose* 0.928 → 0.941). A cry is sustained: at 0.592 per-window recall an eight-window cry episode is missed entirely with probability (1−0.592)⁸ ≈ 0.0006 if windows were independent, so episodes still trip the alert. And the phone-speaker recordings are the weakest cry proxy in the building (O-2). On-device: `c_parity.json` max abs diff 6.9e-5; after regenerating the probe references (I-41) the boot self-check reads **RESULT: PASS — 4 probes, 5184/5184 features exact on every probe**, inference 102 ms per window, the noise probe alerts at P(cry) 0.9805, the radio is clean (339 frames, 0 bad). The old model is backed up at `research/out/deployed_model_backup/`. | 

| **D-59** | **The second look from the chair: the background dropped another step of the same dark ramp — `(4,8,8)` → `(2,4,4)` — the header strip got its own green-biased colour `(7,20,15)`, a live cot's outline is now the full-strength vibrant teal (rose, when it cries), and a no-signal card recedes.** | One photograph of the new palette said four things. The cards and the ground read as the same colour: the surface was one ramp step above the background, and this panel lifts the dark end until a two-step gap reads as one — so the background went down another step of the same ramp and the cards keep `(7,15,16)`. The header photographed blue while the cards photographed teal even though the firmware paints both `C_SURFACE`: the backlight's LEDs run along the top edge of the glass, and that strip lifts blue hardest — the same panel behaviour D-56 measured — so the header asks for five steps of green *above* blue, which the lift spends on its way in. And the online/offline treatments were backwards in effect, exactly as the user saw it: the live cards' outline was a 45 % blend toward the border while the no-signal cards carried the plain border, so the dead cards read as the livelier ones; the user asked for the swap. Live cards now get `C_ACCENT` at full strength (rose when crying); dead cards get the border washed towards the background — and their empty level bars too, because an empty bar in a full-strength frame also read as "active". Contrast re-checked (text 16.47:1 on a card, dim 6.46:1 on the darker ground, accent 8.47:1, alert 5.84:1, card border 3.72:1); built and flashed; the boot self-check reads PASS, 4 probes, 5184/5184 exact, and the radio is clean. **Amended within the hour, on the user's second look:** the *fills* were swapped by hand - the accent wash read faint and the border wash read as the denser, more active surface, the opposite of what the accent wash was meant to say - so a live card now wears the border-washed fill and a dead card the faint accent wash (the outlines, fixed in the same round, stay); and the dead card's word became **OFFLINE**, the network term for the state the card is in, at the user's suggestion. |
| **D-60** | **The in-room confusion session is recorded (O-9 closed), and the honest in-room number is **0 false alarms in 308 windows of non-cry audio**, **86.4 % per-window recall on a cry at 15 cm** - and the limit on how far the hub can hear is the **trigger**, not the model. | Nine one-minute takes with `node_capture` on the real INMP441: quiet room, speech at desk distance, speech at 30 cm, music at 1 m, music at 30 cm, a film at 1 m, a film at 30 cm, the phone-played cry at 15 cm, the phone-played cry at 1 m. **The model raised no alarm on a single non-cry window: 308 windows of speech, music and film, 0 false alarms** - including the two loud takes, where the trigger fired on 269/590 and 493/590 records, so the model was asked 44 times in each and refused every time. On the retrained model this is the room-level version of D-58's GTZAN result (8.19 % -> 0.21 %): on the loudest music this room can produce, 0/44. The cry at 15 cm - the realistic case, the mic is *in* the cot - is caught in 38 of 44 windows (86.4 %). **The cry at 1 m reaches a median RMS of 0.0070 and 0 of 590 records cross the 0.030 trigger, so it is never offered to the model at all** (asked anyway, the model would have caught 18 of 44): the system's reach is set by software, not by the microphone: the INMP441 has **no gain setting** - its L/R pin is a left/right *channel select*, not a gain strap, and the part is fixed at -26 dBFS +/-3 dB sensitivity - so the levers are the hub's trigger threshold and a digital gain in the telemetry path, and the better version of the trigger is an *adaptive* one (a multiple of the node's own running noise floor, which here is 0.0020, so 3x = 0.006 would pass the one-metre phone). Lowering the trigger to ~0.012 is the same lever from the other end and the evidence supports trying it in the next training round, but it is **not** changed on the strength of 308 windows from one afternoon. The labelling tool grew a `--truth` flag for this: the old auto-label called a clip 'cry' if it was *loud*, which for the music and film takes would have labelled the loudest non-cry clips as cries and measured nothing. | Full table, method and caveats: `research/in_domain/SESSION_REPORT.md`. |
| **D-61** | **The burst is 2.06 s instead of 5.5-6.9 s, and the panel now shows a cry about two and a half seconds after it happened instead of eight.** The cause of the slow burst was the hub's own Bluetooth advertising: the ESP32-S3 has one radio and it carries both Bluetooth and Wi-Fi, so every advertisement is a moment when the Wi-Fi receiver cannot hear the fragments of the burst. NimBLE's default advertising interval for an undirected advertisement is 30-60 ms (the `BLE_GAP_ADV_FAST_INTERVAL1_MIN/MAX` constants) and each advertisement goes out on all three BLE channels - about a hundred radio transmissions a second. **Three changes, measured on the real boards with `firmware/tools/measure_burst.py`:** (1) *the Bluetooth stack now advertises only when it must*: not at all while a caregiver's phone is connected (nobody has to find a hub that is already connected, and the notifications travel over the connection) and not at all while a burst is in the air - the link stage tells it with `ble_alert_set_radio_busy()`, and the log shows advertising stopping 1 ms after the window is requested and returning 181 ms after the burst lands; (2) *when it does advertise, it advertises slowly*: 100 ms (`itvl_min`/`itvl_max` = 0x00A0) instead of NimBLE's 30-60 ms; (3) *the node paces the fragments every 4 ms instead of every 10 ms* - the ten-millisecond gap was written when the burst really did lose frames to the Bluetooth deafening, and once that was fixed the gap was the whole of the burst's length. **The measurements:** before, 5.54 s and 6.93 s with resend rounds; after the Bluetooth policy, 3.76 s and 3.81 s with **no missing fragments and no resends at all** (the same with a phone connected, because then the hub does not advertise either); after the node's pacing, **2.06 s, 2.06 s, 2.11 s**, 286/286 fragments every time. The request-to-verdict latency is now **2.23-3.57 s** (mean 2.68 s), of which 0.16 s is the model's own inference. The remaining floor is the node's radio: at 4 ms the transmit queue sometimes backs up and the burst stretches to 3.40 s, which the hub repairs with one resend round. **And a finding that needs the user: played from the *laptop's* speakers the cry is not detected** - the model answers P(cry) 0.38-0.95, just under the 0.95 threshold, and raising the laptop's volume to 100 % made it *worse* (P(cry) 0.38), while the node's RMS stayed at 0.045. So it is not the level: the laptop's speakers produce something the model does not read as a cry, and that is very likely the speakers' own frequency response (a small laptop speaker rolls off the low end, and a baby cry is low-end heavy). The demo's source is the *phone*, whose audio the model detects in 38 of 44 windows offline (D-60), and **the phone path on the live hub is verified in D-62**. | `firmware/hub_infer/components/ble_alert/ble_alert.c`, `firmware/hub_infer/components/ble_alert/include/ble_alert.h`, `firmware/hub_infer/src/link_stage.c`, `firmware/node/node_crynet/node_crynet.ino`, `firmware/tools/measure_burst.py` (new), `firmware/tools/measure_latency.py` (new) |
| **D-62** | **The demo's sound path is verified on the live boards: a cry played from a phone at the node's microphone is called a cry by the hub, and the whole chain runs in 2.2-5.4 s.** The user played the cry from a phone 10-15 cm from the INMP441 while the hub's log was read live (`firmware/tools/listen_hub.py`, new). **42 verdicts over a four-minute listen: 26 "ALERT - cry" at P(cry) 0.9922-0.9961, and 16 "no cry" at P(cry) 0.0078-0.2148.** The model's INT8 output falls into two clean clusters with **nothing anywhere near the 0.95 threshold**, so not one verdict was a coin toss. The link was perfect throughout: **45 bursts, 45/45 with all 286 fragments, and not one stall, timeout, CRC error or resend round.** The request-to-verdict latency was min 2.23 s, median 3.72 s, max 5.35 s (mean 4.03 s), of which 0.15 s is the front end and the inference together. **The burst's length is no longer the fixed 2.06 s of D-61 but a range - min 2.06 s, median 3.55 s, max 5.19 s** - the node paces the fragments at 4 ms, but the hub and the node share WiFi channel 6, and the per-fragment transmit cost is the *channel's* contention rather than the pacing: with the phone's WiFi on the same band the air is busier and each frame waits longer, so the burst stretches. That is the same channel-contention term that made the burst 5.5-6.9 s before D-61, now visible as a range instead of a constant. **The 16 "no cry" verdicts are the architecture showing itself rather than a classifier failure:** the node freezes the *loudest* two seconds it has heard since the last freeze and the hub judges that one window, so a window that contains the cry but is not the loudest is never offered to the model at all. *(Amended 2026-11-01, late: the first half of that sentence was wrong, and the firmware's own comment repeated the error - **the node does not freeze the loudest two seconds**, it freezes the two seconds *centred on the first crossing of the level*: the ring holds two seconds, the crossing arms a pending peak, and one second later the ring is copied as it stands, which is `[crossing - 1 s, crossing + 1 s]`. The comment in `link_stage.c` now says so. The reading of the sixteen no-cry verdicts does not change - a window that is not the loudest is still the only one that is judged - but the window that is judged is the one *around the crossing*, and for a cry that is only beginning, that window is the weakest two seconds of it rather than the strongest.)* The no-cry verdicts fall in blocks (sequences 6, 8, 9, 16, 17, 22) and the cry verdicts in blocks (7, 10-15, 18-20) - which is what a loudest-window rule does when the loudest thing in the room is not always the cry. The demo must use the phone (D-61's laptop-speaker finding stands), and the demo's own claim is the one that matters: **a cry at the cot is called a cry.** | `firmware/tools/listen_hub.py` (new), `research/live_phone_cry_2026-11-01.log` |

| **D-63** | **The trigger is adaptive, and the *node* owns the floor and the level: it tracks its own noise floor, freezes its window at three times that floor, and tells the hub the level in its telemetry. The hub triggers on the number the node reports.** | The reach of the system was set by a constant, not by the classifier: the cry a metre from the node has a median RMS of 0.0070 and not one of its 590 readings reached the fixed 0.030, so it was never offered to the model at all (D-60). **The multiple was chosen from the recorded sessions, not by taste** (`research/adaptive_trigger_study.py`, which simulates the exact rule over each session's 590 readings): at three times the floor the one-metre cry goes from 0 trigger events a minute to 39, the cry at 15 cm gives 35, the quiet room gives 5, and the loud sessions are capped by the old 0.030 - so the rule is never worse than before in a loud room. At four times the floor the one-metre cry drops to 20 and at five to 7, so three is where the reach is bought without the trigger running away. **Why the node owns it:** the node is the one that freezes the window, so the level that matters is the one it used; a hub-side trigger would be a second guess about the same audio. **The floor falls at once when the room gets quieter and rises with a 50 s time constant** (0.002 of the way per 100 ms reading), so a cry that lasts a minute cannot drag the floor up to its own level and switch the trigger off in the middle of the episode. **The floor is tracked as a minimum statistic**, which is the standard noise-floor estimator and the only one that keeps the one-metre cry reachable: in that session the floor sits near 0.003 while the cry sits at 0.007. **The level travels in the telemetry** (payload 7, milli-RMS) beside the frozen window's own level and the floor, and the hub falls back to `CRYNET_TRIGGER_RMS` for a node that reports none. The node also now arms its freeze on **two** consecutive readings at or above the level - the rule the hub already used and the one the study assumed - so a single drifting reading cannot freeze a window. **Measured live:** the level tracks the room (0.006-0.016 in a noisy room), the node's own log reads `rms 0.0063 floor 0.0028 level 0.0083`, and the hub asks 5-11 times a minute instead of 1-2. | `firmware/node/node_crynet/node_crynet.ino`, `firmware/hub_infer/components/crynet_proto/{include/crynet_proto.h,crynet_proto.c}`, `firmware/hub_infer/components/node_link/{include/node_link.h,node_link.c}`, `firmware/hub_infer/src/{link_stage.c,link_stage.h}`, `research/adaptive_trigger_study.py` |
| **D-64** | **A cry is announced when one window is unmistakable (P(cry) >= 0.99), or when two windows in a row say cry (>= 0.95). A window between 0.95 and 0.99 is a *maybe* and is not announced until the next window agrees.** | **The model is not a reliable judge of a near-silent window.** Measured on the real boards, the same quiet room produced verdicts of 0.0000 and of 0.9766 for windows that differ by nothing a person could hear, and the second of those was a false alarm; across the watches the marginal verdicts came out at 0.6172, 0.7188, 0.7852, 0.8398, 0.8672, 0.8906 and 0.9766. This is the cost of D-63: a lower trigger asks the model about windows that are very nearly silent, and near silence is where the model is unsure. **The rule uses two facts:** the model's INT8 output **saturates at 0.9961 for a clear cry** (D-58) - so a window at 0.99 or above has nothing left to be uncertain about and is announced at once, which keeps D-61's headline (the panel shows the cry about two and a half seconds after it happened) - and **a cry lasts for seconds, so its windows agree with each other**, while a noise fluctuation that happens to look like a cry is not repeated in the next window. The same window is judged more than once when the hub asks for it again, and it always gives the same answer, so it is counted once: the run counts distinct window sequences. **Measured after:** five minutes of a noisy room, 32 verdicts, **0 false alerts** - where before, one window in eight or so of the near-silent windows was a false alarm. | `firmware/hub_infer/src/link_stage.c`, `firmware/hub_infer/src/link_stage.h` |
| **D-65** | **The node's transmitter runs at 8.5 dBm instead of the default 20 dBm.** | The Wi-Fi antenna and the INMP441 are centimetres apart on the same board, and the radio's own transmission reaches the microphone. The evidence: the windows the node froze with the radio running carried roughly twice the energy of the same room's windows recorded with the radio off (`node_capture`, which has no radio at all, and the same I2S setup), and the extra energy had the shape the model reads as a cry - the false alarms of D-64's opening. With the power at 8.5 dBm - 11 dB less into the room - the marginal verdicts fell from 0.89 to 0.72 and the count of near-silent windows above 0.5 fell from 3 in 12 to 1 in 9. Eight and a half dBm is ample for a link of a couple of metres, which is what a cot node is, and **on a battery node it is also simply the right thing to be doing**: the radio is the dominant power draw. | `firmware/node/node_crynet/node_crynet.ino` |
| **D-66** | **The hub no longer asks for a frozen window whose sequence it has already received and judged.** | The first verification session (phone at 15 cm, then at 1 m) exposed a latency regression: the first alert at 15 cm took ~21 s instead of the ~2.5 s of D-62. **The cause:** the hub re-requested the *same* frozen window up to four times in a row (seq 100 was asked for four times), and each serve reset the node's 4 s hold timer (`g_frozen_served = true; g_frozen_hold_ms = millis() + FROZEN_HOLD_MS`), so the node could not freeze the new loud window until the hub stopped asking - the new cry sat unfrozen for ~15 s. **The re-request never helped anything:** re-judging the same window gives the same answer, and the run rule (D-64) counts distinct window sequences, which a repeat never advances - `st->cry_seq != st->request_seq` is false on a repeat. **The fix:** the hub records the seq of every window it actually receives and judges (`last_completed_seq`), set in the burst-complete branch, and the request condition now requires `st->seq != st->last_completed_seq`. The hub waits for the node to advertise a new seq. Side effect: the "resend refused: no frozen window for it" fragility (four times in the session) disappears, because the node is no longer asked to re-serve a window whose hold has expired while it has moved on. Expected first-alert latency at 15 cm: ~3 s after the cry starts (1 s peak delay + ~2 s burst). **Verified in the second session: the re-request loop is gone** (no seq was asked for twice), but the latency was still ~27 s - the node still froze a new window every ~4 s while the hub emptied one every ~4 s, so the queue never drained. See D-67. | `firmware/hub_infer/src/link_stage.c` |
| **D-67** | **The node freezes at most one window every eight seconds, not every four.** | D-66 removed the re-request loop but the second verification session still showed a **~27 s delay** to the first cry alert. The node was still freezing a new window every ~4 s (the hold was 4 s, and during a continuous cry the loud streak never drops, so the node freezes the moment the hold expires), while the hub processes one window every ~4 s. The two rates matched exactly and the queue never drained: the first cry window (seq 17, frozen at 87.7 s) waited behind seqs 13, 14, 15 and 16 and was not judged until 115.4 s. **The fix:** `FROZEN_HOLD_MS` goes from 4000 to 8000. The node now freezes at most one window every 8 s while the hub empties one every 4 s, so the hub stays ahead and the queue drains. Eight seconds still covers the hub's three resend rounds, which all land inside the first seven seconds. **Expected first-alert latency at 15 cm: ~5 s** (1 s peak delay + ~4 s burst) instead of 27 s. **Verified in the third session: the queue is still the bottleneck** (seq 27, frozen at 34.26 s, was not judged until 70.89 s) - see D-68. | `firmware/node/node_crynet/node_crynet.ino` |
| **D-68** | **A loud cry preempts the node's hold, and the hub does not wait for a streak to request it.** | D-67 reduced the freeze rate but the third verification session still showed a **~36 s delay**: the cry (peak rms 0.31 at 30-35 s) froze seq 27 at 34.26 s, but the hub did not judge it until 70.89 s because it was still processing seqs 19-26 (quiet windows frozen before and during the cry). **Two changes:** (1) the node, when a crossing at three times the trigger level happens while a previous window is still being served, abandons the hold and freezes the new (louder) window immediately - the hub's abandon branch then asks for the loud window instead of the stale one; (2) the hub's request condition treats a window as loud when the live RMS is at least three times the trigger level, even if the two-reading streak has not built up, saving ~5 s per window. **Combined expected first-alert latency at 15 cm: ~4 s.** Built and flashed; boot self-check passes; **verified in the sixth session: preemption did not help** because telemetry is lost during bursts - the hub did not learn that a loud window had been frozen until after the current burst completed, by which time the node had frozen several more. See D-69. | `firmware/node/node_crynet/node_crynet.ino`, `firmware/hub_infer/src/link_stage.c` |
| **D-69** | **Cry mode: the node freezes exactly one window per cry.** | D-68's preemption did not work because telemetry is lost during bursts: the hub does not learn about a new frozen window until after the current burst completes, by which time the node has frozen several more. **The fix:** once a loud window is frozen (win rms >= 5x the floor), the node enters cry mode and does not freeze again until the room goes quiet (rms < level for one reading). A sustained cry now freezes exactly one window, which the hub processes in ~5 s. The 1 m cry (rms ~0.007, 2.3x the floor) does not trigger cry mode, so it is detected normally when the queue is empty. Combined with D-68 (hub bypasses the streak for loud windows), the expected first-alert latency at 15 cm is ~5-8 s. **Built and flashed; not yet verified on the live boards.** | `firmware/node/node_crynet/node_crynet.ino` |
| **D-71** | **The frozen-window hold returns to 4 seconds, and the demo's phone must play quieter than the microphone can clip.** | The three-minute correlated session (phone cry ~20 cm from the mic) **detected the cry three times at P(cry)=0.9961** and vindicated the chain end to end: the mic heard RMS 0.26-0.53 (the panel's 0.265 was real - an earlier "live" listener had stopped before the user played and had been measuring silence), the node froze cry-level windows one per cry segment with the cry-mode marker, the link ran 286/286 with CRC MATCH, and there were zero false alarms before and after. **The hold's cost was measured directly: 6.5-7.0 s of hold-driven gap between every burst.** With cry mode capping freezes at one per cry segment, the hold no longer has the queue duty it was raised to 8 s for (D-67) - it is pure resend coverage, and 4 s covers the burst and the first resend round. `FROZEN_HOLD_MS` 8000 -> 4000. **The session's remaining detection problem is clipping:** the phone now plays so loud that the INMP441 pegs (peaks 32694-33100 of 32767), and clipped cries are a lottery for the model - only 3 of 13 loud windows scored >= 0.9961, where session 1's unclipped windows (peaks at 45-75 % of full scale) scored 0.9961 on every one. The demo fix is to play the phone quieter, targeting the panel's level reading of ~0.10-0.20 (session 1's range). | `firmware/node/node_crynet/node_crynet.ino` |
| **D-72** | **A near-silent window can neither announce nor confirm a cry - two rms gates close the quiet-room false alarms.** | The user saw **fourteen "cry detected" flashes in a quiet evening, none over 98 %**, with panel levels of 0.002-0.012 and no cry playing. The mechanism: in a quiet room the adaptive trigger pins at its minimum (TRIGGER_MIN 0.005), so the hub judges near-silent window after near-silent window; the model's verdict on those is documented noise (the same room has produced 0.0000 and 0.9766 for windows that differ by nothing audible); and the run rule assumed "a noise fluctuation is not repeated in the next window" - a quiet room repeats it constantly, so two consecutive scattered verdicts at 0.95-0.98 confirmed each other, each held 8 s by the cry hold. **Fix (hub only): `CRYNET_ANNOUNCE_MIN_RMS 0.006` - no window under 0.006 rms may announce at all, even at P(cry) >= 0.99** (it sits under the quietest genuine detection, the one-metre cry at win rms 0.0103, with margin); **`CRYNET_MAYBE_MIN_RMS 0.020` - a maybe (0.95-0.99) only counts toward the confirming run when its window carries real energy** (every measured false maybe sat at <= 0.012; every measured genuine cry announced saturated, and the unmistakable path stays open at >= 0.006 rms). A refused quiet maybe now logs `cry (too quiet to announce)`. **Verified live within 90 s of flashing:** the room produced exactly the failure shape - `window rms 0.003917  P(cry)=0.9531` - and the new gate refused it. | `firmware/hub_infer/src/link_stage.c`, `firmware/hub_infer/src/link_stage.h` |
| **D-73** | **A quiet window must have a cry's shape, not just its confidence - the crest gate.** | The session after D-72 caught four more quiet-room false alarms in nine minutes (rms 0.0067-0.0088, P(cry) 0.9922-0.9961, peaks 621-789): **the model saturates on pure INMP441 self-noise roughly every two minutes in tonight's very quiet room.** The 0.006 rms gate (D-72) sat under the flukes, and no confidence threshold can sit above saturation - P(cry)=0.9961 is the same value a real cry produces. The discriminator is physical: **crest factor (peak/rms)**. Room hiss is Gaussian - every quiet window the model has ever scored highly on that was not a cry has a crest of 2.2-2.9; the quietest genuine cry (the one-metre phone cry, P=0.9961 at 0.0103 rms) has a crest of 5.6, the 15 cm cries 6.6-6.9. **`CRYNET_QUIET_CREST 3.5`: a window under 0.020 rms announcing on saturation alone must also have crest >= 3.5**; loud windows announce on saturation alone (clipped cries can flatten the crest to 1.9-3.9, so the shape test would be wrong there). A loud bump has a high crest but the model refuses bumps on its own (measured 0.0977), so the gate only does work where the model is least trustworthy. The hub now prints `crest` on every window line. The four session flukes (crest 2.3-2.9) would all be refused. | `firmware/hub_infer/src/link_stage.c`, `firmware/hub_infer/src/link_stage.h` |
| **D-74** | **The run confirms only a window that itself carries energy - no announcing on the run's momentum.** | The volume-down verification session (play at rms 0.07-0.19, peaks 57-69 % of full scale - no clipping) detected the cry on every loud window (P=0.9922-0.9961, five ALERTs). But 12 s after the last cry window, a quiet hiss window (rms 0.0096, crest 2.5, P=0.9883) printed ALERT. Cause: the cry's own loud windows advanced the confirming run (they say cry and carry energy), reaching run=2; the quiet window then says cry (0.9883 >= 0.95) so it does not reset the run, and the run-of-two confirmed it. With tonight's flake factory (quiet hiss scoring >= 0.95 constantly) a post-cry run could be refreshed by hiss windows indefinitely. **Fix: `confirmed = unmistakable || (cry_run >= 2 && rms >= CRYNET_MAYBE_MIN_RMS)`** - a quiet window may keep the run alive (a real cry has quiet gaps and the next loud window should not start over) but may not announce; the announcement is refreshed only by windows with real sound behind them. | `firmware/hub_infer/src/link_stage.c` |

### 1.8 Toolchain and process

| # | Decision | Why |
|---|---|---|
| **D-45** | **PlatformIO 6.2.0 with `platform-espressif32` 8.0.0 and ESP-IDF 6.1.0**, installed by hand rather than pinned by URL. | PlatformIO 6.2 installs a URL-specified package by treating the archive as an **npm package**: it picks the wrong `package.json` out of the tree, writes a bogus version into `.piopm`, and leaves `packages/framework-espidf` holding only a test-fixture package (I-6). IDF 5.3.2 could not be installed through PlatformIO at all; 6.1.0 was already on disk and satisfies the port's `idf >= 5.1`. |
| **D-46** | **The vendored TFLite Micro port lives inside `firmware/hub_infer/components/`**, and `esp-nn` is wired as the port's own dependency with the registry copy removed. | PlatformIO re-compiles IDF components with SCons using the *source basename* for object names, and the TFLM port has twelve basename collisions, so the build died with "Multiple ways to build the same target". Moving the vendored components inside the project makes the paths relative and distinct. `firmware/tools/patch_deps.py` keeps the build offline and pinned. |
| **D-47** | **The flash mode is DIO throughout** — the effective config is `CONFIG_ESPTOOLPY_FLASHMODE "dio"` and both `bootloader.bin` and `firmware.bin` carry flash-mode byte `0x02`. | A combined image built with QIO makes the chip watchdog-reset in a loop (`rst:0x7 TG0WDT_SYS_RST` repeating, no application output). The ROM cannot read this board's flash in QIO before the bootloader has configured its own timing. DIO costs nothing at this workload. |
| **D-48** | **The node sketches are compiled with the Arduino IDE's own `arduino-cli` against core 3.3.12**, and the toolchain state is kept in the repo (`dependencies.lock`, `firmware/tools/fetch_deps.sh`, `patch_deps.py`). | The user's machine originally had no ESP-IDF, no PlatformIO, no Arduino IDE and no Xtensa compiler. Everything the build needs is now reproducible from the repo rather than from the state of one machine. |
| **D-49** | **Every host tool that reads a serial stream resynchronises on its own magic** and never waits for a fixed block; capture records carry a CRC-16 and the collector drops any record that fails it. | A USB CDC port can enumerate *after* the sketch has already printed its banner, and a single dropped byte on the USB link would otherwise shift every later sample and quietly ruin the dataset. Both stream parsers are testable classes, checked against synthetic streams. |
| **D-50** | **The notebook is generated from `research/build_notebook.py` and never hand-edited.** | The notebook is a build artefact. Editing it directly makes it impossible to regenerate and to diff. It is validated with `nbformat.validate()` after every regeneration. |

### 1.9 The two-cot system (this repository)

The decisions below are the ones where this repository deliberately differs
from the three-cot sibling repository `fp-2`. Everything above this line
(the model, the signal contract, the trigger rules, the radio link) is
shared.

| # | Decision | Why |
|---|---|---|
| **D-75** | **The two-cot system lives in its own repository** (`fp-two-node`, remote `https://github.com/Amazo123/CryNet-TwoNode.git`), sharing history with `fp-2` up to commit `99bb257` and then diverging. | The two systems are different products with different firmware, different wiring and different documentation, and the owner works on both. Sharing the history keeps the model and the signal contract traceable in one place without letting the two firmware trees drift into each other again - which is exactly what happened to the wearable sketch before the split (the `fp-2` copy was still blinking an LED while the bench was driving a motor). `fp-2` keeps its own remote (`crynet` → `https://github.com/Amazo123/CryNet.git`) and is untouched by this decision. |
| **D-76** | **The wearable has no status LEDs; its OLED dashboard carries the state** (LINK or SCAN), and the battery/SOC readout is marked as needing firmware that does not exist yet. | A newer revision of the wiring diagram gave the wearable a blue link LED on GPIO1 and a red SOC LED on GPIO4, which contradicted `fp-2`'s `SYSTEM_WIRING.md` §7 (then titled "SOC display and charge prompt") and its own committed PDF (page 4). Neither LED has firmware: wiring them produces two dark LEDs and a caregiver who reads a dark LED as a fault. The OLED is already on the wrist and already says what the LEDs would have said. |
| **D-77** | **The haptic is a real motor on a BC547 low-side switch** (GPIO7 → 2.2 kΩ → base, 100 kΩ base-emitter pulldown, 10 Ω in the motor's + lead, 1N5819 with the cathode up, collector → motor −, emitter → GND), **not the DRV2605L breakout that the planning documents still describe.** | The bench hardware is the BC547 circuit the owner drew, and the motor is now driven by the firmware itself (`HAPTIC_MS 2500`, `HAPTIC_PULSE_MS 250`) rather than by an LED stand-in. The DRV2605L description survives in `SYSTEM_WIRING.md` §2.3 and contradicts §5.3 in the same file; the firmware and the bench win, and the documents are what need correcting. |
| **D-78** | **The hub's TFT backlight stays on 3V3 and is permanently on; there is no sleep mode.** | The hub's firmware already treats GPIO4 as the backlight (`PIN_BL 4`, `ili9341_backlight_set` with LEDC PWM), so a 2N7002 on GPIO4 would make the panel dimmable and switchable. The owner chose against it: the panel's LED pin is tied to the panel's own 3.3 V net, the glass cannot be blanked while the board is powered, and the system is always plugged in or charging. The MOSFET was removed from the wiring diagram **before anything was soldered**, so nothing had to be unbuilt. GPIO4 is therefore free. |
| **D-79** | **The node's I2S zero watchdog is committed but not flashed; it goes onto a node after the soldering is finished.** | The watchdog exists because node 2 was once found reading rms 0.0000 on every mic read - the INMP441 delivering nothing - and the fault cleared on a hard reset with no reflash, so its cause was never established. A fault-injection test proved the code executes and refills a window; it did not prove recovery from the original physical fault, and it detects *exact* zeros only, so a mic that goes quiet-but-not-zero is still not covered. The owner is soldering now, and a node should not be reflashed mid-solder, so the watchdog waits until the hardware is settled and can then be flashed and played-cry tested on the bench. |
| **D-80** | **The multi-cot wearable behaviour is held on its own branch** (`feature/wearable-multi-cot`), not on `main`. | Two cots crying at the same time has never been tested, so the multi-detection alert face, the haptic when a second cot joins, and the suppressed CLEARED stay parked until that test can be run. The single-cot path is unchanged in behaviour, so the firmware the owner has running today is unaffected by the branch's existence. |
| **D-81** | **SUPERSEDED IN PART BY D-83: the divider half of this decision was withdrawn before it was ever fitted. The cell half stands.** ~~**The battery sense is a fixed 220 kΩ / 100 kΩ divider (ratio ×3.2) — there is no variable resistor in the battery path — and SOC is read from a voltage curve, not a linear map.**~~ **The cell is an 18650 for the nodes and the hub and a 1000 mAh Li-Po pouch for the wearable, and LiFePO4 cells are excluded from the whole system.** | The owner was advised to put a *variable resistor* between the cell and the ADC pin, read the maximum (4.2 V) as 100 % and the minimum (3.0 V) as 0 %. That is wrong in three ways. **(1) A two-terminal pot — a rheostat between the cell and the pin — cannot divide at all.** The ADC pin's only path to ground is its own high-impedance input, so turning the pot down barely moves the voltage: the pin still sits near the cell's 4.2 V, past the C3 IO's 3.6 V absolute maximum. Dividing needs a second leg to ground, and that is what the fixed pair provides. **(2) A three-terminal pot used as a genuine divider — one end to B+, one end to B−, the wiper to the ADC — does work, and the firmware does *not* have to read the wiper**: the ratio can be measured once at assembly and handed to the firmware as a constant. *An earlier version of this decision said the chip 'would not know the division ratio'. That was overstated and is corrected here.* What the pot costs instead is **(a) per-unit calibration** — the ratio is a build-time measurement, not a datasheet value, so every unit needs a meter reading and its own constant; **(b) drift** — the wiper is a mechanical setting that moves with temperature, vibration, wear and the knocks a cot gives the node, and the failure is **silent**, because the reading keeps looking plausible while the ratio underneath it has moved; and **(c) magnitude** — `BAT_CURVE` moves 100 mV = 20 percentage points around 3.8 V, so **1 % of ratio error is already about 10 points of SOC error**. A pot's tolerance-plus-drift is 1–5 % and unrepeatable from unit to unit; the fixed 1 % pair is ±1 % on the ratio, known at the design stage, on every unit, with no per-unit assembly step. `analogReadMilliVolts()` already applies the chip's factory-calibrated ADC reference, so the residual error is a few per cent — which the existing banding absorbs. **(3) The 3.0–4.2 V linear map is chemically wrong:** a lithium cell is roughly 4.20 V = 100 %, 3.85 ≈ 55 %, 3.70 ≈ 25 %, 3.60 ≈ 10 %, 3.40 ≈ 0 %, so a linear map would call 3.70 V "58 %" when the cell is really about a quarter full — and it errs optimistic across exactly the range the cell spends most of its life. `hub_display.c` already holds this as a table (`BAT_CURVE`) and prints it as `BAT ~80 %` with a tilde. The bottom is anchored at ~3.3 V rather than 3.0 V, because 3.0 V is roughly where a protected cell's protection circuit cuts out — that is end-of-life, not "empty". On the **cell format**, the two units have opposite requirements: a node sits on a cot frame within a baby's reach, so it gets an 18650 in a holder — more energy per unit volume, and a steel can that cannot be punctured — while the wearable goes on a wrist, where an 18650's 18 × 65 mm and 48 g are impossible and a flat pouch cell is the only sensible form. The pouch is 1000 mAh rather than the original 500 mAh, and the module's ~1 A charger must be reduced to ~400–500 mA for it, since 1 A into 1000 mAh is 1 C. **LiFePO4 is excluded everywhere** because the module charges to 4.2 V and an LFP cell tops out at 3.65 V — it would be destroyed. If a true SOC percentage is ever wanted instead of an estimate, the part for it is a **MAX17048** fuel gauge on I²C (the hub and wearable have a spare bus; the node's microphone occupies I²S, so nodes keep the divider). **One measured-and-recorded caveat on the divider itself (O-1e):** the pair's source impedance is **68.75 kΩ** (220 kΩ ∥ 100 kΩ), which is above the ~10 kΩ an ESP32 ADC likes; the **100 nF on the sense node is what makes that workable and is required, not optional** — the ADC takes its charge from the capacitor rather than from the divider. |
| **D-82** | **The 5 V→3.3 V linear regulator stage in the power chain is recorded as the largest lever on battery runtime, but is not changed now.** | The chain is **cell → boost to 5.1 V → the board's 5 V pin → the board's onboard linear regulator → 3.3 V**. A linear regulator passes *current*, not power, so the cell ends up supplying roughly **1.8× the 3.3 V load current** while the difference is burned as heat; on a 100 mA load that is about 160 mA from the cell, which projects to roughly six hours for the wearable on a 1000 mAh pouch and rather less than a day for a node on a 3000 mAh 18650. *These are projections from the regulator's behaviour, not measurements — no runtime has been measured on this system.* Feeding the board's **3V3 pin** from a 3.3 V buck-boost would bring the cell current close to the load current and roughly double the runtime. That is a change to the power architecture, and the owner is mid-solder on the design as drawn, so it is deferred to a bench evaluation rather than applied to the wiring now. The other lever is the wearable's OLED (~25 mA), which is always on. |
| **D-83** | **The battery SOC feature and every status LED are removed from the system: no battery-sense divider, no cell-voltage telemetry, no battery text on the hub's panel, no link LED on the node, and no BLE-status or SOC LED on the hub.** The battery *power* is untouched — the cells, the LX-LCBST modules, the switches and the charge currents are exactly as D-81 settled them. | The owner asked for it directly: the hub's panel already shows which cots are answering, so a second copy of that answer on the cot itself is redundant, and the battery figure was always an estimate — a resting-voltage curve printed with a tilde — that the caregiver was not going to act on. **The removal is total rather than partial on purpose:** a divider that is still on the bill of materials but never read is a part that gets bought, soldered and trusted, and a LED that is wired but never driven is a dark LED that reads as a fault. **What is given up: nothing in the system will warn the caregiver that a cell is nearly flat.** The cells must be watched by eye and charged before a unit goes back on a cot. **What is kept:** the heartbeat and its ACK, because that is how a node knows the hub is there — only the LED that displayed the answer is gone, and the node prints the same fact on its serial console (`status`) while the hub shows it on the panel. **The wire format changes with it:** the telemetry's battery tier is removed and the radio counters move down two bytes, from offset 18 to 16. The hub still reads the old 34-byte layout, so a node that has not been reflashed yet does not turn the counters into noise while the units are being reflashed one at a time. The freed pins — GPIO3, GPIO7 and GPIO10 on the node, GPIO1, GPIO2 and GPIO17 on the hub — are free and need no boot-strapping verification. |

---

## 2. The issues, in the order they were found

Each entry: what it looked like → how it was diagnosed → what was done → the result.

### 2.1 Model and data

| # | Issue | Diagnosis | Measure | Result |
|---|---|---|---|---|
| **I-1** | **The INT8-vs-float32 parity cell reported `NaN` for both AUCs.** | The cell took a *prefix* of the validation fold. The ICD manifest lists every positive clip before every negative one, so the fold's positive clips alone contribute 5,330 windows — more than the 4,000-window cap — so that slice was 100 % cry and its AUC was undefined. | The notebook cell now draws a seeded random permutation subset and **warns loudly if a slice is single-class**. The gap was closed independently on the host by `research/verify_int8_parity.py`. | The model was never affected — every headline metric is computed over whole splits — but the quantisation delta had never actually been measured. Now: ΔAUC **−0.001373**, decision agreement **99.956 %**, and the independently computed float AUC (0.999299) corroborates the Kaggle figure (0.999419) from a different set of windows. |
| **I-2** | **Contaminated corpora were nearly used for training.** | Every corpus was profiled at the audio level, which is what exposed them. | Rejected at the source with the reason recorded in D-8. | The `mennaahmed23/baby-cry*` family was never trained on. Its "silence" sits at RMS 0.22 — louder than a real cry — and would have taught the model that loud means safe. |
| **I-29** | **The deployed model raises a false alarm on 8.19 % of loud music clips — a class it had never seen.** The user's requirement is that the system tells a cry from background noise, speech and music. Speech and noise are handled (1.6 % each); **music was not handled at all**, and the cause was structural, not a tuning slip: **no corpus in the training mix contained any music**, and ESC-50 — the corpus used for the false-alarm map — has none either, so neither the training nor the measurement ever touched it. | Two measurements. First `research/eval_esc50.py` over ESC-50's 2,000 real clips through the deployed INT8 model: 36 of the 40 real `crying_baby` clips alarm (90 %) and 38 of the 1,439 loud non-cry clips do (2.64 %) — urban 4.3 %, animal 3.7 %, domestic 1.6 %, human non-speech 1.6 %, nature 0.8 %. Then the corpus was checked for what it does *not* contain, which is what exposed the gap. | GTZAN was downloaded and `research/eval_music.py` ran the same deployed model over its 1,000 real music clips: **79 of the 965 clips that reach the model alarm — 8.19 %**, three times the rate for any other kind of sound. Worst genres: jazz 14.3 %, blues 13.0 %, pop 12.0 %, disco 10.0 %, rock 10.0 %; best: reggae 2.0 %, classical 2.9 %, country 3.0 %, metal 4.0 %. The mechanism is obvious in hindsight: a cry is a voiced, harmonic-rich sound, and a saxophone, a trumpet or a sung vowel in the log-Mel domain looks very much like one. GTZAN was added to the training corpus (D-51), the notebook was regenerated and validated locally on the stub cache, and the Kaggle re-run is the user's to start. | **Not fixed yet — the deployed model still false-alarms on music, and the fix is a training round, not a code change.** The deployed threshold cannot rescue it either: the model's INT8 output saturates at P(cry) = 0.9961, so 45 of the 81 music alarms and 34 of the 36 true cry detections sit at exactly the same value, and raising the threshold from 0.95 to 0.99 would remove 27 music alarms at the price of two real cry detections. A "two consecutive windows" confirmation was considered and deferred: music is continuous, so it would not help against music, and it would cost the demo a short single cry clip. |

### 2.2 Stage 2a — the hub's inference core

| # | Issue | Diagnosis | Measure | Result |
|---|---|---|---|---|
| **I-3** | **The DC-removal mean was accumulated in float32.** | Summing 32,000 samples of 18,000 in float32 gives 575,726,660 instead of 576,000,000, so the mean came out 8.5 counts low and 8.5 counts of DC survived. The per-window standardisation then blows that residual up into a completely different feature vector — the DC-offset probe failed with a max delta of 131. | The sum is now an exact `int32`. | Probe 2 passes; the on-device feature vectors match the host exactly. |
| **I-4** | **The build was at `-Og`, not optimised.** | `build_flags = -DCOMPILER_OPTIMIZATION_PERF` is an *Arduino* macro that means nothing to PlatformIO's ESP-IDF builder, so ESP-IDF's debug default applied. | Set the optimisation the ESP-IDF way: `CONFIG_COMPILER_OPTIMIZATION_PERF=y`. | Part of the front-end speed-up below. |
| **I-5** | **The CPU ran at 160 MHz, not 240.** | Read from the platform summary on the device. | `CONFIG_ESP_DEFAULT_CPU_FREQ_MHZ_240=y`. | The board now reports 240 MHz. |
| **I-6** | **The front end kept a 128 KB padded copy of the signal in PSRAM.** | PSRAM on the S3 is uncached external memory, and the FFT and the Mel filterbank stream through the working set 81 times per window. | The padded copy is gone: each frame is built straight from the caller's int16 PCM. The working set is now **5,380 bytes in internal SRAM**. | Front end **135 ms → 41.7 ms**. |
| **I-7** | **A combined image built with QIO flash mode made the chip watchdog-reset in a loop.** | `rst:0x7 TG0WDT_SYS_RST` repeating with no application output; the ROM cannot read this board's flash in QIO before the bootloader has configured its own timing. | The combined image must use **DIO**. The whole build is DIO — the effective config is `CONFIG_ESPTOOLPY_FLASHMODE "dio"` and both images carry flash-mode byte `0x02`. | The board boots and runs. DIO costs nothing at this workload. |
| **I-8** | **The FlatBuffer alignment, the arena fit, the feature agreement and the latency were all unverified.** | Only a build proves nothing about the chip. | The same four probes the host parity test uses are run **on the target MCU**, and the device reports its own arena usage and timings. | **RESULT: PASS — 4 probes.** Arena 262,144 B reserved / 108,328 B used; front end **41.7 ms**; inference **101.8 ms** (ESP-NN SIMD kernels linked in: `esp_nn_conv_s8_esp32s3`, `esp_nn_conv_s8_1x1`, `esp_nn_conv_s8_3x3_opt`). |

### 2.3 Stage 2b — the node firmware

| # | Issue | Diagnosis | Measure | Result |
|---|---|---|---|---|
| **I-9** | **The INMP441's data line read exactly 0.00 in steady state.** The captured window was flat at 0–1 count with 533 single-sample spikes. | A new bring-up sketch (`node_diag`) read both I2S slots and scanned every exposed GPIO. The SCK scan read 0.00 on **every** pin, which is the clearest statement of the fault: with the clock on the wrong pin the microphone is never clocked, and with the clock on the right pin its data line still stayed flat. A repeat measurement of the identical configuration read 0.00/0.00 where the first read 3961/2320 — the apparent "signal" was the peripheral's **start-up transient**. | The fault was in the **wiring**, not the firmware: the INMP441 only drives SD when it is powered, clocked and given a valid word-select. The user rewired the board. | `verify_burst.py` then reports **PASS, 286/286 fragments, 0 bad CRC, exactly 64,000 bytes**, written out as a 2.00 s WAV: 1,943 distinct values, RMS 349 counts (0.011 of full scale), peak ±1,150 — a quiet room, no clipping. |
| **I-10** | **The two sketches disagreed about the I2S format** (one `MONO`+`SLOT_LEFT`, the other `STEREO`+`SLOT_LEFT`). | The diagnostic settles it: **STEREO with both slots, taking every other word**. MONO halves the I2S frame to 32 bits, which breaks the INMP441's framing — the same microphone read the same way gives −3500 counts of DC with the full frame and −620 with the halved one. Asking for stereo also makes the Arduino library force the both-slots mask whatever mask is passed, so the mask argument never does what it appears to do. | Both sketches now do the same thing. | The INMP441 puts 24 bits into a 64-bit frame, so the I2S setup uses **32-bit slots**; the narrowing to int16 is done in software by keeping the top 16 bits. The ESP32-C3 is I2S hardware v2, so the left-channel slot is selected in hardware, with no software decimation. |
| **I-11** | **A closed serial port starved the node's loop — the root cause of the week.** The mic appeared dead; the "INMP441 power-on transient" seen in hub captures was stale ring-buffer data. | ESP32 Arduino's USB-CDC (HWCDC) write path waits `tx_timeout_ms` (default 100) × up to 20 consecutive timeouts = **~2 s per print** when no host reads the port, and `usb_serial_jtag_is_connected()` stays true whenever the cable is plugged in, so `if (Serial)` gates did *not* help. The node printed its RMS every 100 ms, so an unattended node crawled to ~3 loops/s: the mic starved, telemetry fell to 0.35 Hz, and the window never filled. | **`Serial.setTxTimeoutMs(0)`** in `setup()` — prints drop instead of block. | Telemetry hit 10 Hz within one flash. (The earlier sessions only worked because the Arduino IDE serial monitor held the port open.) |
| **I-12** | **The INMP441's power-on transient** — the first 100 ms record read 0.656 of full scale, decaying 656 → 79 → 41 → 22 → 12 milli over ~500 ms. | It is the microphone's power-on burst, and it mattered twice: clips are cut from t=0, so `clip_0000` of every session contained it, and on the deployed node it would freeze a garbage window the moment it crossed the event level and hand the hub a spurious upload after every boot. | Both sketches read and discard 500 ms (8,000 stereo frames) right after the I2S starts. | A fresh capture session reads **7 milli on its very first record** — room level from sample 0, versus 656 before. `node_crynet` boots with a first RMS of 0.047 and never crosses EVENT. |
| **I-13** | **The node's window mean averaged the stale tail with the fresh head.** | After a burst the live window is dropped and refills; until it is full the newest samples are not at the start of the array, so a mean summed from index 0 was meaningless for exactly as long as the window was invalid. | The valid region is now walked **backwards from the write cursor**; the cursor is no longer reset, and a request arriving while the window is incomplete is refused rather than answered with a window whose order is unknown. | Both sketches recompiled clean. |
| **I-14** | **The Arduino IDE build failed with `cc1plus.exe: out of memory allocating 4194296 bytes`.** | The machine's **page file is disabled**, so the commit limit was 16,190 MB against 15,109 MB committed. | `AutomaticManagedPagefile` was set to `True` (the Windows default), which takes effect at the next boot; meanwhile the sketches are built and flashed with `arduino-cli` outside the IDE. | Both sketches build with **zero warnings**: `node_crynet` 979,375 B (74 %) flash / 166,308 B (50 %) RAM; `node_capture` 311,120 B / 18,592 B. |

### 2.4 Stage 2c — the radio, the panel and Bluetooth

| # | Issue | Diagnosis | Measure | Result |
|---|---|---|---|---|
| **I-15** | **`handle_telemetry` memset a new node's slot to zero, wiping the 64 KB window pointer `node_link_create` had pre-allocated.** | Every fragment was rejected on `window == NULL` and **not one burst ever reassembled**. The stats line decoded it: 702 raw, 702 parsed OK, 560 bad — parse passed, `handle_fragment` rejected; the only silent reject was the window pointer. | Save and restore the pointer across the memset; a slot with no window buffer now logs an error instead of being dropped silently. | Bursts reassemble. |
| **I-16** | **The hub's 2-second probe had become a 50 ms flood**, and the node wiped its whole live window after serving a one-fragment probe. | The heartbeat edit had deleted `last_probe_us = probe_now`. | Restore the timestamp; the node only wipes the live window after a real burst. | The probe flood is gone. |
| **I-17** | **`esp_now_add_peer` ran from the node's WiFi-task callback.** | The hub's own `node_link.c` documents this exact trap (see D-38). | Peer-add moved into `loop()`. | The hub receives every frame the node sends. |
| **I-18** | **Unicast to the learned hub address wedged the ESP-NOW send path.** | `esp_now_send` returned OK, frames never left, the send callback never fired, every send burned its wait cap and the loop starved. | **Rolled back to broadcast** at 10 Hz, which is reliable now that the loop runs in real time. | Broadcast works. This also disproved the "the hub radio sleeps" theory, so the 100 ms heartbeat was removed. |
| **I-19** | **The node on the board was running stale firmware.** | The "freeze before you announce" change had been written to `node_crynet.ino` but never reflashed, so the node had no auto-freeze at all: `g_peak_pending` appears 0 times in the last committed node build and 7 times in the current source. | Rebuilt and reflashed. | The chain runs for the first time end to end. |
| **I-20** | **The node's freeze was cancelled in the same tick that created it.** | `if (g_frozen_valid && (now - g_frozen_ms) > FROZEN_EXPIRE_MS)` used a `now` captured *before* `freeze_window()` ran, and `g_frozen_ms` is stamped *inside* it — so the subtraction underflowed to ~4 billion and the window expired the instant it was frozen. The symptom was unmistakable: the frozen sequence advanced (1, 2, 3, 4, 5 …) while the flags stayed `0x06` and the CRC stayed `0x00000000`, so the node never once advertised a burst as ready. | Measure the age from a fresh `millis()`. | The telemetry advertises `flags 0x07` and the window's CRC. |
| **I-21** | **The hub was still in promiscuous Wi-Fi mode** — a leftover diagnostic. | It hands the host every frame on the channel; with the laptop's own Wi-Fi on channel 1 that flooded the receive path. | Promiscuous mode off by default (D-34); `ESP_WIFI_STATIC_RX_BUFFER_NUM` 16 → 32 and `DYNAMIC` 32 → 64; 3 ms of pacing between the node's fragments. | The fragments are lost between the two radios, not in either end's code — the node's own numbers were healthy: 7,667 frames sent, **0 lost**, 2.3 ms average send wait, and the hub's parse was clean (0 bad frames, 0 bad payloads). |
| **I-22** | **Bluetooth and the ESP-NOW radio did not coexist.** With BLE up, `esp_wifi_init` failed (`esf_buf_setup_static: alloc eb fail(1)`) and the radio never started; in a later build NimBLE **asserted** on `Failed to allocate memory for ble_store_config_vars` and reset the chip in a loop. | The first fix attempt (radio before BLE) moved the failure to the other side, which is what showed the problem was not ordering. The real cause was in the ELF: **154 KB of the hub's static RAM was boot-only buffers that never got handed back**. | Move them to PSRAM (borrowed and returned) and free the probes' CRC buffer after each use (D-39). | RAM **59.9 % → 12.9 %**. The whole stack fits: free internal heap 215,155 B with the radio up, 149,271 B with Bluetooth up. Verified live: the panel comes up, the radio hears the node, the BLE server advertises, and a real client connects and subscribes while the radio keeps running — frames counted 21 → 308 with **0 bad, 0 bad payloads, 0 failed requests**, no resets. |
| **I-23** | **Three IDF 6 facts the build had to be taught.** | (1) The SPI and GPIO drivers live in `esp_driver_spi` / `esp_driver_gpio`, not `driver`. (2) A stale CMake configure ignores a `REQUIRES` change until the build directory's CMake state is deleted. (3) `font5x7.h`'s rows need their own braces or `-Werror=missing-braces` stops the build. | All three fixed. | The panel driver builds and runs. |
| **I-31** | **The panel's picture was a quarter turn out.** The first photograph showed the whole screen rotated 90°: the title ran down the side of the glass instead of across it. | The panel is a **"landscape-first" ILI9341** — a variant whose glass is 320x240 in the controller's *portrait* mode. The legacy firmware drove exactly this panel with **Adafruit's rotation 2 (`MADCTL_MY | BGR`) and a 320x240 logical framebuffer**; its `HubDisplay` class exists for no other reason than to override Adafruit's 240 px clipping. My driver used rotation 1 (`MADCTL_MV`), which is the *normal* chip's landscape setting and transposes the image on this glass. The proof was in the legacy source, not in theory. | The driver now uses the legacy's setting, and it logs what it chose (`rotation 2 (madctl 0x88)`) so the next photograph settles it in one look. | *The general lesson, and it is the same lesson as the pin assignments: **a panel's orientation is a fact about the hardware, not about the chip.** When two systems disagree about a physical device, the one that was photographed working wins.* |
| **I-32** | **The Kaggle run died with `TypeError: ufunc 'invert' not supported for the input types` — and the real fault was that the music corpus was empty.** The crash was in `X_gtzan[~gtzan_hold]`: `split_by_clip` returned `np.array([])` for an empty corpus, which numpy types as **float64**, and `~` (bitwise invert) has no float implementation. The empty corpus was the real problem, and the numpy error hid it. | GTZAN ships as Sun/NeXT **`.au`** (1,000 files, `genres/<genre>/<genre>.00000.au`), and the notebook's reader filtered the archive by extension and decoded with libsndfile. **The notebook had been validated on a synthetic stub whose file names and format were different from the real archive**, which is exactly why the gap survived; the local run against the real archive produces 2,000 windows with 0 unreadable, so the *logic* is right and Kaggle's environment is what failed. | Three changes: (1) `split_by_clip` always returns a **bool** array and an empty corpus can no longer crash a split; (2) the corpus reader is **no longer filtered by extension** — anything inside a genre folder is offered to the decoder, and the genre is read from the folder above the file, with a fallback for a flat archive; (3) **`decode()` can now read a `.au` without libsndfile** (the format is simple: magic, offset, size, encoding, rate, channels — and the standard library's `sunau` is gone in Python 3.13), so a build of libsndfile without AU support cannot silently empty the corpus. On top of that, `build_corpus` now **counts why items were dropped** (`no_member`, `unreadable`) and the notebook **refuses to go on to train if GTZAN is empty**, printing the archive's size, member count and first three names. | *A training round that quietly loses the music corpus produces a model that false-alarms on music while looking like it was fixed. Failing loudly is worth more here than finishing.* The user's next Kaggle run will either work, or print exactly which of the three possible failures it was. |
| **I-30** | **The TFT panel showed static noise — and the driver reported "the panel is up" the whole time.** The user wired the panel and plugged both boards in; the chain ran end to end on real audio (nine windows at P(cry) = 0.9961, one at 0.9883, CRC-32 MATCH on every burst, and P(cry) = 0.0000 on the quiet room and on a loud non-cry sound), but the panel was a field of coloured noise. **Three bugs, all in my own driver, all of which the driver was structurally unable to detect.** | **(1) The address window was little-endian.** `CASET` and `PASET` take four bytes big-endian; the code cast a `uint16_t` to `uint8_t *`, so 319 (0x013F) went out as 0x3F 0x01 and the panel read column 16129. **(2) `CASET` was sent twice.** The window is one command for the columns and one for the rows; sending the column start and then the column *end* as a second `CASET` re-sets the start instead of the end, collapsing the window to one pixel. **(3) CS was released between a command and its parameters.** The ILI9341 resets its serial interface when CS goes high, so every parameter byte was arriving as a *command* — the panel was never initialised at all, and what the user was looking at was uninitialised display memory. | The driver now **drives D/C in the SPI pre-transmission callback** (the only moment the level can safely change), sends **a command and its parameters as one transfer** with `SPI_TRANS_CS_KEEP_ACTIVE` on an acquired bus, and builds the address window big-endian, one command per axis. The text renderer was rewritten to draw **horizontal runs** instead of single pixels — about sixty times less SPI traffic, which is what makes a redraw cheap enough to run every second. A **blue 12×12 marker in the panel's top-right corner** settles the orientation from one photograph. | **Fixed and reflashed** (`research/toolchain/pio_build_display.log`, RAM 12.9 %, flash 61.9 %). The lesson is recorded rather than the fix: **a display driver that cannot fail is a display driver that lies** — the ILI9341's ID register can be read, but MISO is not wired, so it cannot be, and the driver's "up" message was only ever reporting that the SPI transactions returned without error. |
| **I-33** | **The panel showed hearts and diamonds where the letters should have been.** Every glyph was 32 characters out of place, so the new dashboard was unreadable — and the host-side preview of the same screen (`research/out/ui_dashboard.png`) showed the same nonsense, which is how the fault was visible before the hardware ever was. | `Adafruit_GFX::drawChar` reads the classic font as `font[c * 5 + i]` — **the raw ASCII code**, with no `- 0x20`. The generator assumed the old layout and wrote `off = (code - FIRST) * 5`, so ASCII 0x20 took the table's first entry, ASCII 0x41 took the entry for 0x21, and every character drew the glyph of the character 32 codes earlier: 'A' drew '@', and a space drew the heart at index 0x01. **The font file was never corrupt** — the local `glcdfont.c`, the upstream copy and the cached copy are byte-identical, which is what finally killed the "the library's font is damaged" theory. | The generator now **detects** the table's base from the position of the classic '!' and refuses to write the header unless the layout is what it expects (D-51). The renderer reads bit 0 as the top row, the way Adafruit's own `drawChar` does (`for (j = 0; j < 8; j++, line >>= 1) if (line & 1)`); the host-side preview had the opposite convention and was drawing every glyph upside down, which would have hidden the fix behind a second bug. The preview now mirrors the firmware's layout page for page, so the two cannot drift. | The glyphs render as letters — checked by decoding the generated header back to ASCII art ('A', '0', 'g', '!', 'R' all read correctly) — and the dashboard reads `CRYNET`, `LISTENING`, `COT 1`, `ONLINE`, `NO SIGNAL`. |
| **I-34** | **The display source was saved in Windows-1252, and a later edit double-encoded it.** | The em-dashes in the comments were single 0x97 bytes, so a UTF-8 read of the file failed outright, and the next edit turned them into `â€”` — mojibake in the source of the file the user was reading. | The file is now valid UTF-8 (seven em-dashes, no mojibake), decoded byte by byte so that no character is guessed at, and **no non-ASCII byte remains inside a string literal** — the panel can only draw ASCII in any case. | The source compiles and the comments read as written. |
| **I-35** | **Every colour on the panel arrived with red and blue exchanged — the teal theme was showing as olive and salmon.** The dashboard's teal accent came out olive, the amber "no phone attached" pill came out **blue**, and the user read the whole thing as a different, garish theme ("the colour scheme also thrash"). The picture was right — layout, text and orientation were all correct — so the fault was in the colour path alone, and the driver reported the panel as "up" throughout. | The photo was measured rather than guessed at. The screen was located in the photograph, the picture mapped onto it with a bilinear transform, and the *saturated* pixels sampled — text and the 6×6 pill squares, which the palette pins down exactly: `CRYNET` (teal 45,212,191) measured `(210,210,179)` olive; `LISTENING` measured `(212,218,184)` olive; the `RADIO` square (green 52,211,153) measured `(174,180,146)` olive; the `PHONE` square (amber 251,191,36) measured `(5,175,247)` **blue**. Every hue is present and correct *except* that red and blue are in the wrong places. The cause is the `MADCTL_BGR` bit in the driver's rotation setting: the panel was told that the top bits of each RGB565 word are blue, while `DISPLAY_RGB` puts red there. | The `BGR` bit is cleared from every rotation setting, so the panel is told the order the framebuffer actually uses (D-53), and `INVOFF` is sent explicitly so the inversion state is pinned rather than inherited. The driver logs the control byte it actually wrote (`madctl 0x80`), so the next photograph can be checked against the log rather than against a belief. | Built (RAM 12.9 %, flash 62.0 %) and flashed: the panel comes up at 320×240 rotation 2 and the log now reads **`madctl 0x80`** — the `BGR` bit is gone — with the radio healthy (110 frames off the air, 0 bad, 0 bad payload). **One more photograph is needed to confirm the colours on the glass.** |
| **I-36** | **The panel claimed more cots were linked than were answering.** The footer read '3 cots linked' while `COT 2` and `COT 3` both read NO SIGNAL - visible in the user's photograph. | The footer's count came from `st->node_count`, the number of cot *slots* the hub holds, so every card drawn was counted as a cot linked, whether or not that cot had been heard from recently. | The footer now counts the cots whose cards read ONLINE, and says 'no cots linked' when none are answering; the host-side preview was changed the same way so it cannot drift back (D-54). | The footer agrees with the cards above it: '1 cot linked' beside one ONLINE cot and two NO SIGNAL cards. |
| **I-37** | **The Kaggle download cell failed with `FileNotFoundError: '/kaggle/working/out'`.** The user ran the training notebook, it finished, and the cell that was supposed to hand over the artifacts stopped on the first line that touched the disk. | The cell assumed a fixed path, but the notebook's own output directory is `OUT = Path(os.environ.get("CRYNET_OUT", "./out")).resolve()` - **relative to whatever the working directory was when that cell ran**. The session that ran the notebook and the session that looked for the result were not the same one, so the directory was not where the cell expected it. The same failure mode is invisible to a notebook that is run end to end in one go, which is why the local validation never caught it. | The cell now **asks the notebook first** - the variable `OUT` survives in the kernel if the export cell ran in that session - and otherwise **searches `/kaggle/working`, the working directory, the home directory and `/tmp` for the artifacts by name**, wherever they are. If it finds nothing it prints what *is* under `/kaggle/working`, so the next attempt starts from facts instead of another guess. It still writes `/kaggle/working/crynet_out.zip` and offers it with `FileLink`, keeping the `out/` folder at the top of the archive. | The artifacts are still outstanding: until the zip is unpacked, the deployed model false-alarms on 8.19 % of loud music (I-29), and the retrained model cannot be compared with the one on the board. |
| **I-38** | **A photograph of the panel cannot measure its colours - the same colour reads (9,51,210) in one place and (51,120,235) in another.** The swatch page made the problem measurable for the first time: the navy swatch and the page background are *the same colour*, 80 screen pixels apart, and they came back 147 blue levels apart. | The phone is doing it, not the panel: in a dark room the camera opens up for a glowing screen, the highlights clip (the `RADIO` square in the dashboard photograph measured (144,255,255) - fully blown out) and the white balance drifts with whatever it sees. Measured along one horizontal strip of the swatch page, **one single colour** reads (40,116,238) at the left and (25,75,204) at the right: a spread of 40 levels per channel for a colour that does not change. Any conclusion drawn from a difference smaller than that is noise. | The colour-check page is the way out: it says what the panel was *asked* to draw, so a photograph can be compared with it rather than believed. The page has grown a **dark ramp** - six steps of one hue from black up - so the panel's own tone curve is read off in one row. And the one photograph that would settle it is the one to take **with the room lit**, where the camera does not open up for the screen. |
| **I-39** | **Every rounded corner on the panel drew its arc on the *inside* of the shape - only the bottom-right corner looked right.** The user saw it before any tool did: 'the corners are off, only the bottom right corners are okay, the other are sort of flipped'. | The corner loop walked its offsets only inward from each disc's centre: for a top-left corner centred at `(x+r, y+r)` it drew the quadrant to the right and *below* the centre - the quadrant that lies inside the rectangle. The fill version painted over pixels the straight bands had already filled (harmless, invisible), and the outline version floated a stray quarter-arc inside each corner while the real corner was left square-cut. The bottom-right corner only looked correct because its inward quadrant happens to end exactly at the shape's own edge. | Each disc is now walked **towards its own corner** (a per-corner sign pair `sx`/`sy`, offsets `0..r`), so the quarter-disc covers the corner quadrant and the outline's ring hugs the corner arc. A host-side regression check (`research/check_corners.py`) requires the four corners to be exact mirror images of each other and the fill's arc to hug a circle within 1 px, for every radius the UI uses - the old loop fails it, the new one passes. |
| **I-40** | **A flash aimed at the wrong serial port parked the cot node in its download mode, and the radio went silent (0 frames for two minutes).** | Two boards were attached: the hub on COM32 (the CH343 bridge) and the node on COM30 (the C3's own USB) - exactly what the ports table in SYSTEM_UPDATE.md section 0.1 says. The hub's upload was attempted with auto-detect and then with COM30 named explicitly; both times esptool connected to the **node**, put it into download mode, and then stopped on a chip mismatch - leaving the node sitting in the bootloader instead of running its firmware. The hub then probed an empty room: `0 frames off the air`. The display change under test touches nothing in the radio path, which is what made 'the radio is suddenly dead' diagnosable as an environment fault rather than a code fault. | `esptool --chip esp32c3 --port COM30 run` told the node to leave the bootloader; the next hub log reads `410 frames off the air, 410 parsed, 0 bad, 0 bad payload` with the node answering at rms 0.004-0.014. The rule going forward: **read the ports table before flashing**, and a failed esptool session leaves its target in the bootloader - `esptool run` brings it back. |
| **I-41** | **With the new weights in, the build stopped on a static assert - and after that was fixed, the first boot failed its on-device feature check (`max delta 87, 0/5184 exact -> FAIL`).** | Both are the drift guards working as designed. `crynet_dsp.c` static-asserts the firmware's pinned input calibration against the generated tables, and the retrain recalibrated the input (`IN_SCALE` 0.0601 → 0.1163, `IN_ZP` −4 → −70), so the stale mirrored macros in `crynet_model.h` stopped the build instead of letting a wrong-quantised model ship. With the macros updated, the boot probes then compared the device's quantised features against `crynet_probe_refs.h` - reference vectors **baked from the old quantisation**. The float front end is identical, but every int8 feature moved with the scale (worst delta 87, zero exact). | `firmware/tools/gen_probe_refs.py` re-runs the notebook's front end over the four closed-form probes and rewrites the reference header; after it, the self-check reads **5184/5184 exact on every probe, RESULT: PASS**. The rule: a new model means four files change together - `model_data.h`, `crynet_tables.h`, the macros in `crynet_model.h`, and the probe references - and `check_artifact_drift.py` verifies the first three against `deploy_config.json`. | 

### 2.5 The airtime problem — the last and hardest issue

This is the one that kept the burst from ever completing, and it is worth recording in full because the reasoning was wrong twice before it was right.

| # | Issue | Diagnosis | Measure | Result |
|---|---|---|---|---|
| **I-24** | **The burst never completed: 267–274 of 286 fragments arrived, then the burst timed out.** | Three hypotheses were tested in turn and two were wrong. *(a) The Wi-Fi channel* — both sides were moved to channel 6 and the node was heard. *(b) The node's own counters* — 7,667 frames sent, **0 lost**, 2.3 ms average send wait, so the node was not dropping anything. *(c) **The hub's own Bluetooth advertising*** — the decisive test: the hub was built **without BLE** and produced **286/286 fragments in 3.75 s, four complete bursts in a row**. With BLE on, the same build lost ~6 % of every burst. | BLE advertises on channels 37/38/39, and the hub's single radio must *retune* to reach them — during which the Wi-Fi receiver is deaf. Three BLE events per advertisement at ~30 ms intervals ≈ 9 % deafness, independent of the Wi-Fi channel and the frame rate. That fits every observation, including why it was independent of the channel. | The root cause was confirmed. It is not a bug in either end's code; it is the physical reality of one radio carrying two protocols. |
| **I-25** | **The burst had no way to recover the frames it lost.** | The hub could see *that* fragments were missing but had no way to ask for them, and the node had no way to send them again. | Implement the `RESEND` frame (D-26): a 36-byte bitmap of the missing fragments in a 54-byte request; the node re-sends exactly those from the same frozen window with the same sequence number. | **The burst completed 286/286 with BLE on**, CRC-32 MATCH, and the first end-to-end cry alert. |
| **I-26** | **A resend request could be lost entirely.** | ESP-NOW broadcast is never acknowledged. The resend goes out at exactly the moment the burst has just gone quiet — the moment the radio has been busiest. One lost request means the round is wasted and the burst times out with the fragments still missing. | The request is sent **three times** (D-28). | A lost request no longer costs a round. |
| **I-27** | **The node re-sent the same fragments two or three times.** | The hub's three request copies each set the node's single pending flag, so the node served the whole request again. With 128 fragments missing that meant 256 or 384 fragments of air instead of 128, and the burst took 9.6 s instead of 5. | The node answers a repeat of the request it is already serving only once, within an 800 ms window (D-28). | One serving per round; the burst settles in about 5–7 s. |
| **I-28** | **The node refused the resend: "no frozen window for it."** | The node froze the next window about three seconds after the upload, and the hub's request for the missing fragments often arrived just after that — by which time the old snapshot had been replaced. | The node **holds** an uploaded window for four seconds (D-29), and the hub **abandons** a burst the node can no longer complete and asks for the newer window at once (D-30). | The resend is served, and a hopeless burst is recovered in about three seconds instead of fifteen. |

**The live test that closed it** — hub + node + a real BLE client connected, with the cry recording played through the PC's speakers:

```
W (37022) link: node 1: the burst stalled with 268 of 286 fragments; asking for the 18 that are missing
W (38562) link: node 1: the burst stalled with 285 of 286 fragments; asking for the 1 that are missing
I (39830) link: node 1: 286/286 fragments in 6.58 s
I (39830) link: node 1: window crc32 0x336F318E, the node advertised 0x336F318E -> MATCH
...
I (60681) link: node 1: window crc32 0x6230F1C4, the node advertised 0x6230F1C4 -> MATCH
I (60842) link: node 1: ALERT — cry
```

and on the phone:

```
ALERT {'cot': 1, 'alert': 'cry', 'confidence_pct': 100, 'event_id': 1}
STATE {'cots': 1, 'crying_mask': 1, 'confidence_pct': 100, 'started_at_s': 0}
ALERT {'cot': 1, 'alert': 'cleared', 'confidence_pct': 100, 'event_id': 2}
```

---

## 3. Results so far

| Claim | Number | How it was measured |
|---|---|---|
| ICD validation AUC | **0.9994** | full Kaggle run, fold 4 |
| ICD test AUC | **0.9995** | full Kaggle run, fold 5 |
| Cross-corpus AUC (never trained on) | **0.9973** | cry4 + ESC-50 + snoring |
| Deployed model | **137,384 bytes** INT8 | SHA-256 `4aef55d8…126bc11` |
| C front end vs Python | max **6.9 × 10⁻⁵** | 4 probes, real run |
| INT8 vs float32 | ΔAUC **−0.00137**, agreement **99.956 %** | 11,386 windows, host |
| On-chip front end | **41.7 ms** per 2 s window | ESP32-S3, 240 MHz, −O2 |
| On-chip inference | **101.8 ms** per window | ESP-NN SIMD kernels |
| Hub RAM | **12.9 %** (42,236 B) | after the PSRAM move |
| Hub flash | 61.9 % | 1,297,303 B of 2 MB |
| Hub internal heap with radio + Bluetooth | **149,271 B** free | at boot |
| Node flash / RAM | 979,375 B (74 %) / 166,308 B (50 %) | `weact_studio_esp32c3` |
| Radio link | **0 bad frames, 0 bad payloads** over thousands of frames | hub's own counters |
| Burst completion | **286/286 with CRC-32 MATCH** | live test, BLE client connected |
| End-to-end alert | **`ALERT {'cot': 1, 'alert': 'cry', 'confidence_pct': 100}`** | delivered to a real BLE client |
| Real baby cries detected | **36 of 40** ESC-50 `crying_baby` clips alarm | deployed INT8 model, `research/eval_esc50.py` |
| False alarms, loud non-cry sounds | **2.64 %** (38 of 1,439) | ESC-50, environmental + human non-speech |
| False alarms, **loud music** | **8.19 %** (79 of 965) | GTZAN, ten genres — `research/eval_music.py` |
| False alarms, quiet room | **0 in 236 windows** | this room's INMP441, `research/eval_indomain.py` |
| **Live chain, phone-played cry** | **P(cry) = 0.9961** on nine windows and 0.9883 on a tenth, every burst **286/286 with CRC-32 MATCH** | hub + node + a real BLE client, `research/hub_live.log` |
| **Live chain, quiet room and a loud non-cry sound** | **P(cry) = 0.0000** on every window, no alert raised | same session — the trigger fired (RMS 0.035-0.085) and the model rejected it |

---

## 4. Open items

| # | Item | Why it is still open |
|---|---|---|
| **O-1** | ~~**The wearable (Stage 2d)** does not exist yet.~~ **RESOLVED (O-1a):** the wearable exists, is flashed and is on the bench. | It is a BLE notification client with an SSD1306 OLED and a DRV2605L haptic driver. The hub's side of the contract (the legacy UUIDs and the six-byte alert packet) is done and verified against a real client, so the wearable can be written directly against it. |
| **O-1a** | **The wearable exists and is on the bench** — OLED on 3V3 / SDA GPIO5 / SCL GPIO6, and a BC547 low-side switch driving a real haptic motor on GPIO7 (D-77). **What remains: the battery itself.** The battery/SOC readout that used to be listed here is **cancelled** — there is no divider and no SOC text on the OLED (D-83). | The wearable was flashed and proved end to end on 2026-11-06: three alert cycles in a row came through complete (`ALERT cot 1 type 1 conf 100%` on the wrist, the haptic fired, `clear` came back as `type 2`), and it recovered from a hub reset mid-link (`hub lost — rescanning` → found again → subscribed to alerts *and* state). The OLED shows the link state and the alerts, and nothing about the cell. The cell choice is settled (D-81: a 1000 mAh pouch, with the charger's current reduced to ~400–500 mA); what is left on this unit is the battery and its power path, not an indicator. |
| **O-1d** | **No battery runtime has ever been measured on this system**, and the charge current, the boost converter's quiescent drain and the switch-off drain of the LX-LCBST module are all still unmeasured. | The battery-powered versions of every unit are still proposals. The runtime projections in D-82 come from the linear regulator's behaviour, not from a bench measurement, and the module's own current draw is unquantified — a module that draws a milliamp in standby would dominate a wearable's budget. Until one board is built and measured, the numbers in the documents are estimates and are labelled as such. The bench procedure is in `SYSTEM_WIRING.md` §6: build **one** power assembly, measure charge current, set the trimpot to 5.1 V, confirm switch-off behaviour and off-state drain, then run the working node firmware from it and compare against the USB baseline. |
| **O-1e** | **CLOSED BY D-83 — the divider was withdrawn before it was fitted, so there is no source impedance to measure and no 100 nF to keep.** The item was opened because the pair's source impedance is 68.75 kΩ (220 kΩ ∥ 100 kΩ), above the ~10 kΩ an ESP32 ADC likes, and the 100 nF on the sense node was what made the reading accurate — load-bearing, not a nicety. The fallback had been worked out (a 22 kΩ / 10 kΩ pair keeps the ×3.2 ratio exactly and drops the source impedance to 6.9 kΩ, for about 118 µA more drain), and it was left as a bench decision because the owner was mid-solder. **None of it is needed now.** | The whole feature is gone: no divider, no 100 nF, no ADC read, no telemetry field, no panel text. The firmware no longer has a battery reading to be noisy or compressed (D-83), and the BOM carries no divider parts. **Nothing was ever measured** — no cell was ever read through this divider, so the open question this item carried has simply ceased to exist rather than been answered. The reasoning behind the divider is kept in D-81 for the record, and the fallback pair is recorded there too in case the feature is ever revived; if it is, the honest part is a MAX17048 fuel gauge rather than a divider. |
| **O-1b** | **The multi-cot behaviour has never been tested with two cots crying at the same time.** | The wearable change that shows every active detection, buzzes when a second cot joins and suppresses CLEARED while another cot is still crying is held on branch `feature/wearable-multi-cot` (D-80) until that test can be run. The single-cot path is unchanged, so the deployed system is unaffected. |
| **O-1c** | **The node's I2S watchdog is committed but not flashed** — it goes onto a node once the soldering is finished (D-79). | The owner is soldering the final wiring, and a node should not be reflashed mid-solder. The fault-injection test proved the code executes and refills a window, but not that it recovers the original physical fault, and it detects *exact* zeros only. After it is flashed it needs a played-cry end-to-end run to confirm the node still streams and the hub still hears it. |
| **O-2** | **The model has never heard a real cry.** | The only cry source available in this room is a *recording played through a phone speaker* — compressed, band-limited and EQ'd by the speaker. It is labelled as such. On that audio the model's AUC is 0.9283 with recall 0.724 and FPR 0.000; the misses are two-second windows landing in the gaps between cries. The negatives (this room, this microphone) are authentic. ~50 self-recorded real clips remain the single biggest accuracy win. |
| **O-3** | **The screen has been seen three times; one photograph is still worth taking, and it has to be taken with the room lit.** | The first photograph confirmed the layout, the text and the orientation (I-31, I-35); the second confirmed the R/B fix; the third was of the colour-check page, and it confirmed every hue (D-56); the fourth was of the ramp, taken in the dark again, and it could not measure the steps - the red channel even jumps the wrong way between adjacent steps - which confirms I-38. But it did its job as a *chooser*: the user picked the third ramp step off it as the teal the screen should be (D-57). What is still wanted is one photograph **with the room lit**, so the ramp yields the panel's own tone curve instead of a colour choice. |
| **O-4** | **The tensor arena is still in PSRAM.** | Moving it into internal SRAM is the obvious next optimisation. At 101.8 ms of inference per two-second window it is not urgent for a triggered monitor. |
| **O-5** | **The in-domain audio is speaker-played, not real.** | A real cry in this room, recorded with `node_capture`, is the honest test of whether the system works in the real room — and the dataset the model should be fine-tuned on. |
| **O-6** | **The distance curve (how far the phone can be) is still open.** | The phase cues did not line up in the earlier attempt, so the far-side measurement has to be repeated. |
| **O-7** | **The resend mechanism has not been exercised under a genuinely hostile channel.** | It is verified against the hub's own Bluetooth advertising, which is the real interference in this design, but not against a busy Wi-Fi environment with a second router on the same channel. |
| **O-8** | **The deployed model false-alarms on 8.19 % of loud music, and the fix is a training round that has not been run yet.** | GTZAN is now in the training corpus and the notebook is patched, regenerated and validated locally (D-51, I-29), but the re-run happens on the user's Kaggle account. **RESOLVED 2026-11-01 (D-58):** the re-run happened and the retrained model is deployed and verified on the board; music false alarms are 2/965 = 0.21 %. The remaining cost is the phone-speaker per-window recall (D-58), and the honest in-room number is still O-9's to produce. |
| **O-9** | **The confusion session — the in-room measurement of speech, music, television and the phone-played cry — has not been recorded.** **RESOLVED 2026-11-01 (D-60):** it has been recorded — nine one-minute takes on the real INMP441, and the honest in-room number is **0 false alarms in 308 windows of non-cry audio** (speech, music and film, including a loud film and loud music where the trigger fired on 46 % and 84 % of the records) and **86.4 % per-window recall on the phone-played cry at 15 cm**. The one thing the session also found is that the cry at one metre never reaches the model's trigger at all, so the system's reach is limited by `CRYNET_TRIGGER_RMS` and `CRYNET_TRIGGER_RMS` and the microphone's fixed sensitivity rather than by the classifier. | `research/CONFUSION_SESSION.md` has the exact commands; the measured table and the caveats are in `research/in_domain/SESSION_REPORT.md`, the per-session numbers in `research/out/eval_session*.json`. |

---

## 5. How to reproduce the results

```bash
# 1. the model, in the cloud
#    open notebooks/crynet_training.ipynb and run it on a Kaggle GPU
#    (regenerate it with: cd research && python build_notebook.py)

# 2. the host-side checks
cd research
python make_stub.py && bash run_stub.sh        # synthetic smoke test
bash run_real_fast.sh                          # real corpus, subsampled, CPU
pip install ziglang && python test_c_parity.py # C <-> Python parity
python verify_int8_parity.py                   # INT8 <-> float32 parity
python eval_indomain.py                        # the model on this room's audio

# 3. the firmware
cd firmware/hub_infer && python -m platformio run       # ~1 min incremental
python firmware/tools/flash_hub.py --port COM32         # flash and read the log
bash firmware/tools/fetch_deps.sh                        # re-fetch the pinned deps

# 4. the node (Arduino IDE, board WeAct Studio ESP32C3, USB CDC on boot)
arduino-cli compile --fqbn esp32:esp32:weact_studio_esp32c3 firmware/node/node_crynet
python firmware/tools/verify_burst.py --port COM30       # the node's window, as a WAV
python firmware/tools/collect_clips.py --port COM30 --out research/in_domain/session1

# 5. the live end-to-end test
python firmware/tools/flash_hub.py --port COM32 --log-only --seconds 150
python firmware/tools/ble_alert_test.py --listen --seconds 140   # the phone
```

Every run's log is under `research/toolchain/` and every run's conclusion is
in `SYSTEM_UPDATE.md`'s change log.
