Amazo123/CryNet-TwoNode/research/out/two_node_display_mock.png

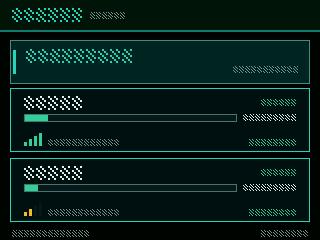
research/out/two_node_display_mock.png
