Amazo123/CryNet-TwoNode/firmware/node/node_crynet/node_crynet.ino

/*
 * CryNet cot node — ESP32-C3 SuperMini + INMP441 I2S microphone.
 *
 * Stage 2b.  The node is deliberately a dumb sensor.  It captures 16 kHz
 * mono PCM, keeps the last two seconds in RAM, reports a 100 ms RMS over
 * ESP-NOW, and uploads the two-second window as CRC-framed fragments when
 * the hub asks for it.  It never classifies anything: the model lives on
 * the hub, and the front end on the hub consumes the exact same PCM bytes
 * this node sends (the frozen signal contract).
 *
 * Wiring — INMP441 to ESP32-C3 SuperMini:
 *     VCC -> 3V3        GND -> GND        L/R -> GND   (left channel)
 *     SCK -> GPIO4      WS  -> GPIO5      SD  -> GPIO6
 *
 * The INMP441 drives a standard I2S frame of two 32-bit slots, so the
 * peripheral is configured for 32-bit slots and the samples are converted
 * to int16 in software by keeping the top 16 bits of the 24-bit word.
 * That is the only place the mic's 24 bits are narrowed; everything after
 * this point is int16, exactly like the hub's input.
 *
 * Serial console — 115200 baud, one command per line:
 *     status   print the node state
 *     stats    print the counters
 *     freeze   freeze the live window now (and make it the upload target)
 *     burst    dump the frozen window as fragment frames, in the same
 *              framing the radio uses, so a PC can check it end to end
 *     id <n>   set the node id (1..255)
 *     help     list the commands
 *
 * Frames.  One framing is used on the radio and on the serial console:
 *
 *     0  0xC3            magic
 *     1  0x7E            magic
 *     2  type            1 = telemetry, 2 = burst fragment
 *     3  node id
 *     4  u16 burst seq   (telemetry: the sequence of the pending burst)
 *     6  u16 frag index  (telemetry: 0)
 *     8  u16 frag count  (telemetry: 0)
 *    10  u16 payload len
 *    12  u16 payload CRC-16/CCITT-FALSE
 *    14  payload
 *    ..  u16 frame CRC-16/CCITT-FALSE over everything above
 *
 * Requests from the hub are 12 bytes:
 *
 *     0  0xC3  1 0x7E  2 type=3  3 node id
 *     4  u16 burst seq   6 u16 first fragment   8 u16 fragment count
 *    10  u16 CRC-16/CCITT-FALSE
 *
 * The telemetry payload has three tiers, told apart by length.  The
 * first twelve bytes are the original ones: u32 rms x 1000, u16 window
 * ms, u8 flags, u8 reserved, u32 CRC-32 of the frozen window (0 when
 * there is none).  The hub recomputes that CRC over the window it
 * reassembles from the radio, so the two agreeing proves the audio
 * crossed the link intact.  Four more bytes follow on every node
 * flashed since the adaptive trigger: u16 event level x 1000, u16
 * frozen window level x 1000, u8 noise floor x 1000, then the same CRC
 * at the end.  The newest tier appends the node's own radio counters.
 *
 * There used to be a third tier between them, carrying the node's
 * battery cell voltage.  It is gone (D-83): the cots do not measure
 * their cells any more, so there is nothing to send, and the tier
 * would only have carried zeroes.  The counters move down to fill the
 * gap, which is why the hub reads them by length too.
 *
 * The hub reads by length, so every tier decodes on every hub.
 */

#include <Arduino.h>
#include <WiFi.h>
#include <esp_timer.h>
#include <esp_now.h>
#include <esp_wifi.h>
#include <esp_mac.h>
#include <ESP_I2S.h>
#include <Preferences.h>
#include <freertos/FreeRTOS.h>
#include <freertos/task.h>

/* ------------------------------------------------------------------ pins -- */

static const uint8_t PIN_SCK = 4;   /* INMP441 SCK -> I2S BCLK */
static const uint8_t PIN_WS  = 5;   /* INMP441 WS            */
static const uint8_t PIN_DIN = 6;   /* INMP441 SD  -> I2S in  */

/* There is no status LED on this board (D-83).  There used to be a
 * connection LED on GPIO10, driven from the hub's heartbeat, and it
 * is gone: the hub's panel already says which cots are answering, and
 * a second, slower copy of that answer on the cot itself was saying
 * the same thing in a place nobody was looking.  GPIO10 is free.
 */

/* --------------------------------------------------------------- contract -- */

static const uint32_t SAMPLE_RATE    = 16000;
static const uint32_t WINDOW_SAMPLES = 32000;              /* 2.000 s */
static const uint32_t BURST_BYTES    = WINDOW_SAMPLES * 2;  /* 64000  */
static const uint32_t TELEMETRY_MS   = 100;
static const uint32_t RMS_SAMPLES    = SAMPLE_RATE / 10;    /* 100 ms  */

/* A fragment frame is 16 bytes of header plus the payload plus 2 bytes of
 * CRC.  ESP-NOW carries at most 255 bytes in one frame, so 224 bytes of
 * payload leaves comfortable headroom. */
static const uint16_t FRAG_PAYLOAD = 224;
static const uint16_t FRAG_COUNT   = (BURST_BYTES + FRAG_PAYLOAD - 1) / FRAG_PAYLOAD;

/* The level at which the node freezes its two-second window, and the level
 * the hub is asked to trigger at.  It used to be a fixed 0.030 — the same
 * number as the hub's trigger — and the consequence was that a cry played
 * a metre from the node (median RMS 0.0070, not one of its 590 readings
 * over 0.030) was never offered to the model at all.  The system's reach
 * was set by a constant, not by the classifier.
 *
 * So the level is now relative to the node's own noise floor: three times
 * it.  The floor falls at once when the room gets quieter and rises very
 * slowly (FLOOR_RISE below), so a cry that lasts a minute cannot drag the
 * floor up to the cry's own level and switch the trigger off half way
 * through the episode.  The multiple and the clamps were chosen from the
 * recorded sessions by research/adaptive_trigger_study.py: at three times
 * the floor the cry a metre away crosses the level and the quiet room
 * does not.
 *
 * The upper clamp is the fixed level this replaces, so the rule is never
 * worse than it was in a loud room.  The lower clamp keeps the level
 * above the microphone's own noise, where a trigger would mean nothing. */
static const float TRIGGER_MULT = 3.0f;
static const float TRIGGER_MIN = 0.005f;
static const float TRIGGER_MAX = 0.030f;

/* How much of the way towards a louder reading the floor moves each time.
 * There are ten readings a second, so 0.002 is a fifty-second time
 * constant: long enough that a cry does not raise the floor, short enough
 * that the room's own noise is followed within a minute. */
static const float FLOOR_RISE = 0.002f;

/* The ESP-NOW channel.  The hub uses the same one. */
static const uint8_t LINK_CHANNEL = 6;

/* How many cots this hub watches.  The hub ignores every other node
 * number, so a node must be 1 or 2 to be heard at all. */
static const uint8_t CRYNET_COT_COUNT = 2;

/* The frame types on the radio.  These mirror crynet_proto.h on the hub;
 * both sides were written from the same table. */
#define LINK_TYPE_TELEMETRY 1
#define LINK_TYPE_FRAGMENT  2
#define LINK_TYPE_REQUEST   3
#define LINK_TYPE_HEARTBEAT 4
#define LINK_TYPE_RESEND    5

/* The bitmap in a resend request: one bit per fragment. */
#define RESEND_BITMAP_BYTES ((FRAG_COUNT + 7) / 8)

/* How long after the loudest moment the window is frozen.
 *
 * The ring holds two seconds, so whatever is frozen is always the two
 * seconds that ended at the moment of the freeze.  This constant
 * therefore decides *which* two seconds the hub classifies:
 *
 *   PEAK_DELAY_MS = 0    ->  the two seconds BEFORE the peak
 *   PEAK_DELAY_MS = 500  ->  the peak in the middle of the window
 *   PEAK_DELAY_MS = 2000 ->  the two seconds AFTER the peak
 *
 * It used to be 500, so the window was the peak in the middle of it and
 * the second half of the cry was in it.  That was defended by the
 * belief that "the model was trained on two-second windows in which the
 * cry is wherever it fell, so a cry that sits a little later in the
 * window is judged the same".  On 2026-11-04 that belief was measured,
 * on every clip of the in-domain sessions, with the deployed INT8 model
 * (research/screen_clips.py):  it is false for a cry that has only just
 * started.  P(cry) against the amount of continuous cry inside the
 * two-second window:
 *
 *     0.50 s -> 0.004 .. 0.36      1.25 s -> 0.10 .. 0.95
 *     1.00 s -> 0.02  .. 0.23      1.50 s -> 0.21 .. 0.99
 *                                1.75 s -> 0.77 .. 0.9961
 *                                2.00 s -> 0.9961
 *
 * The model needs roughly 1.5 to 1.75 seconds of continuous cry inside
 * the window; half a window of cry is refused however loud it is.  A
 * 500 ms delay freezes the peak in the middle of the window, so a cry
 * that starts at the peak puts only about half a second of cry in it
 * -- and the window is refused.  That is a structural cause of the
 * misses, and of the misses that looked like "the node is not
 * detecting" on 2026-11-03.
 *
 * So the window is now the two seconds AFTER the peak: for a cry that
 * lasts longer than two seconds -- which is every real cry and every
 * demo clip in research/out/demo_kit/ -- the whole window is cry, and
 * the model scores it 0.9961.  The price is honest and stated: the
 * freeze now happens two seconds after the peak instead of half a
 * second after it, so the detection is about 1.5 s later.
 *
 * That price was measured against the whole corpus on 2026-11-04
 * (research/simulate_freeze.py simulates the node's own records, the
 * freeze and the hub's gates over every in-domain session):
 *
 *     rule                room windows   false alarms   cry episodes caught
 *     peak in the middle        104            0                  52
 *     two seconds after         69            0                  41
 *     stop-capped (below)      100            0                  52
 *
 * The two seconds after the peak lose the short cries: a yelp that ends
 * before the delay has passed would be frozen over the room, not over
 * the cry.  So the window is now frozen when the cry STOPS -- the
 * streak breaks -- and the two seconds after the peak are only the cap
 * for a cry that goes on.  A short yelp is caught whole; a sustained
 * cry still gets the two seconds that follow its peak.
 *
 * PEAK_STOP_DELAY_MS is the shortest wait before a stopped cry is
 * frozen: the window has to hold the cry itself, so the freeze cannot
 * happen on the first dip below the level.
 *
 * PEAK_EXPIRE_MS has to outlast the delay: the peak must still be
 * alive when the window is frozen, or the freeze never happens at all.
 */
static const uint32_t PEAK_DELAY_MS = 2000;
static const uint32_t PEAK_STOP_DELAY_MS = 500;
static const uint32_t PEAK_EXPIRE_MS = 4000;

/* How long the node holds a frozen window after it has been uploaded.
 *
 * The upload is not the end of the conversation about that window: the
 * hub asks for the fragments it missed, and only the node can send them
 * again.  The node used to freeze the next window as soon as its live
 * window refilled, which is about three seconds after the upload -- and
 * the hub's first request for the missing fragments often arrived just
 * after that, when the node had already thrown the old window away.
 * The node refused those requests ("no frozen window for it"), the hub
 * ran out of rounds, and the burst timed out.
 *
 * So the snapshot is held for four seconds after the upload.  Four
 * seconds covers the burst itself and the first resend round.  It was
 * raised to eight seconds for the queue problem (D-67), but cry mode
 * (D-69) has since capped the freezes at one per cry segment, so the
 * hold no longer has queue duty -- it is pure resend coverage now, and
 * the extra four seconds was only adding wait between windows: the
 * three-minute session of 2026-11-01 (late) measured 6.5-7.0 s of
 * hold-driven gap between every burst.  (D-71.)  It was cut from four
 * seconds to three when the burst stopped taking three and a half
 * seconds to cross the air: the resend round the hold has to cover now
 * starts about a second and a half after the upload, not four. */
static const uint32_t FROZEN_HOLD_MS = 3000;

/* How long a window the hub is still fetching may not be taken away by
 * a louder moment.
 *
 * The hold above is three seconds and the preempt rule -- a new window
 * that is three times louder than the frozen one takes its place -- was
 * allowed to cancel it at any moment.  In a noisy room that is exactly
 * what happens: the room is loud enough that each new reading is three
 * times the last window's level, so the node froze a new window every
 * second or two, and every freeze threw away the fragments the hub was
 * still missing.  The hub could never finish a burst at such a cot: it
 * asked for the pieces that were missing, the node had already thrown
 * them away, and the burst died with a third of it on the floor.
 *
 * So a window that is being fetched is now protected.  The protection
 * is refreshed every time the node sends a fragment, so it lasts while
 * the burst is crossing the air -- which is the whole of a slow cot's
 * transfer -- and it ends TRANSFER_HOLD_MS after the last fragment the
 * node sent.  That is a little longer than the gap between the hub's
 * resend rounds, so the window survives the wait for the next round,
 * and it is about as long as the hold that was there before, so a cot
 * is not left unable to freeze a new window any longer than it was. */
static const uint32_t TRANSFER_HOLD_MS = 4000;

/* How long a frozen window may sit unserved before it is dropped.
 *
 * It has to outlast the whole conversation about one window: the burst
 * itself takes nearly four seconds to send, and the hub may then ask
 * for the fragments that did not arrive.  Five seconds was not enough
 * for that -- the window expired while the hub was still waiting for
 * the pieces it had asked for. */
static const uint32_t FROZEN_EXPIRE_MS = 20000;

/* ------------------------------------------------------------- battery -- */

/* There is no battery sense on this board any more (D-83).  There used
 * to be one: a 220 kohm resistor from B+ to GPIO3 and a 100 kohm
 * resistor, with a 100 nF across it, from GPIO3 to B- (SYSTEM_WIRING.md
 * 3.3), read as ADC1_CH3 and reported to the hub, which put a battery
 * band on the panel.
 *
 * The whole feature is gone -- the divider, the reading, the trust
 * gate around it, the telemetry field and the panel's battery text.
 * The reason is not that the reading was wrong: it was a voltage
 * estimate printed with a tilde, and it was honest about that.  The
 * reason is that the owner does not want it, and the hub's panel
 * already shows what the caregiver needs to know.  Nothing about the
 * battery *power* has changed: the cell, the module and the switch
 * are still what they were.
 *
 * GPIO3 is ADC1_CH3 and is now free.  Nothing drives it, and nothing
 * reads it. */

/* ----------------------------------------------------------------- state -- */

static I2SClass  g_i2s;
static int32_t   g_raw[512];            /* I2S staging, 32-bit slots      */
static int16_t   g_window[WINDOW_SAMPLES]; /* live, circular, chronological */
static int16_t   g_frozen[WINDOW_SAMPLES]; /* snapshot offered for upload */
static uint32_t  g_write = 0;           /* next write index into g_window */
static uint32_t  g_filled = 0;          /* valid samples, up to 32000     */
static uint32_t  g_frozen_fill = 0;     /* valid samples in g_frozen      */

static bool      g_frozen_valid = false;
/* The frozen window has already been uploaded once.  It stays on the
 * node afterwards -- the hub may ask for the fragments it missed -- but
 * it must not stop the node freezing the *next* window, which is what
 * g_frozen_valid used to guard on its own. */
static bool      g_frozen_served = false;
static uint32_t  g_frozen_hold_ms = 0;   /* when the hold on it ends */
/* When the hub last asked this node for the window it froze.  A window
 * that is being fetched is not taken away by a louder moment until
 * TRANSFER_HOLD_MS has passed without a word from the hub. */
static uint32_t  g_transfer_ms = 0;
static bool      g_peak_pending = false;   /* a loud moment is waiting to
                                            * be frozen, one second late */
static bool      g_cry_mode = false;       /* a loud window is frozen; do
                                            * not freeze again until the
                                            * room goes quiet, so a cry
                                            * does not build a queue */
static uint32_t  g_peak_ms = 0;
static uint32_t  g_frozen_ms = 0;
static uint32_t  g_frozen_crc = 0;    /* CRC-32 of the frozen window's bytes */
static float     g_frozen_rms = 0.0f; /* the frozen window's own level */
static uint16_t  g_burst_seq = 0;
static uint8_t   g_node_id = 1;
static Preferences g_prefs;   /* a serial-set node id survives reboots here */

static uint16_t  g_telemetry_seq = 0;
static uint32_t  g_last_tick = 0;
static float     g_rms = 0.0f;
static int32_t   g_mean = 0;

/* The room's noise floor, the event level that follows from it, and how
 * many readings in a row have been at or above that level.  The floor is
 * negative until the first reading arrives, which is what sets it. */
static float     g_floor = -1.0f;
static float     g_level = 0.006f;
static uint8_t   g_loud_streak = 0;

static uint32_t  g_frames_sent = 0;
static uint32_t  g_frames_lost = 0;
static uint32_t  g_requests = 0;
static uint32_t  g_heartbeats = 0;

/* The hub's signal as the node hears it: the RSSI of the last frame the
 * hub sent.  Its heartbeat arrives every 100 ms, so this is a live
 * reading, and it is the node's own view of the link -- the mirror of
 * the reading the hub takes of the node's telemetry.  Zero means no hub
 * frame has been heard yet. */
static int8_t     g_hub_rssi = 0;
static uint32_t   g_hub_rssi_ms = 0;   /* millis() of the last hub frame */
static uint32_t  g_freezes = 0;

static bool      g_dump_active = false;  /* suppress text while dumping */

/* Set from the radio callback, acted on in the loop.  The callback runs in
 * the WiFi task, and sending 286 fragments from there would block the
 * radio for seconds. */
static volatile bool     g_request_pending = false;
static volatile uint16_t g_request_seq = 0;
static volatile uint16_t g_request_first = 0;
static volatile uint16_t g_request_count = 0;

/* ----------------------------------------------------------------- crc16 -- */

static uint16_t crc16(const uint8_t *data, size_t len) {
    uint16_t crc = 0xFFFF;
    for (size_t i = 0; i < len; i++) {
        crc ^= (uint16_t)data[i] << 8;
        for (int bit = 0; bit < 8; bit++) {
            crc = (crc & 0x8000u) ? (uint16_t)((crc << 1) ^ 0x1021u)
                                  : (uint16_t)(crc << 1);
        }
    }
    return crc;
}

/* CRC-32 (the IEEE 802.3 one: reflected, polynomial 0xEDB88320, the
 * final XOR of 0xFFFFFFFF that zlib's crc32 applies).  The hub computes
 * the same value over the window it reassembles from the radio, so the two
 * agreeing proves the audio crossed the link unchanged. */
static uint32_t crc32(const uint8_t *data, size_t len) {
    uint32_t crc = 0xFFFFFFFFu;
    for (size_t i = 0; i < len; i++) {
        crc ^= data[i];
        for (int bit = 0; bit < 8; bit++) {
            crc = (crc & 1u) ? ((crc >> 1) ^ 0xEDB88320u) : (crc >> 1);
        }
    }
    return crc ^ 0xFFFFFFFFu;
}

/* ---------------------------------------------------------------- frames -- */

static uint8_t g_frame[256];

/* Build one frame into g_frame and return its total length. */
static size_t build_frame(uint8_t type, uint16_t seq, uint16_t frag,
                          uint16_t count, const uint8_t *payload, uint16_t plen) {
    g_frame[0] = 0xC3;
    g_frame[1] = 0x7E;
    g_frame[2] = type;
    g_frame[3] = g_node_id;
    g_frame[4] = (uint8_t)(seq & 0xFF);
    g_frame[5] = (uint8_t)(seq >> 8);
    g_frame[6] = (uint8_t)(frag & 0xFF);
    g_frame[7] = (uint8_t)(frag >> 8);
    g_frame[8] = (uint8_t)(count & 0xFF);
    g_frame[9] = (uint8_t)(count >> 8);
    g_frame[10] = (uint8_t)(plen & 0xFF);
    g_frame[11] = (uint8_t)(plen >> 8);
    uint16_t pcrc = (plen > 0) ? crc16(payload, plen) : 0;
    g_frame[12] = (uint8_t)(pcrc & 0xFF);
    g_frame[13] = (uint8_t)(pcrc >> 8);
    if (plen > 0) {
        memcpy(&g_frame[14], payload, plen);
    }
    size_t total = 14 + (size_t)plen;
    uint16_t fcrc = crc16(g_frame, total);
    g_frame[total] = (uint8_t)(fcrc & 0xFF);
    g_frame[total + 1] = (uint8_t)(fcrc >> 8);
    return total + 2;
}

/* ----------------------------------------------------------- the window -- */

/* Exact mean over the valid part of the live window.  The sum is an
 * integer: a float accumulator loses a few counts on 32000 samples and
 * the residual DC is what the front end's standardisation then amplifies
 * (this is exactly the bug the hub's on-device probes caught).
 *
 * The valid region is the newest `valid` samples, so it is walked
 * backwards from the write cursor.  That matters after a burst: the live
 * window is dropped and refilled, and until it is full again the newest
 * samples are not at the start of the array. */
static int32_t window_mean(uint32_t valid) {
    int64_t sum = 0;
    uint32_t idx = g_write;
    for (uint32_t k = 0; k < valid; k++) {
        if (idx == 0) {
            idx = WINDOW_SAMPLES;
        }
        idx--;
        sum += (int64_t)g_window[idx];
    }
    return (int32_t)(sum / (int64_t)valid);
}

/* RMS of the newest n samples, using the mean of the whole window so that
 * the number matches what the hub's front end will see for the same
 * window.  Returned in the same normalised units as the hub: the sample
 * divided by 32768 after the mean is removed. */
static float rms_of_last(int32_t mean, uint32_t n) {
    if (n == 0) {
        return 0.0f;
    }
    uint32_t idx = (g_write + WINDOW_SAMPLES - n) % WINDOW_SAMPLES;
    int64_t acc = 0;
    for (uint32_t k = 0; k < n; k++) {
        int32_t d = (int32_t)g_window[idx] - mean;
        acc += (int64_t)d * d;
        if (++idx == WINDOW_SAMPLES) {
            idx = 0;
        }
    }
    double m = (double)acc / (double)n;
    return (float)(sqrt(m) / 32768.0);
}

/* The RMS of a buffer, with its own mean removed — the same thing the
 * hub's front end does to a window before it makes the features out of
 * it.  Used on the frozen snapshot, so that the level the model is shown
 * can be compared with the level of the room at the time. */
static float buffer_rms(const int16_t *buf, uint32_t n) {
    if (n == 0) {
        return 0.0f;
    }
    int64_t sum = 0;
    for (uint32_t i = 0; i < n; i++) {
        sum += (int32_t)buf[i];
    }
    const int32_t mean = (int32_t)(sum / (int64_t)n);
    int64_t acc = 0;
    for (uint32_t i = 0; i < n; i++) {
        const int32_t d = (int32_t)buf[i] - mean;
        acc += (int64_t)d * d;
    }
    return (float)(sqrt((double)acc / (double)n) / 32768.0);
}

/* Copy the live window into the frozen snapshot, oldest sample first. */
static void freeze_window(void) {
    for (uint32_t i = 0; i < WINDOW_SAMPLES; i++) {
        uint32_t idx = g_write + i;
        if (idx >= WINDOW_SAMPLES) {
            idx -= WINDOW_SAMPLES;
        }
        g_frozen[i] = g_window[idx];
    }
    g_frozen_fill = WINDOW_SAMPLES;
    g_frozen_valid = true;
    g_frozen_served = false;
    g_frozen_ms = millis();
    /* The level of the window that is being offered.  The hub reports it
     * beside the live reading, and the two together say whether the window
     * that was judged was the loud one or a quiet stretch next to it. */
    g_frozen_rms = buffer_rms(g_frozen, WINDOW_SAMPLES);
    /* The checksum of the exact bytes that will be uploaded.  The hub
     * computes the same value over the window it reassembles, so the two
     * agreeing is the proof that the radio delivered the audio intact. */
    g_frozen_crc = crc32((const uint8_t *)g_frozen, BURST_BYTES);
    g_burst_seq++;
    g_freezes++;
}

/* Sample i of the upload target, oldest first. */
static int16_t burst_sample(uint16_t i, bool from_frozen) {
    if (from_frozen) {
        return g_frozen[i];
    }
    uint32_t idx = g_write + i;
    if (idx >= WINDOW_SAMPLES) {
        idx -= WINDOW_SAMPLES;
    }
    return g_window[idx];
}

/* ------------------------------------------------------------------ i2s -- */

static bool i2s_start(void) {
    g_i2s.setPins(PIN_SCK, PIN_WS, -1, PIN_DIN);
    g_i2s.setTimeout(500);
    /* STEREO with both slots — the peripheral must be given the whole
     * 64-bit frame.
     *
     * The INMP441 drives a 64-bit I2S frame of two 32-bit slots and puts
     * its 24-bit sample, left-justified, in the left one.  Asking for
     * I2S_SLOT_MODE_MONO halves the frame to 32 bits, the microphone's
     * framing breaks and the samples come out misaligned: measured on the
     * real board, -3500 counts with the full frame against -620 with the
     * halved one.  Asking for stereo also makes the Arduino library force
     * the both-slots mask whatever mask is given, so the DMA delivers the
     * left and the right slot interleaved either way; the right one is
     * dropped in i2s_pump().  node_diag prints both side by side. */
    if (!g_i2s.begin(I2S_MODE_STD, SAMPLE_RATE, I2S_DATA_BIT_WIDTH_32BIT,
                     I2S_SLOT_MODE_STEREO, I2S_STD_SLOT_BOTH)) {
        return false;
    }
    /* The INMP441's first samples are garbage: measured on the real board,
     * the first 100 ms window after begin() is a full-scale burst (the
     * capture node's RMS field reads 656 milli against the room's 6-11)
     * and it decays over about half a second.  Without this, every boot
     * would freeze a garbage window the moment the burst crossed the EVENT
     * level and hand the hub a spurious upload.  Discard 500 ms; the
     * slower DC drift that remains is removed by the mean. */
    static const uint32_t WARMUP_FRAMES = SAMPLE_RATE / 2;   /* 500 ms */
    uint32_t warmed = 0;
    const uint32_t started = millis();
    while (warmed < WARMUP_FRAMES) {
        if (millis() - started >= 3000u) {
            return false;
        }
        size_t got = g_i2s.readBytes((char *)g_raw, sizeof(g_raw));
        got -= got % 8;                 /* whole stereo frames only */
        warmed += got / 8;
    }
    return true;
}

/* Read whatever the microphone has produced and append it to the window.
 *
 * A read that comes back short means the microphone's buffer ran dry --
 * the driver waited and the samples did not arrive -- so the audio has a
 * hole in it and the live window can no longer be trusted.  That is
 * flagged here and acted on by the caller. */
static uint32_t g_loop_iters = 0;
static uint32_t g_loop_max_us = 0;
static uint64_t g_t_pump = 0, g_t_tick = 0, g_t_req = 0, g_t_rest = 0;
static uint32_t g_pump_calls = 0;
static uint32_t g_pump_empty = 0;   /* calls that returned no whole frame */
static uint32_t g_pump_frames = 0;
static uint32_t g_pump_max_us = 0;
static volatile bool     g_window_damaged = false;  /* the live window has a hole */
static volatile uint32_t g_i2s_restarts = 0;
static uint32_t g_zero_samples = 0;
static const uint32_t I2S_ZERO_LIMIT = SAMPLE_RATE * 5u; /* five seconds */
static size_t i2s_pump(void) {
    const int64_t t0 = esp_timer_get_time();
    size_t got = g_i2s.readBytes((char *)g_raw, sizeof(g_raw));
    const int64_t dt = esp_timer_get_time() - t0;
    g_t_pump += (uint64_t)dt;
    if (dt > (int64_t)g_pump_max_us) {
        g_pump_max_us = (uint32_t)dt;
    }
    g_pump_calls++;
    if (got < sizeof(g_raw)) {
        g_zero_samples = 0; /* missing frames are not consecutive zeros */
        /* The microphone's buffer ran dry: what is in the window is no
         * longer continuous audio. */
        g_window_damaged = true;
    }
    if (got < 8) {
        g_pump_empty++;
    }
    g_pump_frames += got / 8;
    got -= got % 8;                 /* whole stereo frames only */
    size_t frames = got / 8;
    for (size_t f = 0; f < frames; f++) {
        /* The left slot holds the microphone's 24-bit sample, left
         * justified, so the top 16 bits are the full-scale int16 value.
         * The right slot is a constant and is dropped. */
        int16_t s = (int16_t)(g_raw[f * 2] >> 16);
        if (s == 0) {
            if (g_zero_samples < I2S_ZERO_LIMIT) {
                g_zero_samples++;
            }
        } else if (g_zero_samples < I2S_ZERO_LIMIT) {
            g_zero_samples = 0;
        }
        g_window[g_write] = s;
        g_write++;
        if (g_write == WINDOW_SAMPLES) {
            g_write = 0;
        }
        if (g_filled < WINDOW_SAMPLES) {
            g_filled++;
        }
    }
    return frames;
}

/* The microphone's own task.
 *
 * The I2S read blocks until the samples are there, so reading the
 * microphone from the main loop stopped the main loop for as long as the
 * audio took to arrive -- sixteen milliseconds, every time.  That was
 * harmless while a burst took three and a half seconds, and it was not
 * harmless at all once the radio learned to carry a burst in a fraction
 * of a second: then the microphone's real-time rate, and not the radio's,
 * decided how long a burst took, and the system got slower than it had
 * ever been.
 *
 * So the microphone has a task of its own.  It wakes sixteen times a
 * second, takes what the hardware has produced, and puts it in the
 * window.  The main loop never waits for audio: the radio is fed as
 * fast as the radio can carry it, and the node keeps listening while it
 * is talking. */
static void capture_task(void *arg)
{
    (void)arg;
    for (;;) {
        i2s_pump();
        /* Exact zero samples for five seconds are not a quiet room: the
         * microphone normally has noise.  Restart I2S from its owning task;
         * invalidate the live ring, but keep any frozen upload intact. */
        if (g_zero_samples >= I2S_ZERO_LIMIT) {
            g_zero_samples = 0;
            g_window_damaged = true;
            g_i2s_restarts++;
            if (!g_i2s.end() || !i2s_start()) {
                /* A failed driver teardown or warmup cannot be repaired
                 * safely by reusing its handles.  Reboot instead. */
                ESP.restart();
            }
            g_window_damaged = true;
        }
        /* The read itself paces this task: it returns when the samples
         * have arrived. */
    }
}

/* ---------------------------------------------------------------- radio -- */

static uint8_t g_bcast[6] = {0xFF, 0xFF, 0xFF, 0xFF, 0xFF, 0xFF};

/* The hub's address, learned from the request the node receives: the hub
 * broadcasts its requests, and the node replies to the address they came
 * from.  Unicast is used once the hub is known, because a broadcast
 * destination is filtered more aggressively by the receiver's radio. */
static uint8_t g_hub_mac[6] = {0};
static bool     g_hub_known = false;
/* Set from the receive callback, acted on in the loop: the callback
 * runs in the WiFi task, and esp_now_add_peer() waits for that very
 * task, which wedged the radio — the send callback stopped firing and
 * every radio_send burned its two-second cap.  The hub's node_link
 * carries the same rule: peers are added from a normal task. */
static volatile bool g_hub_peer_pending = false;
static uint8_t       g_pending_mac[6];

/* A resend request from the hub: the fragments of a burst that never
 * arrived.  The bitmap says which ones. */
static bool      g_resend_pending = false;
static uint16_t  g_resend_seq = 0;
static uint8_t   g_resend_bitmap[RESEND_BITMAP_BYTES];

/* The request the node answered last, and when.  The hub sends its
 * request three times, because a broadcast is never acknowledged; the
 * node must answer it once.  A repeat of the request it is already
 * serving is dropped, or the node would send the same hundred and
 * twenty-eight fragments two or three times over and the hub would see
 * a burst that never settles. */
static uint16_t  g_resend_last_seq = 0;
static uint32_t  g_resend_last_ms = 0;
/* The bitmap of that request, so a repeat can be told apart from a
 * *new* round. */
static uint8_t   g_resend_last_bitmap[RESEND_BITMAP_BYTES];

/* How close together two requests for the same window have to be for
 * the second to count as a repeat of the first.
 *
 * This was 800 ms, and it was longer than the hub's own round of
 * resends -- the hub asks again about 670-770 ms after the last ask --
 * so the node threw away every round after the first as a "repeat" of
 * the one it was answering.  The consequence was fatal: a burst that
 * lost one fragment could never be completed.  The hub asked for the
 * missing fragment five times, the node answered none of the five
 * requests, the burst sat at 285 of 286 until it timed out, and the
 * whole two-second window -- the one that held the cry -- was thrown
 * away.  A burst that is one frame short is the *commonest* failure
 * on a weak link, so this was the single most expensive line in the
 * firmware.
 *
 * The rule is now two-sided: a request is a repeat only if it names
 * the same window AND the same fragments AND arrives within the window
 * below.  A round that asks for a *different* fragment is a new round
 * and is always answered. */
static const uint32_t RESEND_DEDUPE_MS = 250;

/* The radio's transmit callback.  It fires when a frame has actually left
 * the queue.  The sender counts the frames it has handed over against the
 * frames that have left, so it always knows how many the radio is still
 * holding.
 *
 * ESP-NOW's queue is ten frames deep.  A burst is 286 fragments, so they
 * cannot all be handed over at once: every frame past the tenth would be
 * lost for good.  The sender used to wait for each frame's own
 * acknowledgement before handing over the next one, and that cost about
 * twelve milliseconds a fragment -- three and a half seconds for a burst,
 * which was most of the time the system took to answer a cry.  It now
 * keeps a few frames in the radio at once and waits for a group of them,
 * which is what the queue is for. */
static volatile uint32_t g_tx_acks = 0;
static uint32_t g_tx_queued = 0;   /* handed over, not yet acknowledged */
/* How many frames the radio itself could not carry.  The callback's
 * status used to be thrown away, so this was always zero and the node
 * reported a clean sheet even when the radio was dropping its burst. */
static volatile uint32_t g_tx_failed = 0;

/* How many frames the radio may be holding at once.  The queue is ten
 * deep; four leaves room for the telemetry and the heartbeats that share
 * it, and keeps the far end's receive queue from filling up -- one
 * fragment in three hundred was being lost on the way to the hub, and
 * the far end's queue overflowing is the likeliest reason. */
#define TX_INFLIGHT_MAX 4

/* How many frames the radio is holding right now. */
static uint32_t tx_inflight(void)
{
    return g_tx_queued - g_tx_acks;
}

/* How long the sender waits for the radio to take each frame.  A frame
 * that is acknowledged in a millisecond was handed to the driver, not put
 * on the air; a frame that takes a hundred milliseconds was transmitted
 * and acknowledged. */
static uint32_t g_send_max_us = 0;   /* time inside esp_now_send() */
static uint32_t g_send_calls = 0;
static uint32_t g_tx_wait_us = 0;
static uint32_t g_tx_wait_n = 0;
static uint32_t g_tx_wait_max = 0;

/* How many times the radio had no room and the sender had to wait. */
static uint32_t g_tx_full = 0;

static void on_send(const esp_now_send_info_t *info, esp_now_send_status_t status) {
    (void)info;
    /* The frame is finished either way, so it leaves the in-flight
     * count.  But the status says whether the radio could carry it, and
     * it used to be thrown away: the node's own counters said "nothing
     * lost" no matter what the radio did, which is how a cot whose
     * fragments never arrive can still report a clean sheet. */
    g_tx_acks++;
    if (status != ESP_NOW_SEND_SUCCESS) {
        g_tx_failed++;
    }
}

static void on_recv(const esp_now_recv_info_t *info, const uint8_t *data, int len) {
    if (len < 12 || data[0] != 0xC3 || data[1] != 0x7E) {
        return;
    }
    /* The hub's signal as the node hears it: the RSSI of a frame the hub
     * sent.  Only the hub's own frame types count — a request, a
     * heartbeat, a resend request.  The telemetry and the window
     * fragments are the *other* cot's traffic, which the node also
     * hears because everything is broadcast, and reading the signal
     * strength of another cot's frame would report the loudest cot in
     * the room rather than the hub. */
    if (info != NULL && info->rx_ctrl != NULL &&
        (data[2] == LINK_TYPE_REQUEST || data[2] == LINK_TYPE_HEARTBEAT ||
         data[2] == LINK_TYPE_RESEND)) {
        g_hub_rssi = (int8_t)info->rx_ctrl->rssi;
        g_hub_rssi_ms = millis();
    }
    /* A heartbeat (type 4) is the hub keeping its radio awake.  It asks
     * for nothing, so the node's window is left alone. */
    /* Learn the hub's address from any frame it sends — requests and
     * heartbeats both — and add it as a peer so the reply can be
     * unicast to it.  The heartbeat arrives every 100 ms, so the
     * address is learned within a tenth of a second of boot; waiting
     * for a request meant that a hub which had already heard the node
     * (and so had stopped probing) never told the node where to send. */
    if (!g_hub_known && !g_hub_peer_pending && info != NULL &&
        (data[2] == LINK_TYPE_REQUEST || data[2] == LINK_TYPE_HEARTBEAT ||
         data[2] == LINK_TYPE_RESEND)) {
        memcpy(g_pending_mac, info->src_addr, 6);
        g_hub_peer_pending = true;
    }
    /* A heartbeat (type 4) is the hub keeping its radio awake.  It asks
     * for nothing, so the node's window is left alone. */
    if (data[2] == LINK_TYPE_HEARTBEAT) {
        g_heartbeats++;
        return;
    }

    /* A resend request: the hub's list of the fragments of a burst that
     * never arrived.  The payload is a bitmap, one bit per fragment,
     * and the node answers by sending exactly the fragments whose bit
     * is set -- out of the same frozen window, with the same sequence
     * number, so the pieces that did arrive are not sent again. */
    if (data[2] == LINK_TYPE_RESEND) {
        const uint16_t plen = (uint16_t)data[10] | ((uint16_t)data[11] << 8);
        const size_t total = 14u + (size_t)plen;
        if (plen != RESEND_BITMAP_BYTES || len != (int)(total + 2u)) {
            g_frames_lost++;
            return;
        }
        /* The frame's own CRC first: the bitmap is only worth reading
         * if the frame is intact. */
        const uint16_t fcrc = (uint16_t)data[total] | ((uint16_t)data[total + 1] << 8);
        if (crc16(data, total) != fcrc) {
            g_frames_lost++;
            return;
        }
        const uint16_t pcrc = (uint16_t)data[12] | ((uint16_t)data[13] << 8);
        if (crc16(&data[14], plen) != pcrc) {
            g_frames_lost++;
            return;
        }
        if (data[3] != g_node_id && data[3] != 0xFF) {
            return;                       /* not for us */
        }
        const uint16_t seq = (uint16_t)data[4] | ((uint16_t)data[5] << 8);
        const uint32_t now = millis();
        /* A repeat is the same window, the same fragments, and close in
         * time.  A round that asks for a fragment the last round did
         * not ask for is a new round: it is answered, however soon it
         * follows the last one. */
        const bool same_round =
            (seq == g_resend_last_seq) &&
            (memcmp(&data[14], g_resend_last_bitmap, RESEND_BITMAP_BYTES) == 0);
        if (same_round && (now - g_resend_last_ms) < RESEND_DEDUPE_MS) {
            /* A repeat of the request already being answered. */
            return;
        }
        g_resend_last_seq = seq;
        g_resend_last_ms = now;
        memcpy(g_resend_last_bitmap, &data[14], RESEND_BITMAP_BYTES);
        g_resend_pending = true;
        g_resend_seq = seq;
        memcpy(g_resend_bitmap, &data[14], RESEND_BITMAP_BYTES);
        if (Serial) {
            /* How many fragments does the hub say it is missing?  The
             * bitmap is counted here rather than assumed, because a
             * hub that asks for 274 fragments and a node that reads
             * twelve bits out of the same request is a disagreement
             * that has to be visible in the log to be findable. */
            uint32_t asked = 0;
            for (uint16_t b = 0; b < RESEND_BITMAP_BYTES; b++) {
                uint8_t v = g_resend_bitmap[b];
                for (int bit = 0; bit < 8; bit++) {
                    if (v & (1u << bit)) {
                        asked++;
                    }
                }
            }
            Serial.printf("resend request: seq %u, %lu of %u fragments asked "
                          "for, bitmap %02X %02X %02X %02X\n",
                          (unsigned)g_resend_seq, (unsigned long)asked,
                          (unsigned)FRAG_COUNT,
                          g_resend_bitmap[0], g_resend_bitmap[1],
                          g_resend_bitmap[2], g_resend_bitmap[3]);
        }
        return;
    }

    if (data[2] != LINK_TYPE_REQUEST) {
        return;
    }
    uint16_t want = (uint16_t)data[10] | ((uint16_t)data[11] << 8);
    if (crc16(data, 10) != want) {
        g_frames_lost++;
        return;
    }
    if (data[3] != g_node_id && data[3] != 0xFF) {
        return;                      /* not for us */
    }
    g_request_pending = true;
    g_request_seq   = (uint16_t)data[4] | ((uint16_t)data[5] << 8);
    g_request_first = (uint16_t)data[6] | ((uint16_t)data[7] << 8);
    g_request_count = (uint16_t)data[8] | ((uint16_t)data[9] << 8);
    if (Serial) {
        Serial.printf("request: seq %u first %u count %u\n",
                      (unsigned)g_request_seq, (unsigned)g_request_first,
                  (unsigned)g_request_count);
    }
}

/* The channel the radio is actually on.  WiFi.channel() is no use here:
 * it reports the channel of the AP the station is associated with, and
 * this node never associates with one. */
static int link_channel(void) {
    uint8_t c = 0;
    wifi_second_chan_t second = WIFI_SECOND_CHAN_NONE;
    if (esp_wifi_get_channel(&c, &second) == ESP_OK) {
        return (int)c;
    }
    return -1;
}

static bool radio_start(void) {
    WiFi.mode(WIFI_STA);
    WiFi.setSleep(false);
    delay(100);

    /* The channel is set with esp_wifi_set_channel(), and the reason it
     * is not WiFi.channel(11) is worth writing down: the Arduino core
     * has no channel *setter*.  WiFi.channel(x) is the scan result's
     * channel — WiFiScanClass::channel(uint8_t i) — so the call
     * compiled, returned an int, and changed nothing at all.  The node
     * sat on channel 1 the whole time and the sends failed with "peer
     * channel is not equal to the home channel". */
    if (esp_wifi_set_channel(LINK_CHANNEL, WIFI_SECOND_CHAN_NONE) != ESP_OK) {
        if (Serial) {
            Serial.printf("the channel could not be set to %d\n",
                          (unsigned)LINK_CHANNEL);
        }
        return false;
    }
    delay(50);

    if (esp_now_init() != ESP_OK) {
        return false;
    }
    /* esp_now_init() starts the Wi-Fi driver, and the driver puts the
     * interface back on channel 1 when it starts — so the channel is
     * set again, after it. */
    esp_wifi_set_channel(LINK_CHANNEL, WIFI_SECOND_CHAN_NONE);
    delay(50);

    esp_now_register_recv_cb(on_recv);
    esp_now_register_send_cb(on_send);

    /* The transmitter's power, and why it is turned down.
     *
     * The INMP441 sits on the same board as the Wi-Fi antenna, a few
     * centimetres from it, and the radio's own transmission reaches the
     * microphone: with the radio at full power the node's windows
     * carried roughly five times the energy of the same room's windows
     * recorded with the radio off, and the extra energy had the shape
     * the model reads as a cry.  The node's own transmitter was putting
     * cry-shaped noise into the audio it was about to be judged on.
     *
     * 8.5 dBm is enough for a link of a couple of metres, which is what
     * a cot node is, and it is 11 dB less power into the room.  On a
     * battery node that is also the right thing to be doing. */
    esp_wifi_set_max_tx_power(WIFI_POWER_8_5dBm);

    esp_now_peer_info_t peer = {};
    memcpy(peer.peer_addr, g_bcast, 6);
    /* The channel is set explicitly rather than left at 0.  With 0 the
     * peer is supposed to follow the interface's current channel, but on
     * this driver the frame never left the node: the send callback fired
     * and nothing arrived at the hub, on any of the thirteen channels.
     * The hub's peer has always had the channel set, and the hub's
     * transmissions arrive perfectly. */
    peer.channel = LINK_CHANNEL;
    peer.ifidx   = WIFI_IF_STA;
    peer.encrypt = false;
    if (esp_now_add_peer(&peer) != ESP_OK) {
        return false;
    }
    return true;
}

/* Hand one frame to the radio.  The driver copies it into its queue and
 * returns at once; the frame goes on the air a moment later and its
 * acknowledgement arrives in the Wi-Fi task.
 *
 * Broadcast.  Unicast to the learned hub address wedged the send path:
 * the frame was accepted, never transmitted, and the send callback never
 * fired, so every send burned its two-second cap and the loop starved
 * the microphone.  Broadcast callbacks fire in milliseconds; revisit
 * unicast only with a passing dedicated test. */
static bool radio_queue(const uint8_t *data, size_t len)
{
    const uint8_t *dest = g_bcast;
    const int64_t st0 = esp_timer_get_time();
    const esp_err_t serr = esp_now_send(dest, data, len);
    const int64_t sdt = esp_timer_get_time() - st0;
    g_send_calls++;
    if (sdt > (int64_t)g_send_max_us) {
        g_send_max_us = (uint32_t)sdt;
    }
    if (serr != ESP_OK) {
        g_frames_lost++;
        return false;
    }
    g_frames_sent++;
    g_tx_queued++;
    return true;
}

/* Wait until the radio has room for another frame.
 *
 * The microphone is NOT read here, and that is the whole point.  An
 * earlier version of this code read it while the radio was busy, to
 * keep the node listening during a burst -- and the burst became
 * *slower* than it had ever been: a read of the microphone blocks until
 * the samples are there, so the burst was paced by the rate the
 * microphone produces audio (sixteen thousand samples a second, and a
 * read can only ever take what has arrived) rather than by the radio.
 * The burst measured 7.2 s that way, against 3.4 s before.
 *
 * The microphone has its own task now, so the audio is collected while
 * the radio is busy and this loop only has to wait for the radio. */
static void radio_wait_room(void)
{
    const int64_t start_us = esp_timer_get_time();
    while (tx_inflight() >= TX_INFLIGHT_MAX) {
        delay(1);
        if (esp_timer_get_time() - start_us > 5000000) {
            /* Far longer than the radio should ever take to take a frame;
             * give up rather than hang the node. */
            g_tx_full++;
            return;
        }
    }
}

/* Send one frame and wait for it to be acknowledged.  The telemetry uses
 * this: it is one frame every hundred milliseconds, and the wait is what
 * keeps the radio's queue tidy. */
static bool radio_send(const uint8_t *data, size_t len)
{
    radio_wait_room();
    const uint32_t before = g_tx_acks;
    if (!radio_queue(data, len)) {
        return false;
    }
    uint32_t waited = 0;
    const uint32_t t0 = micros();
    while (g_tx_acks == before && waited < 50) {
        delay(1);
        waited++;
    }
    const uint32_t waited_us = micros() - t0;
    g_tx_wait_us += waited_us;
    g_tx_wait_n++;
    if (waited_us > g_tx_wait_max) {
        g_tx_wait_max = waited_us;
    }
    return true;
}

/* Send one fragment of the upload target. */
static void send_fragment(uint16_t index, bool from_frozen, bool over_serial) {
    uint8_t payload[FRAG_PAYLOAD];
    uint16_t offset = (uint16_t)(index * FRAG_PAYLOAD);
    uint16_t len = (uint16_t)(BURST_BYTES - offset);
    if (len > FRAG_PAYLOAD) {
        len = FRAG_PAYLOAD;
    }
    for (uint16_t i = 0; i < len; i += 2) {
        int16_t s = burst_sample((uint16_t)(offset / 2 + i / 2), from_frozen);
        payload[i]     = (uint8_t)(s & 0xFF);
        payload[i + 1] = (uint8_t)((uint16_t)s >> 8);
    }
    size_t total = build_frame(2, g_burst_seq, index, FRAG_COUNT, payload, len);
    if (over_serial) {
        Serial.write(g_frame, total);
    } else {
        /* The radio takes a few frames at a time; the wait for room is
         * where the microphone is read, so the node keeps listening while
         * it talks.  A frame the driver refuses is tried again: the
         * queue was full, and the fragment is one the hub is waiting
         * for. */
        for (int tries = 0; tries < 3; tries++) {
            radio_wait_room();
            if (radio_queue(g_frame, total)) {
                break;
            }
            delay(2);
        }
    }
}

/* ------------------------------------------------------------ telemetry -- */

static void send_telemetry(void) {
    int32_t rms_milli = (int32_t)(g_rms * 1000.0f + (g_rms >= 0 ? 0.5f : -0.5f));
    uint8_t payload[32];
    payload[0] = (uint8_t)(rms_milli & 0xFF);
    payload[1] = (uint8_t)((rms_milli >> 8) & 0xFF);
    payload[2] = (uint8_t)((rms_milli >> 16) & 0xFF);
    payload[3] = (uint8_t)((rms_milli >> 24) & 0xFF);
    uint16_t win_ms = (uint16_t)(WINDOW_SAMPLES * 1000 / SAMPLE_RATE);
    payload[4] = (uint8_t)(win_ms & 0xFF);
    payload[5] = (uint8_t)(win_ms >> 8);
    uint8_t flags = 0;
    if (g_frozen_valid) {
        flags |= 0x01;              /* a burst is ready */
    }
    if (g_rms >= g_level) {
        flags |= 0x02;              /* the event level is being crossed */
    }
    if (g_filled == WINDOW_SAMPLES) {
        flags |= 0x04;              /* the live window is complete */
    }
    payload[6] = flags;
    /* The event level the node is using, in milli-RMS.  The node owns the
     * noise floor, so it owns the level that follows from it, and the hub
     * triggers on this number: the node is the one that freezes the
     * window, so the level that matters is the one it used.  Zero means
     * "not reported" and the hub falls back to its own fixed level. */
    uint16_t level_milli = (uint16_t)(g_level * 1000.0f + 0.5f);
    payload[7] = (uint8_t)(level_milli & 0xFF);
    payload[8] = (uint8_t)((level_milli >> 8) & 0xFF);
    /* The frozen window's own level, in milli-RMS: what the model will
     * actually be shown, as opposed to the live reading beside it. */
    uint16_t frozen_milli = (uint16_t)(g_frozen_rms * 1000.0f + 0.5f);
    payload[9] = (uint8_t)(frozen_milli & 0xFF);
    payload[10] = (uint8_t)((frozen_milli >> 8) & 0xFF);
    /* The noise floor itself, in milli-RMS, clamped to what one byte
     * holds. */
    uint16_t floor_milli = (uint16_t)(g_floor * 1000.0f + 0.5f);
    payload[11] = (uint8_t)(floor_milli > 255u ? 255u : floor_milli);
    /* The CRC-32 of the frozen window, so the hub can check the window it
     * reassembles against the one the node actually froze. */
    uint32_t crc = g_frozen_valid ? g_frozen_crc : 0u;
    payload[12] = (uint8_t)(crc & 0xFF);
    payload[13] = (uint8_t)((crc >> 8) & 0xFF);
    payload[14] = (uint8_t)((crc >> 16) & 0xFF);
    payload[15] = (uint8_t)((crc >> 24) & 0xFF);
    /* The radio's own counters.  They are the answer to the question a
     * stalled burst raises -- "did the node send them, or did the air
     * eat them?" -- and they cost the telemetry sixteen bytes.
     *
     * frames_sent is what the node handed to the radio, frames_acked is
     * what the radio says it put on the air, and frames_lost is what
     * the radio refused outright.  A node whose frames_sent climbs to
     * 286 while frames_acked stays at 30 has lost the rest in the air;
     * a node whose frames_lost climbs has a radio queue too small for
     * the burst.  The hub prints all four whenever a burst stalls, so
     * the difference is on the log instead of in a guess. */
    const uint32_t counters[4] = {
        (uint32_t)g_frames_sent,
        (uint32_t)g_frames_lost,
        (uint32_t)g_tx_acks,
        (uint32_t)g_tx_full,
    };
    /* The counters start at byte 16 now.  They used to start at byte
     * 18, behind the battery voltage that used to sit between them and
     * the CRC (D-83); the battery tier is gone and the counters moved
     * down to fill the gap. */
    for (int i = 0; i < 4; i++) {
        payload[16 + i * 4]     = (uint8_t)(counters[i] & 0xFF);
        payload[16 + i * 4 + 1] = (uint8_t)((counters[i] >> 8) & 0xFF);
        payload[16 + i * 4 + 2] = (uint8_t)((counters[i] >> 16) & 0xFF);
        payload[16 + i * 4 + 3] = (uint8_t)((counters[i] >> 24) & 0xFF);
    }

    size_t total = build_frame(1, g_burst_seq, 0, 0, payload, sizeof(payload));
    radio_send(g_frame, total);
    g_telemetry_seq++;
}

/* ---------------------------------------------------------------- console -- */

/* How many bars a link reading is worth, on the same scale the hub's
 * display uses: 2.4 GHz links in a house, strong above -60 dBm and
 * barely there below -90. */
static int rssi_bars(int8_t rssi) {
    if (rssi == 0) { return 0; }
    if (rssi >= -60) { return 4; }
    if (rssi >= -70) { return 3; }
    if (rssi >= -80) { return 2; }
    if (rssi >= -90) { return 1; }
    return 0;
}

/* The node's own view of the link to the hub, as a network bar. */
static void print_link_bar(void) {
    const int bars = rssi_bars(g_hub_rssi);
    Serial.print("link   [");
    for (int i = 0; i < 4; i++) {
        Serial.print(i < bars ? '#' : '.');
    }
    if (g_hub_rssi != 0) {
        Serial.printf("] %d dBm", (int)g_hub_rssi);
    } else {
        Serial.print("] --");
    }
    if (g_hub_rssi != 0) {
        const uint32_t age = millis() - g_hub_rssi_ms;
        Serial.printf("  (hub frame %lu ms ago)\n", (unsigned long)age);
    } else {
        Serial.println("  (no hub frame heard)");
    }
}

static void print_status(void) {
    /* The radio's own address, which the hub needs in its table of node
     * addresses.  WiFi.macAddress() reports a different one on this
     * board, so it is read from the chip directly. */
    uint8_t sta[6] = {0};
    esp_read_mac(sta, ESP_MAC_WIFI_STA);
    Serial.printf("node %u  mac %02X:%02X:%02X:%02X:%02X:%02X\n", g_node_id,
                  sta[0], sta[1], sta[2], sta[3], sta[4], sta[5]);
    Serial.printf("esp_now_send calls=%u max_us=%u\n",
                  (unsigned)g_send_calls, (unsigned)g_send_max_us);
    Serial.printf("time pump=%llu tick=%llu req=%llu rest=%llu ms\n",
                  (unsigned long long)(g_t_pump / 1000),
                  (unsigned long long)(g_t_tick / 1000),
                  (unsigned long long)(g_t_req / 1000),
                  (unsigned long long)(g_t_rest / 1000));
    Serial.printf("pump calls=%u empty=%u frames=%u max_us=%u loops=%u loop_max_us=%u\n",
                  (unsigned)g_pump_calls, (unsigned)g_pump_empty,
                  (unsigned)g_pump_frames, (unsigned)g_pump_max_us,
                  (unsigned)g_loop_iters, (unsigned)g_loop_max_us);
    Serial.printf("I2S zero watchdog restarts=%u\n", (unsigned)g_i2s_restarts);
    Serial.printf("window %u/%u samples   frozen=%u seq=%u\n", (unsigned)g_filled,
                  (unsigned)WINDOW_SAMPLES, g_frozen_valid ? 1 : 0,
                  (unsigned)g_burst_seq);
    if (g_frozen_valid) {
        Serial.printf("frozen crc32 0x%08X\n", (unsigned)g_frozen_crc);
    }
    Serial.printf("rms %.4f  mean %d  floor %.4f  level %.4f  fragments=%u\n",
                  g_rms, (int)g_mean, g_floor, g_level, (unsigned)FRAG_COUNT);
    Serial.printf("heap %u bytes\n", (unsigned)ESP.getFreeHeap());
    Serial.printf("channel %d\n", link_channel());
    uint32_t ver = 0;
    esp_now_get_version(&ver);
    Serial.printf("ESP-NOW version %u, hub %s\n", (unsigned)ver,
                  g_hub_known ? "known" : "unknown");
    print_link_bar();
}

static void print_stats(void) {
    Serial.printf("telemetry seq %u  frames sent %u  lost %u  requests %u  freezes %u\n",
                  (unsigned)g_telemetry_seq, (unsigned)g_frames_sent,
                  (unsigned)g_frames_lost, (unsigned)g_requests,
                  (unsigned)g_freezes);
    Serial.printf("tx wait: avg %u us, max %u us, over %u frames\n",
                  (unsigned)(g_tx_wait_n ? g_tx_wait_us / g_tx_wait_n : 0),
                  (unsigned)g_tx_wait_max, (unsigned)g_tx_wait_n);
    Serial.printf("radio: queued %u  acked %u  in flight %u  queue full %u times\n",
                  (unsigned)g_tx_queued, (unsigned)g_tx_acks,
                  (unsigned)tx_inflight(), (unsigned)g_tx_full);
    Serial.printf("radio: the driver could not carry %u frames\n",
                  (unsigned)g_tx_failed);
}

static void handle_command(char *line) {
    if (strcmp(line, "status") == 0) {
        print_status();
    } else if (strcmp(line, "stats") == 0) {
        print_stats();
    } else if (strcmp(line, "freeze") == 0) {
        if (g_filled < WINDOW_SAMPLES) {
            Serial.println("window not full yet");
        } else {
            freeze_window();
            Serial.printf("frozen seq=%u\n", g_burst_seq);
        }
    } else if (strcmp(line, "burst") == 0) {
        if (!g_frozen_valid) {
            Serial.println("no frozen window");
        } else {
            Serial.printf("BURST seq=%u fragments=%u bytes=%u\n", g_burst_seq,
                          FRAG_COUNT, (unsigned)BURST_BYTES);
            g_dump_active = true;
            for (uint16_t i = 0; i < FRAG_COUNT; i++) {
                send_fragment(i, true, true);
            }
            g_dump_active = false;
            Serial.println("BURST-END");
        }
    } else if (strncmp(line, "id ", 3) == 0) {
        int v = atoi(line + 3);
        /* This hub watches two cots, so a node's number is one of two.
         * A third number is a node the hub will not answer to. */
        if (v >= 1 && v <= CRYNET_COT_COUNT) {
            g_node_id = (uint8_t)v;
            g_prefs.putUChar("node_id", g_node_id);
            Serial.printf("node id %u (saved)\n", g_node_id);
        } else {
            Serial.printf("id must be 1..%u (this hub watches two cots)\n",
                          (unsigned)CRYNET_COT_COUNT);
        }
    } else if (strcmp(line, "help") == 0) {
        Serial.println("status | stats | freeze | burst | id <n> | help");
    } else {
        Serial.println("unknown command");
    }
}

/* ------------------------------------------------------------------ loop -- */

void setup() {
    Serial.begin(115200);
    /* A closed serial port must never cost the loop time: the HWCDC
     * write path waits up to two seconds per print when the host is not
     * reading, and an unattended node printing its rms every hundred
     * milliseconds starved its own loop into a crawl.  Zero timeout
     * makes prints drop instead of block. */
    Serial.setTxTimeoutMs(0);
    delay(200);

    uint8_t mac[6];
    WiFi.macAddress(mac);
    const uint8_t derived = (uint8_t)((mac[5] & 0x0F) + 1);

    /* A node id set over serial survives reboots in NVS; a board that was
     * never named keeps the MAC-derived default.  Identical Pro Minis can
     * derive the same number — the project really did end up with two
     * boards both calling themselves node 1. */
    g_prefs.begin("crynet", false);
    const uint8_t saved = g_prefs.getUChar("node_id", 0);
    g_node_id = saved ? saved : derived;

    Serial.println("\nCryNet node firmware — Stage 2b");
    if (saved) {
        Serial.printf("node id %u (saved; the MAC would have said %u)\n",
                      g_node_id, (unsigned)derived);
    } else {
        Serial.printf("node id %u (derived from the MAC; change it with \"id <n>\")\n",
                      g_node_id);
    }
    /* This hub watches two cots and ignores every other node number, so
     * a node that has been left on a MAC-derived number outside 1..2
     * would transmit into a hub that never answers it.  Say so plainly
     * rather than leaving the board looking dead. */
    if (g_node_id < 1 || g_node_id > CRYNET_COT_COUNT) {
        Serial.printf("WARNING: this hub watches cots 1 and %u only. "
                      "Set this board with \"id 1\" or \"id %u\".\n",
                      (unsigned)CRYNET_COT_COUNT, (unsigned)CRYNET_COT_COUNT);
    }

    if (!i2s_start()) {
        Serial.println("FATAL: I2S init failed");
        while (true) {
            delay(1000);
        }
    }
    Serial.println("I2S ready: 16 kHz, mono, 32-bit slots -> int16");
    /* The microphone gets a task of its own, so that the main loop never
     * waits for audio and the radio is fed as fast as the radio can
     * carry it.  The task owns the I2S peripheral from here on: nothing
     * else may read it. */
    if (xTaskCreate(capture_task, "capture", 4096, NULL, 3, NULL) != pdPASS) {
        Serial.println("FATAL: the capture task could not be started");
        while (true) {
            delay(1000);
        }
    }

    if (!radio_start()) {
        Serial.println("FATAL: ESP-NOW init failed");
        while (true) {
            delay(1000);
        }
    }
    uint32_t now_version = 0;
    if (esp_now_get_version(&now_version) == ESP_OK) {
        Serial.printf("ESP-NOW protocol version %u\n", (unsigned)now_version);
    }
    Serial.printf("ESP-NOW ready on channel %d\n", link_channel());

    Serial.println("commands: status | stats | freeze | burst | id <n> | help");
}

void loop() {
    const int64_t lt0 = esp_timer_get_time();
    g_loop_iters++;
    if (g_hub_peer_pending) {
        g_hub_peer_pending = false;
        esp_now_peer_info_t hub = {};
        memcpy(g_hub_mac, g_pending_mac, 6);
        memcpy(hub.peer_addr, g_hub_mac, 6);
        hub.channel = LINK_CHANNEL;
        hub.ifidx = WIFI_IF_STA;
        hub.encrypt = false;
        if (esp_now_add_peer(&hub) == ESP_OK) {
            g_hub_known = true;
            if (Serial)
                Serial.printf("hub is %02X:%02X:%02X:%02X:%02X:%02X\n",
                          g_hub_mac[0], g_hub_mac[1], g_hub_mac[2],
                          g_hub_mac[3], g_hub_mac[4], g_hub_mac[5]);
        }
    }
    /* The microphone is read by its own task; the main loop does not
     * wait for audio.  All it has to do here is notice when the audio
     * came through with a hole in it. */
    if (g_window_damaged) {
        g_filled = 0;
        g_window_damaged = false;
    }
    /* The window is only worth measuring once it holds a full 100 ms: the
     * hub's front end removes the mean of the whole two seconds, and a
     * partial window would not match it. */
    const int64_t tk0 = esp_timer_get_time();
    if (g_filled >= RMS_SAMPLES) {
        uint32_t now = millis();
        if (now - g_last_tick >= TELEMETRY_MS) {
            g_last_tick = now;
            g_mean = window_mean(g_filled);
            uint32_t n = (g_filled < RMS_SAMPLES) ? g_filled : RMS_SAMPLES;
            g_rms = rms_of_last(g_mean, n);

            /* The noise floor, and the event level that follows from it.
             * The floor falls at once when the room gets quieter and rises
             * slowly, so a cry that lasts a minute cannot raise the floor
             * to the cry's own level and turn the trigger off half way
             * through the episode.  The first reading sets the floor. */
            if (g_floor < 0.0f) {
                g_floor = g_rms;
            } else if (g_rms < g_floor) {
                g_floor = g_rms;
            } else {
                g_floor += (g_rms - g_floor) * FLOOR_RISE;
            }
            g_level = TRIGGER_MULT * g_floor;
            if (g_level < TRIGGER_MIN) {
                g_level = TRIGGER_MIN;
            } else if (g_level > TRIGGER_MAX) {
                g_level = TRIGGER_MAX;
            }

            /* Two readings in a row at or above the level: the same rule
             * the hub uses, and the same one the study assumed.  One lone
             * reading is the microphone's slow drift, not an event. */
            if (g_rms >= g_level) {
                if (g_loud_streak < 255u) {
                    g_loud_streak++;
                }
            } else {
                g_loud_streak = 0;
            }

            /* Freeze first, announce second.  The telemetry has to carry
             * the sequence number and the CRC-32 of the window the hub is
             * about to ask for; if the freeze happened after the frame
             * was sent, the hub had nothing to check the window it
             * reassembled against. */
            /* The hold on the uploaded window ends here.  Until then
             * the node keeps that snapshot -- it is the one the hub is
             * missing fragments of -- and does not freeze a new one.
             *
             * The hold does not end while the hub is still fetching
             * that window.  It used to, and in a noisy room the three
             * seconds it lasts were up long before the hub's resend
             * rounds had finished, so the node froze a new window in
             * the middle of a transfer and the pieces the hub was still
             * missing went with the old one.
             *
             * The test was also backwards: `g_frozen_hold_ms` is a
             * deadline (millis() + FROZEN_HOLD_MS), so `now - deadline`
             * is negative -- and as an unsigned integer that is a
             * number well past 0x80000000 -- for every moment of the
             * hold, and small only once the deadline has passed.  The
             * test as written therefore released the window on the
             * very next reading and never released it afterwards, the
             * opposite of the intent.  Measured on the bench, the
             * minute of 2026-11-04 19:26: node 3 was refused four
             * resends with "no frozen window for it" because it had
             * already frozen the next one, and none of its bursts ever
             * finished.  A signed difference is the deadline test.
             *
             * When the hold does end, the window is dropped outright.
             * It has served its purpose: the hub has had its three
             * seconds of resend rounds and the fragments are no longer
             * needed.  Leaving it valid would leave it advertised,
             * and the freeze rule below refuses to take a new window
             * while one is advertised -- so the node would never
             * freeze again. */
            const bool hub_is_fetching =
                (uint32_t)(now - g_transfer_ms) < TRANSFER_HOLD_MS;
            if (g_frozen_served && !hub_is_fetching &&
                (int32_t)(now - g_frozen_hold_ms) >= 0) {
                g_frozen_served = false;
                g_frozen_valid = false;
                g_peak_pending = false;
            }
            /* Cry mode: once a loud window is frozen, do not freeze
             * another until the room goes quiet.  A cry that lasts
             * thirty seconds would otherwise freeze six windows and the
             * hub would process them one by one, 30 s behind.  (D-69.)
             * The exit threshold is absolute (0.01 rms): the adaptive
             * level can be as low as 0.005, and a quiet room at 0.01
             * would never fall below it.  (D-70.) */
            if (g_cry_mode && g_rms < 0.01f && g_loud_streak == 0u) {
                g_cry_mode = false;
            }
            /* Preempt the hold for a loud event.  A cry is typically an
             * order of magnitude louder than the room, so a new event
             * that is much louder than the window already frozen is
             * worth an immediate freeze, even if the previous window is
             * still being served: the hub abandons the stale burst and
             * asks for this one instead.  (D-68.)
             *
             * The comparison is against the level of the window that
             * was frozen, NOT against the trigger level.  It used to be
             * the trigger level, and that made the node freeze a new
             * window every half second while a cry was going on -- the
             * cry is far above the trigger level, so the hold was
             * cancelled every time -- and the hub, still waiting for
             * the window before it, threw that burst away and asked
             * for the newest one instead.  The hub chased windows it
             * could never finish assembling, one after another.  The
             * rule now asks the question that was meant: is this a new
             * event, or the same one going on?
             *
             * And it does not take a window the hub is still fetching.
             * The rule used to be able to cancel the hold at any moment,
             * which in a noisy room was every second or two -- and each
             * time it fired, the fragments the hub was still missing were
             * thrown away with the old window.  The hub could never
             * finish a burst at such a cot: it asked for the pieces that
             * were missing and the node had no copy of them left.  A
             * window the hub is still asking about is now left alone
             * until TRANSFER_HOLD_MS has passed with no word from it.
             *
             * And it now covers a window the hub has not asked about
             * yet as well.  A frozen window that is still advertised
             * -- `g_frozen_valid`, whether or not it has been served --
             * is the only copy of the cry that cot heard, and the room
             * itself must not be allowed to take its place: measured
             * on the bench, the minute of 2026-11-04 19:26, node 1
             * froze a window of 0.1769 rms -- a genuine cry -- and then
             * replaced it with a 0.0104 rms window of ordinary room
             * sound three seconds later, because the hub had spent its
             * airtime on another cot's window and had not come back
             * for it.  Only a much louder event (the same three-times
             * rule as before) or the hold above may take the place of
             * an advertised window now. */
            if (g_frozen_valid && g_frozen_rms > 0.0f && !hub_is_fetching &&
                g_rms >= 3.0f * g_frozen_rms && g_loud_streak >= 2u) {
                g_frozen_served = false;
                g_frozen_valid = false;
            }
            /* In cry mode, only a louder event (preempt) may freeze.
             * And only an unadvertised window may be frozen at all:
             * while the node holds a window the hub has not taken, the
             * room must wait.  Nothing here is lost by that -- the
             * live ring keeps filling, and a cry that arrives while a
             * quiet window is held takes its place through the rule
             * above, three times as loud as it is. */
            bool allow_freeze = !g_cry_mode ||
                (g_frozen_rms > 0.0f && g_rms >= 3.0f * g_frozen_rms);
            if (allow_freeze && !g_frozen_valid && g_filled == WINDOW_SAMPLES) {
                if (!g_peak_pending && g_loud_streak >= 2u) {
                    /* A loud moment: remember it, and freeze a second
                     * later, when the ring holds the second that follows
                     * it as well.  The two seconds the hub classifies are
                     * then centred on the cry instead of ending at it. */
                    g_peak_pending = true;
                    g_peak_ms = now;
                } else if (g_peak_pending) {
                    const uint32_t age = now - g_peak_ms;
                    /* The cry stopped: the streak broke.  The window is
                     * frozen then, so that it holds the cry that just
                     * ended instead of the room behind it.  The two
                     * seconds after the peak are the cap for a cry
                     * that goes on, not a delay every cry has to sit
                     * through.  (research/simulate_freeze.py: the
                     * stop-capped rule catches as many of the corpus's
                     * cry episodes as the old peak-centred rule, and
                     * the hub announced no room window under any of
                     * the three.) */
                    const bool cry_stopped = (g_loud_streak < 2u);
                    if (age >= PEAK_DELAY_MS ||
                        (cry_stopped && age >= PEAK_STOP_DELAY_MS)) {
                        if (age < PEAK_EXPIRE_MS) {
                            freeze_window();
                            /* A loud window puts the node into cry mode:
                             * do not freeze again until the room goes
                             * quiet, so a sustained cry does not queue
                             * six windows ahead of itself.  (D-69.)
                             * The threshold is absolute (0.05 rms), not
                             * relative to the floor: a quiet room has a
                             * floor near 0.001, and 5x that is 0.005,
                             * which quiet windows exceed.  (D-70.) */
                            if (g_frozen_rms >= 0.05f) {
                                g_cry_mode = true;
                            }
                            if (!g_dump_active && Serial) {
                                Serial.printf("froze window, burst seq %u  "
                                              "level %.4f  win rms %.4f%s\n",
                                              g_burst_seq, g_level,
                                              g_frozen_rms,
                                              g_cry_mode ? "  (cry mode)" : "");
                            }
                        }
                        g_peak_pending = false;
                    }
                }
            }

            /* A frozen window that nobody asked for must not block the
             * next one.  The microphone's DC drift can cross the event
             * level for a single reading, and the hub's trigger needs two
             * of them, so that window would sit here unused and the next
             * real cry would be served the stale, quiet one.
             *
             * The age is measured from a fresh clock reading, not from
             * the `now` above: that one was taken before the freeze
             * above happened, so `now - g_frozen_ms` would underflow to
             * four billion and expire the window that was frozen a
             * moment earlier — which is exactly what happened, and the
             * node never once advertised a burst as ready. */
            if (g_frozen_valid &&
                (millis() - g_frozen_ms) > FROZEN_EXPIRE_MS) {
                g_frozen_valid = false;
                g_frozen_served = false;
                g_peak_pending = false;
            }

            send_telemetry();

            if (!g_dump_active && Serial) {
                /* Serial here is USB-CDC: with no host reading the
                 * port, a write blocks — and this print runs every
                 * hundred milliseconds, so an unattended node starved
                 * its own loop and stopped pumping the microphone. */
                Serial.printf("rms %.4f  floor %.4f  level %.4f  %s\n",
                              g_rms, g_floor, g_level,
                              g_loud_streak >= 2u ? "EVENT" : "");
            }
        }
    }
    g_t_tick += (uint64_t)(esp_timer_get_time() - tk0);

    /* A request from the hub is served from the frozen snapshot when it
     * matches, and from the live window otherwise. */
    const int64_t rq0 = esp_timer_get_time();
    if (g_request_pending) {
        g_request_pending = false;
        g_requests++;
        bool from_frozen = (g_request_seq == g_burst_seq) && g_frozen_valid;
        if (!from_frozen && g_filled < WINDOW_SAMPLES) {
            /* The live window is still refilling after the last upload,
             * so its chronological order is not known.  Wait. */
            from_frozen = false;
            if (!g_dump_active && Serial) {
                Serial.println("request ignored: the live window is not complete");
            }
        } else {
            uint16_t first = g_request_first;
            uint16_t count = g_request_count;
            if (count == 0 || count > FRAG_COUNT) {
                count = FRAG_COUNT;
            }
            if (first >= FRAG_COUNT) {
                first = 0;
            }
            uint16_t sent = 0;
            const int64_t burst_t0 = esp_timer_get_time();
            if (from_frozen) {
                /* The hub is fetching this window.  While it does, the
                 * window is not taken away by a louder moment: the
                 * fragments that did not arrive are only in this copy. */
                g_transfer_ms = millis();
            }
            for (uint16_t i = 0; i < count; i++) {
                uint16_t index = (uint16_t)(first + i);
                if (index >= FRAG_COUNT) {
                    break;
                }
                send_fragment(index, from_frozen, false);
                sent++;
                /* The window is being fetched.  The clock is refreshed
                 * for every fragment, so a burst that takes ten seconds
                 * to cross a bad link keeps its window for the whole
                 * of it. */
                if (from_frozen) {
                    g_transfer_ms = millis();
                }
                /* No fixed gap between the fragments.  The radio takes
                 * them a few at a time and acknowledges them in groups,
                 * and the wait for room is where the microphone is read,
                 * so the burst crosses the air as fast as the radio can
                 * carry it.
                 *
                 * The gap was ten milliseconds for a long time, and it
                 * was the whole of the burst's length: 286 fragments at
                 * thirteen milliseconds each is the 3.8 s the hub
                 * measures.  Then it was four, which still left the
                 * burst at 3.4 s, because the cost was in waiting for
                 * each frame's own acknowledgement rather than in the
                 * gap.  The radio now carries a group of frames at a
                 * time and the burst is a fraction of its old length. */
            }
            if (!g_dump_active && Serial) {
                const uint64_t burst_ms =
                    (uint64_t)(esp_timer_get_time() - burst_t0) / 1000;
                Serial.printf("served %u fragments of %u in %llu ms\n",
                              (unsigned)sent, (unsigned)count,
                              (unsigned long long)burst_ms);
            }
            /* The live window is only thrown away if the microphone
             * actually lost samples while the burst was on the air.  It
             * used to be dropped every time, because nothing read the
             * microphone during the burst and the audio it held had
             * holes in it -- which left the node deaf for the two
             * seconds the window took to refill, and the next cry at
             * this cot could not be seen until then. */
            if (count > 1) {
                if (g_window_damaged) {
                    g_filled = 0;
                    g_window_damaged = false;
                }
                /* The frozen snapshot stays.  The hub may have lost a
                 * few fragments of this very window in the air, and it
                 * can only get them back from a node that still has
                 * them.  g_frozen_served says "this one has been
                 * uploaded", which is what lets the node freeze the
                 * next one straight away. */
                g_frozen_served = true;
                g_frozen_hold_ms = millis() + FROZEN_HOLD_MS;
                g_peak_pending = false;
            }
        }
    }
    g_t_req += (uint64_t)(esp_timer_get_time() - rq0);

    /* A resend request is served from the frozen window, and only if the
     * frozen window is still the one the hub asked about.  If the node
     * has already frozen a newer window the fragments the hub wants are
     * gone, and sending newer ones under the old sequence number would
     * corrupt the burst rather than complete it -- so the request is
     * refused and the hub asks for the newer window instead. */
    if (g_resend_pending) {
        g_resend_pending = false;
        if (!g_frozen_valid || g_resend_seq != g_burst_seq) {
            if (Serial) {
                Serial.println("resend refused: no frozen window for it");
            }
        } else {
            uint16_t resent = 0;
            /* The hub is still fetching this window. */
            g_transfer_ms = millis();
            for (uint16_t i = 0; i < FRAG_COUNT; i++) {
                if ((g_resend_bitmap[i >> 3] & (1u << (i & 7u))) == 0) {
                    continue;
                }
                send_fragment(i, true, false);
                resent++;
                g_transfer_ms = millis();
            }
            if (Serial) {
                Serial.printf("resent %u fragments of seq %u\n",
                              (unsigned)resent, (unsigned)g_burst_seq);
            }
        }
    }

    /* The console. */
    static char line[64];
    static uint8_t len = 0;
    while (Serial.available() > 0) {
        char c = (char)Serial.read();
        if (c == '\n' || c == '\r') {
            line[len] = 0;
            if (len > 0) {
                handle_command(line);
            }
            len = 0;
        } else if (len < sizeof(line) - 1) {
            line[len++] = c;
        }
    }
    const int64_t ldt = esp_timer_get_time() - lt0;
    g_t_rest += (uint64_t)ldt;
    if (ldt > (int64_t)g_loop_max_us) {
        g_loop_max_us = (uint32_t)ldt;
    }
}
