Amazo123/CryNet-TwoNode/firmware/hub_infer/src/link_stage.h

/*
 * CryNet — the radio stage of the hub.
 *
 * Stage 2c's first artifact: the hub listens to the nodes, decides when
 * there is something worth classifying, pulls the two-second window over
 * ESP-NOW and runs it through the Stage 2a inference core.
 *
 * The decision rule is the one frozen at the start of the rebuild: the
 * hub asks for audio once the node's RMS reaches 0.03, and the *model*
 * decides whether that audio is a cry.  The older firmware pulled audio
 * at RMS 0.18, so a soft cry never reached the classifier at all.
 */

#ifndef LINK_STAGE_H
#define LINK_STAGE_H

#include "crynet_dsp.h"
#include "crynet_infer.h"

#ifdef __cplusplus
extern "C" {
#endif

/* The level at which the hub asks a node for its window.  Anything above
 * this is worth classifying; the model rejects the false triggers.
 *
 * This is now only the fallback: the node tracks the room's noise floor
 * and reports the level it follows from it, and the hub triggers on the
 * node's number.  A fixed level of 0.030 put the system's reach at a
 * constant — a cry a metre from the node, with a median RMS of 0.0070,
 * never once reached it — so the floor is now tracked where the audio
 * actually is.  This constant is what a node that reports no level of
 * its own gets. */
#define CRYNET_TRIGGER_RMS 0.030f

/* The confidence at which one window is enough to announce a cry.
 *
 * The model's answer for a window that is very nearly silent is not
 * reliable: measured on the real boards, the same quiet room produced
 * verdicts of 0.0000 and of 0.9766 for windows that differ by nothing a
 * person could hear, and the second of those is a false alarm.  The
 * model's output saturates at 0.9961 for a clear cry, so a window that
 * reaches this level is announcing itself, and it is announced at once
 * — the panel still shows the cry two and a half seconds after it
 * happened, provided the window carries real energy (see
 * CRYNET_ANNOUNCE_MIN_RMS below).  Anything between the model's own
 * threshold and this one is a maybe, and a maybe is not announced: it
 * is counted (see CRYNET_CRY_RUN in link_stage.c) and nothing more.
 *
 * The threshold is the saturation and not the model's own 0.95, because
 * a conversation in the room reaches 0.9727 (measured 2026-11-04) and
 * the hub's own boot probe scores 0.9805 on synthetic noise.  Nothing
 * below the saturation is safe to announce on its own. */
#define CRYNET_CLEAR_CRY 0.9900f

/* The rms below which no window may announce a cry at all, however
 * confident the model says it is.
 *
 * The adaptive trigger sends the model windows the old fixed 0.030
 * trigger never would, and the model is not a reliable judge of a
 * window that is nearly silent.  Measured on the real boards: the
 * quietest genuine cry that reached the model carried 0.0103 rms (the
 * phone cry at one metre), while quiet-room windows at 0.002-0.012 have
 * scored up to 0.9883.  This gate sits under the quietest genuine cry
 * with room to spare, so the one-metre cry still announces and a
 * near-silent window cannot. */
#define CRYNET_ANNOUNCE_MIN_RMS 0.006f

/* How many windows in a row have to say cry before a maybe is
 * announced.  Two: a cry lasts for seconds and its windows agree, while
 * a noise fluctuation that happens to look like a cry is not repeated
 * in the next window.
 *
 * That assumption failed in a quiet room: the trigger pins at its
 * minimum there, the hub judges near-silent window after near-silent
 * window, their verdicts scatter across 0.95-0.99 for no audible
 * reason, and two of them in a row confirmed each other into fourteen
 * false alarms in one evening.  A maybe therefore only counts toward
 * the run when its window carries real energy (CRYNET_MAYBE_MIN_RMS). */
#define CRYNET_CRY_RUN 2u

/* The rms a window needs before its maybe can count toward the
 * confirming run.  Every measured genuine cry announced saturated
 * (>= 0.99, the unmistakable path) — the run exists for a real cry that
 * scores just over the threshold, and that comes with sound behind it.
 * The measured false maybes all sat at 0.012 rms or under. */
#define CRYNET_MAYBE_MIN_RMS 0.020f

/* The frozen window's own rms at which the hub pulls it even though the
 * room has gone quiet again.
 *
 * The live gates -- the node's streak and the reading above its own
 * level -- judge the room as it is *now*.  A frozen window is evidence
 * of the moment it was frozen, and the stop-capped freeze deliberately
 * lands after the cry has stopped, so by the time the hub looks the
 * live reading has usually fallen back to the room's own level and
 * neither live gate says anything.  The node reports the level of the
 * window it is offering beside the live one, and that number is what
 * the model will be shown, so it is the number the pull should follow.
 *
 * 0.050 sits above every window the nodes freeze out of ordinary room
 * sound (measured on the bench, 2026-11-04: the loudest such window
 * was 0.036 rms, on node 2) and well under every window a phone cry at
 * 15 cm froze (0.177 and 0.184 on the same bench).  Quieter frozen
 * windows are still pulled the moment the live reading is loud, so a
 * cry at one metre is not lost by this -- it is pulled while it is
 * happening, as it always was. */
#define CRYNET_PULL_CRY_RMS 0.050f

/* The rms at which a window carries so much sound that the model's
 * score may be taken at face value.
 *
 * It used to mean "a window this loud may announce on the model's own
 * threshold (0.95), without waiting for the saturation (0.99)".  That
 * rule was a band-aid for a clipped recording, and it opened the way
 * for a conversation in the room to be announced as a cry. */
#define CRYNET_LOUD_ANNOUNCE_RMS 0.080f

/* The confidence a loud window needs to announce on its own.
 *
 * It is the saturation, 0.9900, which is the same number the quiet
 * path uses -- so today a cry is announced when the model saturates
 * and not before.
 *
 * The trade is measured, both ways:
 *
 *   - the cost of the saturation: on the corpus, 7 of the 53 cry
 *     episodes that the old rule caught peaked between 0.9688 and
 *     0.9883 and are now missed.  All seven are strong cries -- rms
 *     0.09 to 0.22, crest 4.3 to 7.9 -- and on the bench three
 *     genuine cries out of three scored 0.9961 and still announce.
 *
 *   - the cost of the old rule: in twenty minutes of a room with
 *     people talking, the model scored four windows between 0.9688 and
 *     0.9805 that were not cries, and the hub's own boot probe scores
 *     0.9805 on synthetic noise.  None of the four was loud enough
 *     (0.080 rms) for the old rule to let it through, but that is the
 *     one thing about them that was not measured: how the model
 *     scores a *loud* conversation is unknown, and the old rule would
 *     have announced it.
 *
 * So this number is the saturation, and it is the only thing between
 * a loud conversation and a false alarm at three in the morning.  Set
 * it to 0.9500 to get the old rule back -- 7 more episodes on the
 * corpus, and the way open again. */
#define CRYNET_LOUD_ANNOUNCE_P 0.9900f

/* The confidence the second window of a run has to reach before the
 * run may announce a cry.
 *
 * It is the saturation as well, which means that in practice the run
 * announces nothing: a window that saturates announces on its own.
 * The run is kept because it says how close the model came, and
 * because setting this to 0.9500 together with CRYNET_LOUD_ANNOUNCE_P
 * brings back the whole old rule -- the loud window's own threshold
 * and the two-window confirmation. */
#define CRYNET_CONFIRM_P 0.9900f

/* The peak a window reaches before it counts as clipped.
 *
 * The microphone's own output saturates first -- the INMP441 is a
 * fixed-gain part -- so a sound close enough to it arrives flat-topped
 * and the window cannot be trusted.  A clipped window is refused: it
 * may not announce a cry, and the operator is told why. */
#define CRYNET_CLIP_PEAK 31000

/* The peak-to-rms ratio (crest factor) a quiet window needs before its
 * saturated verdict may announce a cry.  A loud window (>= 0.020 rms)
 * announces on saturation alone; a quiet one must also have a cry's
 * shape, because the model has been known to saturate on flat hiss.
 * Measured on the real boards: every quiet window that scored highly
 * and was not a cry had a crest of 2.2-2.9 (room hiss is Gaussian, no
 * impulses), and the quietest genuine cry — the phone cry at one metre,
 * P(cry)=0.9961 at 0.0103 rms — had a crest of 5.6; the 15 cm cries
 * measured 6.6-6.9.  A loud bump has a high crest too, but the model
 * refuses bumps on its own (measured 0.0977), so this gate only does
 * work exactly where the model is least trustworthy. */
#define CRYNET_QUIET_CREST 3.5f

/* Bring the radio up: NVS, then ESP-NOW.  Call it before the Bluetooth
 * stack starts — NimBLE's pools come out of the same internal RAM the
 * Wi-Fi driver allocates its buffers from, and when BLE claimed its
 * memory first the Wi-Fi driver ran out mid-init and the link never
 * started.  Returns false if the radio could not be started. */
bool link_stage_radio_start(void);

/* Run the radio stage.  Never returns.  The radio must already be up. */
void link_stage_run(crynet_dsp_ctx_t *dsp, crynet_infer_t *infer);

/* Whether the hub is announcing a cry for a node.  A confirmed cry is
 * held for a few seconds, so this stays true across the gaps in a
 * recording.  The display and the BLE server read this. */
bool link_stage_crying(uint8_t node_id);

/* One cot, as the console shows it. */
typedef struct {
    uint8_t  node_id;
    float    rms;          /* its last reading */
    float    level;         /* the level it triggers at */
    float    frozen_rms;    /* the level of the window it has frozen */
    uint8_t  confidence;    /* the last confirmed confidence, in percent */
    bool     crying;        /* the hub is announcing a cry from it */
    bool     window_full;   /* it has a whole two-second window to give */
    bool     deaf;          /* its windows never arrive: it cannot announce */
    int8_t   rssi;          /* the signal strength of its telemetry, in dBm;
                             * 0 = no reading */
} link_stage_cot_t;

/* The cots the hub cannot get a window from.  A deaf cot's audio never
 * reaches the model, so it can never announce a cry -- the caregiver
 * has to be told rather than left to take silence for a quiet cot.
 * Bit 0 is cot 1, bit 1 is cot 2, and so on. */
uint8_t link_stage_deaf_mask(void);

/* The cots the hub knows about.  Returns how many were written. */
int link_stage_cots(link_stage_cot_t *out, int max);

/* The console's test alert: publish a cry for that cot as if it had
 * heard one, and take it back.  This is how the caregiver's phone and
 * the wearable are checked without making a sound. */
void link_stage_test_alert(uint8_t cot_id);
void link_stage_test_clear(void);

#ifdef __cplusplus
}
#endif

#endif /* LINK_STAGE_H */
