Amazo123/CryNet-TwoNode/(commit log)

2026-11-05 feat(two-cot): a separate repo for the two-node hub, panel redesigned
    A new repository for the two-cot edition, cloned from the three-cot one
    at 99bb257 and left with its own branch and no remote. The original
    repository is untouched.
    The hub watches two cots and enforces it: NODE_LINK_MAX_NODES and
    HUB_DISPLAY_MAX_NODES are 2, and the link layer rejects any frame whose
    node id falls outside 1..2 before it can claim a slot, so a third board
    is never heard rather than merely hidden.
    The panel is redesigned around two full-width cards. The RMS moves off
    the row it shared with the battery -- three readings on one line, which
    is what made the card hard to read -- so the level bar and its numbe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
    [hub_display.c, hub_display.h, link_stage.c, node_crynet.ino]
2026-11-05 fix(link): the heartbeat's framing, and a host test that holds it
    Two faults in the heartbeat that the two-cot build added.
    The framing: crynet_proto_build() gave the twelve-byte payload-less
    layout only to a REQUEST, so a HEARTBEAT fell through to the full
    fourteen-byte header and came out sixteen bytes. The parser on the far
    end treats a heartbeat like a request and rejects any other length, so
    every heartbeat would have been malformed on the air -- the node's link
    bar and the connection LED would both have sat dark on a hub that was in
    fact answering. A heartbeat now shares the request's layout.
    The reading: ESP-NOW is broadcast, so a cot node also hears the other
    cot's telemetry and wi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
    [node_crynet.ino]
2026-11-05 feat(console): the hub reports each cot's link strength
    The panel draws a network bar per cot from the RSSI of that cot's
    telemetry, but the RSSI reached the display and nothing else, so the
    bar could not be confirmed from the console -- the one place a link
    reading can be checked against a bench measurement.
    The console's status command now prints it beside each cot's other
    numbers: "cot 2: rms 0.0230 level 0.0170 window 0.0220 (filling)
    confidence 0% link -43 dBm".
    Verified on the bench after flashing the two-cot firmware: the hub
    hears both cots with 993 frames parsed and none bad, a full burst
    crosses the link (286/286 fragments, CRC-32 MATCH) and is judged, the
    cots print their own vi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
2026-11-05 feat(display): title card with name and id; the wearable oled joins the panel's theme
    The hub's panel boots into a boot face and a title card before the
    dashboard: the project title, the builder's name, and the id number.
    The LISTENING bar shows the cot's trigger as a notch, and the rms is
    named rms. The wearable's OLED is rebuilt in the same language -- the
    waveform along the bottom edge, the breathing wordmark, the boot
    progress bar, the name and id on a title card with the full project
    title running through as a ticker, an inverted alert band that blinks
    while the wrist buzzes, and a crying mask re-polled every five seconds
    instead of read once at connect.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
    [hub_display.c, hub_display.h, link_stage.c, wearable_crynet.ino]
2026-11-05 fix(ble): the state characteristic now says how many cots the hub can hear
    It was published only when a cry started or stopped, so a cot joining
    the system never reached the caregiver: the wrist read "0 cots" and
    went on reading it while the hub could hear both cots perfectly well.
    The packet is rebuilt every cycle and published when the cry mask, the
    deaf mask or the count of heard cots has moved, and on a one-second
    beat so a value read by the wearable is never stale.
    [link_stage.c]
2026-11-05 feat(wearable): the device's own name on the wearable, no project title
    The project title was running as a marquee ticker on the title card and
    crowded out the name and the id number on a 128-pixel screen. The title
    stays on the hub's panel, which has the room.
    The boot face now carries the device name, AMAZING'S CRYNET, stacked on
    two lines, and the title card carries it over the full name and the id.
    Capitalisation follows the panel: ALL CLEAR, CLEARED and CRYING in caps,
    sentences starting with a capital.
    Flashed to COM30 and verified: the wearable attaches and reads
    state: 2 cot(s).
2026-11-06 fix(wearable): the name on the hub, a link that does not freeze, and a real motor
    The hub's panel now carries the device name: the boot face stacks
    AMAZING'S over CRYNET the way the wrist does, and the title card's
    headline reads AMAZING'S CRYNET. The waveform moved up and shrank to
    make the room.
    The wearable's BLE work moves onto its own FreeRTOS task. Every call
    it makes blocks its caller -- the two-argument scan start waits on a
    semaphore for the whole window, connect can hold for thirty seconds,
    and readValue() waits for a peer that may never answer -- so with the
    hub unplugged the screen froze for seconds at a time. Measured: the
    old firmware's UI loop ticked every 2044 ms, one red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
    [hub_display.c, wearable_crynet.ino]
2026-11-06 docs: bench recovery - both cot nodes back online, fault is transient state
    Node 2's zero-rms mic fault cleared on a hard reset; node 1's firmware
    was restored from its full-flash backup and verified. A 4 KB diff of
    both boards' full flash images shows only the NVS partition differs, so
    both run byte-identical app firmware. Hub sees node 1 at -25 dBm and
    node 2 at -44 dBm, and the resend path recovered a stalled burst.
2026-11-06 docs(wiring): the corrected two-node diagrams, with the hub backlight on GPIO4
    The wiring diagrams now describe the system that is actually on the bench:
    two cot nodes, not three. The generator was brought over from fp-2 as
    tools/wiring/ and the five pages were corrected against the running
    firmware, then rebuilt into SYSTEM_WIRING_DIAGRAMS.html and .pdf.
    - x3 -> x2: the overview box, the node page title and its footer.
    - The hub TFT backlight leaves 3V3 and is switched by a 2N7002: 3V3 to the
    drain, the source to the TFT LED pin, the gate through 100 ohm to GPIO4
    with a 100 k pull-down. GPIO4 already drives the backlight with LEDC PWM
    in hub_display.c, so it now has a load and a slee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
    [build.py, page_hub.py, page_node.py, page_overview.py, page_wearable.py]
2026-11-06 docs(wiring): the hub backlight goes back on 3V3, the sleep mode is dropped
    The owner decided the panel LED stays tied to 3V3 and always on, so the
    GPIO4 / 2N7002 dimmer circuit added earlier today came off page 3 before
    anything was soldered. GPIO4 is freed again and page 1's hub box now
    reads 'backlight on 3V3 - always on'. HTML and PDF rebuilt, zero layout
    problems. Nothing was flashed; the bench already matches the drawing.
    The change log also records today's earlier bench work: the soldering
    clearance read out of the running firmware, the first played-cry
    end-to-end pass on both cots, and the held multi-cot wearable and node
    I2S watchdog candidates (source in the working tree, still un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
    [page_hub.py, page_overview.py]
2026-11-06 fix(capture): a port already held no longer kills the whole capture
    capture_multi.py raised AttributeError: 'NoneType' when a port could not
    be opened because an earlier capture still held it, and its log writer
    assumed the file already existed. It now names the port that would not
    open and carries on with the rest, and opens the log on first use.
    Proven on the bench during the played-cry test: four boards captured at
    once on COM31/COM32/COM37/COM30, and a port that was busy was skipped
    instead of aborting the run.
    [capture_multi.py]
2026-11-06 fix(node): a mic that goes silent for five seconds restarts I2S
    Node 2 was found once reading rms 0.0000 on every mic read - the INMP441
    delivering nothing - and the fault cleared on a hard reset with no
    reflash, so its cause was never established. That left the cot silently
    deaf whenever it happened with nobody watching.
    The capture task now watches for five seconds of consecutive exact-zero
    16-bit samples (a quiet room still has noise, so exact zeros are not
    silence), counts them through the rest of each read, and on the
    threshold invalidates the live window, restarts I2S from the task that
    owns it, and counts the restart. A failed driver teardown or warmup
    reboots rather than reusing bro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
    [node_crynet.ino]
2026-11-06 docs: the candidates are committed, the untested one has its own branch
    Records where the multi-cot wearable change now lives (branch
    feature/wearable-multi-cot) until two cots can cry at the same time, and
    that nothing was flashed because no board was on USB.
2026-11-06 docs: the two-cot repo's own identity, and its decisions as D-75..D-80
    The documents here were a stale copy of the three-cot repo's: they said
    'Repo: fp-2', described three cot nodes and a DRV2605L haptic, and still
    carried the sibling repo's open items - including O-1, 'the wearable does
    not exist yet', which is true there and false here.
    All three files now name this repository, its branch, its remote and its
    sibling. DECISIONS.md gets a new section 1.9 recording the six decisions
    where this build deliberately differs: its own repository, no wearable
    status LEDs, the BC547 haptic instead of the DRV2605L, the always-on 3V3
    backlight with no sleep mode, the node's I2S watchdog held until th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
2026-11-07 docs(battery): a fixed divider, not a variable resistor, and the cell chosen per unit
    The owner asked how to measure battery SOC, having been advised to put a
    variable resistor between the cell and the ADC pin, read 4.2 V as 100 %
    and 3.0 V as 0 %. That advice fails three ways, so it is rejected and
    replaced (D-81):
    - as described it puts 4.2 V on a 3.3 V pin; the C3's IO is 3.3 V only,
    so a divider is mandatory whatever element makes it
    - the firmware cannot read a wiper position, so it would not know the
    division ratio; the reading would drift with heat, vibration and wear
    - the 3.0-4.2 V linear map is chemically wrong. A lithium cell runs
    about 4.20 V = 100 %, 3.85 = 55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
    [page_hub.py, page_node.py, page_overview.py, page_wearable.py]
2026-11-07 docs(battery): correct the D-81 rationale, and record the divider's source impedance
    The owner clarified how the variable resistor would actually be used: set
    once, so the output lands inside the analog pin's range, and the reading
    then follows the battery down. That made one recorded reason wrong.
    D-81 said "a pot's wiper position cannot be read by the firmware, so the
    chip would not know the division ratio". As a blanket claim that was
    overstated: a three-terminal pot used as a genuine divider does work, and
    the firmware does not have to read the wiper, because the ratio can be
    measured once at assembly and handed over as a constant. The decision is
    unchanged; the reasons are now the c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
    [page_hub.py, page_wearable.py]
2026-11-07 feat(battery): take the battery SOC and the status LEDs out of the system (D-83)
    The owner asked for the battery readout and every status LED to go: the
    hub's panel already shows which cots are answering, so a second copy
    of that answer on the cot itself was redundant, and the battery figure
    was always an estimate - a resting-voltage curve printed with a tilde.
    The firmware:
    - the node no longer reads its cell. PIN_BATTERY, the sixteen-sample
    average, the 800-1500 mV trust gate and the x3.2 scaling are gone,
    and the telemetry carries no cell voltage.
    - the hub no longer bands a cell voltage, and the cot cards no longer
    print BAT ~80 %, BAT LOW or BAT CRIT. BAT_CURVE, battery_percent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
    [hub_display.c, hub_display.h, link_stage.c, node_crynet.ino, page_hub.py]
2026-11-07 docs(battery): fix the two cross-references the D-83 rewrite left dangling
    Section 7 no longer describes a charge prompt, and D-76 points at what
    that section used to be called, so both references now say so.
2026-11-07 docs: say plainly that the printed wiring PDF is a stale snapshot
    SYSTEM_WIRING.pdf was exported on 2 November and was already behind the
    markdown before the D-83 work. There is no markdown-to-PDF toolchain on
    this machine, so it is flagged rather than regenerated with something
    crude; the .md and the diagrams PDF are the live documents.
2026-11-07 docs: record the stale wiring PDF and the two fixed cross-references
2026-11-07 docs: record the D-83 flash onto all four units, and the silent microphones
    The hub, both cot nodes and the wearable now run the D-83 firmware and
    were verified live: the hub's boot self-check passed, the panel is up,
    both cots are online on the new telemetry format with no battery field,
    and the wearable is connected over BLE.
    Both nodes read exact digital zero, so the audio path is still owed.
    That flash also put the I2S zero-watchdog (D-79) onto the nodes for the
    first time, which is what O-1c was waiting on.
2026-11-07 docs: the exact-zero readings were correct - no microphone was attached
    The owner confirmed only the boards were connected. A board with no
    INMP441 on it can only read digital zero, so the readings were right.
    What it does teach is that the zero-watchdog cannot tell an unattached
    microphone from a dead one, and it will restart the I2S forever on a
    board with no mic. With a mic fitted it should stay quiet, because a
    live mic in a quiet room delivers noise rather than zeros - and if it
    does not, that is the thing to look at next.
2026-11-07 docs(flash): write FLASHING.md, the step-by-step flashing guide
    The procedure the 2026-11-07 bench flash actually used: back up each
    board's flash first, identify boards by MAC (who_is_who.py) instead of
    trusting COM numbers, flash the hub before any node (old hub cannot read
    the 32-byte telemetry), the good-boot-log lines to look for, the I-40
    bootloader recovery, and whole-flash rollback from the %TEMP% backups.
    A superseded same-day draft (FLASHING_GUIDE.md) is gone, so one guide.
2026-11-07 feat(flash): ship the built images, so a unit can be flashed offline with esptool alone
    The owner asked what the flashing guide was actually for: "in case I get new
    controllers, I want to be able to upload the firmware of the units - the hub,
    the nodes and the wearable - myself, offline, without having to come here and
    ask you." The guide as it stood described a procedure that runs on this
    machine with this machine's compilers, and a fresh clone could not flash a
    hub at all: components/esp-tflite-micro and components/esp-nn are
    deliberately untracked (fetch_deps.sh pins them by commit and clones them
    from GitHub), and .pio/ is gitignored, so a clone has neither the
    dependencies nor any built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
2026-11-07 docs(flash): the bench card, and the log examples checked against the source
    FLASHING.md gains section 13, a one-page card of the whole procedure in the
    order it is actually done: what is plugged in, is the toolchain good, back
    up, flash hub-nodes-wearable, check the log, a new node needs its id set,
    nothing comes up means the bootloader, roll back.
    Every log line quoted in the guide was read out of the source rather than
    remembered: "node %u: rms %.4f seq %u flags 0x%02X crc 0x%08X level
    %.4f streak %u win %.4f", "node %u is %s", "RESULT: PASS - %d probes",
    "the panel is up: %d x %d, rotation %d (madctl 0x%02X)", "the display is
    up: %d x %d", the node banner in both its forms (derive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
2026-11-07 docs(flash): a walkthrough for someone who has never flashed, and the tools to match it
    The owner said what was missing: *"you always been the one flashing, I never
    flashed with platformIO IDE or arduino IDE, and I don't even know how to use
    platformIO IDE, I don't know where the files to flash are - that is what I
    want: a step-by-step guide on from start to finish."*
    FLASHING.md was a reference for someone who already knew the toolchain. It
    opened with the PlatformIO package path, assumed what a .bin was, and never
    said where on the disk anything lived.
    GETTING_STARTED_FLASHING.md is the walkthrough, in three ways to do the job,
    easiest first:
    Way A double-click firmware/prebuilt/flas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
    [serial_monitor.py]
2026-11-07 fix(flash): correct the log lines the guide quotes, and match the MAC by its shape
    Three claims in GETTING_STARTED_FLASHING.md were checked against the source
    and were wrong:
    - "node 1 online" is really "node 1 is online" (link_stage.c:1608 logs
    "node %u is %s" with online/offline).
    - the "this hub watches cots 1 and 2 only" warning is printed by the
    NODE, not by the hub (node_crynet.ino:1359), and its text is
    "WARNING: this hub watches cots 1 and 2 only. Set this board with
    "id 1" or "id 2".".
    - the IDENTITY path matched a literal "MAC:" label, which assumes what
    esptool calls its output line. It now matches the MAC address
    itself - six hex pairs - so it works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
2026-11-07 feat(flash): make the offline images prove they are up to date
    The owner asked two things. The first: "must I run copy_sketches.bat
    when I want to upload to the node?" No -- that step belongs to Way C
    (building in the Arduino IDE) and only matters when the node's code has
    changed. Flashing a node with the finished firmware is Way A, which
    never involves the IDE or the sketchbook. The guide had the copy as
    step 1 of C4 with no "only if you changed the code" on it, so it read
    as a step in uploading; it now says so at the top of the guide, in a
    table, and again in C3 and C4.
    The second: "make sure the files that are to be used to upload offline
    are always updated". Nothing was forcing fir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
